seokipo/H2_Control_Board/01_Hardware/Docs/PCB부품/DMC 100D.png

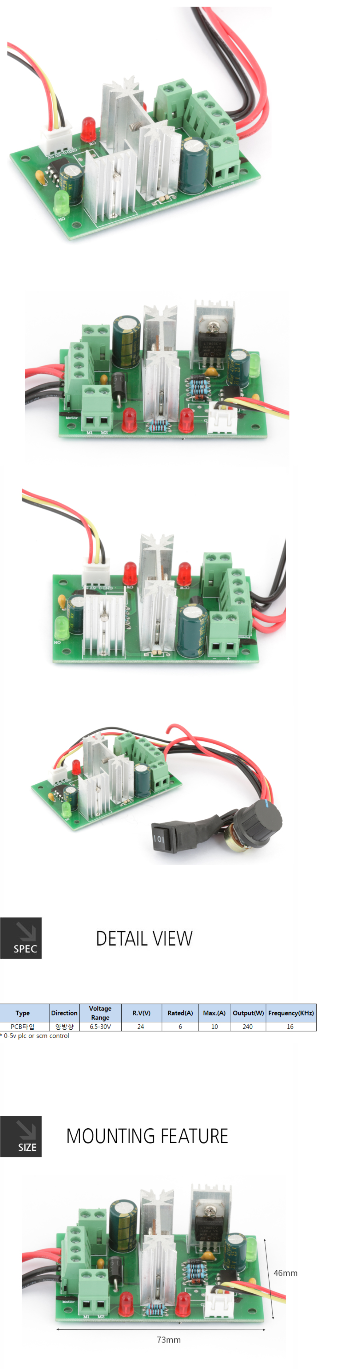
01_Hardware/Docs/PCB부품/DMC 100D.png
