seokipo/H2_Control_Board/01_Hardware/Docs/PCB부품/HDW012H.png

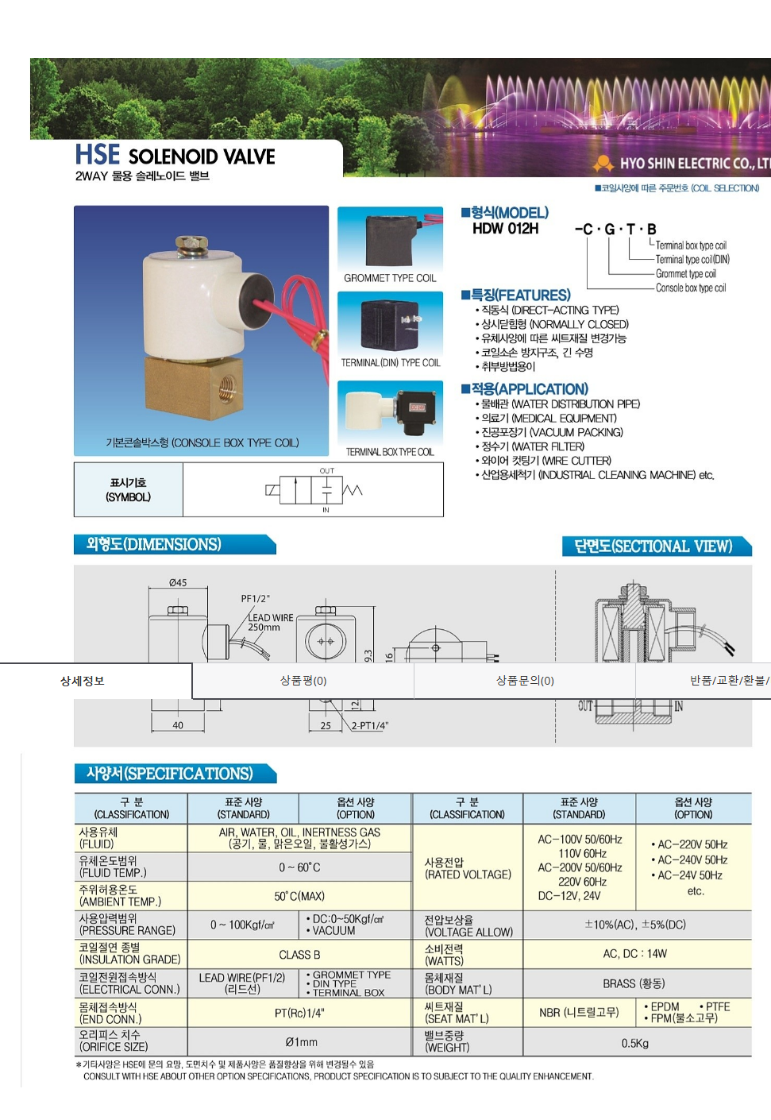
01_Hardware/Docs/PCB부품/HDW012H.png
