seokipo/H2_Control_Board/graphify-out/converted/260727_10kW IO 넘버링 Ver 1.1 이규원_ 모델명 포함(수정)_9afe6031.md

<!-- converted from 260727_10kW IO 넘버링 Ver 1.1 이규원_ 모델명 포함(수정).xlsx -->

## Sheet: 10k SYS IO_List_2026
| Num | IO type | IO Category | IO Name | IO Number | Proto device
IO Masking | 비고 | Described | Naming | 모델명 | 실제값 | 실제 
단위 | 제어값 | 제어
단위 |
| --- | --- | --- | --- | --- | --- | --- | --- | --- | --- | --- | --- | --- | --- |
| 1 | Serial | RS | INV | 506 | INV506 | 485 | 인버터 데이터 통신 |  |  |  |  |  |  |
| 2 | Serial | RS | LCD | 500 | LCD500 | 485 | HMI용 LCD 통신 |  |  |  |  |  |  |
| 3 | Serial | RS | FM | 382 | FM382 | 485 | DI 개질수 유량 데이터 통신 |  | 유량계 : OF05ZAT-AR / 펄스미터 : MP5Y |  |  |  |  |
| 4 | Serial | RS |  |  |  | 422 | HMI 및 GUI용 노트북 통신 |  |  |  |  |  |  |
| 1 | TC-K type | TC | TC | 181 | TC181 | K | Ref-BN |  | 열전대 K-Type |  |  |  |  |
| 2 | TC-K type | TC | TC | 182 | TC182 | K | Ref-SR1 |  |  |  |  |  |  |
| 3 | TC-K type | TC | TC | 183 | TC183 | K | Ref-SR2 |  |  |  |  |  |  |
| 4 | TC-K type | TC | TC | 184 | TC184 | K | Ref-SR3 |  |  |  |  |  |  |
| 5 | TC-K type | TC | TC | 185 | TC185 | K | Ref-LTS1 |  |  |  |  |  |  |
| 6 | TC-K type | TC | TC | 186 | TC186 | K | Ref-LTS2 |  |  |  |  |  |  |
| 7 | TC-K type | TC | TC | 187 | TC187 | K | Ref-FEED |  |  |  |  |  |  |
| 8 | TC-K type | TC | TC | 188 | TC188 | K | Ref-RG |  |  |  |  |  |  |
| 9 | TC-K type | TC | TC | 189 | TC189 | K | Ref-EG |  |  |  |  |  |  |
| 10 | TC-K type | TC | TC | 190 | TC190 | K | Prox-01 |  |  |  |  |  |  |
| 11 | TC-K type | TC | TC | 191 | TC191 | K | Prox-02 |  |  |  |  |  |  |
| 12 | TC-K type | TC | TC | 192 | TC192 | K | Prox-03 |  |  |  |  |  |  |
| 13 | TC-K type |  |  |  |  |  | 여유분 3 POINT |  |  |  |  |  |  |
| 14 | TC-K type |  |  |  |  |  |  |  |  |  |  |  |  |
| 15 | TC-K type |  |  |  |  |  |  |  |  |  |  |  |  |
| 1 | TC-T type | TC | TC | 104 | TC104 | T | 시티가스 공급온도 확인 |  | 열전대 T-Type |  |  |  |  |
| 2 | TC-T type | TC | TC | 115 | TC115 | T | 개질기 버너 역화 온도 측정 |  |  |  |  |  |  |
| 3 | TC-T type | TC | TC | 133 | TC133 | T | 개질 가스 1차 온도 측정 |  |  |  |  |  |  |
| 4 | TC-T type | TC | TC | 147 | TC147 | T | 개질 가스 2차 온도 측정(ANODE 인입 가스) |  |  |  |  |  |  |
| 5 | TC-T type | TC | TC | 157 | TC157 | T | AOG 버너 입구 온도측정 |  |  |  |  |  |  |
| 6 | TC-T type | TC | TC | 162 | TC162 | T | 배기가스 온도 측정 |  |  |  |  |  |  |
| 7 | TC-T type | TC | TC | 214 | TC214 | T | Cathode 입구 온도 |  |  |  |  |  |  |
| 8 | TC-T type | TC | TC | 215 | TC215 | T | Cathode 출구 온도 |  |  |  |  |  |  |
| 9 | TC-T type | TC | TC | 312 | TC312 | T | HOT Water Tank 온도 측정 |  |  |  |  |  |  |
| 10 | TC-T type | TC | TC | 316 | TC316 | T | 시스템 냉각수 회수 온도 |  |  |  |  |  |  |
| 11 | TC-T type | TC | TC | 322 | TC322 | T | DI Water TANK 온도 센서 |  |  |  |  |  |  |
| 12 | TC-T type | TC | TC | 343 | TC343 | T | DI WATER TANK 냉각수 입구 온도 측정 |  |  |  |  |  |  |
| 13 | TC-T type | TC | TC | 344 | TC344 | T | DI WATER TANK 냉각수 회수 온도 측정 |  |  |  |  |  |  |
| 14 | TC-T type | TC | TC | 353 | TC353 | T | ANODE(RG) 냉각수 회수 온도 측정 |  |  |  |  |  |  |
| 15 | TC-T type | TC | TC | 372 | TC372 | T | STACK 1 냉각수 회수 온도 |  |  |  |  |  |  |
| 16 | TC-T type | TC | TC | 377 | TC377 | T | STACK 2 냉각수 회수 온도 |  |  |  |  |  |  |
| 17 | TC-T type | TC | TC | 392 | TC392 | T | 배열 회수 입구 온도 |  |  |  |  |  |  |
| 18 | TC-T type | TC | TC | 393 | TC393 | T | 배열 회수  출구 온도 |  |  |  |  |  |  |
| 19 | TC-T type | TC | TC | 507 | TC507 | T | 시스템 내부온도 |  |  |  |  |  |  |
| 20 | TC-T type |  |  |  |  |  | 여유분 6 POINT |  |  |  |  |  |  |
| 21 | TC-T type |  |  |  |  |  |  |  |  |  |  |  |  |
| 22 | TC-T type |  |  |  |  |  |  |  |  |  |  |  |  |
| 23 | TC-T type |  |  |  |  |  |  |  |  |  |  |  |  |
| 24 | TC-T type |  |  |  |  |  |  |  |  |  |  |  |  |
| 25 | TC-T type |  |  |  |  |  |  |  |  |  |  |  |  |
| 1 | Voltage | AI | PT | 105 | PT105 |  | 유틸리티 압력 확인용 |  | T2800 | 0~10 | kPa | 4~20->1~5  | V |
| 2 | Voltage | AI | PT | 109 | PT109 |  | 가스 버퍼탱크 압력 확인용 |  | PSS-01V-R1/8 | 0~100 | kPa | 1~5  | V |
| 3 | Voltage | AI | PT | 113 | PT113 |  | 개질기 버너 압력 확인용 |  | PSS-01V-R1/8 | 0~100 | kPa | 1~5  | V |
| 4 | Voltage | AI | PT | 123 | PT123 |  | 개질기 촉매부 압력 확인 |  | PSS-01V-R1/8 | 0~100 | kPa | 1~5  | V |
| 5 | Voltage | AI | PT | 146 | PT146 |  | STACK Anode 입구 압력 측정 |  | T2800 | 0~100 | kPa | 4~20->1~5  | V |
| 6 | Voltage | AI | PT | 162 | PT162 |  | 배기가스 압력 측정 |  | PSS-01V-R1/8 | 0~100 | kPa | 1~5  | V |
| 7 | Voltage | AI | PT | 383 | PT383 |  | 개질수 공급 압력 측정 |  | PSAN-L1CPV | 0~1000 kPa | kPa | 1~5  | V |
| 8 | Voltage | AI | CS | 324 | CS324 |  | DI TANK 전도도 측정 |  | CM-230K | 0.5~200 | us/s | 4~20->1~5  | V |
| 9 | Voltage | AI/AO | MFC | 111 | MFC111 |  | BNG 유량 측정/제어 |  | TSCD230-8SW-CH4 30L | 0~30 | LPM |  |  |
| 10 | Voltage | AI/AO | MFC | 121 | MFC121 |  | PNG 유량 측정/제어 |  | TSCD230-8SW-CH4 50L | 0~50 | LPM |  |  |
| 11 | Voltage | AI | MFM | 211 | MFM211 |  | STACK 공기 유량계 |  | PFMB7202-06-C | 0~800 | LPM | 1~5  | V |
| 12 | Voltage | AI | MFM | 222 | MFM222 |  | 개질기 버너 공기 유량계 |  | PFMB7202-06-C | 0~400 | LPM | 1~5  | V |
| 13 | Voltage | AI | MFM | 231 | MFM231 |  | PrOx 공기 유량계 |  | PFM710-01-C | 0~10 | LPM | 1~5  | V |
| 14 | Voltage | AI | FM | 315 | FM315 |  | 시스템 냉각수 회수 유량 측정 |  | VVX 15 | 0-40 | LPM | 4~20->1~5 | V |
| 15 |  |  |  |  |  |  | 여유분 2 Point |  |  |  |  |  |  |
| 16 |  |  |  |  |  |  |  |  |  |  |  |  |  |
| 1 | Voltage | AO | AB | 212 | AB212 | feedback => MFM211 | STACK  에어블로어 |  | BLP-8080 |  |  | 0~5  | V |
| 2 | Voltage | AO | AB | 221 | AB221 | feedback => MFM222 | 개질기 버너 에어블로어 |  | LW 300 A3(AC 리니어 펌프) |  |  | 0~5  | V |
| 3 | Voltage | AO | AB | 232 | AB232 | feedback => MFM231 | PrOx 에어블로우 |  | NMP850.1.2KPDCB-4 HP |  |  | 0~5  | V |
| 4 | Voltage | AO | P | 108 | P108 | feedback => PT109 | 가스 가압펌프 |  | PM33098-838.1.2 (2대 병렬 운전) |  |  | 0~5  | V |
| 5 | Voltage | AO | P | 341 | P341 | feedback => TC343 또는 TC344(미정) | AOG 냉각용 물펌프 |  | INTG3-140 |  |  | 0~5  | V |
| 6 | Voltage | AO | P | 351 | P351 | feedback => TC 147 | Anode (RG) 냉각용 물펌프 |  | INTG3-140 |  |  | 0~5  | V |
| 7 | Voltage | AO | P | 370 | P370 | feedback => TC372 | STACK 1 냉각수 공급 |  | INTG3-140 |  |  | 0~5  | V |
| 8 | Voltage | AO | P | 375 | P375 | feedback => TC377 | STACK 2 냉각수 공급 |  | INTG3-140 |  |  | 0~5  | V |
| 9 | Voltage | AO | P | 380 | P380 | feedback => FM382 | 개질수 펌프 |  | KNF (PML20017-FP1.25) |  |  | 0~5 | V |
| 12 |  |  |  |  |  |  | 여유분 2 Point |  |  |  |  |  |  |
| 13 |  |  |  |  |  |  |  |  |  |  |  |  |  |
| 1 | Voltage | DI | FD | 176 | FD176 |  | 버너 화염감지기 |  | FDU-520 |  |  | 0 or 24 | V |
| 2 | Voltage | DI | GD | 501 | GD501 |  | 메탄 누출 감지 |  |  |  |  | 0 or 24 | V |
| 3 | Voltage | DI | GD | 502 | GD502 |  | 수소 누출 감지 |  |  |  |  | 0 or 24 | V |
| 4 | Voltage | DI | FAN | 504 | FAN504 |  | 가스 환기팬1 |  | D12BH-24 |  |  | 0 or 24 | V |
| 5 | Voltage | DI | TJ- | sig | TJ-sig | 테스트용(?) | 내구성 평가용 지그 신호 (별도 구성) |  |  |  |  | 0 or 24 | V |
| 6 |  |  |  |  |  |  | 여유분 2 Point |  |  |  |  |  |  |
| 7 |  |  |  |  |  |  |  |  |  |  |  |  |  |
| 1 | Voltage | DO | SV | 102 | SV102 |  | 가스 인입 솔레노이드 밸브 1 |  | VX230GA |  |  | 0 or 24 | V |
| 2 | Voltage | DO | SV | 103 | SV103 |  | 가스 인입 솔레노이드 밸브 2 |  | VX230GA |  |  | 0 or 24 | V |
| 3 | Voltage | DO | SV | 125 | SV125 |  | 개질기 질소퍼지 솔레노이드 밸브 |  | VX230GA |  |  | 0 or 24 | V |
| 4 | Voltage | DO | SV | 145 | SV145 |  | ANODE 인입 솔레노이드 밸브 |  | VX230GA |  |  | 0 or 24 | V |
| 5 | Voltage | DO | SV | 149 | SV149 |  | 스택 질소퍼지 솔레노이드 밸브 |  | VX230GA |  |  | 0 or 24 | V |
| 6 | Voltage | DO | SV | 323 | SV323 |  | DI Water TANK 드레인 솔레노이드 밸브 |  | WV121S122QV-H-WS-C2 |  |  | 0 or 24 | V |
| 7 | Voltage | DO | MV | 124 | MV124 |  | PNG 인입 밸브 |  | AT24-3T |  |  | 0 or 24 | V |
| 8 | Voltage | DO | MV | 131 | MV131 |  | 개질 가스 인입 밸브 |  | AT24-3T |  |  | 0 or 24 | V |
| 9 | Voltage | DO | MV | 148 | MV148 |  | 개질가스 Bypass 전동 밸브 |  | AT24-3T |  |  | 0 or 24 | V |
| 10 | Voltage | DO | MV | 150 | MV150 |  | Anode 출구 전동 밸브 |  | AT24-3T |  |  | 0 or 24 | V |
| 11 | Voltage | DO | MV | 155 | MV155 |  | AOG 전동 밸브 |  | AT24-3T |  |  | 0 or 24 | V |
| 12 | Voltage | DO | MV | 158 | MV158 |  | AOG VENT 전동 밸브 |  | AT24-3T |  |  | 0 or 24 | V |
| 13 | Voltage | DO | MV | 300 | MV300 |  | 시설수 입구 전동 볼밸브 |  | AT24-3T |  |  | 0 or 24 | V |
| 15 | Voltage | DO | MV | 390 | MV390 |  | 배열 회수 입구 전동 볼 밸브 |  | AT24-3T |  |  | 0 or 24 | V |
| 16 |  |  |  |  |  |  | 여유분 2 Point |  |  |  |  |  |  |
| 17 |  |  |  |  |  |  |  |  |  |  |  |  |  |
| 1 | Voltage | DO | MC |  SW | MC SW |  | MC 동작 스위치 |  |  |  |  | 0 or 220 | VAC |
| 2 | Voltage | DO | HT | 193 | HT193 | 700W | LTS 촉매 히터 |  |  |  |  | 0 or 220 | VAC |
| 3 | Voltage | DO | HT | 194 | HT194 | 700W | LTS 촉매 히터 |  |  |  |  | 0 or 220 | VAC |
| 4 | Voltage | DO | HT | 195 | HT195 | 200W | Prox 히터1 |  |  |  |  | 0 or 220 | VAC |
| 5 | Voltage | DO | HT | 196 | HT196 | 200W | Prox 히터2 |  |  |  |  | 0 or 220 | VAC |
| 6 | Voltage | DO | IGN | 175 | IGN175 |  | 점화 트랜스 |  | TZI5-15/100WE |  |  | 0 or 220 | VAC |
| 7 | Voltage | DO |  |  |  |  | Spare, Spare TRIAC(위상제어용) |  |  |  |  | 0 or 220 | VAC |
| 8 | Voltage | DO |  |  |  |  |  |  |  |  |  | 0 or 220 | VAC |
## Sheet: 10k SYS IO_NetName
| Num | IO type | IO Category | IO Name | IO Number | Proto device
IO Masking | 비고 | Described | IO NAME | NETNAME | MCU PIN No. | 모델명 | 실제값 | 실제 
단위 | 제어값 | 제어
단위 |
| --- | --- | --- | --- | --- | --- | --- | --- | --- | --- | --- | --- | --- | --- | --- | --- |
| 1 | Serial | RS | INV | 506 | INV506 | 485 | 인버터 데이터 통신 |  |  | 485 |  |  |  |  |  |
| 2 | Serial | RS | LCD | 500 | LCD500 | 485 | HMI용 LCD 통신 |  |  | 485 |  |  |  |  |  |
| 3 | Serial | RS | FM | 382 | FM382 | 485 | DI 개질수 유량 데이터 통신 |  |  | 485 | 유량계 : OF05ZAT-AR / 펄스미터 : MP5Y |  |  |  |  |
| 4 | Serial | RS |  |  |  | 422 | HMI 및 GUI용 노트북 통신 |  |  | 422 |  |  |  |  |  |
| 1 | TC-K type | TC | TC | 181 | TC181 | K | Ref-BN |  | CH21 |  | 열전대 K-Type |  |  |  |  |
| 2 | TC-K type | TC | TC | 182 | TC182 | K | Ref-SR1 |  | CH22 |  |  |  |  |  |  |
| 3 | TC-K type | TC | TC | 183 | TC183 | K | Ref-SR2 |  | CH23 |  |  |  |  |  |  |
| 4 | TC-K type | TC | TC | 184 | TC184 | K | Ref-SR3 |  | CH24 |  |  |  |  |  |  |
| 5 | TC-K type | TC | TC | 185 | TC185 | K | Ref-LTS1 |  | CH25 |  |  |  |  |  |  |
| 6 | TC-K type | TC | TC | 186 | TC186 | K | Ref-LTS2 |  | CH26 |  |  |  |  |  |  |
| 7 | TC-K type | TC | TC | 187 | TC187 | K | Ref-FEED |  | CH27 |  |  |  |  |  |  |
| 8 | TC-K type | TC | TC | 188 | TC188 | K | Ref-RG |  | CH28 |  |  |  |  |  |  |
| 9 | TC-K type | TC | TC | 189 | TC189 | K | Ref-EG |  | CH29 |  |  |  |  |  |  |
| 10 | TC-K type | TC | TC | 190 | TC190 | K | Prox-01 |  | CH30 |  |  |  |  |  |  |
| 11 | TC-K type | TC | TC | 191 | TC191 | K | Prox-02 |  | CH31 |  |  |  |  |  |  |
| 12 | TC-K type | TC | TC | 192 | TC192 | K | Prox-03 |  | CH32 |  |  |  |  |  |  |
| 13 | TC-K type |  |  |  |  |  | 여유분 3 POINT |  |  |  |  |  |  |  |  |
| 14 | TC-K type |  |  |  |  |  |  |  |  |  |  |  |  |  |  |
| 15 | TC-K type |  |  |  |  |  |  |  |  |  |  |  |  |  |  |
| 1 | TC-T type | TC | TC | 104 | TC104 | T | 시티가스 공급온도 확인 |  | CH1 |  | 열전대 T-Type |  |  |  |  |
| 2 | TC-T type | TC | TC | 115 | TC115 | T | 개질기 버너 역화 온도 측정 |  | CH2 |  |  |  |  |  |  |
| 3 | TC-T type | TC | TC | 133 | TC133 | T | 개질 가스 1차 온도 측정 |  | CH3 |  |  |  |  |  |  |
| 4 | TC-T type | TC | TC | 147 | TC147 | T | 개질 가스 2차 온도 측정(ANODE 인입 가스) |  | CH4 |  |  |  |  |  |  |
| 5 | TC-T type | TC | TC | 157 | TC157 | T | AOG 버너 입구 온도측정 |  | CH5 |  |  |  |  |  |  |
| 6 | TC-T type | TC | TC | 162 | TC162 | T | 배기가스 온도 측정 |  | CH6 |  |  |  |  |  |  |
| 7 | TC-T type | TC | TC | 214 | TC214 | T | Cathode 입구 온도 |  | CH7 |  |  |  |  |  |  |
| 8 | TC-T type | TC | TC | 215 | TC215 | T | Cathode 출구 온도 |  | CH8 |  |  |  |  |  |  |
| 9 | TC-T type | TC | TC | 312 | TC312 | T | HOT Water Tank 온도 측정 |  | CH9 |  |  |  |  |  |  |
| 10 | TC-T type | TC | TC | 316 | TC316 | T | 시스템 냉각수 회수 온도 |  | CH10 |  |  |  |  |  |  |
| 11 | TC-T type | TC | TC | 322 | TC322 | T | DI Water TANK 온도 센서 |  | CH11 |  |  |  |  |  |  |
| 12 | TC-T type | TC | TC | 343 | TC343 | T | DI WATER TANK 냉각수 입구 온도 측정 |  | CH12 |  |  |  |  |  |  |
| 13 | TC-T type | TC | TC | 344 | TC344 | T | DI WATER TANK 냉각수 회수 온도 측정 |  | CH13 |  |  |  |  |  |  |
| 14 | TC-T type | TC | TC | 353 | TC353 | T | ANODE(RG) 냉각수 회수 온도 측정 |  | CH14 |  |  |  |  |  |  |
| 15 | TC-T type | TC | TC | 372 | TC372 | T | STACK 1 냉각수 회수 온도 |  | CH15 |  |  |  |  |  |  |
| 16 | TC-T type | TC | TC | 377 | TC377 | T | STACK 2 냉각수 회수 온도 |  | CH16 |  |  |  |  |  |  |
| 17 | TC-T type | TC | TC | 392 | TC392 | T | 배열 회수 입구 온도 |  | CH17 |  |  |  |  |  |  |
| 18 | TC-T type | TC | TC | 393 | TC393 | T | 배열 회수  출구 온도 |  | CH18 |  |  |  |  |  |  |
| 19 | TC-T type | TC | TC | 507 | TC507 | T | 시스템 내부온도 |  | CH19 |  |  |  |  |  |  |
| 20 | TC-T type |  |  |  |  |  | 여유분 6 POINT |  |  |  |  |  |  |  |  |
| 21 | TC-T type |  |  |  |  |  |  |  |  |  |  |  |  |  |  |
| 22 | TC-T type |  |  |  |  |  |  |  |  |  |  |  |  |  |  |
| 23 | TC-T type |  |  |  |  |  |  |  |  |  |  |  |  |  |  |
| 24 | TC-T type |  |  |  |  |  |  |  |  |  |  |  |  |  |  |
| 25 | TC-T type |  |  |  |  |  |  |  |  |  |  |  |  |  |  |
| 1 | Voltage | AI | PT | 105 | PT105 |  | 유틸리티 압력 확인용 | AI_1 | AI_PT105 |  | T2800 | 0~10 | kPa | 4~20->1~5  | V |
| 2 | Voltage | AI | PT | 109 | PT109 |  | 가스 버퍼탱크 압력 확인용 | AI_6 | AI_PT109 |  | PSS-01V-R1/8 | 0~100 | kPa | 1~5  | V |
| 3 | Voltage | AI | PT | 113 | PT113 |  | 개질기 버너 압력 확인용 | AI_7 | AI_PT113 |  | PSS-01V-R1/8 | 0~100 | kPa | 1~5  | V |
| 4 | Voltage | AI | PT | 123 | PT123 |  | 개질기 촉매부 압력 확인 | AI_8 | AI_PT123 |  | PSS-01V-R1/8 | 0~100 | kPa | 1~5  | V |
| 5 | Voltage | AI | PT | 146 | PT146 |  | STACK Anode 입구 압력 측정 | AI_2 | AI_PT146 |  | T2800 | 0~100 | kPa | 4~20->1~5  | V |
| 6 | Voltage | AI | PT | 162 | PT162 |  | 배기가스 압력 측정 | AI_3 | AI_PT162 |  | PSS-01V-R1/8 | 0~100 | kPa | 1~5  | V |
| 7 | Voltage | AI | PT | 383 | PT383 |  | 개질수 공급 압력 측정 | AI_4 | AI_PT383 |  | PSAN-L1CPV | 0~1000 kPa | kPa | 1~5  | V |
| 8 | Voltage | AI | CS | 324 | CS324 |  | DI TANK 전도도 측정 | AI_5 | AI_CS324 |  | CM-230K | 0.5~200 | us/s | 4~20->1~5  | V |
| 9 | Voltage | AI/AO | MFC | 111 | MFC111 |  | BNG 유량 측정/제어 | MFC_BNG | AI_MFC111 |  | TSCD230-8SW-CH4 30L | 0~30 | LPM |  |  |
| 10 | Voltage | AI/AO | MFC | 121 | MFC121 |  | PNG 유량 측정/제어 | MFC_PNG | AI_MFC121 |  | TSCD230-8SW-CH4 50L | 0~50 | LPM |  |  |
| 11 | Voltage | AI | MFM | 211 | MFM211 |  | STACK 공기 유량계 | AI_9 | AI_MFM211 |  | PFMB7202-06-C | 0~800 | LPM | 1~5  | V |
| 12 | Voltage | AI | MFM | 222 | MFM222 |  | 개질기 버너 공기 유량계 | AI_10 | AI_MFM222 |  | PFMB7202-06-C | 0~400 | LPM | 1~5  | V |
| 13 | Voltage | AI | MFM | 231 | MFM231 |  | PrOx 공기 유량계 | AI_11 | AI_MFM231 |  | PFM710-01-C | 0~10 | LPM | 1~5  | V |
| 14 | Voltage | AI | FM | 315 | FM315 |  | 시스템 냉각수 회수 유량 측정 | AI_12 | AI_MFM315 |  | VVX 15 | 0-40 | LPM | 4~20->1~5 | V |
| 15 |  |  |  |  |  |  | 여유분 2 Point |  |  |  |  |  |  |  |  |
| 16 |  |  |  |  |  |  |  |  |  |  |  |  |  |  |  |
| 1 | Voltage | AO | AB | 212 | AB212 | feedback => MFM211 | STACK  에어블로어 | AO_1 | AO_AB212 |  | BLP-8080 |  |  | 0~5  | V |
| 2 | Voltage | AO | AB | 221 | AB221 | feedback => MFM222 | 개질기 버너 에어블로어 | AO_9 | AO_AB221 |  | LW 300 A3(AC 리니어 펌프) |  |  | 0~5  | V |
| 3 | Voltage | AO | AB | 232 | AB232 | feedback => MFM231 | PrOx 에어블로우 | AO_4 | AO_AB232 |  | NMP850.1.2KPDCB-4 HP |  |  | 0~5  | V |
| 4 | Voltage | AO | P | 108 | P108 | feedback => PT109 | 가스 가압펌프 | AO_2 | AO_P108 |  | PM33098-838.1.2 (2대 병렬 운전) |  |  | 0~5  | V |
| 5 | Voltage | AO | P | 341 | P341 | feedback => TC343 또는 TC344(미정) | AOG 냉각용 물펌프 | AO_6 | AO_P341 |  | INTG3-140 |  |  | 0~5  | V |
| 6 | Voltage | AO | P | 351 | P351 | feedback => TC 147 | Anode (RG) 냉각용 물펌프 | AO_10 | AO_P351 |  | INTG3-140 |  |  | 0~5  | V |
| 7 | Voltage | AO | P | 370 | P370 | feedback => TC372 | STACK 1 냉각수 공급 | AO_8 | AO_P370 |  | INTG3-140 |  |  | 0~5  | V |
| 8 | Voltage | AO | P | 375 | P375 | feedback => TC377 | STACK 2 냉각수 공급 | AO_5 | AO_P375 |  | INTG3-140 |  |  | 0~5  | V |
| 9 | Voltage | AO | P | 380 | P380 | feedback => FM382 | 개질수 펌프 | AO_3 | AO_P380 |  | KNF (PML20017-FP1.25) |  |  | 0~5 | V |
| 12 |  |  |  |  |  |  | 여유분 2 Point |  |  |  |  |  |  |  |  |
| 13 |  |  |  |  |  |  |  |  |  |  |  |  |  |  |  |
| 1 | Voltage | DI | FD | 176 | FD176 |  | 버너 화염감지기 |  | DI_FD176 | 89 | FDU-520 |  |  | 0 or 24 | V |
| 2 | Voltage | DI | GD | 501 | GD501 |  | 메탄 누출 감지 |  | DI_GD501 | 59 |  |  |  | 0 or 24 | V |
| 3 | Voltage | DI | GD | 502 | GD502 |  | 수소 누출 감지 |  | DI_GD502 | 60 |  |  |  | 0 or 24 | V |
| 4 | Voltage | DI | FAN | 504 | FAN504 |  | 가스 환기팬1 |  | DI_FAN504 | 24 | D12BH-24 |  |  | 0 or 24 | V |
| 5 | Voltage | DI | TJ- | sig | TJ-sig | 테스트용(?) | 내구성 평가용 지그 신호 (별도 구성) |  | DI_TJ_SIG | 44 |  |  |  | 0 or 24 | V |
| 6 |  |  |  |  |  |  | 여유분 2 Point |  |  |  |  |  |  |  |  |
| 7 |  |  |  |  |  |  |  |  |  |  |  |  |  |  |  |
| 1 | Voltage | DO | SV | 102 | SV102 |  | 가스 인입 솔레노이드 밸브 1 | DO_6 | DO_SV102 | 18 | VX230GA |  |  | 0 or 24 | V |
| 2 | Voltage | DO | SV | 103 | SV103 |  | 가스 인입 솔레노이드 밸브 2 | DO_5 | DO_SV103 | 19 | VX230GA |  |  | 0 or 24 | V |
| 3 | Voltage | DO | SV | 125 | SV125 |  | 개질기 질소퍼지 솔레노이드 밸브 | DO_2 | DO_SV125 | 22 | VX230GA |  |  | 0 or 24 | V |
| 4 | Voltage | DO | SV | 145 | SV145 |  | ANODE 인입 솔레노이드 밸브 | DO_4 | DO_SV145 | 20 | VX230GA |  |  | 0 or 24 | V |
| 5 | Voltage | DO | SV | 149 | SV149 |  | 스택 질소퍼지 솔레노이드 밸브 | DO_1 | DO_SV149 | 23 | VX230GA |  |  | 0 or 24 | V |
| 6 | Voltage | DO | SV | 323 | SV323 |  | DI Water TANK 드레인 솔레노이드 밸브 | DO_3 | DO_SV323 | 21 | WV121S122QV-H-WS-C2 |  |  | 0 or 24 | V |
| 7 | Voltage | DO | MV | 124 | MV124 |  | PNG 인입 밸브 | DO_14 | DO_MV124 | 94 | AT24-3T |  |  | 0 or 24 | V |
| 8 | Voltage | DO | MV | 131 | MV131 |  | 개질 가스 인입 밸브 | DO_15 | DO_MV131 | 91 | AT24-3T |  |  | 0 or 24 | V |
| 9 | Voltage | DO | MV | 148 | MV148 |  | 개질가스 Bypass 전동 밸브 | DO_11 | DO_MV148 | 97 | AT24-3T |  |  | 0 or 24 | V |
| 10 | Voltage | DO | MV | 150 | MV150 |  | Anode 출구 전동 밸브 | DO_12 | DO_MV150 | 96 | AT24-3T |  |  | 0 or 24 | V |
| 11 | Voltage | DO | MV | 155 | MV155 |  | AOG 전동 밸브 | DO_8 | DO_MV155 | 16 | AT24-3T |  |  | 0 or 24 | V |
| 12 | Voltage | DO | MV | 158 | MV158 |  | AOG VENT 전동 밸브 | DO_13 | DO_MV158 | 95 | AT24-3T |  |  | 0 or 24 | V |
| 13 | Voltage | DO | MV | 300 | MV300 |  | 시설수 입구 전동 볼밸브 | DO_9 | DO_MV300 | 15 | AT24-3T |  |  | 0 or 24 | V |
| 15 | Voltage | DO | MV | 390 | MV390 |  | 배열 회수 입구 전동 볼 밸브 | DO_10 | DO_MV390 | 98 | AT24-3T |  |  | 0 or 24 | V |
| 16 |  |  |  |  |  |  | 여유분 2 Point |  |  |  |  |  |  |  |  |
| 17 |  |  |  |  |  |  |  |  |  |  |  |  |  |  |  |
| 1 | Voltage | DO | MC |  SW | MC SW |  | MC 동작 스위치 | 전원마그네트 | DO_MC_SW | 76 |  |  |  | 0 or 220 | VAC |
| 2 | Voltage | DO | HT | 193 | HT193 | 700W | LTS 촉매 히터 | LTS상단히터 | DO_HT193 | 77 |  |  |  | 0 or 220 | VAC |
| 3 | Voltage | DO | HT | 194 | HT194 | 700W | LTS 촉매 히터 | LTS하단히터 | DO_HT194 | 79 |  |  |  | 0 or 220 | VAC |
| 4 | Voltage | DO | HT | 195 | HT195 | 200W | Prox 히터1 | Prox 상단히터 | DO_HT195 | 81 |  |  |  | 0 or 220 | VAC |
| 5 | Voltage | DO | HT | 196 | HT196 | 200W | Prox 히터2 | Prox 하단히터 | DO_HT196 | 83 |  |  |  | 0 or 220 | VAC |
| 6 | Voltage | DO | IGN | 175 | IGN175 |  | 점화 트랜스 | 점화트랜스 | DO_IGN175 | 73 | TZI5-15/100WE |  |  | 0 or 220 | VAC |
| 7 | Voltage | DO |  |  |  |  | Spare, Spare TRIAC(위상제어용) |  |  |  |  |  |  | 0 or 220 | VAC |
| 8 | Voltage | DO |  |  |  |  |  |  |  |  |  |  |  | 0 or 220 | VAC |
## Sheet: 프로그렘 초안
|  |  |  |  | 온도 측정 |  |  |  | 아날로그 입력 |  |  |  |  | 아날로그 출력 |  |  |  |
| --- | --- | --- | --- | --- | --- | --- | --- | --- | --- | --- | --- | --- | --- | --- | --- | --- |
|  |  |  | TYPE | 측정장소 | 체널 번호 | 게측온도 |  | 측정 위치 | NETNAME | 아날로그 입력값 | 환산값 (압력/유량) |  | 제어 위치 | NETNAME | 아날로그 출력값 | 환산값 (압력/유량) |
|  |  |  | T | 시티가스 공급온도 확인 | CH1 |  |  | 유틸리티 압력 확인용 | AI_PT105 |  |  |  | STACK  에어블로어 | AO_AB212 |  |  |
|  |  |  | T | 개질기 버너 역화 온도 측정 | CH2 |  |  | 가스 버퍼탱크 압력 확인용 | AI_PT109 |  |  |  | 개질기 버너 에어블로어 | AO_AB221 |  |  |
|  |  |  | T | 개질 가스 1차 온도 측정 | CH3 |  |  | 개질기 버너 압력 확인용 | AI_PT113 |  |  |  | PrOx 에어블로우 | AO_AB232 |  |  |
|  |  |  | T | 개질 가스 2차 온도 측정(ANODE 인입 가스) | CH4 |  |  | 개질기 촉매부 압력 확인 | AI_PT123 |  |  |  | 가스 가압펌프 | AO_P108 |  |  |
|  |  |  | T | AOG 버너 입구 온도측정 | CH5 |  |  | STACK Anode 입구 압력 측정 | AI_PT146 |  |  |  | AOG 냉각용 물펌프 | AO_P341 |  |  |
|  |  |  | T | 배기가스 온도 측정 | CH6 |  |  | 배기가스 압력 측정 | AI_PT162 |  |  |  | Anode (RG) 냉각용 물펌프 | AO_P351 |  |  |
|  |  |  | T | Cathode 입구 온도 | CH7 |  |  | 개질수 공급 압력 측정 | AI_PT383 |  |  |  | STACK 1 냉각수 공급 | AO_P370 |  |  |
|  |  |  | T | Cathode 출구 온도 | CH8 |  |  | DI TANK 전도도 측정 | AI_CS324 |  |  |  | STACK 2 냉각수 공급 | AO_P375 |  |  |
|  |  |  | T | HOT Water Tank 온도 측정 | CH9 |  |  | BNG 유량 측정/제어 | AI_MFC111 |  |  |  | 개질수 펌프 | AO_P380 |  |  |
|  |  |  | T | 시스템 냉각수 회수 온도 | CH10 |  |  | PNG 유량 측정/제어 | AI_MFC121 |  |  |  |  |  |  |  |
|  |  |  | T | DI Water TANK 온도 센서 | CH11 |  |  | STACK 공기 유량계 | AI_MFM211 |  |  |  | 디지털 출력 |  |  |  |
|  |  |  | T | DI WATER TANK 냉각수 입구 온도 측정 | CH12 |  |  | 개질기 버너 공기 유량계 | AI_MFM222 |  |  |  | 제어 위치 | NETNAME | 값(low/High) | 상태 |
|  |  |  | T | DI WATER TANK 냉각수 회수 온도 측정 | CH13 |  |  | PrOx 공기 유량계 | AI_MFM231 |  |  |  | 가스 인입 솔레노이드 밸브 1 | DO_SV102 |  |  |
|  |  |  | T | ANODE(RG) 냉각수 회수 온도 측정 | CH14 |  |  | 시스템 냉각수 회수 유량 측정 | AI_MFM315 |  |  |  | 가스 인입 솔레노이드 밸브 2 | DO_SV103 |  |  |
|  |  |  | T | STACK 1 냉각수 회수 온도 | CH15 |  |  |  |  |  |  |  | 개질기 질소퍼지 솔레노이드 밸브 | DO_SV125 |  |  |
|  |  |  | T | STACK 2 냉각수 회수 온도 | CH16 |  |  |  |  |  |  |  | ANODE 인입 솔레노이드 밸브 | DO_SV145 |  |  |
|  |  |  | T | 배열 회수 입구 온도 | CH17 |  |  |  |  |  |  |  | 스택 질소퍼지 솔레노이드 밸브 | DO_SV149 |  |  |
|  |  |  | T | 배열 회수  출구 온도 | CH18 |  |  |  |  |  |  |  | DI Water TANK 드레인 솔레노이드 밸브 | DO_SV323 |  |  |
|  |  |  | T | 시스템 내부온도 | CH19 |  |  |  |  |  |  |  | PNG 인입 밸브 | DO_MV124 |  |  |
|  |  |  |  |  |  |  |  |  |  |  |  |  | 개질 가스 인입 밸브 | DO_MV131 |  |  |
|  |  |  |  |  |  |  |  | 디지털 입력 |  |  |  |  | 개질가스 Bypass 전동 밸브 | DO_MV148 |  |  |
|  |  |  | K | Ref-BN | CH21 |  |  | 측정 위치 | NETNAME | 값(low/High) | 상태 |  | Anode 출구 전동 밸브 | DO_MV150 |  |  |
|  |  |  | K | Ref-SR1 | CH22 |  |  | 버너 화염감지기 | DI_FD176 |  |  |  | AOG 전동 밸브 | DO_MV155 |  |  |
|  |  |  | K | Ref-SR2 | CH23 |  |  | 메탄 누출 감지 | DI_GD501 |  |  |  | AOG VENT 전동 밸브 | DO_MV158 |  |  |
|  |  |  | K | Ref-SR3 | CH24 |  |  | 수소 누출 감지 | DI_GD502 |  |  |  | 시설수 입구 전동 볼밸브 | DO_MV300 |  |  |
|  |  |  | K | Ref-LTS1 | CH25 |  |  | 가스 환기팬1 | DI_FAN504 |  |  |  | 배열 회수 입구 전동 볼 밸브 | DO_MV390 |  |  |
|  |  |  | K | Ref-LTS2 | CH26 |  |  | 내구성 평가용 지그 신호 (별도 구성) | DI_TJ_SIG |  |  |  |  |  |  |  |
|  |  |  | K | Ref-FEED | CH27 |  |  |  |  |  |  |  | 디지털 출력 |  |  |  |
|  |  |  | K | Ref-RG | CH28 |  |  |  |  |  |  |  | 제어 위치 | NETNAME | 값(low/High) | 상태 |
|  |  |  | K | Ref-EG | CH29 |  |  |  |  |  |  |  | MC 동작 스위치 | DO_MC_SW |  |  |
|  |  |  | K | Prox-01 | CH30 |  |  |  |  |  |  |  | LTS 촉매 히터 | DO_HT193 |  |  |
|  |  |  | K | Prox-02 | CH31 |  |  |  |  |  |  |  | LTS 촉매 히터 | DO_HT194 |  |  |
|  |  |  | K | Prox-03 | CH32 |  |  |  |  |  |  |  | Prox 히터1 | DO_HT195 |  |  |
|  |  |  |  | 여유분 3 POINT |  |  |  |  |  |  |  |  | Prox 히터2 | DO_HT196 |  |  |
|  |  |  |  |  |  |  |  |  |  |  |  |  | 점화 트랜스 | DO_IGN175 |  |  |
