seokipo/H2_Control_Board/graphify-out/converted/260727_6kW IO 넘버링 Ver 1.1_이규원_모델명포함(수정)_5c76234b.md

<!-- converted from 260727_6kW IO 넘버링 Ver 1.1_이규원_모델명포함(수정).xlsx -->

## Sheet: 10k SYS IO_List 230626 (2)
| Num | IO type | IO Category | IO Name | IO Number | Proto device
IO Masking | 비고 | Described | Naming | 모델명 | 실제값 | 실제 
단위 | 제어값 | 제어
단위 |
| --- | --- | --- | --- | --- | --- | --- | --- | --- | --- | --- | --- | --- | --- |
| 1 | Serial | RS | INV | 506 | INV506 | 485 | 인버터 데이터 통신 |  |  |  |  |  |  |
| 2 | Serial | RS | LCD | 500 | LCD500 | 485 | HMI용 LCD 통신 |  |  |  |  |  |  |
| 3 | Serial | RS | FM | 382 | FM382 | 485 | DI 개질수 유량 데이터 통신 |  | 유량계 : OF05ZAT-AR / 펄스미터 : MP5Y |  |  |  |  |
| 4 | Serial | RS |  |  |  | 422 | HMI 및 GUI용 노트북 통신 |  |  |  |  |  |  |
| 1 | TC-K type | TC | TC | 181 | TC181 | K | Ref-BN |  | 열전대 K-Type |  |  |  |  |
| 2 | TC-K type | TC | TC | 182 | TC182 | K | Ref-SR1 |  |  |  |  |  |  |
| 3 | TC-K type | TC | TC | 183 | TC183 | K | Ref-SR2 |  |  |  |  |  |  |
| 4 | TC-K type | TC | TC | 184 | TC184 | K | Ref-SR3 |  |  |  |  |  |  |
| 5 | TC-K type | TC | TC | 185 | TC185 | K | Ref-LTS1 |  |  |  |  |  |  |
| 6 | TC-K type | TC | TC | 186 | TC186 | K | Ref-LTS2 |  |  |  |  |  |  |
| 7 | TC-K type | TC | TC | 187 | TC187 | K | Ref-FEED |  |  |  |  |  |  |
| 8 | TC-K type | TC | TC | 188 | TC188 | K | Ref-RG |  |  |  |  |  |  |
| 9 | TC-K type | TC | TC | 189 | TC189 | K | Ref-EG |  |  |  |  |  |  |
| 10 | TC-K type | TC | TC | 190 | TC190 | K | Prox-01 |  |  |  |  |  |  |
| 11 | TC-K type | TC | TC | 191 | TC191 | K | Prox-02 |  |  |  |  |  |  |
| 12 | TC-K type | TC | TC | 192 | TC192 | K | Prox-03 |  |  |  |  |  |  |
| 13 | TC-K type |  |  |  |  |  | 여유분 3 POINT |  |  |  |  |  |  |
| 14 | TC-K type |  |  |  |  |  |  |  |  |  |  |  |  |
| 15 | TC-K type |  |  |  |  |  |  |  |  |  |  |  |  |
| 1 | TC-T type | TC | TC | 104 | TC104 | T | 시티가스 공급온도 확인 |  | 열전대 T-Type |  |  |  |  |
| 2 | TC-T type | TC | TC | 115 | TC115 | T | 개질기 버너 역화 온도 측정 |  |  |  |  |  |  |
| 3 | TC-T type | TC | TC | 133 | TC133 | T | 개질 가스 1차 온도 측정 |  |  |  |  |  |  |
| 4 | TC-T type | TC | TC | 147 | TC147 | T | 개질 가스 2차 온도 측정(ANODE 인입 가스) |  |  |  |  |  |  |
| 5 | TC-T type | TC | TC | 157 | TC157 | T | AOG 버너 입구 온도측정 |  |  |  |  |  |  |
| 6 | TC-T type | TC | TC | 162 | TC162 | T | 배기가스 온도 측정 |  |  |  |  |  |  |
| 7 | TC-T type | TC | TC | 214 | TC214 | T | Cathode 입구 온도 |  |  |  |  |  |  |
| 8 | TC-T type | TC | TC | 215 | TC215 | T | Cathode 출구 온도 |  |  |  |  |  |  |
| 9 | TC-T type | TC | TC | 312 | TC312 | T | HOT Water Tank 온도 측정 |  |  |  |  |  |  |
| 10 | TC-T type | TC | TC | 316 | TC316 | T | 시스템 냉각수 회수 온도 |  |  |  |  |  |  |
| 11 | TC-T type | TC | TC | 322 | TC322 | T | DI Water TANK 온도 센서 |  |  |  |  |  |  |
| 12 | TC-T type | TC | TC | 343 | TC343 | T | DI WATER TANK 냉각수 입구 온도 측정 |  |  |  |  |  |  |
| 13 | TC-T type | TC | TC | 344 | TC344 | T | DI WATER TANK 냉각수 회수 온도 측정 |  |  |  |  |  |  |
| 14 | TC-T type | TC | TC | 353 | TC353 | T | ANODE(RG) 냉각수 회수 온도 측정 |  |  |  |  |  |  |
| 15 | TC-T type | TC | TC | 372 | TC372 | T | STACK 1 냉각수 회수 온도 |  |  |  |  |  |  |
| 16 | TC-T type | TC | TC | 392 | TC392 | T | 배열 회수 입구 온도 |  |  |  |  |  |  |
| 17 | TC-T type | TC | TC | 393 | TC393 | T | 배열 회수  출구 온도 |  |  |  |  |  |  |
| 18 | TC-T type | TC | TC | 507 | TC507 | T | 시스템 내부온도 |  |  |  |  |  |  |
| 19 | TC-T type |  |  |  |  |  | 여유분 6 POINT |  |  |  |  |  |  |
| 20 | TC-T type |  |  |  |  |  |  |  |  |  |  |  |  |
| 21 | TC-T type |  |  |  |  |  |  |  |  |  |  |  |  |
| 22 | TC-T type |  |  |  |  |  |  |  |  |  |  |  |  |
| 23 | TC-T type |  |  |  |  |  |  |  |  |  |  |  |  |
| 24 | TC-T type |  |  |  |  |  |  |  |  |  |  |  |  |
| 1 | Voltage | AI | PT | 105 | PT105 |  | 유틸리티 압력 확인용 |  | T2800 | 0~10 | kPa | 4~20->1~5  | V |
| 2 | Voltage | AI | PT | 109 | PT109 |  | 가스 버퍼탱크 압력 확인용 |  | PSS-01V-R1/8 | 0~100 | kPa | 1~5  | V |
| 3 | Voltage | AI | PT | 113 | PT113 |  | 개질기 버너 압력 확인용 |  | PSS-01V-R1/8 | 0~100 | kPa | 1~5  | V |
| 4 | Voltage | AI | PT | 123 | PT123 |  | 개질기 촉매부 압력 확인 |  | PSS-01V-R1/8 | 0~100 | kPa | 1~5  | V |
| 5 | Voltage | AI | PT | 146 | PT146 |  | STACK Anode 입구 압력 측정 |  | T2800 | 0~100 | kPa | 4~20->1~5  | V |
| 6 | Voltage | AI | PT | 162 | PT162 |  | 배기가스 압력 측정 |  | PSS-01V-R1/8 | 0~100 | kPa | 1~5  | V |
| 7 | Voltage | AI | PT | 383 | PT383 |  | 개질수 공급 압력 측정 |  | PSAN-L1CPV | 0~1000 kPa | kPa | 1~5  | V |
| 8 | Voltage | AI | CS | 324 | CS324 |  | DI TANK 전도도 측정 |  | CM-230K | 0.5~200 | us/s | 4~20->1~5  | V |
| 9 | Voltage | AI/AO | MFC | 111 | MFC111 |  | BNG 유량 측정/제어 |  | TSCD230-8SW-CH4 30L | 0~30 | LPM |  |  |
| 10 | Voltage | AI/AO | MFC | 121 | MFC121 |  | PNG 유량 측정/제어 |  | TSCD230-8SW-CH4 30L | 0~30 | LPM |  |  |
| 11 | Voltage | AI | MFM | 211 | MFM211 |  | STACK 공기 유량계 |  | PFMB7202-06-C | 0~400 | LPM | 1~5  | V |
| 12 | Voltage | AI | MFM | 222 | MFM222 |  | 개질기 버너 공기 유량계 |  | PFMB7202-06-C | 0~400 | LPM | 1~5  | V |
| 13 | Voltage | AI | MFM | 231 | MFM231 |  | PrOx 공기 유량계 |  | PFM710-01-C | 0~10 | LPM | 1~5  | V |
| 14 | Voltage | AI | FM | 315 | FM315 |  | 시스템 냉각수 회수 유량 측정 |  | VVX 15 | 0-40 | LPM | 4~20->1~5 | V |
| 15 |  |  |  |  |  |  | 여유분 2 Point |  |  |  |  |  |  |
| 16 |  |  |  |  |  |  |  |  |  |  |  |  |  |
| 1 | Voltage | AO | AB | 212 | AB212 | feedback => MFM211 | STACK  에어블로어 |  | BLP-8080 |  |  | 0~5  | V |
| 2 | Voltage | AO | AB | 221 | AB221 | feedback => MFM222 | 개질기 버너 에어블로어 |  | LW 300 A3 |  |  | 0~5  | V |
| 3 | Voltage | AO | AB | 232 | AB232 | feedback => MFM231 | PrOx 에어블로우 |  | NMP850.1.2KPDCB-4 HP |  |  | 0~5  | V |
| 4 | Voltage | AO | P | 108 | P108 | feedback => PT109 | 가스 가압펌프 |  | PM33098-838.1.2 |  |  | 0~5  | V |
| 5 | Voltage | AO | P | 341 | P341 | feedback => TC343 또는 TC344(미정) | AOG 냉각용 물펌프 |  | INTG3-140 |  |  | 0~5  | V |
| 6 | Voltage | AO | P | 351 | P351 | feedback => TC 147 | Anode (RG) 냉각용 물펌프 |  | INTG3-140 |  |  | 0~5  | V |
| 7 | Voltage | AO | P | 370 | P370 | feedback => TC372 | STACK 1 냉각수 공급 |  | INTG3-140 |  |  | 0~5  | V |
| 8 | Voltage | AO | P | 380 | P380 | feedback => FM382 | 개질수 펌프 |  | PML20017-FP1.25 (KNF) |  |  | 0~5  | V |
| 9 |  |  |  |  |  |  | 여유분 2 Point |  |  |  |  |  |  |
| 10 |  |  |  |  |  |  |  |  |  |  |  |  |  |
| 1 | Voltage | DI | FD | 176 | FD176 |  | 버너 화염감지기 |  | FDU-520 |  |  | 0 or 24 | V |
| 2 | Voltage | DI | GD | 501 | GD501 |  | 메탄 누출 감지 |  |  |  |  | 0 or 24 | V |
| 3 | Voltage | DI | GD | 502 | GD502 |  | 수소 누출 감지 |  |  |  |  | 0 or 24 | V |
| 4 | Voltage | DI | FAN | 504 | FAN504 |  | 가스 환기팬1 |  | D12BH-24 |  |  | 0 or 24 | V |
| 5 | Voltage | DI | TJ- | sig | TJ-sig | 테스트용 | 내구성 평가용 지그 신호 (별도 구성) |  |  |  |  | 0 or 24 | V |
| 6 |  |  |  |  |  |  | 여유분 2 Point |  |  |  |  |  |  |
| 7 |  |  |  |  |  |  |  |  |  |  |  |  |  |
| 1 | Voltage | DO | SV | 102 | SV102 |  | 가스 인입 솔레노이드 밸브 1 |  | VX230GA |  |  | 0 or 24 | V |
| 2 | Voltage | DO | SV | 103 | SV103 |  | 가스 인입 솔레노이드 밸브 2 |  | VX230GA |  |  | 0 or 24 | V |
| 3 | Voltage | DO | SV | 125 | SV125 |  | 개질기 질소퍼지 솔레노이드 밸브 |  | VX230GA |  |  | 0 or 24 | V |
| 4 | Voltage | DO | SV | 145 | SV145 |  | ANODE 인입 솔레노이드 밸브 |  | VX230GA |  |  | 0 or 24 | V |
| 5 | Voltage | DO | SV | 149 | SV149 |  | 스택 질소퍼지 솔레노이드 밸브 |  | VX230GA |  |  | 0 or 24 | V |
| 6 | Voltage | DO | SV | 323 | SV323 |  | DI Water TANK 드레인 솔레노이드 밸브 |  | WV121S122QV-H-WS-C2 |  |  | 0 or 24 | V |
| 7 | Voltage | DO | MV | 124 | MV124 |  | PNG 인입 밸브 |  | AT24-3T |  |  | 0 or 24 | V |
| 8 | Voltage | DO | MV | 131 | MV131 |  | 개질 가스 인입 밸브 |  | AT24-3T |  |  | 0 or 24 | V |
| 9 | Voltage | DO | MV | 148 | MV148 |  | 개질가스 Bypass 전동 밸브 |  | AT24-3T |  |  | 0 or 24 | V |
| 10 | Voltage | DO | MV | 150 | MV150 |  | Anode 출구 전동 밸브 |  | AT24-3T |  |  | 0 or 24 | V |
| 11 | Voltage | DO | MV | 155 | MV155 |  | AOG 전동 밸브 |  | AT24-3T |  |  | 0 or 24 | V |
| 12 | Voltage | DO | MV | 158 | MV158 |  | AOG VENT 전동 밸브 |  | AT24-3T |  |  | 0 or 24 | V |
| 13 | Voltage | DO | MV | 300 | MV300 |  | 시설수 입구 전동 볼밸브 |  | AT24-3T |  |  | 0 or 24 | V |
| 15 | Voltage | DO | MV | 390 | MV390 |  | 배열 회수 입구 전동 볼 밸브 |  | AT24-3T |  |  | 0 or 24 | V |
| 16 |  |  |  |  |  |  | 여유분 2 Point |  |  |  |  |  |  |
| 17 |  |  |  |  |  |  |  |  |  |  |  |  |  |
| 1 | Voltage | DO | MC |  SW | MC SW |  | MC 동작 스위치 |  |  |  |  | 0 or 220 | VAC |
| 2 | Voltage | DO | HT | 193 | HT193 | 700W | LTS 촉매 히터 |  |  |  |  | 0 or 220 | VAC |
| 3 | Voltage | DO | HT | 194 | HT194 | 700W | LTS 촉매 히터 |  |  |  |  | 0 or 220 | VAC |
| 4 | Voltage | DO | HT | 195 | HT195 | 200W | Prox 히터1 |  |  |  |  | 0 or 220 | VAC |
| 5 | Voltage | DO | HT | 196 | HT196 | 200W | Prox 히터2 |  |  |  |  | 0 or 220 | VAC |
| 6 | Voltage | DO | IGN | 175 | IGN175 |  | 점화 트랜스 |  | TZI5-15/100WE |  |  | 0 or 220 | VAC |
| 7 | Voltage | DO |  |  |  |  | Spare, Spare TRIAC(위상제어용) |  |  |  |  | 0 or 220 | VAC |
| 8 | Voltage | DO |  |  |  |  |  |  |  |  |  | 0 or 220 | VAC |
## Sheet: 10k SYS IO_List 230626
| Num | Category | Slot number | IO type | IO Category | IO Box Category | IO Num | Part IO Num |  | IO Name | IO Number | Proto device
IO Masking | 비고 | Described | Naming | Remark | 실제값 | 실제 
단위 | 제어값 | 제어
단위 |
| --- | --- | --- | --- | --- | --- | --- | --- | --- | --- | --- | --- | --- | --- | --- | --- | --- | --- | --- | --- |
| 1 | Commu, | 1 | Serial | RS | 485 | 1 | RS 485 1 |  | INV | 506 | INV506 |  | 인버터 데이터 통신 |  |  |  |  |  |  |
| 2 | Commu, | 1 | Serial | RS | 232 | 2 | RS 232 2 |  | MFC | 121 | MFC121 | 232 to 485 | BNG MFC 통신 |  |  |  |  |  |  |
| 3 | Commu, | 1 | Serial | RS | 232 | 3 | RS 232 3 |  |  |  |  |  |  |  |  |  |  |  |  |
| 4 | Commu, | 1 | Serial | RS | 232 | 4 | RS 232 4 |  | MFC | 131 | MFC131 | 232 to 485 | PNG MFC 통신 |  |  |  |  |  |  |
| 5 | Commu, | 1 | Serial | RS | 232 | 5 | RS 232 5 |  |  |  |  |  |  |  |  |  |  |  |  |
| 6 | Commu, | 1 | Serial | RS | 232 | 6 | RS 232 6 |  | FM | 333 | FM333 | 232 to 485 | DI 개질수 데이터 통신 |  |  |  |  |  |  |
| 7 | TC | 2 | TC-K type | TC | A | 0 | TC A 0 |  | TC | 180 | TC180 | K | Ref-BN |  |  |  |  |  |  |
| 8 | TC | 2 | TC-K type | TC | A | 1 | TC A 1 |  | TC | 181 | TC181 | K | Ref-SR1 |  |  |  |  |  |  |
| 9 | TC | 2 | TC-K type | TC | A | 2 | TC A 2 |  | TC | 182 | TC182 | K | Ref-SR2 |  |  |  |  |  |  |
| 10 | TC | 2 | TC-K type | TC | A | 3 | TC A 3 |  | TC | 183 | TC183 | K | Ref-SR3 |  |  |  |  |  |  |
| 11 | TC | 2 | TC-K type | TC | A | 4 | TC A 4 |  | TC | 184 | TC184 | K | Ref-LTS1 |  |  |  |  |  |  |
| 12 | TC | 2 | TC-K type | TC | A | 5 | TC A 5 |  | TC | 185 | TC185 | K | Ref-LTS2 |  |  |  |  |  |  |
| 13 | TC | 2 | TC-K type | TC | A | 6 | TC A 6 |  | TC | 186 | TC186 | K | Ref-RG |  |  |  |  |  |  |
| 14 | TC | 2 | TC-K type | TC | A | 7 | TC A 7 |  | TC | 187 | TC187 | K | Ref-EG |  |  |  |  |  |  |
| 15 | TC | 2 | TC-K type | TC | A | 8 | TC A 8 |  | TC | 188 | TC188 | K | Prox-01 |  |  |  |  |  |  |
| 16 | TC | 2 | TC-K type | TC | A | 9 | TC A 9 |  | TC | 189 | TC189 | K | Prox-02 |  |  |  |  |  |  |
| 17 | TC | 2 | TC-T type | TC | A | 10 | TC A 10 |  | TC | 190 | TC190 | K | Prox-03 |  |  |  |  |  |  |
| 18 | TC | 2 | TC-T type | TC | A | 11 | TC A 11 |  |  |  |  |  |  |  |  |  |  |  |  |
| 19 | TC | 2 | TC-T type | TC | A | 12 | TC A 12 |  |  |  |  |  |  |  |  |  |  |  |  |
| 20 | TC | 2 | TC-T type | TC | A | 13 | TC A 13 |  |  |  |  |  |  |  |  |  |  |  |  |
| 21 | TC | 2 | TC-T type | TC | A | 14 | TC A 14 |  |  |  |  |  |  |  |  |  |  |  |  |
| 22 | TC | 2 | TC-T type | TC | A | 15 | TC A 15 |  |  |  |  |  |  |  |  |  |  |  |  |
| 23 | TC | 2 | TC-T type | TC | A | 16 | TC A 16 |  |  |  |  |  |  |  |  |  |  |  |  |
| 24 | TC | 2 | TC-T type | TC | A | 17 | TC A 17 |  |  |  |  |  |  |  |  |  |  |  |  |
| 25 | TC | 2 | TC-T type | TC | A | 18 | TC A 18 |  |  |  |  |  |  |  |  |  |  |  |  |
| 26 | TC | 2 | TC-T type | TC | A | 19 | TC A 19 |  |  |  |  |  |  |  |  |  |  |  |  |
| 27 | TC | 2 | TC-K type | TC | B | 0 | TC B 0 |  | TC | 105 | TC105 | T | 시티가스 공급온도 확인 |  |  |  |  |  |  |
| 28 | TC | 2 | TC-K type | TC | B | 1 | TC B 1 |  | TC | 125 | TC125 | T | 개질기 버너 역화 온도 측정 |  |  |  |  |  |  |
| 29 | TC | 2 | TC-K type | TC | B | 2 | TC B 2 |  | TC | 146 | TC146 | T | 개질가스 온도 측정 |  |  |  |  |  |  |
| 30 | TC | 2 | TC-K type | TC | B | 3 | TC B 3 |  | TC | 151 | TC151 | T | 개질 가스 온도 측정 |  |  |  |  |  |  |
| 31 | TC | 2 | TC-K type | TC | B | 4 | TC B 4 |  | TC | 167 | TC167 | T | AOG 버너 입구 온도측정 |  |  |  |  |  |  |
| 32 | TC | 2 | TC-K type | TC | B | 5 | TC B 5 |  | TC | 174 | TC174 | T | 배기가스 온도 측정 |  |  |  |  |  |  |
| 33 | TC | 2 | TC-K type | TC | B | 6 | TC B 6 |  | TC | 214 | TC214 | T | Cathode 입구 온도 |  |  |  |  |  |  |
| 34 | TC | 2 | TC-K type | TC | B | 7 | TC B 7 |  | TC | 215 | TC215 | T | STACK 1 Cathode 입구 출구 |  |  |  |  |  |  |
| 35 | TC | 2 | TC-K type | TC | B | 8 | TC B 8 |  | TC | 303 | TC303 | T | 초순수 탱크 공급 온도 |  |  |  |  |  |  |
| 36 | TC | 2 | TC-K type | TC | B | 9 | TC B 9 |  | TC | 316 | TC316 | T | STACK 1 냉각수 출구 온도 |  |  |  |  |  |  |
| 37 | TC | 2 | TC-T type | TC | B | 10 | TC B 10 |  | TC | 318 | TC318 | T | STACK 1 냉각수 회수 온도 |  |  |  |  |  |  |
| 38 | TC | 2 | TC-T type | TC | B | 11 | TC B 11 |  | TC | 326 | TC326 | T | STACK 2 냉각수 출구 온도 |  |  |  |  |  |  |
| 39 | TC | 2 | TC-T type | TC | B | 12 | TC B 12 |  | TC | 328 | TC328 | T | STACK 2 냉각수 회수 온도 |  |  |  |  |  |  |
| 40 | TC | 2 | TC-T type | TC | B | 13 | TC B 13 |  | TC | 348 | TC348 | T | DI 응축수 온도 |  |  |  |  |  |  |
| 41 | TC | 2 | TC-T type | TC | B | 14 | TC B 14 |  | TC | 402 | TC402 | T | 시스템 냉각수 탱크 상부 온도 |  |  |  |  |  |  |
| 42 | TC | 2 | TC-T type | TC | B | 15 | TC B 15 |  | TC | 403 | TC403 | T | 시스템 냉각수 탱크 하부 온도 |  |  |  |  |  |  |
| 43 | TC | 2 | TC-T type | TC | B | 16 | TC B 16 |  | TC | 413 | TC413 | T | 시스템 배열 회수 온도 |  |  |  |  |  |  |
| 44 | TC | 2 | TC-T type | TC | B | 17 | TC B 17 |  | TC | 425 | TC425 | T | 외부 냉각수 입구 온도 |  |  |  |  |  |  |
| 45 | TC | 2 | TC-T type | TC | B | 18 | TC B 18 |  | TC | 426 | TC426 | T | 외부 냉각수 출구 온도 |  |  |  |  |  |  |
| 46 | TC | 2 | TC-T type | TC | B | 19 | TC B 19 |  | TC | 507 | TC507 | T | 시스템 내부 온도 |  |  |  |  |  |  |
| 47 | AI | 4 | Current | AI | A | 0 | AI A 0 |  | PT | 104 | PT104 |  | 유틸리티 압력 확인용 |  | PSCD0005RAPG | 0~10 | kPa | 0~5  | V |
| 48 | AI | 4 | Current | AI | A | 1 | AI A 1 |  | PT | 110 | PT110 |  | 가스 버퍼탱크 압력 확인용 |  | PSS-01V-R1/8 | 0~100 | kPa | 1~5  | V |
| 49 | AI | 4 | Current | AI | A | 2 | AI A 2 |  | PT | 124 | PT124 |  | 개질기 버너 압력 확인용 |  | PSS-01V-R1/8 | 0~100 | kPa | 1~5  | V |
| 50 | AI | 4 | Current | AI | A | 3 | AI A 3 |  | PT | 134 | PT134 |  | 개질기 촉매부 압력 확인 |  | PSS-01V-R1/8 | 0~100 | kPa | 1~5  | V |
| 51 | AI | 4 | Current | AI | A | 4 | AI A 4 |  | PT | 145 | PT145 |  | 개질가스 압력 측정 |  | PT201H-G01B-HT | 0~100 | kPa | 1~5  | V |
| 52 | AI | 4 | Current | AI | A | 5 | AI A 5 |  | PT | 153 | PT153 |  | STACK 1 Anode 입구 압력 측정 |  | PT201H-G01B | 0~100 | kPa | 1~5  | V |
| 53 | AI | 4 | Current | AI | A | 6 | AI A 6 |  | PT | 154 | PT154 | Test 후 1번 통합 | STACK 2 Anode 입구 압력 측정 |  | PT201H-G01B | 0~100 | kPa | 1~5  | V |
| 54 | AI | 4 | Current | AI | A | 7 | AI A 7 |  | PT | 175 | PT175 |  | 배기가스 압력 측정 |  | PSS-01V-R1/8 | 0~100 | kPa | 1~5  | V |
| 55 | AI | 4 | Current | AI | A | 8 | AI A 8 |  | FM | 211 | FM211 |  | STACK 1 공기 유량계 |  | PFMB7202-06-C | 0~400 | LPM | 1~5  | V |
| 56 | AI | 4 | Current | AI | A | 9 | AI A 9 |  | FM | 231 | FM231 |  | PrOx 공기 유량계 |  | PFM710-01-C | 0~10 | LPM | 1~5  | V |
| 57 | AI | 4 | Current | AI | A | 10 | AI A 10 |  | FM | 241 | FM241 |  | 개질기 버너 공기 유량계 |  | PFMB7202-06-C | 0~400 | LPM | 1~5  | V |
| 58 | AI | 4 | Current | AI | A | 11 | AI A 11 |  | CS | 302 | CS302 |  | DI 탱크 전도도 센서 |  | CM-230K | 0.5~200 | us/s | 1~5  | V |
| 59 | AI | 4 | Current | AI | A | 12 | AI A 12 |  | PT | 315 | PT315 |  | STACK 1 냉각수 입구 압력 확인 |  | PT201H-G01B | 0~100 kPa | kPa | 1~5  | V |
| 60 | AI | 4 | Current | AI | A | 13 | AI A 13 |  | PT | 325 | PT325 |  | STACK 2 냉각수 입구 압력 확인 |  | PT201H-G01B | 0~100 kPa | kPa | 1~5  | V |
| 61 | AI | 4 | Current | AI | A | 14 | AI A 14 |  | PT | 335 | PT335 |  | 개질수 압력측정 |  | PSAN-L1CPV | 0~1000 kPa | kPa | 1~5  | V |
| 62 | AI | 4 | Current | AI | A | 15 | AI A 15 |  | CS | 347 | CS347 |  | 재순환 탱크 전도도 센서 |  | CM-230K | 0.5~200 | us/s | 1~5  | V |
| 63 | AO | 6 | Voltage | AO | A | 00 | AO A 00 |  | P | 108 | P108 | P108 / P109
 병렬 운전 | 가스 가압펌프 |  | feedback => PT110(AI A 1) , PM33098-838.1.2 |  |  | 0~5  | V |
| 64 | AO | 6 | Voltage | AO | A | 01 | AO A 01 |  | P | 109 | P109 |  | 가스 가압펌프(AO A 00과 동일 신호 적용) |  |  |  |  |  |  |
| 65 | AO | 6 | Voltage | AO | A | 02 | AO A 02 |  | AB | 212 | AB212 |  | STACK  에어블로어 |  | feedback => FM221(AI A 8) ,  |  |  | 0~5  | V |
| 66 | AO | 6 | Voltage | AO | A | 03 | AO A 03 |  | AB | 232 | AB232 |  | PrOx 에어블로우 |  | feedback => FM231(AI A 9) , NMP850.1.2KPDCB-4 HP |  |  | 0~5  | V |
| 67 | AO | 6 | Voltage | AO | A | 04 | AO A 04 |  | AB | 242 | AB242 |  | 개질기 버너 에어블로어 |  | feedback => PT112(AI A 10) , VRB8-25-48 |  |  | 0~5  | V |
| 68 | AO | 6 | Voltage | AO | A | 05 | AO A 05 |  | P | 312 | P312 |  | STACK 1 냉각수 공급 |  | feedback => FM314(Counter A 3) , INTG3-140 |  |  | 0~5  | V |
| 69 | AO | 6 | Voltage | AO | A | 06 | AO A 06 |  | P | 322 | P322 |  | STACK 2 냉각수 공급 |  | feedback => FM334(Counter A 4) , INTG3-140 |  |  | 0~5  | V |
| 70 | AO | 6 | Voltage | AO | A | 07 | AO A 07 |  | P | 332 | P332 |  | 개질수 펌프 |  | feedback => FM312(RS232 COM6) , GA-V21-DEMSE |  |  | 0~5  | V |
| 71 | AO | 6 | Voltage | AO | A | 08 | AO A 08 |  | P | 422 | P422 |  | 시스탬 열교환기 냉각수 공급 |  | feedback => TC174(TC A 17) , INTG3-140 |  |  | 0~5  | V |
| 72 | AO | 6 | Voltage | AO | A | 09 | AO A 09 |  |  |  |  |  |  |  |  |  |  |  |  |
| 73 | AO | 6 | Voltage | AO | A | 10 | AO A 10 |  | P | 432 | P432 |  | 개질 가스 열교환 냉각수 공급 |  | feedback => TC151(TC A 18) , INTG3-140 |  |  | 0~5  | V |
| 74 | AO | 6 | Voltage | AO | A | 11 | AO A 11 |  | P | 442 | P442 |  | STACK 열교환기 냉각수 공급 펌프 |  |  INTG3-140 |  |  | 0~5  | V |
| 75 | AO | 6 | Voltage | AO | A | 12 | AO A 12 |  | INV  | ADJ | INV ADJ |  | INV CC 제어 |  |  |  |  | 0~5  | V |
| 76 | AO | 6 | Voltage | AO | A | 13 | AO A 13 |  |  |  |  |  |  |  |  |  |  |  |  |
| 77 | AO | 6 | Voltage | AO | A | 14 | AO A 14 |  |  |  |  |  |  |  |  |  |  |  |  |
| 78 | AO | 6 | Voltage | AO | A | 15 | AO A 15 |  |  |  |  |  |  |  |  |  |  |  |  |
| 79 | DI | 7 | Voltage | DI | A | 0 | DI A 0 |  | FD | 508 | FD508 |  | 버너 화염감지기 |  |  |  |  | 0 or 24 | V |
| 80 | DI | 7 | Voltage | DI | A | 1 | DI A 1 |  | FAN | 503 | FAN503 |  | 환기팬1 |  |  |  |  | 0 or 24 | V |
| 81 | DI | 7 | Voltage | DI | A | 2 | DI A 2 |  |  |  |  |  |  |  |  |  |  |  |  |
| 82 | DI | 7 | Voltage | DI | A | 3 | DI A 3 |  |  |  |  |  |  |  |  |  |  |  |  |
| 83 | DI | 7 | Voltage | DI | A | 4 | DI A 4 |  |  |  |  |  |  |  |  |  |  |  |  |
| 84 | DI | 7 | Voltage | DI | A | 5 | DI A 5 |  | GD | 504 | GD504 |  | 메탄누출감지 |  |  |  |  |  |  |
| 85 | DI | 7 | Voltage | DI | A | 6 | DI A 6 |  | GD | 505 | GD505 |  | 수소누출감지 |  |  |  |  | 0 or 24 | V |
| 86 | DI | 7 | Voltage | DI | A | 7 | DI A 7 |  |  |  |  |  |  |  |  |  |  | 0 or 24 | V |
| 87 | DI | 7 | Voltage | DI | A | 8 | DI A 8 |  |  |  |  |  |  |  |  |  |  |  |  |
| 88 | DI | 7 | Voltage | DI | A | 9 | DI A 9 |  |  |  |  |  |  |  |  |  |  |  |  |
| 89 | DI | 7 | Voltage | DI | A | 10 | DI A 10 |  |  |  |  |  |  |  |  |  |  |  |  |
| 90 | DI | 7 | Voltage | DI | A | 11 | DI A 11 |  |  |  |  |  |  |  |  |  |  |  |  |
| 91 | DI | 7 | Voltage | DI | A | 12 | DI A 12 |  |  |  |  |  |  |  |  |  |  |  |  |
| 92 | DI | 7 | Voltage | DI | A | 13 | DI A 13 |  |  |  |  |  |  |  |  |  |  |  |  |
| 93 | DI | 7 | Voltage | DI | A | 14 | DI A 14 |  |  |  |  |  |  |  |  |  |  |  |  |
| 94 | DI | 7 | Voltage | DI | A | 15 | DI A 15 |  | TJ- | sig | TJ-sig | 테스트용 | 내구성 평가용 지그 신호 (별도 구성) |  |  |  |  | 0 or 24 | V |
| 95 | DI | 7 | Voltage | Counter | A | 0 | Counter A 0 |  |  |  |  |  |  |  |  |  |  |  |  |
| 96 | DI | 7 | Voltage | Counter | A | 1 | Counter A 1 |  |  |  |  |  |  |  |  |  |  |  |  |
| 97 | DI | 7 | Voltage | Counter | A | 2 | Counter A 2 |  | FM | 444 | FM444 |  | 외부 냉각수 회수 유량 확인 |  |  |  |  | 18.6 | ml/P |
| 98 | DI | 7 | Voltage | Counter | A | 3 | Counter A 3 |  | FM | 314 | FM314 |  | STACK 1 냉각수 유량 확인 |  |  |  |  | 18.6 | ml/P |
| 99 | DI | 7 | Voltage | Counter | A | 4 | Counter A 4 |  | FM | 324 | FM324 |  | STACK 2 냉각수 유량 확인 |  |  |  |  | 18.6 | ml/P |
| 100 | DI | 7 | Voltage | Counter | A | 5 | Counter A 5 |  | FM | 408 | FM408 |  | 시스템 배열 회수 유량 확인 |  |  |  |  | 18.6 | ml/P |
| 101 | DO | 8 | Voltage | DO | A | 0 | DO A 0 |  | SV | 102 | SV102 | P com1 | 가스 인입밸브 1 |  |  |  |  | 0 or 24 | V |
| 102 | DO | 8 | Voltage | DO | A | 1 | DO A 1 |  | SV | 103 | SV103 | P com2 | 가스 인입밸브 2 |  |  |  |  | 0 or 24 | V |
| 103 | DO | 8 | Voltage | DO | A | 2 | DO A 2 |  | SV | 152 | SV152 | P com3 | ANODE 인입 밸브 |  |  |  |  | 0 or 24 | V |
| 104 | DO | 8 | Voltage | DO | A | 3 | DO A 3 |  | HT | 193 | HT193 | P com4 | LTS 촉매 히터 1 |  |  |  |  | 0 or 24 | V |
| 105 | DO | 8 | Voltage | DO | A | 4 | DO A 4 |  | HT | 194 | HT194 | P com5 | LTS 촉매 히터 2 |  |  |  |  | 0 or 24 | V |
| 106 | DO | 8 | Voltage | DO | A | 5 | DO A 5 |  | SV | 304 | SV304 | P com6 | DI 탱크 배수 솔레노이드 밸브 |  |  |  |  | 0 or 24 | V |
| 107 | DO | 8 | Voltage | DO | A | 6 | DO A 6 |  | SV | 306 | SV306 | P com7 | 배기 응축수 드레인 솔레노이드 밸브 |  |  |  |  | 0 or 24 | V |
| 108 | DO | 8 | Voltage | DO | A | 7 | DO A 7 |  | P | 346 | P346 | P com8 | DI 필터링 펌프 |  |  |  |  | 0 or 24 | V |
| 109 | DO | 8 | Voltage | DO | A | 8 | DO A 8 |  | INV  | RUN | INV RUN | P com9 | 인버터 RUN |  |  |  |  | 0 or 24 | V |
| 110 | DO | 8 | Voltage | DO | A | 9 | DO A 9 |  | P | 412 | P412 | P com10 | RG 열교환기 냉각수 공급 |  |  |  |  | 0 or 24 | V |
| 111 | DO | 8 | Voltage | DO | A | 10 | DO A 10 |  | P | 343 | P343 | P com11 | 수자립 펌프 |  |  |  |  | 0 or 24 | V |
| 112 | DO | 8 | Voltage | DO | A | 11 | DO A 11 |  |  |  |  |  |  |  |  |  |  |  |  |
| 113 | DO | 8 | Voltage | DO | A | 12 | DO A 12 |  |  |  |  |  |  |  |  |  |  |  |  |
| 114 | DO | 8 | Voltage | DO | A | 13 | DO A 13 |  |  |  |  |  |  |  |  |  |  |  |  |
| 115 | DO | 8 | Voltage | DO | A | 14 | DO A 14 |  | SV | 501 | SV501 | P com15 | 개질기 질소퍼지 솔레노이드 밸브 |  |  |  |  | 0 or 24 | V |
| 116 | DO | 8 | Voltage | DO | A | 15 | DO A 15 |  | SV | 502 | SV502 | P com16 | 스택 질소퍼지 솔레노이드 밸브 |  |  |  |  | 0 or 24 | V |
| 117 | DO | 8 | Voltage | DO | A | 16 | DO A 16 |  | BV | 123 | BV123 | N com1 | BNG 전동 밸브 |  |  |  |  | 0 or 24 | V |
| 118 | DO | 8 | Voltage | DO | A | 17 | DO A 17 |  | BV | 133 | BV133 | N com2 | PNG 전동 밸브 |  |  |  |  | 0 or 24 | V |
| 119 | DO | 8 | Voltage | DO | A | 18 | DO A 18 |  | BV | 155 | BV155 | N com3 | 개질가스 우회로 전동밸브 |  |  |  |  | 0 or 24 | V |
| 120 | DO | 8 | Voltage | DO | A | 19 | DO A 19 |  | BV | 161 | BV161 | N com4 | Anode 출구 전동 밸브 |  |  |  |  | 0 or 24 | V |
| 121 | DO | 8 | Voltage | DO | A | 20 | DO A 20 |  | BV | 166 | BV166 | N com5 | AOG 전동 밸브 |  |  |  |  | 0 or 24 | V |
| 122 | DO | 8 | Voltage | DO | A | 21 | DO A 21 |  | BV | 169 | BV169 | N com6 | AOG VENT 전동 밸브 |  |  |  |  | 0 or 24 | V |
| 123 | DO | 8 | Voltage | DO | A | 22 | DO A 22 |  | BV | 407 | BV407 | N com7 | 시스템 냉각수 탱크 드레인 벨브 |  |  |  |  | 0 or 24 | V |
| 124 | DO | 8 | Voltage | DO | A | 23 | DO A 23 |  | BV | 410 | BV410 | N com8 | 시설수 공급 밸브 |  |  |  |  | 0 or 24 | V |
| 125 | DO | 8 | Voltage | DO | A | 24 | DO A 24 |  | MC |  SW | MC SW | AC R com1 | MC 동작 스위치 |  |  |  |  | 0 or 24 | V |
| 126 | DO | 8 | Voltage | DO | A | 25 | DO A 25 |  | IGN | 192 | IGN192 | AC R com4 | 점화 트랜스 |  |  |  |  | 0 or 24 | V |
| 127 | DO | 8 | Voltage | DO | A | 26 | DO A 26 |  | HT | 198 | HT198 | AC R com2 | Prox 촉매 히터 1 |  |  |  |  | 0 or 24 | V |
| 128 | DO | 8 | Voltage | DO | A | 27 | DO A 27 |  | HT | 199 | HT199 | AC R com3 | Prox 촉매 히터 2 |  |  |  |  | 0 or 24 | V |
| 129 | DO | 8 | Voltage | DO | A | 28 | DO A 28 |  |  |  |  | AC R com2 |  |  |  |  |  |  |  |
| 130 | DO | 8 | Voltage | DO | A | 29 | DO A 29 |  |  |  |  | AC R com3 |  |  |  |  |  |  |  |
| 131 | DO | 8 | Voltage | DO | A | 30 | DO A 30 |  |  |  |  | AC R com7 |  |  |  |  |  |  |  |
| 132 | DO | 8 | Voltage | DO | A | 31 | DO A 31 |  |  |  |  | AC R com8 |  |  |  |  |  |  |  |
|  |  |  |  |  |  |  | AO A 05 |  | <=== | 312 |  |  |  |  |  |  |  |  |  |
