seokipo/H2_Control_Board/graphify-out/converted/FuelCell_4451deeb.md

<!-- converted from FuelCell.xlsx -->

## Sheet: FuelCell
|  |  | 연료전지 컨트롤러 PCB |  |  |  |  |  |  |  |  |
| --- | --- | --- | --- | --- | --- | --- | --- | --- | --- | --- |
|  |  |  |  |  | 생산수량 | 30 | 2026-08-10 18:49:07.790000 |  |  |  |
|  | Comment | Designator | Part No | 규격 | Quantity | Footprint | Part No. | 재고 | 필요수량 | Price |
| 1 | 포토커플러 | B100, B101, B400, B401, B402, B403, B404, B405, B500, B501, B502, B503, B504, B505, B506, B507, B508, B509, B510, B511, B512, B513, B514, B515, B516, B517, B518, B519, B520, B521, B522, B523, 'B524,B525, B526, B527 | PC357N14J00F |  | 36 |  |  | 200 | -880 |  |
| 2 | 다이오드 브릿지 | BD100 | DF06S |  | 1 | DF-S | DF06 | 1000 | 970 |  |
| 3 | 칩 세라믹 | C13, C14, C200, C201, C202, C203 | 22p | C1608 | 6 | CC1608 | {Part No} |  | -180 |  |
| 4 | 칩 세라믹 | C304, C305 | 0.01uF | C1608 | 2 | CC1608N | {Part No} | 4000 | 3940 |  |
| 5 | 칩 세라믹 | C5, C7, C8, C9, C10, C12, C206, C207, C208, C209, C300, C301, C306, C307, C308, C309, C310, C311, C312, C313,'C1, C2, C3, C4, C6, C204, C205, C210, C211, C212, C213, C302, C303, C400, C401, C402, C403, C404, C405, C406, C407, C408, C409, C410, C411, C412, C413, C414, C415, C416, C417, C418, C500, C501, C502, C503, C504 | 0.1uF | C1608 | 19 | CC1608N | {Part No} | 5000 | 4430 |  |
| 6 | 칩 세라믹 | C100, C101, C102, C103, C104 | 0.1uF | C2012 | 5 | CC2012 | C2012X7R1H104KT  (CC20X104K50W) |  | -150 |  |
| 7 | 칩 세라믹 | C214, C215 | C4520X7R3D102K130KA | C4520 | 2 | C4520_COMMERCIAL |  |  | -60 |  |
| 8 | CHIP 전해 | CP1, CP200, CP300 | CHIP 전해 100uF/16V(MVK) [6.3*6] | CHIP 전해 [6.3파이] | 3 | CP5_SMT | {Part No} |  | -90 |  |
| 9 | CHIP 전해 | CP102, CP103, CP105 | CHIP 전해 470UF/25V(MVK) [10파이] | CHIP 전해 [10파이] | 3 | CP10_SMT | {Value} |  | -90 |  |
| 10 | CHIP 전해 | CP2, CP201, CP301 | CHIP 전해 220uF/16V(MVK) [6.3*6] | CHIP 전해 [6.3파이] | 3 | CP6_SMT | RV16V220 6.3X7.7 (ELNA / 삼영) |  | -90 |  |
| 11 | 다이오드 TVS | D1, D501, D502, D505, D506, D508, D509 | SM712.TCT / SM712-02HTG |  | 7 | SOT95P240X115-3N | sm712 | 0 | -210 |  |
| 12 | 다이오드 쇼트키 | D400, D401, D402, D403, D404, D405, D406, D407, D408, D409, D410, D411, D412, D413, D414 | BAT54C-G |  | 15 | SOT-23 | bat54-g | 3000 | 2550 |  |
| 13 | 다이오드 | D500, D503, D504, D507, D510, D511, D512, D513, D514, D515, D516, D517, D518, D519, D520, D521, D522, D523, D524 | sod4007 |  | 19 | MINI-SMA | 1N4007 | 3000 | 2430 |  |
| 14 | NOISE FILTER | L100 | NF_HP10 |  | 1 | NF_HP1 | HP1-P10 | 0 | -30 |  |
| 15 | SC1260 | L101, L102, L103 | SC1260-330M(33UH)  |  | 3 | SC1260S | VLP8040T-100M | 0 | -90 |  |
| 16 | 칩 LED 1608  | LED100, LED101, LED102, LED103, LED500, LED501, , LED503, LED505,  LED507, LED510, LED511, LED512, LED513, LED514, LED515, LED516, LED517, LED518, LED519, LED520, LED521, LED522 | BL-HUF35A-AV-TRB | 적색 1608 | 22 | LED1608 | {Part No} | 5000 | 4340 |  |
| 17 | 칩 LED 1608 | LED502, LED504, LED506 ,LED508, LED509,  | BL-HG035A-AV-TRB | 녹색 1608 | 5 | LED1608 |  | 5000 | 4850 |  |
| 18 | 칩저항 1608 | R206, R207, R208, R209, R210, R211, R212, R213 | 49.9/1% |  | 8 | RESC1608X55N | {Part No} | 0 | -240 |  |
| 19 | 칩저항 1608 | R300, R301, R302, R400, R403, R406, R408, R414, R417, R420, R427, R428, R435, R436, R443, R444, R452, R453, R500, R501, R503, R504, R516, R517, R520, R521, R531, R532, R538, R539 | 100 |  | 30 | RESC1608X55N | {Part No} | 0 | -900 |  |
| 20 | 칩저항 1608 | R4, R7 | 120Ω  /1 % |  | 2 | RESC1608X55N | {Part No} | 0 | -60 |  |
| 21 | 칩저항 1608 | R401, R404, R407, R410, R415, R421, R423, R429, R430, R437, R438, R445, R446, R454, R456 | 249/1% |  | 15 | RESC1608X55N | {Part No} | 5000 | 4550 |  |
| 22 | 칩저항 1608 | R107, R505, R510, R514, R523, R526, R533, R535, R543, R545, R550, R554, R559, R561, R568, R570, R578, R579, R587, R588, R598, R599, R600, R608, R612, R614 | 470 |  | 26 | RESC1608X55N | {Part No} | 0 | -780 |  |
| 23 | 칩저항 1608 | R109 | 1k |  | 1 | RESC1608X55N | {Part No} | 2000 | 1970 |  |
| 24 | 칩저항 1608 | R103, R110, R562, R572, R581, R591, R603 | 2k |  | 7 | RESC1608X55N | {Part No} | 3000 | 2790 |  |
| 25 | 칩저항 1608 | R101, R102, R108, R412, R502, R508, R512, R522, R530, R541, R549, R558, R566, R575, R585, R595, R597, R609, R611 | 3.3k |  | 19 | RESC1608X55N | {Part No} | 3000 | 2430 |  |
| 26 | 칩저항 1608 | R8, R11, R12, R13, R105 | 4.7k |  | 5 | RESC1608X55N | {Part No} | 3000 | 2850 |  |
| 27 | 칩저항 1608 | R5, R6, R9, R10, R111, R200, R201, R202, R203, R204, R205, R411, R418, R425, R433, R440, R448, R506, R507, R509, R511, R513, R515, R518, R519, R524, R525, R527, R528, R529, R534, R536, R537, R540, R542, R544, R546, R547, R548, R551, R552, R553, R555, R556, R557, R560, R563, R565, R567, R569, R571, R573, R576, R577, R580, R582, R584, R586, R589, R590, R596, R601, R604, R610, R615, R616 | 10K |  | 66 | RESC1608X55N | {Part No} | 5000 | 3020 |  |
| 28 | 칩저항 1608 | R100 | 20k |  | 1 | RESC1608X55N | {Part No} | 3000 | 2970 |  |
| 29 | 칩저항 1608 | R104, R106 | 47k |  | 2 | R3216 | {Part No} | 0 | -60 |  |
| 30 | 칩저항 1608 | R564, R574, R583, R592, R605 | 100k |  | 5 | RESC1608X55N | {Part No} | 5000 | 4850 |  |
| 31 | 칩저항 2012 | R419, R426, R434, R442, R449, R451 | 1k |  | 6 | R2012 | 1k | 3000 | 2820 |  |
| 32 | 칩저항 3216 | R1, R2, R3, R402, R405, R409, R413, R416, R422, R424, R431, R432, R439, R441, R447, R450, R455, R457 | 0 |  | 18 | R3216 | {Part No} | 0 | -540 |  |
| 33 | 칩저항 3216 | R593, R602, R606, R613 | 330 |  | 4 | R3216 | {Part No} | 0 | -120 |  |
| 34 | 칩저항 3216 | R214, R215, R216, R217 | 510k |  | 4 | R3216 | {Part No} | 0 | -120 |  |
| 35 | IC | IC2 | W25Q256JVEIQ |  | 1 | SOIC127P600X175-8N |  | 0 | -30 |  |
| 36 | IC | IC201, IC202 | W5500 |  | 2 | QFP50P900X900X160-48N |  | 0 | -60 |  |
| 37 | IC | IC3 | W25Q256FVEIQ |  | 1 | SON127P800X600X80-9N-D |  | 0 | -30 |  |
| 38 | IC | IC300, IC303, IC305, IC306, IC307, IC308 | ADG706BRUZ |  | 6 | SOP65P640X120-28N |  | 0 | -180 |  |
| 39 | IC | IC301 | MAX31856MUD+ |  | 1 | SOP65P640X110-14N |  | 0 | -30 |  |
| 40 | IC | IC304 | LM35DZ/NOPB |  | 1 | TO92 |  | 0 | -30 |  |
| 41 | IC | IC4 | MAX3485CSA+ |  | 1 | SOIC127P600X175-8N |  | 0 | -30 |  |
| 42 | IC | IC400, IC401, IC402, IC403 | ADS1115BQDGSRQ1 |  | 4 | SOP50P490X110-10N |  | 0 | -120 |  |
| 43 | IC | IC5 | DSPIC33CK512MP710-E_PT |  | 1 | QFP40P1400X1400X120-100N |  | 0 | -30 |  |
| 44 | IC | IC500, IC502, IC503 | TLV2374ID |  | 3 | SOIC127P600X175-14N |  | 0 | -90 |  |
| 45 | IC | IC501 | DAC60516RUYT |  | 1 | QFN40P400X400X80-29N-D |  | 0 | -30 |  |
| 46 | IC | IC504, IC505 | MOC3063S |  | 2 | SOT254P1016X460-6N |  | 0 | -60 |  |
| 47 | IC | IC6 | DS3231SN+ |  | 1 | SOIC127P1032X265-16N |  | 0 | -30 |  |
| 48 | L 2012 | L1, L2, L3,L200, L201 | BLM21AG102SN1D |  | 3 | BEADC2012X110N | BLM21AG102 | 0 | -90 |  |
| 49 | 쇼트키 다이오드 | SD100, SD101, SD102 | ss34 | 3A | 3 | SMA | SS34 | 0 | -90 |  |
| 50 | TR | Q500, Q501, Q502, Q503, Q505, Q507 | KRC105S |  | 6 | SOT-23 | KRC105S | 3000 | 2820 |  |
| 51 | FET | U501, U504, U507, U509, U512, U515, U526, U528 | FDS8880/SQ4184EY-T1_GE3 |  | 8 | SOIC127P600X175-8N | FDS5672, IRF7413 | 0 | -240 |  |
| 52 | FET | U502, U505, U510, U513, U516, U518, U520, U522, U524 | NTR4003nt1g |  | 9 | SOT-23 | NTR4003 | 3000 | 2730 |  |
| 53 | osc | Y1 | 7V-8.000MDDQ-T | X-tal 8Mhz | 1 | 7M8000MEEQT |  | 0 | -30 |  |
| 54 | osc | Y200, Y201 | 7M-25.000MEEQ-T | X-tal 25Mhz | 2 | 7M25000MEEQT |  | 0 | -60 |  |
| 55 | 제너 다이오드 | ZD500, ZD501, ZD502, ZD503, ZD504, ZD505, ZD506, ZD507, ZD508 | CZRW5240B-G | '10V/0.5A | 9 | ZD3216M | BZT52C24 /` TCMMSZ5252BW | 3000 | 2730 |  |
| 56 | 레귤레이터 | IC1, IC200, IC302 |  IL1117C-3.3 |  | 3 | SOT-223 | LM1117-3.3V | 3000 | 2910 |  |
| 57 | 레귤레이터 | U101, U103 | LM2576S-12.0/NOPB |  | 2 | KTT0005B |  | 0 | -60 |  |
| 58 | 레귤레이터 | U102 | LM2576S-5.0/NOPB |  | 1 | KTT0005B | LM2576S-3.3/NOPB | 0 | -30 |  |
| 59 | 베터리 홀더 | 2032 | BS8  - Voltly / CH7410-2032 | C2032 | 1 | BATT_CASE_2032 | cr2032 |  | -30 |  |
| 60 | 컨넥터 웨이퍼 | CW514, CW521 | SMW250-02D |  | 2 | SMW250-02D | {Part No} | 200 | 140 |  |
| 61 | 컨넥터 웨이퍼 | CW400, CW401, CW402, CW403, CW404, CW407, CW409, CW410, CW411, CW412, CW413, CW414, CW415, CW416, CW417, CW418, CW420, CW421, CW501, CW503, CW505, CW509, CW513, CW516, CW520, CW523, CW526, CW528 | SMW250-03D |  | 28 | SMW250-03D | SMW025-03, smw025-03d, {Part No} | 0 | -840 |  |
| 62 | 컨넥터 웨이퍼 | CW405, CW419 | SMW250-04D |  | 2 | SMW250-04D | SMW025-04, smw250-04d | 0 | -60 |  |
| 63 | 컨넥터 웨이퍼 | CW406, CW408 | SMW250-05D |  | 2 | SMW250-05D | smw025-05 | 0 | -60 |  |
| 64 | 컨넥터 웨이퍼 | CW100, CW500, CW502, CW504, CW506, CW508, CW511, CW512, CW519, CW524, CW529 | YW396_02 |  | 11 | YW396_02 | YW396-02 | 0 | -330 |  |
| 65 | 컨넥터 웨이퍼 | CW507, CW510, CW517, CW518 | YW396_03 |  | 4 | YW396_03 | YW396-03 | 0 | -120 |  |
| 66 | 컨넥터 웨이퍼 | CW515, CW522, CW525, CW527 | YW396_04 |  | 4 | YW396_04 | {Part No}, yw396-04 | 0 | -120 |  |
| 67 | 컨넥터 웨이퍼 | J1 | 1818025 |  | 1 | 1818025 |  | 0 | -30 |  |
| 68 | 컨넥터 웨이퍼 | J201,J200 | 0438600013 |  | 2 | 0438600013 |  | 0 | -60 |  |
| 69 | 컨넥터 웨이퍼 | J300, J301, J302, J303, J304, J305, J306, J307 | 1990083 |  | 8 | 1990083 |  | 0 | -240 |  |
| 70 | 저항 | R594, R607 | 330/1w DIP | 330/1w DIP | 2 | 1 W | {Part No} | 0 | -60 |  |
| 71 | FUSE_CASE | FUSE100, FUSE101 | FUSE_CASE |  | 2 | FUSE_HOLD_S | {Part No} | 0 | -60 |  |
| 72 | 트라이액 | Q504 | Z0405MH  |  | 1 | TO-251-3 | Z0405 | 100 | 70 |  |
| 73 | 트라이액 | Q506 | BTA16-600B  | 16A/600V | 1 | TO-220-HT | BAT16-400B | 0 | -30 |  |
| 74 | 전해 콘덴서  | CP100, CP101, CP104 | 1000uF/50V | DIP | 3 | CP5_12 | {Part No} |  | -90 |  |
| 75 | 릴리에 | U517, U519, U521, U523, U525, U527 | HL2-2CM-dc24v |  | 6 | HL2-2CM | {Part No} | 100 | -80 |  |
| 76 | 터미널 블록 | TM100 | HP-1000SA-3pin |  | 1 | TERMINAL_10_3 | {PartNo} | 0 | -30 |  |
| 77 | 터미널 블록 | TM101 | HP-1000SA-2pin |  | 1 | TERMINAL_10_2 | {PartNo} | 0 | -30 |  |
| 78 | 터미널 블록 | TN500 | HP-1000SA-14pin |  | 1 | TERMINAL_10_14 | {Part No} | 10 | -20 |  |
| 79 | AC-DC컨버터 | U100 | IRM-30-24 |  | 1 | IRM-30-24 | LH25-10B24 | 0 | -30 |  |
| 80 | MF 컨덴서 | MF100 | 0.1uF |  | 1 | MF_104_FILKOR | {Part No} | 0 | -30 |  |
| 81 | MF 컨덴서 | MF500, MF501 | 104/400v |  | 2 | MF_104_FILKOR | {Part No} | 0 | -60 |  |
| 82 | Test Point_top |  | TP_KEYSTONE_5000 | C5000 | 82 | TP_KEYSTONE_5000 |  |  | -100 | 0 |
|  |  |  | - 재고만 부탁합니다. | 칩 저항, 칩 콘덴서는 REEL단위 구매 |  |  |  |  |  |  |
