seokipo/H2_Control_Board/graphify-out/converted/LT 10kW Compact_IO list_3dfe5e36.md

<!-- converted from LT 10kW Compact_IO list.xlsx -->

## Sheet: 10k SYS IO_List 260224
| Num | Category | Slot number | IO type | IO Category | IO Box Category | IO Num | Part IO Num |  | IO Name | IO Number | Proto device
IO Masking | 비고 | Described | Naming | C | partr Link | 실제값 | 실제 
단위 | 제어값 | 제어
단위 |
| --- | --- | --- | --- | --- | --- | --- | --- | --- | --- | --- | --- | --- | --- | --- | --- | --- | --- | --- | --- | --- |
| 1 | Commu, | 1 | Serial | RS | 485 | 1 | RS 485 1 |  | INV | 506 | INV506 |  | 인버터 데이터 통신 |  | PC (COM1) 연결 |  |  |  |  |  |
| 2 | Commu, | 1 | Serial | RS | 232 | 2 | RS 232 2 |  | MFC | 131 | MFC131 | 232 to 485 | PNG MFC 통신 |  | PC (COM2) 연결, MAC ID :1, (RS485 TO RS232 컨버터 사용) |  | 0~50 | LPM |  |  |
| 3 | Commu, | 1 | Serial | RS | 232 | 3 | RS 232 3 |  | MFC | 121 | MFC121 | 232 to 485 | BNG MFC 통신 |  | PC (COM3) 연결, MAC ID :1, (RS485 TO RS232 컨버터 사용) |  | 0~30 | LPM |  |  |
| 4 | Commu, | 1 | Serial | RS | 232 | 4 | RS 232 4 |  | HMI |  | HMI |  | RoomCon,시스템 제어 |  | PC (COM4) 연결 |  |  |  |  |  |
| 5 | Commu, | 1 | Serial | RS | 232 | 5 | RS 232 5 |  | FM | 333 | FM333 | 232 to 485 | DI 개질수 데이터 통신 |  | PC (COM5) 연결 (RS485 TO RS232 컨버터 사용) |  |  |  |  |  |
| 6 | Commu, | 1 | Serial | RS | 232 | 6 | RS 232 6 |  | Controller |  | Controller |  | 제어기 |  | PC (COM6) 연결 |  |  |  |  |  |
| 7 | Commu, | 1 | Serial | RS | 485 | 7 | RS 485 7 |  | CVM |  | CVM | USB to 485 | 스택 Cell 전압 측정 |  | PC (COM7) 연결 (RS485 TO USB 컨버터 사용) |  |  |  |  |  |
| 8 | Commu, | 1 | Serial | RS | 485 | 8 | RS 485 8 |  | MFC |  | MFC | USB to 485 | 순수소 운전 |  | PC (COM8) 연결 (RS485 TO USB 컨버터 사용) |  |  |  |  |  |
| 9 | TC | 2 | TC-K type | TC | A | 0 | TC A 0 |  | TC | 180 | TC180 | K | Ref-BN |  |  |  |  |  |  |  |
| 10 | TC | 2 | TC-K type | TC | A | 1 | TC A 1 |  | TC | 181 | TC181 | K | Ref-SR1 |  |  |  |  |  |  |  |
| 11 | TC | 2 | TC-K type | TC | A | 2 | TC A 2 |  | TC | 182 | TC182 | K | Ref-SR2 |  |  |  |  |  |  |  |
| 12 | TC | 2 | TC-K type | TC | A | 3 | TC A 3 |  | TC | 183 | TC183 | K | Ref-SR3 |  |  |  |  |  |  |  |
| 13 | TC | 2 | TC-K type | TC | A | 4 | TC A 4 |  | TC | 184 | TC184 | K | Ref-LTS1 |  |  |  |  |  |  |  |
| 14 | TC | 2 | TC-K type | TC | A | 5 | TC A 5 |  | TC | 185 | TC185 | K | Ref-LTS2 |  |  |  |  |  |  |  |
| 15 | TC | 2 | TC-K type | TC | A | 6 | TC A 6 |  | TC | 186 | TC186 | K | Ref-RG |  |  |  |  |  |  |  |
| 16 | TC | 2 | TC-K type | TC | A | 7 | TC A 7 |  | TC | 187 | TC187 | K | Ref-EG |  |  |  |  |  |  |  |
| 17 | TC | 2 | TC-K type | TC | A | 8 | TC A 8 |  | TC | 188 | TC188 | K | Prox-01 |  |  |  |  |  |  |  |
| 18 | TC | 2 | TC-K type | TC | A | 9 | TC A 9 |  | TC | 189 | TC189 | K | Prox-02 |  |  |  |  |  |  |  |
| 19 | TC | 2 | TC-T type | TC | A | 10 | TC A 10 |  | TC | 190 | TC190 | K | Prox-03 |  |  |  |  |  |  |  |
| 20 | TC | 2 | TC-T type | TC | A | 11 | TC A 11 |  |  |  |  |  |  |  |  |  |  |  |  |  |
| 21 | TC | 2 | TC-T type | TC | A | 12 | TC A 12 |  |  |  |  |  |  |  |  |  |  |  |  |  |
| 22 | TC | 2 | TC-T type | TC | A | 13 | TC A 13 |  |  |  |  |  |  |  |  |  |  |  |  |  |
| 23 | TC | 2 | TC-T type | TC | A | 14 | TC A 14 |  |  |  |  |  |  |  |  |  |  |  |  |  |
| 24 | TC | 2 | TC-T type | TC | A | 15 | TC A 15 |  |  |  |  |  |  |  |  |  |  |  |  |  |
| 25 | TC | 2 | TC-T type | TC | A | 16 | TC A 16 |  |  |  |  |  |  |  |  |  |  |  |  |  |
| 26 | TC | 2 | TC-T type | TC | A | 17 | TC A 17 |  |  |  |  |  |  |  |  |  |  |  |  |  |
| 27 | TC | 2 | TC-T type | TC | A | 18 | TC A 18 |  |  |  |  |  |  |  |  |  |  |  |  |  |
| 28 | TC | 2 | TC-T type | TC | A | 19 | TC A 19 |  |  |  |  |  |  |  |  |  |  |  |  |  |
| 29 | TC | 2 | TC-K type | TC | B | 0 | TC B 0 |  | TC | 105 | TC105 | T | 시티가스 공급온도 확인 |  |  |  |  |  |  |  |
| 30 | TC | 2 | TC-K type | TC | B | 1 | TC B 1 |  | TC | 125 | TC125 | T | 개질기 버너 역화 온도 측정 |  |  |  |  |  |  |  |
| 31 | TC | 2 | TC-K type | TC | B | 2 | TC B 2 |  | TC | 146 | TC146 | T | 개질가스 온도 측정 |  |  |  |  |  |  |  |
| 32 | TC | 2 | TC-K type | TC | B | 3 | TC B 3 |  | TC | 151 | TC151 | T | 개질 가스 온도 측정 |  |  |  |  |  |  |  |
| 33 | TC | 2 | TC-K type | TC | B | 4 | TC B 4 |  | TC | 167 | TC167 | T | AOG 버너 입구 온도측정 |  |  |  |  |  |  |  |
| 34 | TC | 2 | TC-K type | TC | B | 5 | TC B 5 |  | TC | 174 | TC174 | T | 배기가스 온도 측정 |  |  |  |  |  |  |  |
| 35 | TC | 2 | TC-K type | TC | B | 6 | TC B 6 |  | TC | 214 | TC214 | T | Cathode 입구 온도 |  |  |  |  |  |  |  |
| 36 | TC | 2 | TC-K type | TC | B | 7 | TC B 7 |  | TC | 215 | TC215 | T | STACK 1 Cathode 입구 출구 |  |  |  |  |  |  |  |
| 37 | TC | 2 | TC-K type | TC | B | 8 | TC B 8 |  | TC | 303 | TC303 | T | 초순수 탱크 공급 온도 |  |  |  |  |  |  |  |
| 38 | TC | 2 | TC-K type | TC | B | 9 | TC B 9 |  | TC | 316 | TC316 | T | STACK 1 냉각수 출구 온도 |  |  |  |  |  |  |  |
| 39 | TC | 2 | TC-T type | TC | B | 10 | TC B 10 |  | TC | 318 | TC318 | T | STACK 1 냉각수 회수 온도 |  |  |  |  |  |  |  |
| 40 | TC | 2 | TC-T type | TC | B | 11 | TC B 11 |  | TC | 326 | TC326 | T | STACK 2 냉각수 출구 온도 |  |  |  |  |  |  |  |
| 41 | TC | 2 | TC-T type | TC | B | 12 | TC B 12 |  | TC | 328 | TC328 | T | STACK 2 냉각수 회수 온도 |  |  |  |  |  |  |  |
| 42 | TC | 2 | TC-T type | TC | B | 13 | TC B 13 |  | TC | 348 | TC348 | T | DI 응축수 온도 |  |  |  |  |  |  |  |
| 43 | TC | 2 | TC-T type | TC | B | 14 | TC B 14 |  | TC | 402 | TC402 | T | 시스템 냉각수 탱크 상부 온도 |  |  |  |  |  |  |  |
| 44 | TC | 2 | TC-T type | TC | B | 15 | TC B 15 |  | TC | 403 | TC403 | T | 시스템 냉각수 탱크 하부 온도 |  |  |  |  |  |  |  |
| 45 | TC | 2 | TC-T type | TC | B | 16 | TC B 16 |  | TC | 413 | TC413 | T | 시스템 배열 회수 온도 |  |  |  |  |  |  |  |
| 46 | TC | 2 | TC-T type | TC | B | 17 | TC B 17 |  | TC | 425 | TC425 | T | 외부 냉각수 입구 온도 |  |  |  |  |  |  |  |
| 47 | TC | 2 | TC-T type | TC | B | 18 | TC B 18 |  | TC | 426 | TC426 | T | 외부 냉각수 출구 온도 |  |  |  |  |  |  |  |
| 48 | TC | 2 | TC-T type | TC | B | 19 | TC B 19 |  | TC | 507 | TC507 | T | 시스템 내부 온도 |  |  |  |  |  |  |  |
| 49 | AI | #04 | Current | AI | A | 0 | AI A 0 |  | PT | 104 | PT104 |  | 유틸리티 압력 확인용 |  | PSCD0005RAPG |  | 0~5 | kPa | 1~5  | V |
| 50 | AI | 4 | Current | AI | A | 1 | AI A 1 |  | PT | 110 | PT110 |  | 가스 버퍼탱크 압력 확인용 |  | PSS-01V-R1/8 | https://www.autonics.com/kr/model/PSS-01V-R18 | 0~100 | kPa | 1~5  | V |
| 51 | AI | 4 | Current | AI | A | 2 | AI A 2 |  | PT | 124 | PT124 |  | 개질기 버너 압력 확인용 |  | PSS-01V-R1/8 | https://www.autonics.com/kr/model/PSS-01V-R19 | 0~100 | kPa | 1~5  | V |
| 52 | AI | 4 | Current | AI | A | 3 | AI A 3 |  | PT | 134 | PT134 |  | 개질기 촉매부 압력 확인 |  | PSS-01V-R1/8 | https://www.autonics.com/kr/model/PSS-01V-R20 | 0~100 | kPa | 1~5  | V |
| 53 | AI | 4 | Current | AI | A | 4 | AI A 4 |  | PT | 145 | PT145 |  | 개질가스 압력 측정 |  | PT201H-G01B-HT |  | 0~100 | kPa | 1~5  | V |
| 54 | AI | 4 | Current | AI | A | 5 | AI A 5 |  | PT | 153 | PT153 |  | STACK 1 Anode 입구 압력 측정 |  | PT201H-G01B |  | 0~100 | kPa | 1~5  | V |
| 55 | AI | 4 | Current | AI | A | 6 | AI A 6 |  | PT | 154 | PT154 | Test 후 1번 통합 | STACK 2 Anode 입구 압력 측정 |  | PT201H-G01B |  | 0~100 | kPa | 1~5  | V |
| 56 | AI | 4 | Current | AI | A | 7 | AI A 7 |  | PT | 175 | PT175 |  | 배기가스 압력 측정 |  | PSS-01V-R1/8 | https://www.autonics.com/kr/model/PSS-01V-R20 | 0~100 | kPa | 1~5  | V |
| 57 | AI | #04 | Current | AI | A | 8 | AI A 8 |  | FM | 211 | FM211 |  | STACK 공기 유량계 | scC | PFMB7202-06-C |  | 0~800 | LPM | 1~5  | V |
| 58 | AI | 4 | Current | AI | A | 9 | AI A 9 |  | FM | 231 | FM231 |  | PrOx 공기 유량계 |  | PFM710-01-C |  | 0~10 | LPM | 1~5  | V |
| 59 | AI | 4 | Current | AI | A | 10 | AI A 10 |  | FM | 241 | FM241 |  | 개질기 버너 공기 유량계 |  | PFMB7202-06-C |  | 0~400 | LPM | 1~5  | V |
| 60 | AI | 4 | Current | AI | A | 11 | AI A 11 |  | CS | 302 | CS302 |  | DI 탱크 전도도 센서 |  | CM-230K |  | 0.5~200 | us/s | 1~5  | V |
| 61 | AI | 4 | Current | AI | A | 12 | AI A 12 |  | PT | 315 | PT315 |  | STACK 1 냉각수 입구 압력 확인 |  | PT201H-G01B |  | 0~100 kPa | kPa | 1~5  | V |
| 62 | AI | 4 | Current | AI | A | 13 | AI A 13 |  | PT | 325 | PT325 |  | STACK 2 냉각수 입구 압력 확인 |  | PT201H-G01B |  | 0~100 kPa | kPa | 1~5  | V |
| 63 | AI | 4 | Current | AI | A | 14 | AI A 14 |  | PT | 335 | PT335 |  | 개질수 압력측정 |  | PSAN-L1CPV |  | 0~1000 kPa | kPa | 1~5  | V |
| 64 | AI | 4 | Current | AI | A | 15 | AI A 15 |  | CS | 347 | CS347 |  | 재순환 탱크 전도도 센서 |  | CM-230K |  | 0.5~200 | us/s | 1~5  | V |
| 65 | AO | 6 | Voltage | AO | A | 00 | AO A 00 |  | AB | 212 | AB212 | 스택 | Stack Air Blower |  | feedback => FM211(AI A 8) ,  |  |  |  | 0~5  | V |
| 66 | AO | 6 | Voltage | AO | A | 01 | AO A 01 |  | P | 312 | P312 | 스택 | STACK 1 냉각수 공급 |  | feedback => FM314(Counter A 3) , INTG3-140 |  |  |  | 0~5  | V |
| 67 | AO | 6 | Voltage | AO | A | 02 | AO A 02 |  | P | 322 | P322 | 스택 | STACK 2 냉각수 공급 |  | feedback => FM324(Counter A 4) , INTG3-140 |  |  |  | 0~5  | V |
| 68 | AO | 6 | Voltage | AO | A | 03 | AO A 03 |  |  |  |  |  |  |  |  |  |  |  |  |  |
| 69 | AO | 6 | Voltage | AO | A | 04 | AO A 04 |  | P | 432 | P432 | 스택 | 개질 가스 열교환 냉각수 공급 |  | feedback => TC151(TC B 3) , INTG3-140 |  |  |  | 0~5  | V |
| 70 | AO | 6 | Voltage | AO | A | 05 | AO A 05 |  | P | 442 | P442 | 스택 | STACK 열교환기 냉각수 공급 펌프 |  | feedback => TC318(TC B 10) , INTG3-140 |  |  |  | 0~5  | V |
| 71 | AO | 6 | Voltage | AO | A | 06 | AO A 06 |  |  |  |  |  |  |  |  |  |  |  |  |  |
| 72 | AO | 6 | Voltage | AO | A | 07 | AO A 07 |  | INV | ADJ | INVADJ | 시스템 | INV CC 제어 |  |  |  |  |  | 0~5  | V |
| 73 | AO | 6 | Voltage | AO | A | 08 | AO A 08 |  | AB | 242 | AB242 | 개질기 | Burner Air Blower |  | feedback => FM241(AI A 10) , VRB8-25-48 |  |  |  | 0~5  | V |
| 74 | AO | 6 | Voltage | AO | A | 09 | AO A 09 |  | AB | 232 | AB232 | 개질기 | PrOx Air Pump |  | feedback => FM231(AI A 9) , NMP850.1.2KPDCB-4 HP |  |  |  | 0~5  | V |
| 75 | AO | 6 | Voltage | AO | A | 10 | AO A 10 |  |  |  |  |  |  |  |  |  |  |  |  |  |
| 76 | AO | 6 | Voltage | AO | A | 11 | AO A 11 |  | P | 108 | P108 | P108 / P109
 병렬 운전 | NG Pump |  | feedback => PT110(AI A 1) , PM33098-838.1.2 |  |  |  | 0~5  | V |
| 77 | AO | 6 | Voltage | AO | A | 12 | AO A 12 |  | P | 109 | P109 |  | NG Pump(AO A 11과 동일 신호 적용) |  |  |  |  |  | 0~5  | V |
| 78 | AO | 6 | Voltage | AO | A | 13 | AO A 13 |  |  |  |  |  |  |  |  |  |  |  |  |  |
| 79 | AO | 6 | Voltage | AO | A | 14 | AO A 14 |  | P | 332 | P332 | 개질기 | 개질수 펌프 |  | feedback => FM333(RS232 COM5) , GA-V21-DEMSE |  |  |  | 0~5  | V |
| 80 | AO | 6 | Voltage | AO | A | 15 | AO A 15 |  | P | 422 | P422 | 개질기 | 시스탬 열교환기 냉각수 공급 |  | feedback => TC174(TC B 5) , INTG3-140 |  |  |  | 0~5  | V |
| 81 | DI | 7 | Voltage | DI | A | 0 | DI A 0 |  | FD | 508 | FD508 |  | 버너 화염감지기 |  |  |  |  |  | 0 or 24 | V |
| 82 | DI | 7 | Voltage | DI | A | 1 | DI A 1 |  | FAN | 503 | FAN503 |  | 환기팬1 |  |  |  |  |  | 0 or 24 | V |
| 83 | DI | 7 | Voltage | DI | A | 2 | DI A 2 |  |  |  |  |  |  |  |  |  |  |  |  |  |
| 84 | DI | 7 | Voltage | DI | A | 3 | DI A 3 |  |  |  |  |  |  |  |  |  |  |  |  |  |
| 85 | DI | 7 | Voltage | DI | A | 4 | DI A 4 |  |  |  |  |  |  |  |  |  |  |  |  |  |
| 86 | DI | 7 | Voltage | DI | A | 5 | DI A 5 |  | GD | 504 | GD504 |  | 메탄누출감지 |  |  |  |  |  |  |  |
| 87 | DI | 7 | Voltage | DI | A | 6 | DI A 6 |  | GD | 505 | GD505 |  | 수소누출감지 |  |  |  |  |  | 0 or 24 | V |
| 88 | DI | 7 | Voltage | DI | A | 7 | DI A 7 |  |  |  |  |  |  |  |  |  |  |  | 0 or 24 | V |
| 89 | DI | 7 | Voltage | DI | A | 8 | DI A 8 |  |  |  |  |  |  |  |  |  |  |  |  |  |
| 90 | DI | 7 | Voltage | DI | A | 9 | DI A 9 |  |  |  |  |  |  |  |  |  |  |  |  |  |
| 91 | DI | 7 | Voltage | DI | A | 10 | DI A 10 |  |  |  |  |  |  |  |  |  |  |  |  |  |
| 92 | DI | 7 | Voltage | DI | A | 11 | DI A 11 |  |  |  |  |  |  |  |  |  |  |  |  |  |
| 93 | DI | 7 | Voltage | DI | A | 12 | DI A 12 |  |  |  |  |  |  |  |  |  |  |  |  |  |
| 94 | DI | 7 | Voltage | DI | A | 13 | DI A 13 |  |  |  |  |  |  |  |  |  |  |  |  |  |
| 95 | DI | 7 | Voltage | DI | A | 14 | DI A 14 |  |  |  |  |  |  |  |  |  |  |  |  |  |
| 96 | DI | 7 | Voltage | DI | A | 15 | DI A 15 |  | TJ- | sig | TJ-sig | 테스트용 | 내구성 평가용 지그 신호 (별도 구성) |  |  |  |  |  | 0 or 24 | V |
| 97 | DI | 7 | Voltage | Counter | A | 0 | Counter A 0 |  |  |  |  |  |  |  |  |  |  |  |  |  |
| 98 | DI | 7 | Voltage | Counter | A | 1 | Counter A 1 |  |  |  |  |  |  |  |  |  |  |  |  |  |
| 99 | DI | 7 | Voltage | Counter | A | 2 | Counter A 2 |  | FM | 444 | FM444 |  | 외부 냉각수 회수 유량 확인 |  |  |  | 3~50 | LPM | 18.6 | ml/P |
| 100 | DI | 7 | Voltage | Counter | A | 3 | Counter A 3 |  | FM | 314 | FM314 |  | STACK 1 냉각수 유량 확인 |  |  |  | 3~50 | LPM | 18.6 | ml/P |
| 101 | DI | 7 | Voltage | Counter | A | 4 | Counter A 4 |  | FM | 324 | FM324 |  | STACK 2 냉각수 유량 확인 |  |  |  | 3~50 | LPM | 18.6 | ml/P |
| 102 | DI | 7 | Voltage | Counter | A | 5 | Counter A 5 |  | FM | 408 | FM408 |  | 시스템 배열 회수 유량 확인 |  |  |  | 3~50 | LPM | 18.6 | ml/P |
| 103 | DO | 8 | Voltage | DO | A | 0 | DO A 0 |  | SV | 102 | SV102 | P com1 | 가스 인입밸브 1 |  |  |  |  |  | 0 or 24 | V |
| 104 | DO | 8 | Voltage | DO | A | 1 | DO A 1 |  | SV | 103 | SV103 | P com2 | 가스 인입밸브 2 |  |  |  |  |  | 0 or 24 | V |
| 105 | DO | 8 | Voltage | DO | A | 2 | DO A 2 |  | SV | 152 | SV152 | P com3 | ANODE 인입 밸브 |  |  |  |  |  | 0 or 24 | V |
| 106 | DO | 8 | Voltage | DO | A | 3 | DO A 3 |  | HT | 193 | HT193 | P com4 | LTS 촉매 히터 1 |  |  |  |  |  | 0 or 24 | V |
| 107 | DO | 8 | Voltage | DO | A | 4 | DO A 4 |  | HT | 194 | HT194 | P com5 | LTS 촉매 히터 2 |  |  |  |  |  | 0 or 24 | V |
| 108 | DO | 8 | Voltage | DO | A | 5 | DO A 5 |  | SV | 304 | SV304 | P com6 | DI 탱크 배수 솔레노이드 밸브 |  |  |  |  |  | 0 or 24 | V |
| 109 | DO | 8 | Voltage | DO | A | 6 | DO A 6 |  | SV | 306 | SV306 | P com7 | 배기 응축수 드레인 솔레노이드 밸브 |  |  |  |  |  | 0 or 24 | V |
| 110 | DO | 8 | Voltage | DO | A | 7 | DO A 7 |  | P | 346 | P346 | P com8 | DI 필터링 펌프 |  |  |  |  |  | 0 or 24 | V |
| 111 | DO | 8 | Voltage | DO | A | 8 | DO A 8 |  | INV  | RUN | INV RUN | P com9 | 인버터 RUN |  |  |  |  |  | 0 or 24 | V |
| 112 | DO | 8 | Voltage | DO | A | 9 | DO A 9 |  | P | 412 | P412 | P com10 | RG 열교환기 냉각수 공급 |  |  |  |  |  | 0 or 24 | V |
| 113 | DO | 8 | Voltage | DO | A | 10 | DO A 10 |  | P | 343 | P343 | P com11 | 수자립 펌프 |  |  |  |  |  | 0 or 24 | V |
| 114 | DO | 8 | Voltage | DO | A | 11 | DO A 11 |  |  |  |  |  |  |  |  |  |  |  |  |  |
| 115 | DO | 8 | Voltage | DO | A | 12 | DO A 12 |  |  |  |  |  |  |  |  |  |  |  |  |  |
| 116 | DO | 8 | Voltage | DO | A | 13 | DO A 13 |  |  |  |  |  |  |  |  |  |  |  |  |  |
| 117 | DO | 8 | Voltage | DO | A | 14 | DO A 14 |  | SV | 501 | SV501 | P com15 | 개질기 질소퍼지 솔레노이드 밸브 |  |  |  |  |  | 0 or 24 | V |
| 118 | DO | 8 | Voltage | DO | A | 15 | DO A 15 |  | SV | 502 | SV502 | P com16 | 스택 질소퍼지 솔레노이드 밸브 |  |  |  |  |  | 0 or 24 | V |
| 119 | DO | 8 | Voltage | DO | A | 16 | DO A 16 |  | BV | 123 | BV123 | N com1 | BNG 전동 밸브 |  |  |  |  |  | 0 or 24 | V |
| 120 | DO | 8 | Voltage | DO | A | 17 | DO A 17 |  | BV | 133 | BV133 | N com2 | PNG 전동 밸브 |  |  |  |  |  | 0 or 24 | V |
| 121 | DO | 8 | Voltage | DO | A | 18 | DO A 18 |  | BV | 155 | BV155 | N com3 | 개질가스 우회로 전동밸브 |  |  |  |  |  | 0 or 24 | V |
| 122 | DO | 8 | Voltage | DO | A | 19 | DO A 19 |  | BV | 161 | BV161 | N com4 | Anode 출구 전동 밸브 |  |  |  |  |  | 0 or 24 | V |
| 123 | DO | 8 | Voltage | DO | A | 20 | DO A 20 |  | BV | 166 | BV166 | N com5 | AOG 전동 밸브 |  |  |  |  |  | 0 or 24 | V |
| 124 | DO | 8 | Voltage | DO | A | 21 | DO A 21 |  | BV | 169 | BV169 | N com6 | AOG VENT 전동 밸브 |  |  |  |  |  | 0 or 24 | V |
| 125 | DO | 8 | Voltage | DO | A | 22 | DO A 22 |  | BV | 407 | BV407 | N com7 | 시스템 냉각수 탱크 드레인 벨브 |  |  |  |  |  | 0 or 24 | V |
| 126 | DO | 8 | Voltage | DO | A | 23 | DO A 23 |  | BV | 410 | BV410 | N com8 | 시설수 공급 밸브 |  |  |  |  |  | 0 or 24 | V |
| 127 | DO | 8 | Voltage | DO | A | 24 | DO A 24 |  | MC |  SW | MC SW | AC R com1 | MC 동작 스위치 |  |  |  |  |  | 0 or 24 | V |
| 128 | DO | 8 | Voltage | DO | A | 25 | DO A 25 |  | IGN | 192 | IGN192 | AC R com4 | 점화 트랜스 |  |  |  |  |  | 0 or 24 | V |
| 129 | DO | 8 | Voltage | DO | A | 26 | DO A 26 |  | HT | 198 | HT198 | AC R com2 | Prox 촉매 히터 1 |  |  |  |  |  | 0 or 24 | V |
| 130 | DO | 8 | Voltage | DO | A | 27 | DO A 27 |  | HT | 199 | HT199 | AC R com3 | Prox 촉매 히터 2 |  |  |  |  |  | 0 or 24 | V |
| 131 | DO | 8 | Voltage | DO | A | 28 | DO A 28 |  |  |  |  | AC R com2 |  |  |  |  |  |  |  |  |
| 132 | DO | 8 | Voltage | DO | A | 29 | DO A 29 |  |  |  |  | AC R com3 |  |  |  |  |  |  |  |  |
| 133 | DO | 8 | Voltage | DO | A | 30 | DO A 30 |  |  |  |  | AC R com7 |  |  |  |  |  |  |  |  |
| 134 | DO | 8 | Voltage | DO | A | 31 | DO A 31 |  |  |  |  | AC R com8 |  |  |  |  |  |  |  |  |
|  |  |  |  |  |  |  |  |  |  |  | #NAME? |  |  |  |  |  |  |  |  |  |
|  |  |  |  |  |  |  |  |  |  |  | #NAME? |  |  |  |  |  |  |  |  |  |
|  |  |  |  |  |  |  |  |  |  |  | #NAME? |  |  |  |  |  |  |  |  |  |
|  |  |  |  |  |  |  |  |  |  |  | #NAME? |  |  |  |  |  |  |  |  |  |
|  |  |  |  |  |  |  |  |  |  |  | #NAME? |  |  |  |  |  |  |  |  |  |
|  |  |  |  |  |  |  |  |  |  |  | #NAME? |  |  |  |  |  |  |  |  |  |
## Sheet: Alpha
| Num | Category | Slot number | IO type | IO Category | IO Box Category | IO Num | Part IO Num |  | IO Name | IO Number | Proto device
IO Masking | 비고 | Described | Naming | Remark | 실제값 | 실제 
단위 | 제어값 | 제어
단위 |
| --- | --- | --- | --- | --- | --- | --- | --- | --- | --- | --- | --- | --- | --- | --- | --- | --- | --- | --- | --- |
| 1 | Commu, | 1 | Serial | RS | 485 | 1 | RS 485 1 |  |  |  |  |  |  |  | PC (COM1) 연결 |  |  |  |  |
| 2 | Commu, | 1 | Serial | RS | 232 | 2 | RS 232 2 |  |  |  |  |  |  |  | PC (COM2) 연결, MAC ID :1, (RS485 TO RS232 컨버터 사용) | 0~50 | LPM |  |  |
| 3 | Commu, | 1 | Serial | RS | 232 | 3 | RS 232 3 |  |  |  |  |  |  |  | PC (COM3) 연결, MAC ID :1, (RS485 TO RS232 컨버터 사용) | 0~30 | LPM |  |  |
| 4 | Commu, | 1 | Serial | RS | 232 | 4 | RS 232 4 |  |  |  |  |  |  |  | PC (COM4) 연결 |  |  |  |  |
| 5 | Commu, | 1 | Serial | RS | 232 | 5 | RS 232 5 |  |  |  |  |  |  |  | PC (COM5) 연결 (RS485 TO RS232 컨버터 사용) |  |  |  |  |
| 6 | Commu, | 1 | Serial | RS | 232 | 6 | RS 232 6 |  |  |  |  |  |  |  | PC (COM6) 연결 |  |  |  |  |
| 7 | Commu, | 1 | Serial | RS | 485 | 7 | RS 485 7 |  |  |  |  |  |  |  | PC (COM7) 연결 (RS485 TO USB 컨버터 사용) |  |  |  |  |
| 8 | Commu, | 1 | Serial | RS | 485 | 8 | RS 485 8 |  |  |  |  |  |  |  | PC (COM8) 연결 (RS485 TO USB 컨버터 사용) |  |  |  |  |
| 9 | TC | 2 | TC-K type | TC | A | 0 | TC A 0 |  |  |  |  |  |  |  |  |  |  |  |  |
| 10 | TC | 2 | TC-K type | TC | A | 1 | TC A 1 |  |  |  |  |  |  |  |  |  |  |  |  |
| 11 | TC | 2 | TC-K type | TC | A | 2 | TC A 2 |  |  |  |  |  |  |  |  |  |  |  |  |
| 12 | TC | 2 | TC-K type | TC | A | 3 | TC A 3 |  |  |  |  |  |  |  |  |  |  |  |  |
| 13 | TC | 2 | TC-K type | TC | A | 4 | TC A 4 |  |  |  |  |  |  |  |  |  |  |  |  |
| 14 | TC | 2 | TC-K type | TC | A | 5 | TC A 5 |  |  |  |  |  |  |  |  |  |  |  |  |
| 15 | TC | 2 | TC-K type | TC | A | 6 | TC A 6 |  |  |  |  |  |  |  |  |  |  |  |  |
| 16 | TC | 2 | TC-K type | TC | A | 7 | TC A 7 |  |  |  |  |  |  |  |  |  |  |  |  |
| 17 | TC | 2 | TC-K type | TC | A | 8 | TC A 8 |  |  |  |  |  |  |  |  |  |  |  |  |
| 18 | TC | 2 | TC-K type | TC | A | 9 | TC A 9 |  |  |  |  |  |  |  |  |  |  |  |  |
| 19 | TC | 2 | TC-T type | TC | A | 10 | TC A 10 |  |  |  |  |  |  |  |  |  |  |  |  |
| 20 | TC | 2 | TC-T type | TC | A | 11 | TC A 11 |  |  |  |  |  |  |  |  |  |  |  |  |
| 21 | TC | 2 | TC-T type | TC | A | 12 | TC A 12 |  |  |  |  |  |  |  |  |  |  |  |  |
| 22 | TC | 2 | TC-T type | TC | A | 13 | TC A 13 |  |  |  |  |  |  |  |  |  |  |  |  |
| 23 | TC | 2 | TC-T type | TC | A | 14 | TC A 14 |  |  |  |  |  |  |  |  |  |  |  |  |
| 24 | TC | 2 | TC-T type | TC | A | 15 | TC A 15 |  |  |  |  |  |  |  |  |  |  |  |  |
| 25 | TC | 2 | TC-T type | TC | A | 16 | TC A 16 |  |  |  |  |  |  |  |  |  |  |  |  |
| 26 | TC | 2 | TC-T type | TC | A | 17 | TC A 17 |  |  |  |  |  |  |  |  |  |  |  |  |
| 27 | TC | 2 | TC-T type | TC | A | 18 | TC A 18 |  |  |  |  |  |  |  |  |  |  |  |  |
| 28 | TC | 2 | TC-T type | TC | A | 19 | TC A 19 |  |  |  |  |  |  |  |  |  |  |  |  |
| 29 | TC | 2 | TC-K type | TC | B | 0 | TC B 0 |  |  |  |  |  |  |  |  |  |  |  |  |
| 30 | TC | 2 | TC-K type | TC | B | 1 | TC B 1 |  |  |  |  |  |  |  |  |  |  |  |  |
| 31 | TC | 2 | TC-K type | TC | B | 2 | TC B 2 |  |  |  |  |  |  |  |  |  |  |  |  |
| 32 | TC | 2 | TC-K type | TC | B | 3 | TC B 3 |  |  |  |  |  |  |  |  |  |  |  |  |
| 33 | TC | 2 | TC-K type | TC | B | 4 | TC B 4 |  |  |  |  |  |  |  |  |  |  |  |  |
| 34 | TC | 2 | TC-K type | TC | B | 5 | TC B 5 |  |  |  |  |  |  |  |  |  |  |  |  |
| 35 | TC | 2 | TC-K type | TC | B | 6 | TC B 6 |  |  |  |  |  |  |  |  |  |  |  |  |
| 36 | TC | 2 | TC-K type | TC | B | 7 | TC B 7 |  |  |  |  |  |  |  |  |  |  |  |  |
| 37 | TC | 2 | TC-K type | TC | B | 8 | TC B 8 |  |  |  |  |  |  |  |  |  |  |  |  |
| 38 | TC | 2 | TC-K type | TC | B | 9 | TC B 9 |  |  |  |  |  |  |  |  |  |  |  |  |
| 39 | TC | 2 | TC-T type | TC | B | 10 | TC B 10 |  |  |  |  |  |  |  |  |  |  |  |  |
| 40 | TC | 2 | TC-T type | TC | B | 11 | TC B 11 |  |  |  |  |  |  |  |  |  |  |  |  |
| 41 | TC | 2 | TC-T type | TC | B | 12 | TC B 12 |  |  |  |  |  |  |  |  |  |  |  |  |
| 42 | TC | 2 | TC-T type | TC | B | 13 | TC B 13 |  |  |  |  |  |  |  |  |  |  |  |  |
| 43 | TC | 2 | TC-T type | TC | B | 14 | TC B 14 |  |  |  |  |  |  |  |  |  |  |  |  |
| 44 | TC | 2 | TC-T type | TC | B | 15 | TC B 15 |  |  |  |  |  |  |  |  |  |  |  |  |
| 45 | TC | 2 | TC-T type | TC | B | 16 | TC B 16 |  |  |  |  |  |  |  |  |  |  |  |  |
| 46 | TC | 2 | TC-T type | TC | B | 17 | TC B 17 |  |  |  |  |  |  |  |  |  |  |  |  |
| 47 | TC | 2 | TC-T type | TC | B | 18 | TC B 18 |  |  |  |  |  |  |  |  |  |  |  |  |
| 48 | TC | 2 | TC-T type | TC | B | 19 | TC B 19 |  |  |  |  |  |  |  |  |  |  |  |  |
| 49 | AI | #04 | Current | AI | A | 0 | AI A 0 |  |  |  |  |  |  |  | PSCD0005RAPG | 0~5 | kPa | 1~5  | V |
| 50 | AI | 4 | Current | AI | A | 1 | AI A 1 |  |  |  |  |  |  |  | PSS-01V-R1/8 | 0~100 | kPa | 1~5  | V |
| 51 | AI | 4 | Current | AI | A | 2 | AI A 2 |  |  |  |  |  |  |  | PSS-01V-R1/8 | 0~100 | kPa | 1~5  | V |
| 52 | AI | 4 | Current | AI | A | 3 | AI A 3 |  |  |  |  |  |  |  | PSS-01V-R1/8 | 0~100 | kPa | 1~5  | V |
| 53 | AI | 4 | Current | AI | A | 4 | AI A 4 |  |  |  |  |  |  |  | PT201H-G01B-HT | 0~100 | kPa | 1~5  | V |
| 54 | AI | 4 | Current | AI | A | 5 | AI A 5 |  |  |  |  |  |  |  | PT201H-G01B | 0~100 | kPa | 1~5  | V |
| 55 | AI | 4 | Current | AI | A | 6 | AI A 6 |  |  |  |  |  |  |  | PT201H-G01B | 0~100 | kPa | 1~5  | V |
| 56 | AI | 4 | Current | AI | A | 7 | AI A 7 |  |  |  |  |  |  |  | PSS-01V-R1/8 | 0~100 | kPa | 1~5  | V |
| 57 | AI | #04 | Current | AI | A | 8 | AI A 8 |  |  |  |  |  |  |  | PFMB7202-06-C | 0~800 | LPM | 1~5  | V |
| 58 | AI | 4 | Current | AI | A | 9 | AI A 9 |  |  |  |  |  |  |  | PFM710-01-C | 0~10 | LPM | 1~5  | V |
| 59 | AI | 4 | Current | AI | A | 10 | AI A 10 |  |  |  |  |  |  |  | PFMB7202-06-C | 0~400 | LPM | 1~5  | V |
| 60 | AI | 4 | Current | AI | A | 11 | AI A 11 |  |  |  |  |  |  |  | CM-230K | 0.5~200 | us/s | 1~5  | V |
| 61 | AI | 4 | Current | AI | A | 12 | AI A 12 |  |  |  |  |  |  |  | PT201H-G01B | 0~100 kPa | kPa | 1~5  | V |
| 62 | AI | 4 | Current | AI | A | 13 | AI A 13 |  |  |  |  |  |  |  | PT201H-G01B | 0~100 kPa | kPa | 1~5  | V |
| 63 | AI | 4 | Current | AI | A | 14 | AI A 14 |  |  |  |  |  |  |  | PSAN-L1CPV | 0~1000 kPa | kPa | 1~5  | V |
| 64 | AI | 4 | Current | AI | A | 15 | AI A 15 |  |  |  |  |  |  |  | CM-230K | 0.5~200 | us/s | 1~5  | V |
| 65 | AO | 6 | Voltage | AO | A | 00 | AO A 00 |  |  |  |  |  |  |  | feedback => FM211(AI A 8) ,  |  |  | 0~5  | V |
| 66 | AO | 6 | Voltage | AO | A | 01 | AO A 01 |  |  |  |  |  |  |  | feedback => FM314(Counter A 3) , INTG3-140 |  |  | 0~5  | V |
| 67 | AO | 6 | Voltage | AO | A | 02 | AO A 02 |  |  |  |  |  |  |  | feedback => FM324(Counter A 4) , INTG3-140 |  |  | 0~5  | V |
| 68 | AO | 6 | Voltage | AO | A | 03 | AO A 03 |  |  |  |  |  |  |  |  |  |  |  |  |
| 69 | AO | 6 | Voltage | AO | A | 04 | AO A 04 |  |  |  |  |  |  |  | feedback => TC151(TC B 3) , INTG3-140 |  |  | 0~5  | V |
| 70 | AO | 6 | Voltage | AO | A | 05 | AO A 05 |  |  |  |  |  |  |  | feedback => TC318(TC B 10) , INTG3-140 |  |  | 0~5  | V |
| 71 | AO | 6 | Voltage | AO | A | 06 | AO A 06 |  |  |  |  |  |  |  |  |  |  |  |  |
| 72 | AO | 6 | Voltage | AO | A | 07 | AO A 07 |  |  |  |  |  |  |  |  |  |  | 0~5  | V |
| 73 | AO | 6 | Voltage | AO | A | 08 | AO A 08 |  |  |  |  |  |  |  | feedback => FM241(AI A 10) , VRB8-25-48 |  |  | 0~5  | V |
| 74 | AO | 6 | Voltage | AO | A | 09 | AO A 09 |  |  |  |  |  |  |  | feedback => FM231(AI A 9) , NMP850.1.2KPDCB-4 HP |  |  | 0~5  | V |
| 75 | AO | 6 | Voltage | AO | A | 10 | AO A 10 |  |  |  |  |  |  |  |  |  |  |  |  |
| 76 | AO | 6 | Voltage | AO | A | 11 | AO A 11 |  |  |  |  |  |  |  | feedback => PT110(AI A 1) , PM33098-838.1.2 |  |  | 0~5  | V |
| 77 | AO | 6 | Voltage | AO | A | 12 | AO A 12 |  |  |  |  |  |  |  |  |  |  | 0~5  | V |
| 78 | AO | 6 | Voltage | AO | A | 13 | AO A 13 |  |  |  |  |  |  |  |  |  |  |  |  |
| 79 | AO | 6 | Voltage | AO | A | 14 | AO A 14 |  |  |  |  |  |  |  | feedback => FM333(RS232 COM5) , GA-V21-DEMSE |  |  | 0~5  | V |
| 80 | AO | 6 | Voltage | AO | A | 15 | AO A 15 |  |  |  |  |  |  |  | feedback => TC174(TC B 5) , INTG3-140 |  |  | 0~5  | V |
| 81 | DI | 7 | Voltage | DI | A | 0 | DI A 0 |  |  |  |  |  |  |  |  |  |  | 0 or 24 | V |
| 82 | DI | 7 | Voltage | DI | A | 1 | DI A 1 |  |  |  |  |  |  |  |  |  |  | 0 or 24 | V |
| 83 | DI | 7 | Voltage | DI | A | 2 | DI A 2 |  |  |  |  |  |  |  |  |  |  |  |  |
| 84 | DI | 7 | Voltage | DI | A | 3 | DI A 3 |  |  |  |  |  |  |  |  |  |  |  |  |
| 85 | DI | 7 | Voltage | DI | A | 4 | DI A 4 |  |  |  |  |  |  |  |  |  |  |  |  |
| 86 | DI | 7 | Voltage | DI | A | 5 | DI A 5 |  |  |  |  |  |  |  |  |  |  |  |  |
| 87 | DI | 7 | Voltage | DI | A | 6 | DI A 6 |  |  |  |  |  |  |  |  |  |  | 0 or 24 | V |
| 88 | DI | 7 | Voltage | DI | A | 7 | DI A 7 |  |  |  |  |  |  |  |  |  |  | 0 or 24 | V |
| 89 | DI | 7 | Voltage | DI | A | 8 | DI A 8 |  |  |  |  |  |  |  |  |  |  |  |  |
| 90 | DI | 7 | Voltage | DI | A | 9 | DI A 9 |  |  |  |  |  |  |  |  |  |  |  |  |
| 91 | DI | 7 | Voltage | DI | A | 10 | DI A 10 |  |  |  |  |  |  |  |  |  |  |  |  |
| 92 | DI | 7 | Voltage | DI | A | 11 | DI A 11 |  |  |  |  |  |  |  |  |  |  |  |  |
| 93 | DI | 7 | Voltage | DI | A | 12 | DI A 12 |  |  |  |  |  |  |  |  |  |  |  |  |
| 94 | DI | 7 | Voltage | DI | A | 13 | DI A 13 |  |  |  |  |  |  |  |  |  |  |  |  |
| 95 | DI | 7 | Voltage | DI | A | 14 | DI A 14 |  |  |  |  |  |  |  |  |  |  |  |  |
| 96 | DI | 7 | Voltage | DI | A | 15 | DI A 15 |  |  |  |  |  |  |  |  |  |  | 0 or 24 | V |
| 97 | DI | 7 | Voltage | Counter | A | 0 | Counter A 0 |  |  |  |  |  |  |  |  |  |  |  |  |
| 98 | DI | 7 | Voltage | Counter | A | 1 | Counter A 1 |  |  |  |  |  |  |  |  |  |  |  |  |
| 99 | DI | 7 | Voltage | Counter | A | 2 | Counter A 2 |  |  |  |  |  |  |  |  | 3~50 | LPM | 18.6 | ml/P |
| 100 | DI | 7 | Voltage | Counter | A | 3 | Counter A 3 |  |  |  |  |  |  |  |  | 3~50 | LPM | 18.6 | ml/P |
| 101 | DI | 7 | Voltage | Counter | A | 4 | Counter A 4 |  |  |  |  |  |  |  |  | 3~50 | LPM | 18.6 | ml/P |
| 102 | DI | 7 | Voltage | Counter | A | 5 | Counter A 5 |  |  |  |  |  |  |  |  | 3~50 | LPM | 18.6 | ml/P |
| 103 | DO | 8 | Voltage | DO | A | 0 | DO A 0 |  |  |  |  |  |  |  |  |  |  | 0 or 24 | V |
| 104 | DO | 8 | Voltage | DO | A | 1 | DO A 1 |  |  |  |  |  |  |  |  |  |  | 0 or 24 | V |
| 105 | DO | 8 | Voltage | DO | A | 2 | DO A 2 |  |  |  |  |  |  |  |  |  |  | 0 or 24 | V |
| 106 | DO | 8 | Voltage | DO | A | 3 | DO A 3 |  |  |  |  |  |  |  |  |  |  | 0 or 24 | V |
| 107 | DO | 8 | Voltage | DO | A | 4 | DO A 4 |  |  |  |  |  |  |  |  |  |  | 0 or 24 | V |
| 108 | DO | 8 | Voltage | DO | A | 5 | DO A 5 |  |  |  |  |  |  |  |  |  |  | 0 or 24 | V |
| 109 | DO | 8 | Voltage | DO | A | 6 | DO A 6 |  |  |  |  |  |  |  |  |  |  | 0 or 24 | V |
| 110 | DO | 8 | Voltage | DO | A | 7 | DO A 7 |  |  |  |  |  |  |  |  |  |  | 0 or 24 | V |
| 111 | DO | 8 | Voltage | DO | A | 8 | DO A 8 |  |  |  |  |  |  |  |  |  |  | 0 or 24 | V |
| 112 | DO | 8 | Voltage | DO | A | 9 | DO A 9 |  |  |  |  |  |  |  |  |  |  | 0 or 24 | V |
| 113 | DO | 8 | Voltage | DO | A | 10 | DO A 10 |  |  |  |  |  |  |  |  |  |  | 0 or 24 | V |
| 114 | DO | 8 | Voltage | DO | A | 11 | DO A 11 |  |  |  |  |  |  |  |  |  |  |  |  |
| 115 | DO | 8 | Voltage | DO | A | 12 | DO A 12 |  |  |  |  |  |  |  |  |  |  |  |  |
| 116 | DO | 8 | Voltage | DO | A | 13 | DO A 13 |  |  |  |  |  |  |  |  |  |  |  |  |
| 117 | DO | 8 | Voltage | DO | A | 14 | DO A 14 |  |  |  |  |  |  |  |  |  |  | 0 or 24 | V |
| 118 | DO | 8 | Voltage | DO | A | 15 | DO A 15 |  |  |  |  |  |  |  |  |  |  | 0 or 24 | V |
| 119 | DO | 8 | Voltage | DO | A | 16 | DO A 16 |  |  |  |  |  |  |  |  |  |  | 0 or 24 | V |
| 120 | DO | 8 | Voltage | DO | A | 17 | DO A 17 |  |  |  |  |  |  |  |  |  |  | 0 or 24 | V |
| 121 | DO | 8 | Voltage | DO | A | 18 | DO A 18 |  |  |  |  |  |  |  |  |  |  | 0 or 24 | V |
| 122 | DO | 8 | Voltage | DO | A | 19 | DO A 19 |  |  |  |  |  |  |  |  |  |  | 0 or 24 | V |
| 123 | DO | 8 | Voltage | DO | A | 20 | DO A 20 |  |  |  |  |  |  |  |  |  |  | 0 or 24 | V |
| 124 | DO | 8 | Voltage | DO | A | 21 | DO A 21 |  |  |  |  |  |  |  |  |  |  | 0 or 24 | V |
| 125 | DO | 8 | Voltage | DO | A | 22 | DO A 22 |  |  |  |  |  |  |  |  |  |  | 0 or 24 | V |
| 126 | DO | 8 | Voltage | DO | A | 23 | DO A 23 |  |  |  |  |  |  |  |  |  |  | 0 or 24 | V |
| 127 | DO | 8 | Voltage | DO | A | 24 | DO A 24 |  |  |  |  |  |  |  |  |  |  | 0 or 24 | V |
| 128 | DO | 8 | Voltage | DO | A | 25 | DO A 25 |  |  |  |  |  |  |  |  |  |  | 0 or 24 | V |
| 129 | DO | 8 | Voltage | DO | A | 26 | DO A 26 |  |  |  |  |  |  |  |  |  |  | 0 or 24 | V |
| 130 | DO | 8 | Voltage | DO | A | 27 | DO A 27 |  |  |  |  |  |  |  |  |  |  | 0 or 24 | V |
| 131 | DO | 8 | Voltage | DO | A | 28 | DO A 28 |  |  |  |  |  |  |  |  |  |  |  |  |
| 132 | DO | 8 | Voltage | DO | A | 29 | DO A 29 |  |  |  |  |  |  |  |  |  |  |  |  |
| 133 | DO | 8 | Voltage | DO | A | 30 | DO A 30 |  |  |  |  |  |  |  |  |  |  |  |  |
| 134 | DO | 8 | Voltage | DO | A | 31 | DO A 31 |  |  |  |  |  |  |  |  |  |  |  |  |
|  |  |  |  |  |  |  |  |  |  |  | #NAME? |  |  |  |  |  |  |  |  |
|  |  |  |  |  |  |  |  |  |  |  | #NAME? |  |  |  |  |  |  |  |  |
|  |  |  |  |  |  |  |  |  |  |  | #NAME? |  |  |  |  |  |  |  |  |
|  |  |  |  |  |  |  |  |  |  |  | #NAME? |  |  |  |  |  |  |  |  |
|  |  |  |  |  |  |  |  |  |  |  | #NAME? |  |  |  |  |  |  |  |  |
|  |  |  |  |  |  |  |  |  |  |  | #NAME? |  |  |  |  |  |  |  |  |
## Sheet: 부품자료
|  | 펌프 | DWP-5698-2404 | 24V/1.5A |
| --- | --- | --- | --- |
