seokipo/H2_Control_Board/graphify-out/converted/회로설계참조_26ab838c.md

<!-- converted from 회로설계참조.xlsx -->

## Sheet: Sheet1
|  |  |  | 기능 | 네트 네임 (Net Label) | 비고 |
| --- | --- | --- | --- | --- | --- |
|  |  |  | 온도 센서 | MUX_OUT_P/N, TC_CS, TC_ADDR0~3, TC_EN1~3 | SPI 및 GPIO 핀 할당 |
|  |  |  | 밸브 출력 | DO_SV1 ~ DO_SV15 | PWM 또는 일반 GPIO 할당 |
|  |  |  | 온도 보상 | TC_AMB_1, TC_AMB_2 | ADC(아날로그) 핀 할당 |
