seokipo/H2_Control_Board/01_Hardware/Docs/AO/에어블로워_BLP-8080.docx

에어블로워_BLP-8080 : https://www.motorbank.kr/goods/goods_view.php?goodsNo=1000034400

전용 드라이버 :

https://www.motorbank.kr/goods/goods_view.php?goodsNo=1000034580
