seokipo/H2_Control_Board/06_Docs/10kW Alpha UI 260824(수정).pptx

비상정지 테스트

On/Off

제어기 통신 상태(퍼니일렉스 측과 상의 후 구성)

Sys T [℃]

FAN

INV

CVM1

CVM2

FM

HMI

모니터링

B

저장

B

MC_SW

B

Stack

Cathode
IN

Cathode
OUT

TC [℃]

TC[℃]

Anode IN

PT [kPa]

ST1
Cool OUT

ST2
Cool OUT

PV [℃]

SV [℃]

PV [℃]

SV [℃]

PV [℃]

SV [℃]

DI.W Tank

DI.W Temp. [℃]

DI Conductivity

High T [℃]

PV [ μs/cm^2 ]

Low T [℃]

SV [ μs/cm^2 ]

COIL B

Automatic
Code

Detector

CH4

H2

Inverter

DC [V]

SV [A]

PV [A]

PV [Hz]

SET

R [V]

S [V]

S [A]

T [V]

R [A]

T [A]

AC [kW]

Fault

LCD

NG

B - Air

PV [LPM]

SV [LPM]

BF

TC [℃]

P - Air

PV [LPM]

SV [LPM]

C - Air

PV [LPM]

SV [LPM]

Vent

N2

Ref

ST

Graph

SV [kPa]

NG Pump

PV [kPa]

NG Inlet

PT [kpa]

TC [℃]

PV [LPM]

SV [LPM]

BNG

PT [kPa]

IGN

Vent

COIL B

REF.

Stack

Reformer

BN [℃]

SR 1 [℃]

SR 2 [℃]

SR 3 [℃]

LTS 1 [℃]

LTS 2 [℃]

FEED [℃]

RG [℃]

EG [℃]

AOG IN

Prox

H [℃]

M [℃]

L [℃]

AOG HX

AHX_TC [℃]

St OUT

PID

PV [LPM]

SV [LPM]

PNG

PT [kPa]

Heater

LTS 1

SV [℃]

ON/OFF

ON/OFF

ON/OFF

ON/OFF

LTS 2

SV [℃]

Prox 1

SV [℃]

Prox 2

SV [℃]

BYBASS

St IN

EHR

CVM

RG HX

BHX_TC [℃]

변수 설정

INV

Ref.W

PV [LPM]

SV [LPM]

PT [kPa]

RG.Re Temp [℃]

H.W Re

TC [℃]

FM [LPM]

Auto Code

Auto Mode

START

비상정지

STOP

AOG

부하 운전

Parameter

EG HX

AHX_TC [℃]

PT [kPa]

Vent

Prox

Water IN

HR.Water
OUT

COIL A

H.W Tank

H.W Temp. [℃]

High T [℃]

Low T [℃]

City.W

HR.Water IN

Sys Cool Pump

SV [V]

AOG HX

Drain

RG HX

EG HX

## Slide 2

비상정지 테스트

On/Off

제어기 통신 상태(퍼니일렉스 측과 상의 후 구성)

Sys T [℃]

TC507

FAN

INV

CVM1

CVM2

FM

LCD

FAN504

FM382

모니터링

B

저장

B

MC_SW

B

Stack

Cathode
IN

Cathode
OUT

TC [℃]

TC[℃]

Anode IN

PT [kPa]

ST1
Cool OUT

ST2
Cool OUT

PV [℃]

SV [℃]

PV [℃]

SV [℃]

PV [℃]

SV [℃]

PT146

DI.W Tank

DI.W Temp. [℃]

DI Conductivity

High T [℃]

PV [ μs/cm^2 ]

Low T [℃]

SV [ μs/cm^2 ]

COIL B

Automatic
Code

H2

LCD

NG

SV102

SV103

B - Air

PV [LPM]

SV [LPM]

MFM222

AB221

BF

TC [℃]

P - Air

PV [LPM]

SV [LPM]

MFM231

AB232

INV506

C - Air

PV [LPM]

SV [LPM]

MFM211

AB212

Vent

N2

Ref

ST

TC125

Detector

CH4

GD501

Inverter

DC [V]

SV [A]

PV [A]

PV [Hz]

SET

R [V]

S [V]

S [A]

T [V]

R [A]

T [A]

AC [kW]

Fault

Graph

SV [kPa]

NG Pump

PV [kPa]

PT109

P108

NG Inlet

PT [kpa]

TC [℃]

PT105

TC104

TC115

IGN175

Reformer

BN [℃]

SR 1 [℃]

SR 2 [℃]

SR 3 [℃]

LTS 1 [℃]

LTS 2 [℃]

FEED [℃]

RG [℃]

EG [℃]

IGN

FD176

MV158

Vent

COIL B

TC214

TC215

TC149

GD502

REF.

Stack

AOG IN

MV155

AOG HX

AHX_TC [℃]

TC157

St OUT

MV150

TC147

TC215

PID

PV [LPM]

SV [LPM]

PNG

PT [kPa]

MFC121(AI)

MFC121(AO)

PT123

Heater

LTS 1

SV [℃]

ON/OFF

ON/OFF

ON/OFF

ON/OFF

LTS 2

SV [℃]

Prox 1

SV [℃]

Prox 2

SV [℃]

PV [LPM]

SV [LPM]

BNG

PT [kPa]

MFC111(AI)

MFC111(AO)

PT113

TC181

TC182

TC183

Prox

H [℃]

M [℃]

L [℃]

TC190

MV148

BYBASS

St IN

TC147

HR

CVM

TC184

TC185

TC191

TC192

RG HX

BHX_TC [℃]

TC133

SV145

TC372

TC372

변수 설정

INV

TC186

TC187

Ref.W

PV [LPM]

SV [LPM]

PT [kPa]

FM382

FM382

PT383

RG.Re Temp [℃]

TC353

TC377

Auto Code

Auto Mode

START

비상정지

STOP

AOG

TC189

TC188

H.W Re

TC [℃]

FM [LPM]

TC316

FM315

TC377

부하 운전

Parameter

HT193

EG HX

AHX_TC [℃]

PT [kPa]

TC162

PT163

Prox

Water IN

H.W Tank

H.W Temp. [℃]

High T [℃]

Low T [℃]

TC312

TC393

TC392

TC322

HT194

MV300

HR.Water
OUT

COIL A

TC344

CS324

HT195

City.W

MV390

Sys Cool Pump

SV [V]

P341

AOG HX

TC343

CS324

SV323

HT196

Vent

HR.Water IN

RG HX

EG HX

Drain

## Slide 3

×

BN & SR

SH & FEED & RG

EG & PROX

REF Graph

MAX

50.0

Scale

Auto/Manual

75.1

60.0

TC181

TC182

TC183

TC184

MIN

0.0

40.0

20.0

1. 메인 UI에서 클릭 시 다음과 같이 팝업
- X축 : 시간
Y축 : 온도값
- Auto, Manual 모드 설정 가능
- Manual 모드에서 Y축 최댓값, 최솟값 설정 가능
- X축 시간 설정 가능

REF.

0.0

00:00:01

00:01:41

00:03:21

00:05:01

00:06:41

00:08:21

00:10:00

Scale

Auto/Manual

54.8

40.0

TC185

TC186

TC187

TC188

MIN

0.0

MAX

50.0

30.0

20.0

10.0

0.0

00:00:01

00:01:41

00:03:21

00:05:01

00:06:41

00:08:21

00:10:00

Scale

Auto/Manual

24.7

TC189

TC190

TC191

TC192

MAX

50.0

24.6

24.5

24.4

MIN

0.0

24.3

24.2

24.1

X축 시간 [분]

10

00:00:01

00:01:41

00:03:21

00:05:01

00:06:41

00:08:21

00:10:00

## Slide 4

Air & Gas Temp

Coolant Temp

Stack Graph

×

2. 메인 UI에서 클릭 시 다음과 같이 팝업
- X축 : 시간
Y축 : 온도값
- Auto, Manual 모드 설정 가능
- Manual 모드에서 Y축 최댓값, 최솟값 설정 가능
- X축 시간 설정 가능(1분~10분)

Stack

Scale

Auto/Manual

75.1

TC214

TC215

TC147

MAX

50.0

60.0

40.0

MIN

0.0

20.0

0.0

54.8

00:00:01

00:01:41

00:03:21

00:05:01

00:06:41

00:08:21

00:10:00

MAX

50.0

Scale

Auto/Manual

40.0

30.0

TC322

TC372

TC377

MIN

0.0

20.0

10.0

X축 시간 [분]

10

0.0

00:00:01

00:01:41

00:03:21

00:05:01

00:06:41

00:08:21

00:10:00

## Slide 5

3. 메인 UI에서 클릭 시 6번 슬라이드와 같이 팝업
- X축 : 시간축(시간 설정 : 1분 고정)
Y축 : 각 센서의 계측값 / 0~5V 전압값
- PID, Voltage 모드 설정
- P gain, I gain, LPF, 최대 허용 전압(0~5V) 설정 가능
- 사용자가 입력한 값 저장 기능

PID

## Slide 6

×

PID Controller

Feedback Signal : MFM212

Output Voltage : 0~5V

Feedback Signal : TC147

Output Voltage : 0~5V

AB212 PI#1

PID/VOL

P gain

0.000

Voltage

0.000

Command

0.000

Limit

5.000

P370 PI#6

PID/VOL

P gain

0.000

Voltage

0.000

Command

0.000

Limit

5.000

I gain

0.000

LPF

0.000

Feedback Signal : MFM222

Output Voltage : 0~5V

I gain

0.000

LPF

0.000

Feedback Signal : TC372

Output Voltage : 0~5V

AB221 PI#2

PID/VOL

P gain

Voltage

0.000

I gain

Command

0.000

LPF

Limit

5.000

P375 PI#7

PID/VOL

P gain

Voltage

0.000

I gain

Command

0.000

LPF

Limit

5.000

0.000

0.000

0.000

Feedback Signal : MFM231

Output Voltage : 0~5V

0.000

0.000

0.000

Feedback Signal : TC377

Output Voltage : 0~5V

PID/VOL

AB232 PI#3

Voltage

Command

5.000

Limit

PID/VOL

P380 PI#8

Voltage

Command

5.000

Limit

P gain

0.000

0.000

I gain

0.000

0.000

0.000

LPF

Feedback Signal : PT109

P gain

0.000

0.000

I gain

0.000

0.000

0.000

LPF

Feedback Signal :

PID/VOL

P108 PI#4

Voltage

Command

5.000

Limit

Output Voltage : 0~5V

PID/VOL

Spare 1 PI#9

Voltage

Command

5.000

Limit

Output Voltage : 0~5V

P gain

0.000

0.000

I gain

0.000

0.000

0.000

LPF

P gain

0.000

0.000

I gain

0.000

0.000

0.000

LPF

P341 PI#5

Command

5.000

Limit

Feedback Signal : TC343

Output Voltage : 0~5V

Spare 2 PI#10

Command

5.000

Limit

Feedback Signal :

Output Voltage : 0~5V

PID/VOL

P gain

0.000

Voltage

0.000

I gain

0.000

0.000

0.000

LPF

PID/VOL

P gain

0.000

Voltage

0.000

I gain

0.000

0.000

0.000

LPF

X축 1분

SAVE

## Slide 7

4. 메인 UI에서 클릭 시 다음과 같이 팝업
- X축 : 시간
Y축 : 온도값
- Auto, Manual 모드 설정 가능
- Manual 모드에서 Y축 최댓값, 최솟값 설정 가능
- X축 시간 설정 가능(1분~10분)

HR

HR

HR Graph

×

Scale

Auto/Manual

75.1

TC316

TC344

TC353

TC393

MAX

50.0

60.0

40.0

MIN

0.0

20.0

0.0

X축 시간 [분]

10

00:00:01

00:01:41

00:03:21

00:05:01

00:06:41

00:08:21

00:10:00

## Slide 8

5. 메인 UI에서 클릭 시 다음 슬라이드와 같이 팝업
- 각 셀의 전압 표시 그래프(X축 : 셀 번호, Y축 : 전압)
- 특정 셀의 시간별 전압 그래프(X축 : 시간, Y축 : 전압)
- 시간별 평균 셀 전압 그래프(X축 : 시간, Y축 : 전압)
- 저전압 기준, (최대-최소)기준, 셀 번호(그래프), LPF Parameter, 그래프 표시 시간 설정 가능
- (최대-최소) 값이 설정한 기준보다 높을 시, (최대-최소)상태 램프 점등
- Auto, Manual 모드 설정 가능
- Manual 모드에서 Y축 최댓값, 최솟값 설정 가능

CVM

## Slide 9

CVM Graph

스택 전압

0.00

5.00

STACK 1

Scale

Auto

×

평균 셀 전압

최소 셀 전압

저전압 기준

0.00

0.00

1.30

4.00

3.00

MAX

50.0

(최대-최소)셀전압

(최대-최소)기준

(최대-최소)상태

저전압 셀 개수

0

0.00

2.00

1.00

0.00

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
0.50

5.00

셀 전압

5.00

스택 전압

5.00

평균 셀 전압

Scale

Auto

셀 번호(그래프)

셀 전압(그래프)

1

0.00

MAX

50.0

MIN

LPF paramter

X축 시간[분]

0.500

1.0

0.00

00:00:01

00:01:41

00:03:21

00:05:00

0.00

00:00:00

00:01:40

00:03:20

00:04:59

0.00

00:00:01

00:01:41

00:03:21

00:05:00

0.0

스택 전압

평균 셀 전압

최소 셀 전압

0.00

0.00

0.00

5.00

4.00

STACK 2

Auto

Scale

저전압 기준

저전압 셀 개수

1.30

0

3.00

2.00

1.00

50.0

0.0

MAX

MIN

(최대-최소)기준

(최대-최소)셀전압

(최대-최소)상태

0.00

0.50

0.00

5.00

0

셀 전압

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
5.00

16

17

스택 전압

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
5.00

34

35

평균 셀 전압

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
셀 전압(그래프)

셀 번호(그래프)

1

Auto

Scale

MAX

LPF paramter

0.00

0.500

0.00

00:00:01

00:01:41

00:03:21

00:05:00

0.00

00:00:00

00:01:40

00:03:20

00:04:59

0.00

00:00:01

00:01:41

00:03:21

00:05:00

50.0

0.0

MIN

X축 시간[분]

1.0

## Slide 10

6. 메인 UI에서 클릭 시 다음과 같이 팝업
- X축 : 시간
Y축 : 전압 및 전력
- Auto, Manual 모드 설정 가능
- Manual 모드에서 Y축 최댓값, 최솟값 설정 가능
- X축 시간 설정 가능(1분~10분)

INV

INV Graph

DC V [V]

AC P [kW]

×

Auto/Manual

Scale

100.0

80.0

Auto/Manual

Scale

100.0

80.0

MAX

50.0

MIN

0.0

60.0

40.0

MAX

50.0

MIN

0.0

60.0

40.0

20.0

0.0

00:00:01

00:02:06

00:04:11

00:06:16

00:08:21

00:10:00

20.0

0.0

00:00:01

00:02:06

00:04:11

00:06:16

00:08:21

00:10:00

X축 시간 [분]

10

## Slide 11

7. 메인 UI에서 , , 클릭 시 12,13,14번 슬라이드와 같이 팝업
- Table의 각 칸에 설정값 입력
- Active Step(활성화 단계) 설정
- 설정값 업데이트 내용 저장 기능
- 각 단계별 지연 시간 설정

AOG

부하 운전

Parameter

## Slide 12

AOG table #2

| P water | PNG | P air | BNG | B air | ST air | INV ADJ
1 | 0.0 | 0.0 | 0.0 | 0.0 | 0.0 | 0.0 | 0.0
2 | 0.0 | 0.0 | 0.0 | 0.0 | 0.0 | 0.0 | 0.0
3 | 0.0 | 0.0 | 0.0 | 0.0 | 0.0 | 0.0 | 0.0
4 | 0.0 | 0.0 | 0.0 | 0.0 | 0.0 | 0.0 | 0.0
5 | 0.0 | 0.0 | 0.0 | 0.0 | 0.0 | 0.0 | 0.0
6 | 0.0 | 0.0 | 0.0 | 0.0 | 0.0 | 0.0 | 0.0
7 | 0.0 | 0.0 | 0.0 | 0.0 | 0.0 | 0.0 | 0.0
8 | 0.0 | 0.0 | 0.0 | 0.0 | 0.0 | 0.0 | 0.0
9 | 0.0 | 0.0 | 0.0 | 0.0 | 0.0 | 0.0 | 0.0
10 | 0.0 | 0.0 | 0.0 | 0.0 | 0.0 | 0.0 | 0.0
11 | 0.0 | 0.0 | 0.0 | 0.0 | 0.0 | 0.0 | 0.0
12 | 0.0 | 0.0 | 0.0 | 0.0 | 0.0 | 0.0 | 0.0
13 | 0.0 | 0.0 | 0.0 | 0.0 | 0.0 | 0.0 | 0.0
14 | 0.0 | 0.0 | 0.0 | 0.0 | 0.0 | 0.0 | 0.0
15 | 0.0 | 0.0 | 0.0 | 0.0 | 0.0 | 0.0 | 0.0
16 | 0.0 | 0.0 | 0.0 | 0.0 | 0.0 | 0.0 | 0.0
17 | 0.0 | 0.0 | 0.0 | 0.0 | 0.0 | 0.0 | 0.0
18 | 0.0 | 0.0 | 0.0 | 0.0 | 0.0 | 0.0 | 0.0
19 | 0.0 | 0.0 | 0.0 | 0.0 | 0.0 | 0.0 | 0.0
20 | 0.0 | 0.0 | 0.0 | 0.0 | 0.0 | 0.0 | 0.0
21 | 0.0 | 0.0 | 0.0 | 0.0 | 0.0 | 0.0 | 0.0
22 | 0.0 | 0.0 | 0.0 | 0.0 | 0.0 | 0.0 | 0.0
23 | 0.0 | 0.0 | 0.0 | 0.0 | 0.0 | 0.0 | 0.0
24 | 0.0 | 0.0 | 0.0 | 0.0 | 0.0 | 0.0 | 0.0
25 | 0.0 | 0.0 | 0.0 | 0.0 | 0.0 | 0.0 | 0.0
26 | 0.0 | 0.0 | 0.0 | 0.0 | 0.0 | 0.0 | 0.0
27 | 0.0 | 0.0 | 0.0 | 0.0 | 0.0 | 0.0 | 0.0
28 | 0.0 | 0.0 | 0.0 | 0.0 | 0.0 | 0.0 | 0.0
29 | 0.0 | 0.0 | 0.0 | 0.0 | 0.0 | 0.0 | 0.0
30 | 0.0 | 0.0 | 0.0 | 0.0 | 0.0 | 0.0 | 0.0
31 | 0.0 | 0.0 | 0.0 | 0.0 | 0.0 | 0.0 | 0.0
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
25 | 0.0 | 0.0 | 0.0 | 0.0 | 0.0
26 | 0.0 | 0.0 | 0.0 | 0.0 | 0.0
27 | 0.0 | 0.0 | 0.0 | 0.0 | 0.0
28 | 0.0 | 0.0 | 0.0 | 0.0 | 0.0
29 | 0.0 | 0.0 | 0.0 | 0.0 | 0.0
30 | 0.0 | 0.0 | 0.0 | 0.0 | 0.0

×

Active step

Step time [sec]

업데이트
&
저장

Active step

Step time [sec]

## Slide 13

부하 운전 Table

UP table (50%-->75%-->100%)

| P water | PNG | P air | BNG | B air | ST air | INV ADJ
1 | 0.0 | 0.0 | 0.0 | 0.0 | 0.0 | 0.0 | 0.0
2 | 0.0 | 0.0 | 0.0 | 0.0 | 0.0 | 0.0 | 0.0
3 | 0.0 | 0.0 | 0.0 | 0.0 | 0.0 | 0.0 | 0.0
4 | 0.0 | 0.0 | 0.0 | 0.0 | 0.0 | 0.0 | 0.0
5 | 0.0 | 0.0 | 0.0 | 0.0 | 0.0 | 0.0 | 0.0
6 | 0.0 | 0.0 | 0.0 | 0.0 | 0.0 | 0.0 | 0.0
7 | 0.0 | 0.0 | 0.0 | 0.0 | 0.0 | 0.0 | 0.0
8 | 0.0 | 0.0 | 0.0 | 0.0 | 0.0 | 0.0 | 0.0
9 | 0.0 | 0.0 | 0.0 | 0.0 | 0.0 | 0.0 | 0.0
10 | 0.0 | 0.0 | 0.0 | 0.0 | 0.0 | 0.0 | 0.0
11 | 0.0 | 0.0 | 0.0 | 0.0 | 0.0 | 0.0 | 0.0
12 | 0.0 | 0.0 | 0.0 | 0.0 | 0.0 | 0.0 | 0.0
13 | 0.0 | 0.0 | 0.0 | 0.0 | 0.0 | 0.0 | 0.0
14 | 0.0 | 0.0 | 0.0 | 0.0 | 0.0 | 0.0 | 0.0
15 | 0.0 | 0.0 | 0.0 | 0.0 | 0.0 | 0.0 | 0.0
16 | 0.0 | 0.0 | 0.0 | 0.0 | 0.0 | 0.0 | 0.0
17 | 0.0 | 0.0 | 0.0 | 0.0 | 0.0 | 0.0 | 0.0
18 | 0.0 | 0.0 | 0.0 | 0.0 | 0.0 | 0.0 | 0.0
19 | 0.0 | 0.0 | 0.0 | 0.0 | 0.0 | 0.0 | 0.0
20 | 0.0 | 0.0 | 0.0 | 0.0 | 0.0 | 0.0 | 0.0
21 | 0.0 | 0.0 | 0.0 | 0.0 | 0.0 | 0.0 | 0.0
22 | 0.0 | 0.0 | 0.0 | 0.0 | 0.0 | 0.0 | 0.0
23 | 0.0 | 0.0 | 0.0 | 0.0 | 0.0 | 0.0 | 0.0
24 | 0.0 | 0.0 | 0.0 | 0.0 | 0.0 | 0.0 | 0.0
25 | 0.0 | 0.0 | 0.0 | 0.0 | 0.0 | 0.0 | 0.0
26 | 0.0 | 0.0 | 0.0 | 0.0 | 0.0 | 0.0 | 0.0
27 | 0.0 | 0.0 | 0.0 | 0.0 | 0.0 | 0.0 | 0.0
28 | 0.0 | 0.0 | 0.0 | 0.0 | 0.0 | 0.0 | 0.0
29 | 0.0 | 0.0 | 0.0 | 0.0 | 0.0 | 0.0 | 0.0
30 | 0.0 | 0.0 | 0.0 | 0.0 | 0.0 | 0.0 | 0.0
31 | 0.0 | 0.0 | 0.0 | 0.0 | 0.0 | 0.0 | 0.0
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
47 | 0.0 | 0.0 | 0.0 | 0.0 | 0.0 | 0.0 | 0.0
48 | 0.0 | 0.0 | 0.0 | 0.0 | 0.0 | 0.0 | 0.0
49 | 0.0 | 0.0 | 0.0 | 0.0 | 0.0 | 0.0 | 0.0
50 | 0.0 | 0.0 | 0.0 | 0.0 | 0.0 | 0.0 | 0.0

×

업데이트
&
저장

75% step

100% step

Step time [sec]

75% step

100% step

Step time [sec]

## Slide 14

Parameter

| Parameter | 설명
1 | 0.0
2 | 0.0
3 | 0.0
4 | 0.0
5 | 0.0
6 | 0.0
7 | 0.0
8 | 0.0
9 | 0.0
10 | 0.0
11 | 0.0
12 | 0.0
13 | 0.0
14 | 0.0
15 | 0.0
16 | 0.0
17 | 0.0
18 | 0.0
19 | 0.0
20 | 0.0
21 | 0.0
22 | 0.0
23 | 0.0
24 | 0.0
25 | 0.0
26 | 0.0
27 | 0.0
28 | 0.0
29 | 0.0
30 | 0.0
31 | 0.0
32 | 0.0
33 | 0.0
34 | 0.0
35 | 0.0
36 | 0.0
37 | 0.0
38 | 0.0
39 | 0.0
40 | 0.0
41 | 0.0
42 | 0.0
43 | 0.0
44 | 0.0
45 | 0.0
46 | 0.0
47 | 0.0
48 | 0.0
49 | 0.0
50 | 0.0
51 | 0.0
52 | 0.0
53 | 0.0
54 | 0.0
55 | 0.0
56 | 0.0
57 | 0.0
58 | 0.0
59 | 0.0
60 | 0.0

×

업데이트
&
저장

## Slide 15

Emergency

100 %

8. 메인 UI에서 클릭 시 다음과 같이 팝업
- 비상정지 상태 표시(비상정지 시 램프 적색 점등)
- 기동, 정지, 부하운전 설정 가능
- 발전량, 누적 발전량, 발열량, 누적 발열량 표시
- 운전 시간, 누적 운전 시간 표시

LCD

LCD 모니터

START

75 %

Reset

50 %

STOP

발전량 [kW]

State

누적 발전량 [kWh]

운전 시간

00 : 00 : 00

발열량 [kW]

누적 발열량 [kWh]

누적 운전 시간

00 : 00 : 00
