seokipo/H2_Control_Board/06_Docs/LT 10kW UI_POP UP 그래프.pptx

REF.

BN & SR

데이터 목록

▢ TC2601
▢ TC2602
▢ TC2603
▢ TC2604
▢ TC2605

- BN&SR TC2601, TC2602, TC2603, TC2604, TC2605 표시
- SH&FG&RG TC2606, TC2607, TC2608, TC2610, TC1202 표시
- FG&EG&PrOx TC2609, TC2613, TC2701, TC2702, TC2703, 표시
- X축 ‘시간변경’ 입력에 따라 Scale 변경
- Y축 ‘Min’, ‘Max’ 입력에 따라 Scale 변경
- 각 그래프 우측 데이터 목록에 대응하는 그래프 색상 표시

MAX :

X(축_시간)

X 축 시간변경

MIN :

SH & FG & RG

MAX :

▢ TC2606
▢ TC2607
▢ TC2608
▢ TC2610
▢ TC1202

X(축_시간)

PrOx & EG

X 축 시간변경

MIN :

▢ TC2609
▢ TC2613
▢ TC2701
▢ TC2702
▢ TC2703

MAX :

MIN :

X(축_시간)

X 축 시간변경

## Slide 2

Stack.

Air & Gas Temp

- Air & Gas Temp TC1104, TC1105, TC1114, TC1115, TC1207 표시
- Coolant Temp TC1311, TC1316, TC1318, TC1326, TC1328 표시
- X축 ‘시간변경’ 입력에 따라 Scale 변경
- Y축 ‘Min’, ‘Max’ 입력에 따라 Scale 변경
- 각 그래프 우측 데이터 목록에 대응하는 그래프 색상 표시

MAX :

▢ TC1104
▢ TC1105
▢ TC1114
▢ TC1115
▢ TC1207

X(축_시간)

X 축 시간변경

MIN :

Coolant Temp

MAX :

▢ TC1311
▢ TC1316
▢ TC1318
▢ TC1326
▢ TC1328

X(축_시간)

X 축 시간변경

MIN :

## Slide 3

- 보여주신 예시 1안대로 적용 요청

CVM

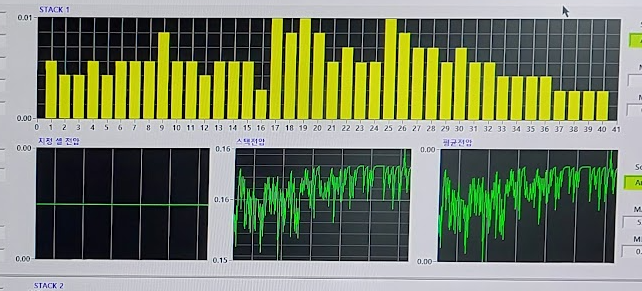
[picture p6: figure]

## Slide 4

INV

DC_V

MAX :

R_V (L1)

MAX :

R_I (L1)

MAX :

- 각 그래프 개별 X축 ‘시간변경’ 입력에 따라 Scale 변경
- 각 그래프 개별 Y축 ‘Min’, ‘Max’ 입력에 따라 Scale 변경

DC_I

MIN :

MAX :

S_V (L2)

T_V (L3)

MIN :

MAX :

S_I (L2)

MIN :

MAX :

MIN :

MAX :

MIN :

MAX :

MIN :

MAX :

DC_P

X 축 시간변경

T_I (L3)

MIN :

MIN :

MIN :

MAX :

AC_P

MIN :

## Slide 5

PID

ST1 C-AIR (AB1102)

REF B-AIR (AB2112)

저온 Proto PID 설정창과 동일한 구성으로 요청

P :

VOL/PID

I :

LPF :

VOL/PID

I :

LPF :

ST2 C-AIR (AB1112)

REF P-AIR (AB2123)

P :

P :

VOL/PID

I :

LPF :

P :

VOL/PID

I :

LPF :

ST1 DI Cool (P1312)

VOL/PID

PNG Pump (P2211)

P :

:

I :

LPF :

P :

VOL/PID

I :

LPF :

ST2 DI Cool (P1322)

VOL/PID

BNG Pump (P2221)

VOL/PID

ST1 Cool (P1412)

P :

I :

LPF :

REF W. Pump(P2308)

P :

I :

LPF :

P :

VOL/PID

I :

LPF :

P :

VOL/PID

I :

LPF :

ST2 Cool (P1422)

SYS Cool Pump(P2412)

P :

VOL/PID

I :

LPF :

P :

VOL/PID

I :

LPF :

## Slide 6

SYS

System Cooling Temp

Max :

X(축_시간)

X 축 시간변경

Min :

▢ TC1411
▢ TC1414
▢ TC1424

- System Cooling Temp TC1411, TC1414, TC1424
- 각 그래프 개별 X축 ‘시간변경’ 입력에 따라 Scale 변경
- 각 그래프 개별 Y축 ‘Min’, ‘Max’ 입력에 따라 Scale 변경
- 각 그래프 우측 데이터 목록에 대응하는 그래프 색상 표시
