seokipo/H2_Control_Board/WORKFLOW.md

# 🧭 H2_Control_Board 프로젝트 공식 개발 워크플로우 (WORKFLOW.md)

이 문서는 H2_Control_Board 프로젝트의 개발 생산성, 코드 일관성 및 무결성을 유지하기 위한 **공식 개발 워크플로우 및 에이전트 행동 지침**입니다.

---

## 🔒 1. SCADA 관제 UI 단일 타깃 집중 개발 원칙 (Single-Target Principle)

> [!IMPORTANT]
> ### 📌 핵심 규칙 (Core Rule)
> **"사용자의 특별한 별도 주문이 있을 때까지 모든 신규 기능 개발, PID/센서 알고리즘 구현, UI 버그 수정은 오직 [index.html](file:///d:/Work/H2_Control_Board/03_Control_UI/index.html) 단일 파일에만 적용한다."**
> 
> * **적용 배경**:
>   - 동일한 화면을 모방한 보조 파일들(`H2ControlTest.html`, `H2ControlSimple.html` 등)에 매번 동시 수정을 진행할 경우, 코드 파편화, 디버깅 혼선 및 렌더링 검증 비효율이 발생함.
> * **실행 방침**:
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
