seokipo/H2_Control_Board/01_Hardware/Docs/AO/VX232ACXB_B9EBACA1EAB8.jpg

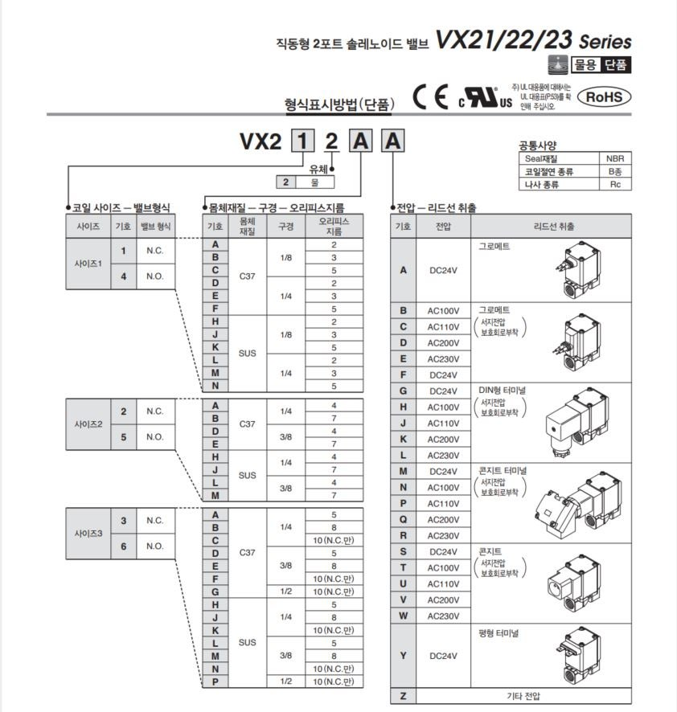
01_Hardware/Docs/AO/VX232ACXB_B9EBACA1EAB8.jpg
