seokipo/H2_Control_Board/01_Hardware/Docs/PCB부품/DWP-370R.png

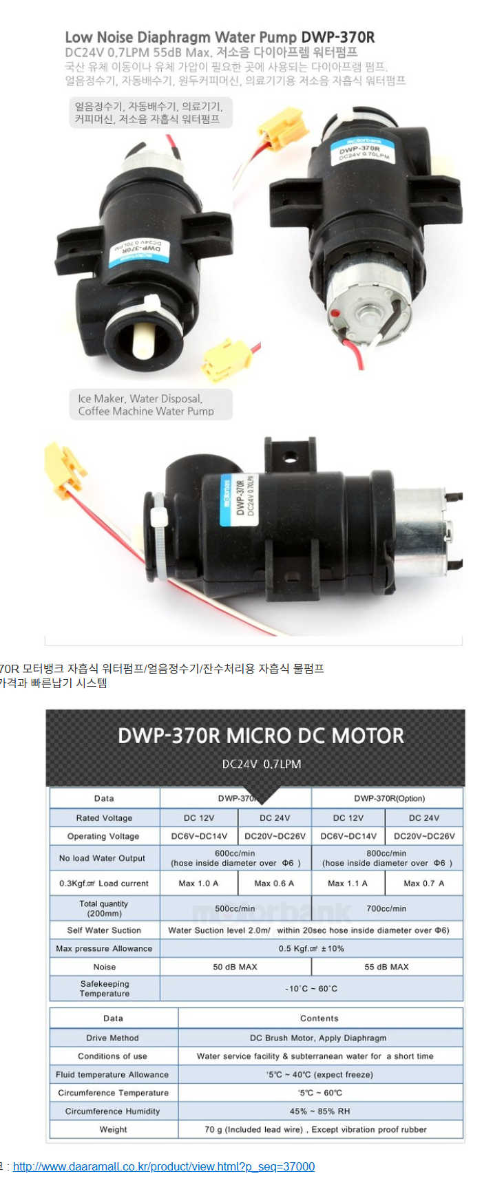
01_Hardware/Docs/PCB부품/DWP-370R.png
