seokipo/H2_Control_Board/01_Hardware/Docs/PCB부품/DWP-5467-2475.png

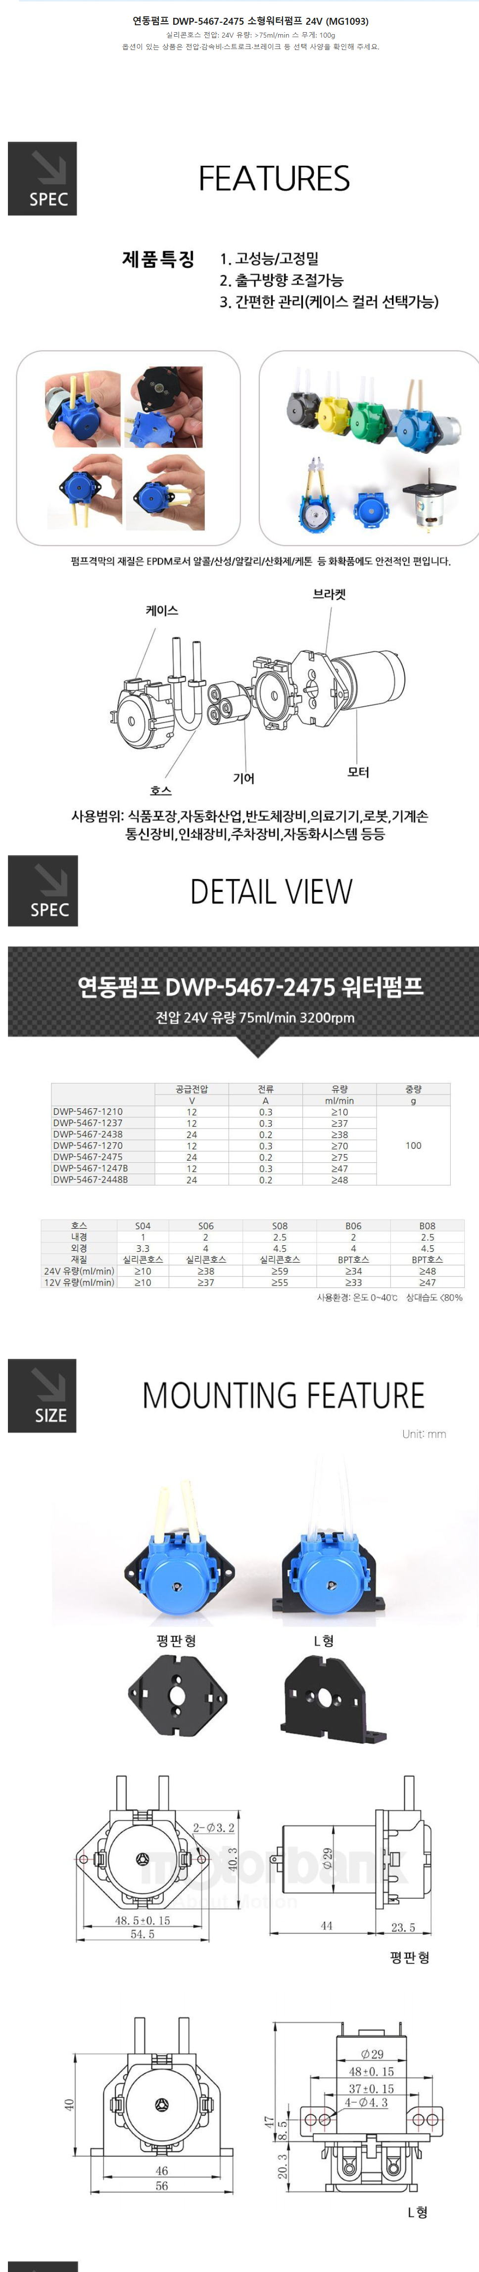
01_Hardware/Docs/PCB부품/DWP-5467-2475.png
