seokipo/H2_Control_Board/01_Hardware/Docs/PCB부품/INTG3-WIREING.png

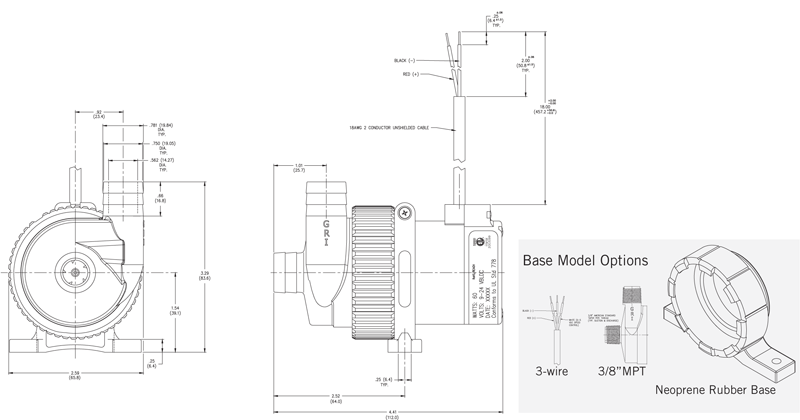
01_Hardware/Docs/PCB부품/INTG3-WIREING.png
