seokipo/H2_Control_Board/01_Hardware/Docs/동아퓨얼셀 이미지 2.png

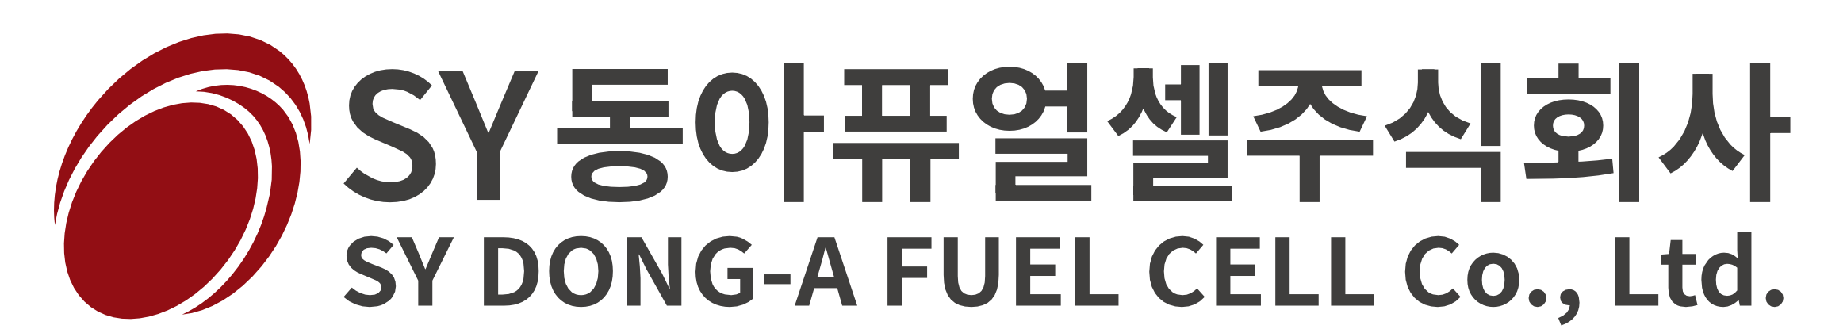
01_Hardware/Docs/동아퓨얼셀 이미지 2.png
