seokipo/H2_Control_Board/01_Hardware/Docs/사본 - 동아퓨얼셀 이미지 2.bmp

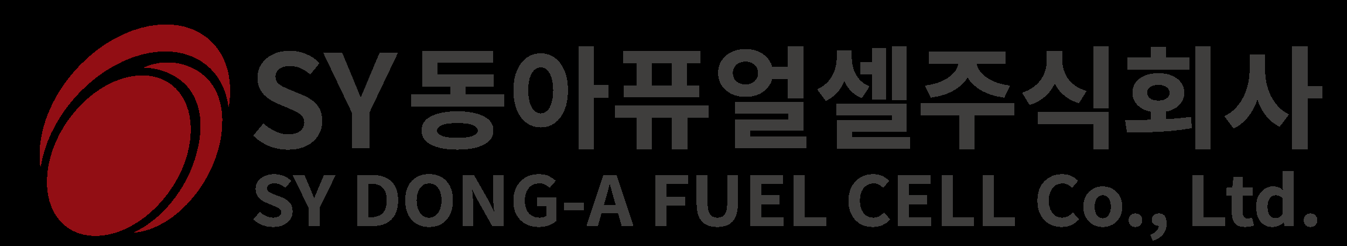
01_Hardware/Docs/사본 - 동아퓨얼셀 이미지 2.bmp
