seokipo/H2_Control_Board/01_Hardware/FuelCell_3d.jpg

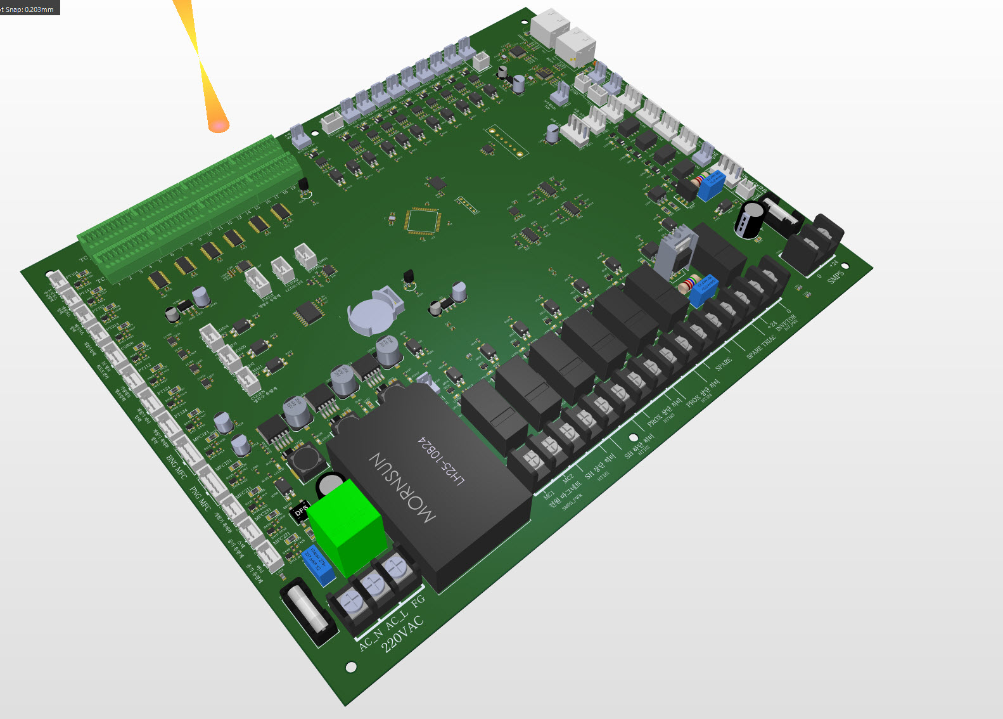
01_Hardware/FuelCell_3d.jpg
