seokipo/H2_Control_Board/01_Hardware/FUELCELL_3D_0805_L1.jpg

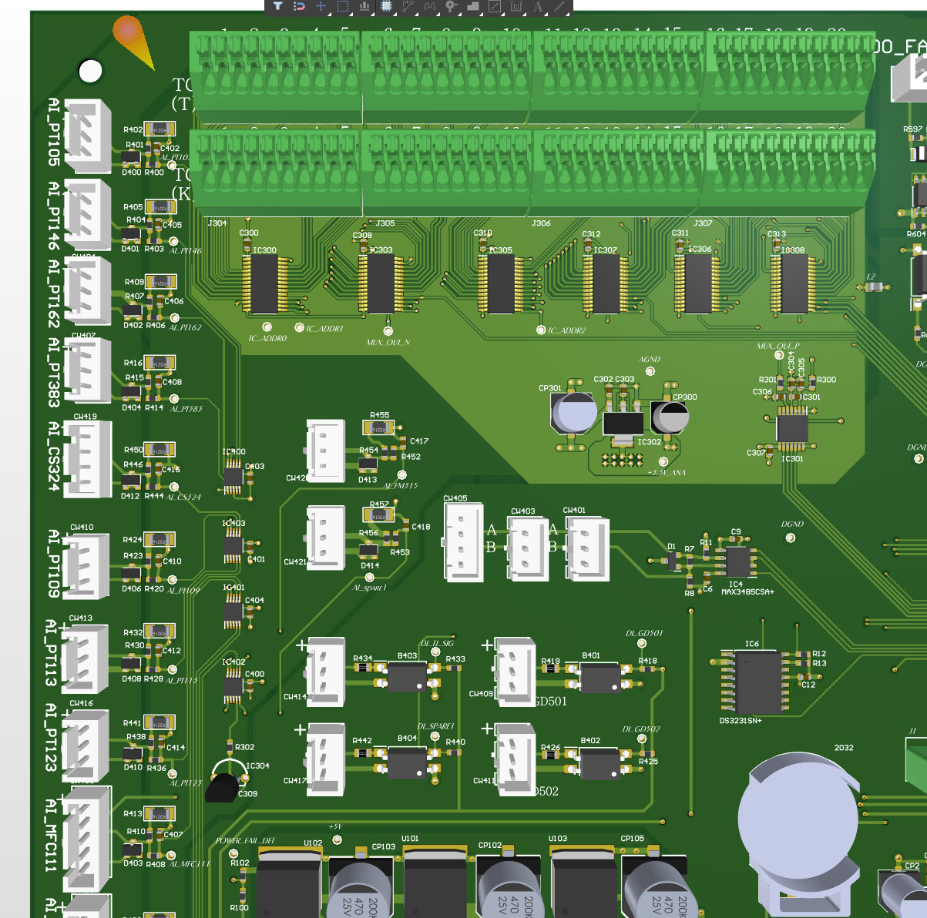
01_Hardware/FUELCELL_3D_0805_L1.jpg
