seokipo/H2_Control_Board/01_Hardware/FUELCELL_3D_0806_R1.jpg

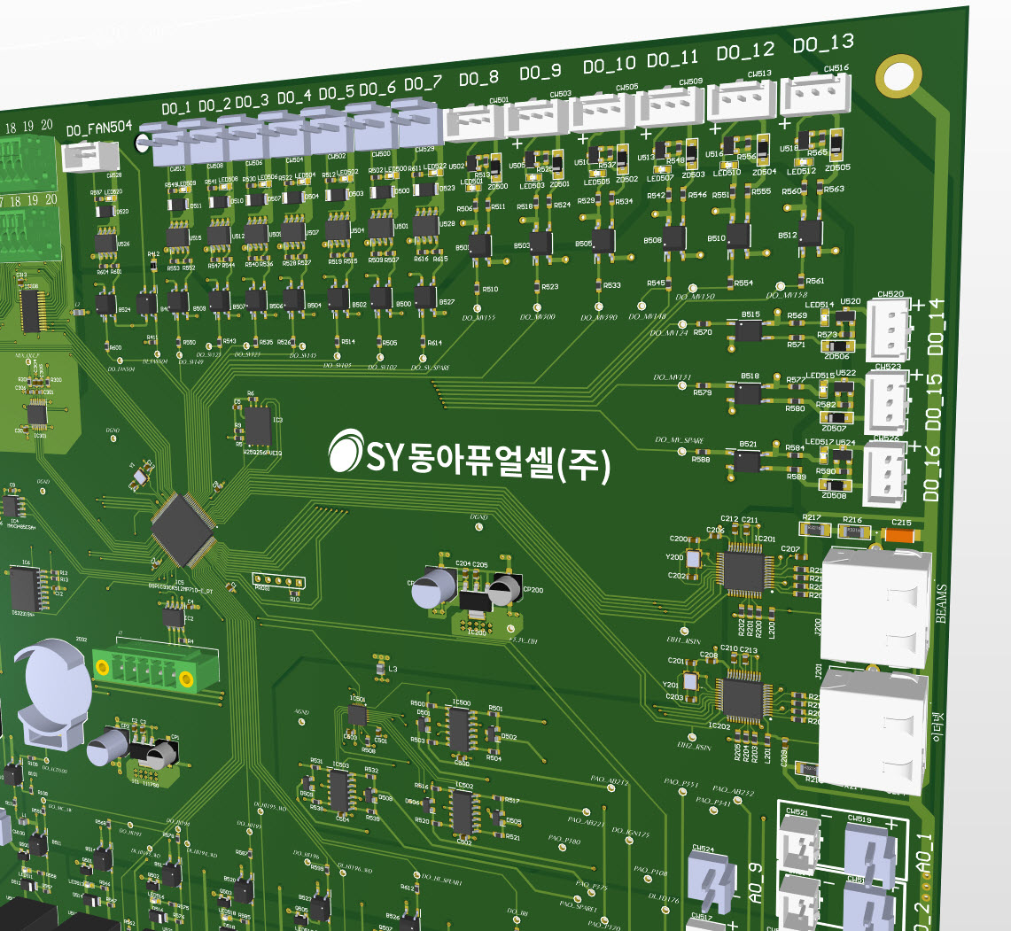
01_Hardware/FUELCELL_3D_0806_R1.jpg
