seokipo/H2_Control_Board/01_Hardware/FuelCell_3d_0807.jpg

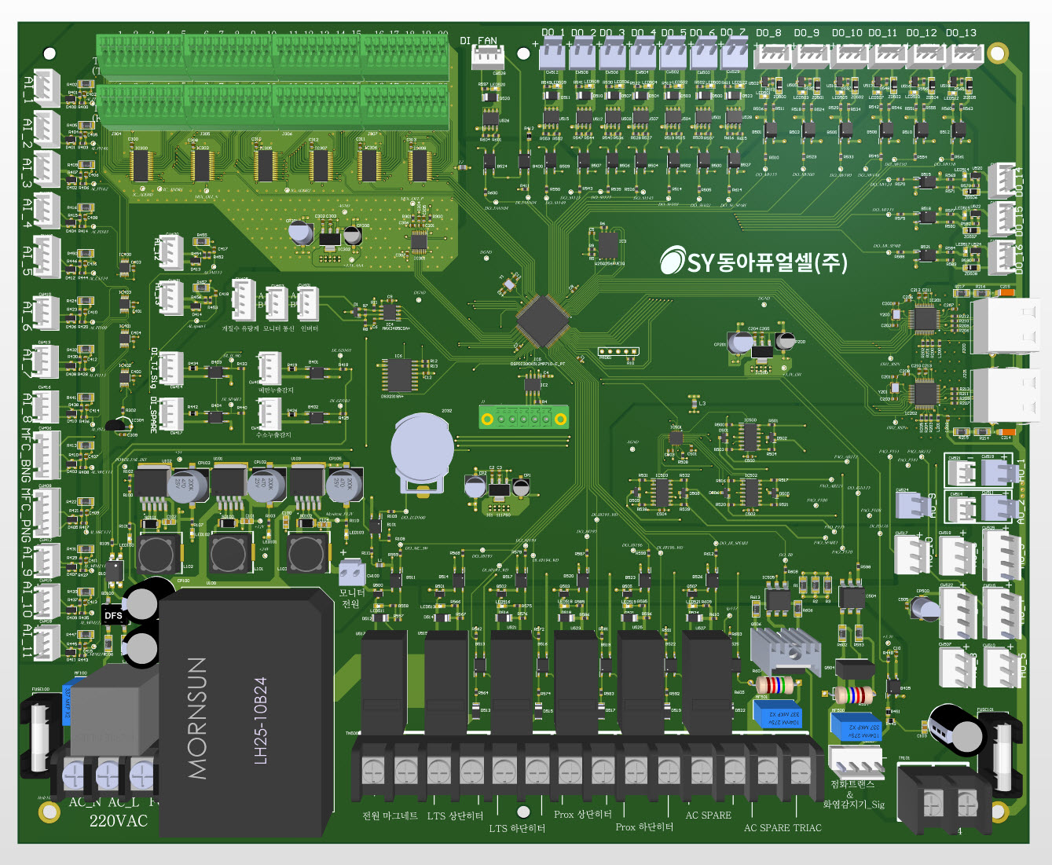
01_Hardware/FuelCell_3d_0807.jpg
