seokipo/H2_Control_Board/01_Hardware/FUELCELL_3D_0807_R2.jpg

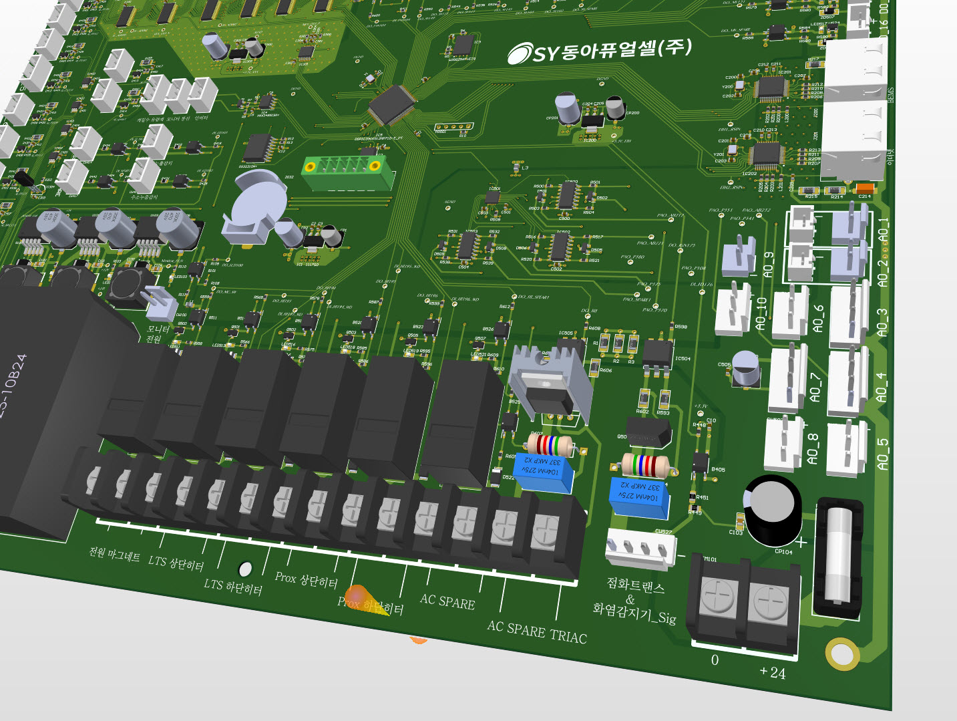
01_Hardware/FUELCELL_3D_0807_R2.jpg
