seokipo/H2_Control_Board/01_Hardware/FUELCELL_3D_ALL.jpg

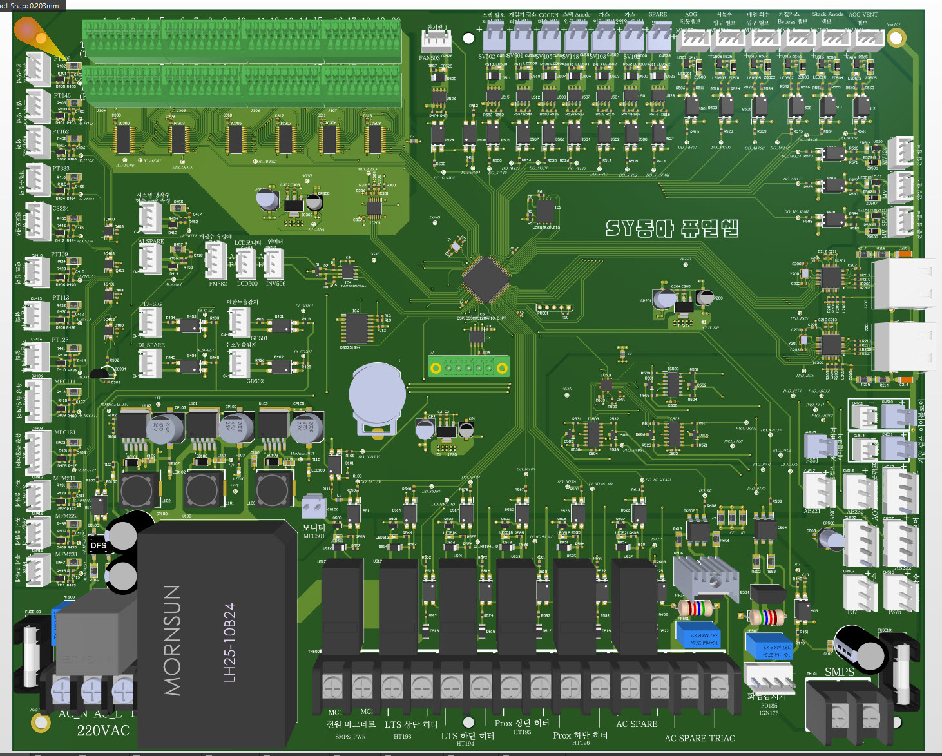
01_Hardware/FUELCELL_3D_ALL.jpg
