seokipo/H2_Control_Board/01_Hardware/FUELCELL_3D_ALL_0810.jpg

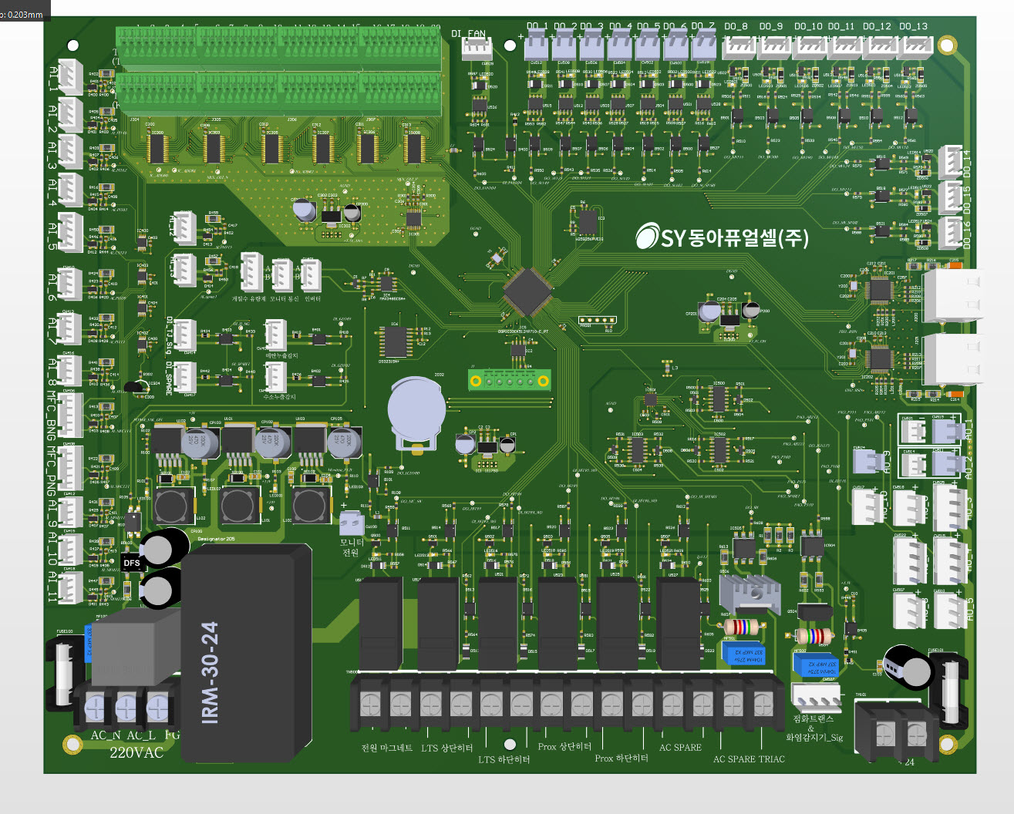
01_Hardware/FUELCELL_3D_ALL_0810.jpg
