seokipo/H2_Control_Board/01_Hardware/FUELCELL_3D_F1.jpg

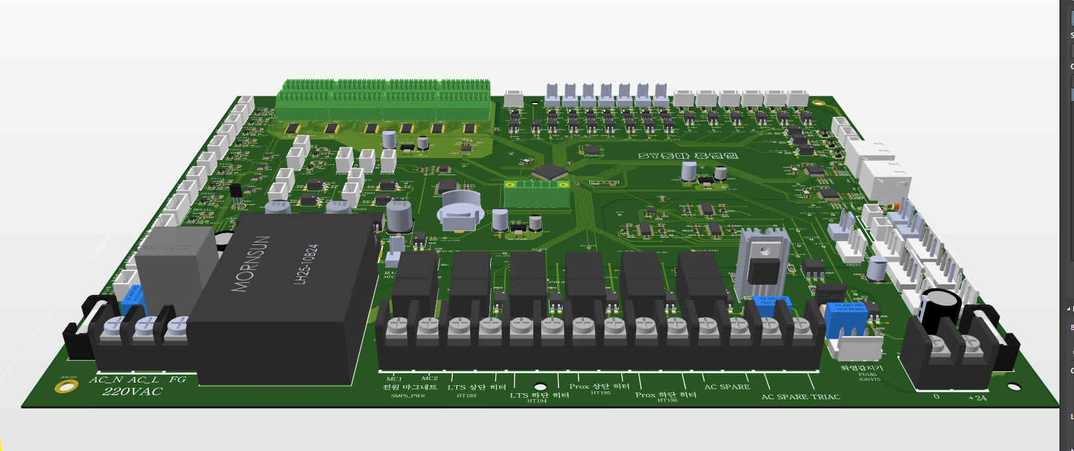
01_Hardware/FUELCELL_3D_F1.jpg
