seokipo/H2_Control_Board/01_Hardware/FUELCELL_3D_L2.jpg

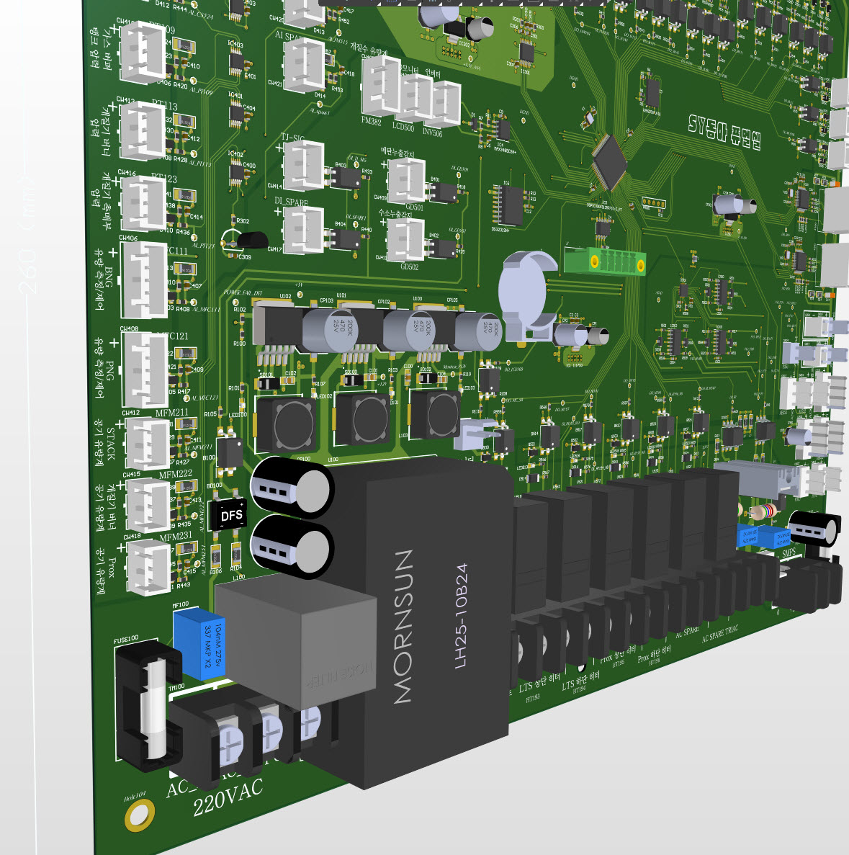
01_Hardware/FUELCELL_3D_L2.jpg
