seokipo/H2_Control_Board/01_Hardware/FUELCELL_3D_L2_0807.jpg

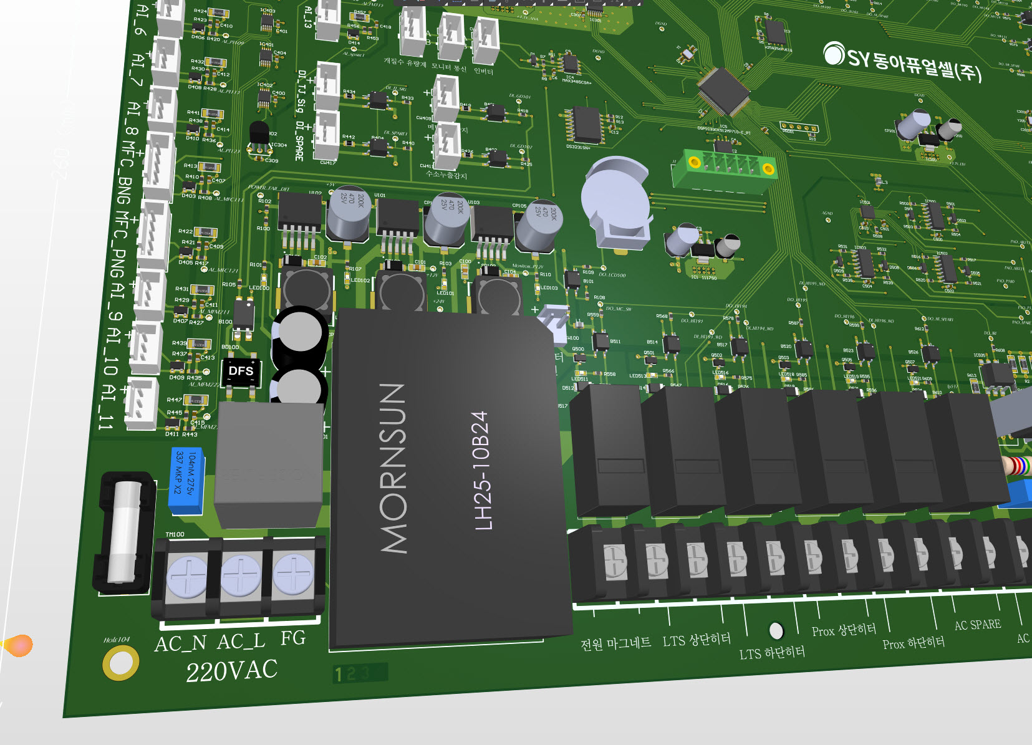
01_Hardware/FUELCELL_3D_L2_0807.jpg
