seokipo/H2_Control_Board/01_Hardware/FUELCELL_0806_2D_ALL.jpg

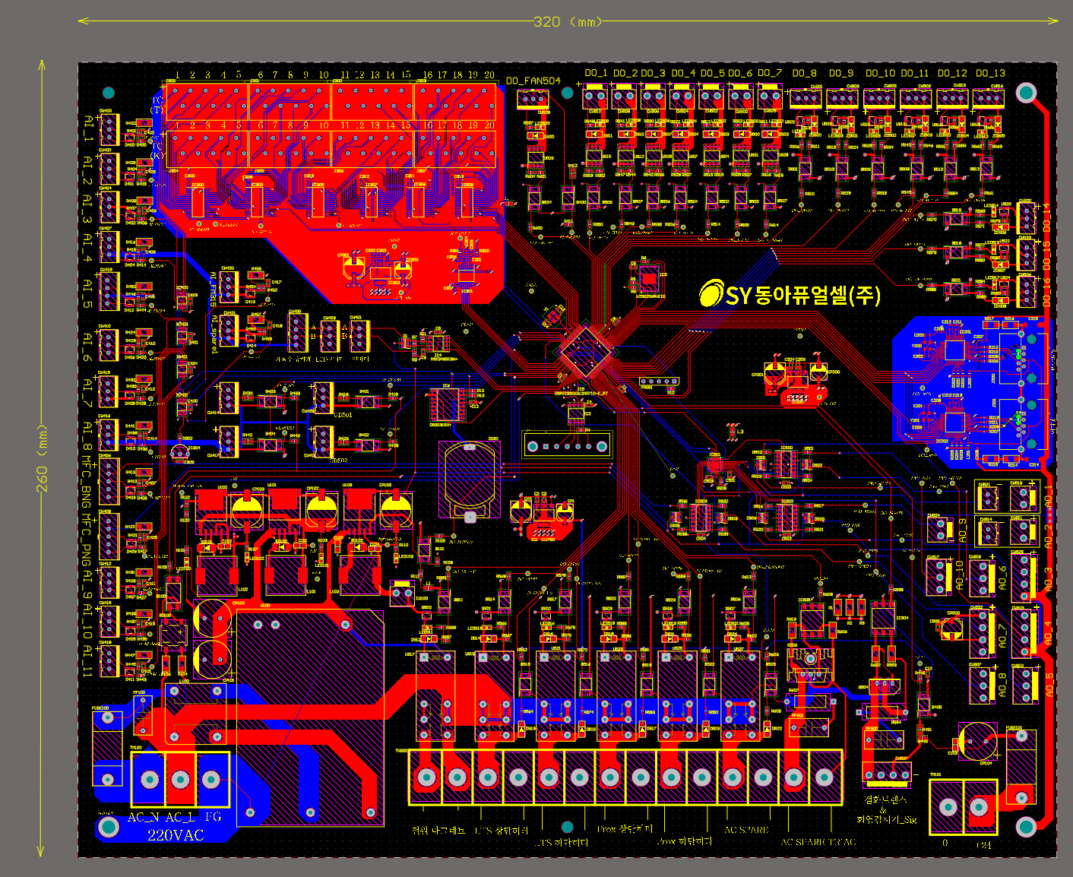
01_Hardware/FUELCELL_0806_2D_ALL.jpg
