seokipo/H2_Control_Board/01_Hardware/FuelCell_front.jpg

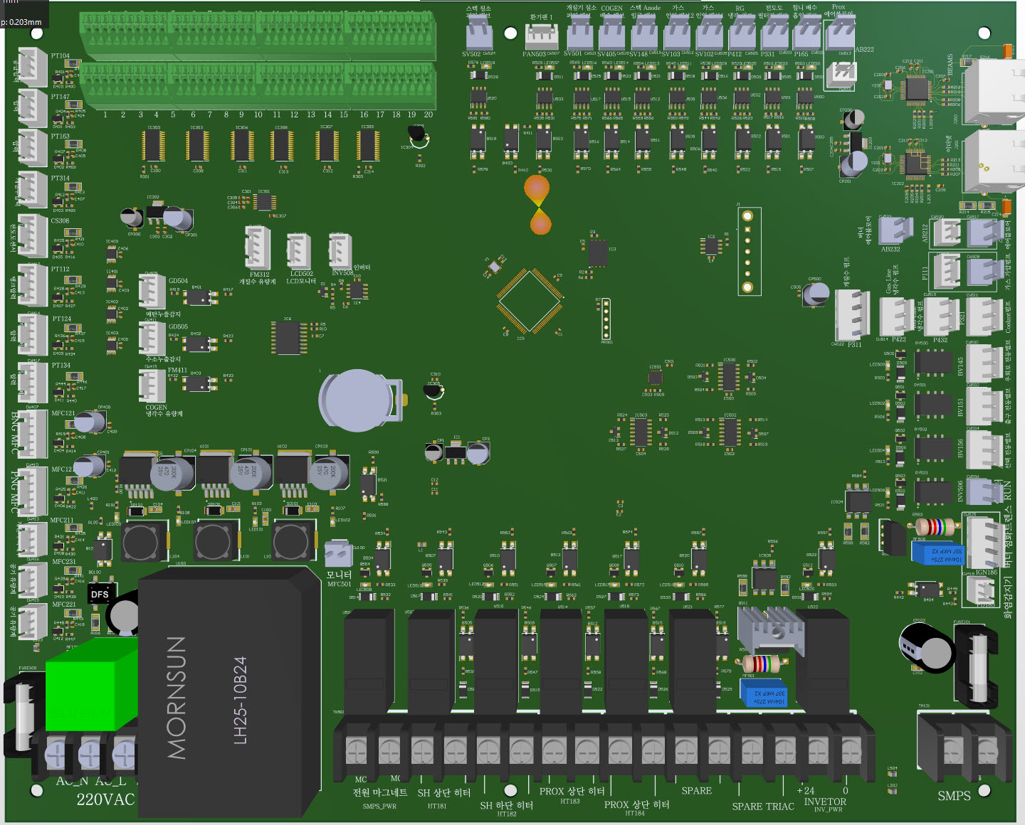
01_Hardware/FuelCell_front.jpg
