seokipo/H2_Control_Board/01_Hardware/FuelCell_pcb_size.jpg

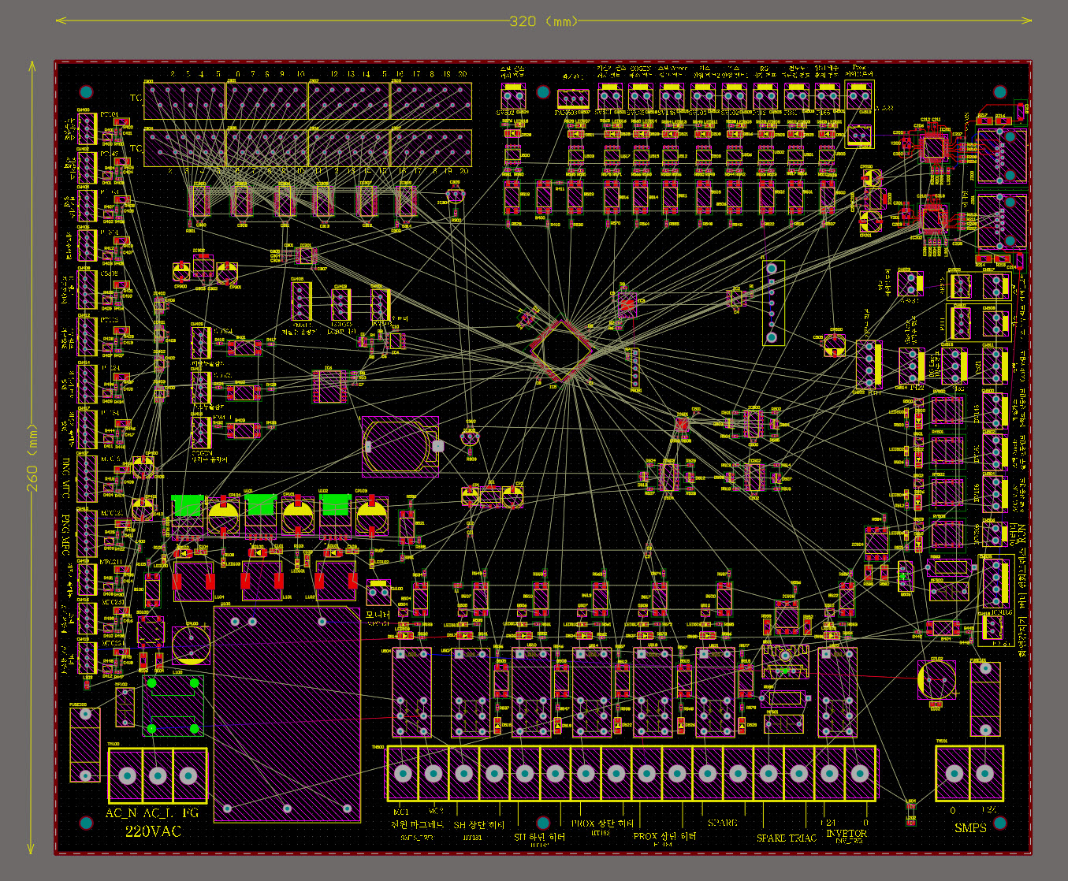
01_Hardware/FuelCell_pcb_size.jpg
