seokipo/H2_Control_Board/01_Hardware/J1_cropped.png

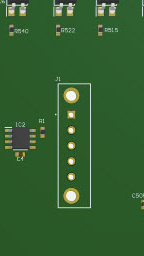
01_Hardware/J1_cropped.png
