seokipo/H2_Control_Board/01_Hardware/rs422결선.jpg

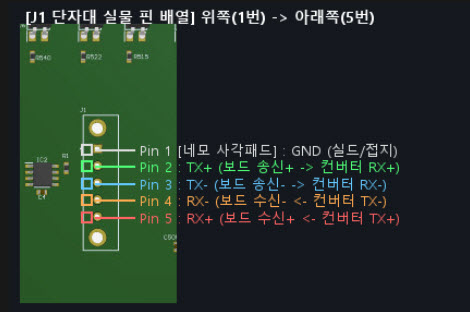
01_Hardware/rs422결선.jpg
