seokipo/H2_Control_Board/02_Firmware/usb_to_rs422_convertor.jpg

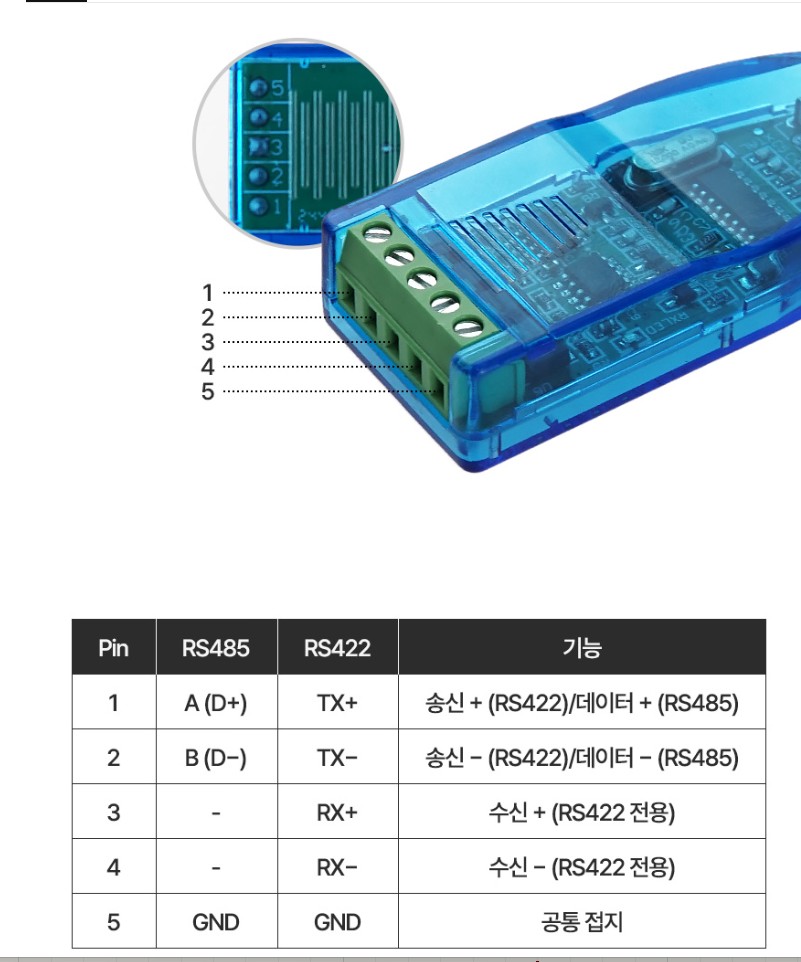
02_Firmware/usb_to_rs422_convertor.jpg
