seokipo/H2_Control_Board/graphify-out/converted/FuelCel_BOM_dc8f4861.md

<!-- converted from FuelCel_BOM.xlsx -->

## Sheet: FuelCell
|  |  | 연료전지 컨트롤러 PCB |  |  |  |  |  |  |  |  |
| --- | --- | --- | --- | --- | --- | --- | --- | --- | --- | --- |
|  |  |  |  |  | 생산수량 | 12 |  |  |  |  |
|  | Comment | Designator | Part No | 규격 | Quantity | Footprint | 재고 | 필요수량 | Price | Price |
| 1 | 포토커플러 | B100, B101, B400, B401, B402, B403, B404, B405, B500, B501, B502, B503, B504, B505, B506, B507, B508, B509, B510, B511, B512, B513, B514, B515, B516, B517, B518, B519, B520, B521, B522, B523, 'B524,B525, B526, B527 | PC357N14J00F |  | 36 |  | 200 | -232 | 81 | 2916 |
| 2 | 다이오드 브릿지 | BD100 | DF06S |  | 1 | DF-S | 1000 | 988 |  | 0 |
| 3 | 칩 세라믹 | C13, C14, C200, C201, C202, C203 | 22p | C1608 | 6 | CC1608 |  | -72 | 23 | 138 |
| 4 | 칩 세라믹 | C304, C305 | 0.01uF | C1608 | 2 | CC1608N | 4000 | 3976 | 10 | 20 |
| 5 | 칩 세라믹 | C5, C7, C8, C9, C10, C12, C206, C207, C208, C209, C300, C301, C306, C307, C308, C309, C310, C311, C312, C313,'C1, C2, C3, C4, C6, C204, C205, C210, C211, C212, C213, C302, C303, C400, C401, C402, C403, C404, C405, C406, C407, C408, C409, C410, C411, C412, C413, C414, C415, C416, C417, C418, C500, C501, C502, C503, C504 | 0.1uF | C1608 | 19 | CC1608N | 5000 | 4772 | 10 | 190 |
| 6 | 칩 세라믹 | C100, C101, C102, C103, C104 | 0.1uF | C2012 | 5 | CC2012 |  | -60 | 2.6 | 13 |
| 7 | 칩 세라믹 | C214, C215 | C4520X7R3D102K130KA | C4520 | 2 | C4520_COMMERCIAL |  | -24 | 550 | 1100 |
| 8 | CHIP 전해 | CP1, CP200, CP300 | CHIP 전해 100uF/16V(MVK) [6.3*6] | CHIP 전해 [6.3파이] | 3 | CP5_SMT |  | -36 | 80 | 240 |
| 9 | CHIP 전해 | CP102, CP103, CP105 | CHIP 전해 470UF/25V(MVK) [10파이] | CHIP 전해 [10파이] | 3 | CP10_SMT |  | -36 | 160 | 480 |
| 10 | CHIP 전해 | CP2, CP201, CP301 | CHIP 전해 220uF/16V(MVK) [6.3*6] | CHIP 전해 [6.3파이] | 3 | CP6_SMT |  | -36 | 85 | 255 |
| 11 | 다이오드 TVS | D1, D501, D502, D505, D506, D508, D509 | SM712.TCT / SM712-02HTG |  | 7 | SOT95P240X115-3N | 0 | -84 | 370 | 2590 |
| 12 | 다이오드 쇼트키 | D400, D401, D402, D403, D404, D405, D406, D407, D408, D409, D410, D411, D412, D413, D414 | BAT54C-G |  | 15 | SOT-23 | 3000 | 2820 |  | 0 |
| 13 | 다이오드 | D500, D503, D504, D507, D510, D511, D512, D513, D514, D515, D516, D517, D518, D519, D520, D521, D522, D523, D524 | sod4007 |  | 19 | MINI-SMA | 3000 | 2772 |  | 0 |
| 14 | NOISE FILTER | L100 | NF_HP10 |  | 1 | NF_HP1 | 0 | -12 |  | 0 |
| 15 | SC1260 | L101, L102, L103 | SC1260-330M(33UH)  |  | 3 | SC1260S | 0 | -36 | 240 | 720 |
| 16 | 칩 LED 1608  | LED100, LED101, LED102, LED103, LED500, LED501, , LED503, LED505,  LED507, LED510, LED511, LED512, LED513, LED514, LED515, LED516, LED517, LED518, LED519, LED520, LED521, LED522 | BL-HUF35A-AV-TRB | 적색 1608 | 22 | LED1608 | 5000 | 4736 |  | 0 |
| 17 | 칩 LED 1608 | LED502, LED504, LED506 ,LED508, LED509,  | BL-HG035A-AV-TRB | 녹색 1608 | 5 | LED1608 | 5000 | 4940 |  | 0 |
| 18 | 칩저항 1608 | R206, R207, R208, R209, R210, R211, R212, R213 | 49.9/1% |  | 8 | RESC1608X55N | 0 | -96 | 0.86 | 6.88 |
| 19 | 칩저항 1608 | R300, R301, R302, R400, R403, R406, R408, R414, R417, R420, R427, R428, R435, R436, R443, R444, R452, R453, R500, R501, R503, R504, R516, R517, R520, R521, R531, R532, R538, R539 | 100 |  | 30 | RESC1608X55N | 0 | -360 | 0.73 | 21.9 |
| 20 | 칩저항 1608 | R4, R7 | 120Ω  /1 % |  | 2 | RESC1608X55N | 0 | -24 | 1 | 2 |
| 21 | 칩저항 1608 | R401, R404, R407, R410, R415, R421, R423, R429, R430, R437, R438, R445, R446, R454, R456 | 249/1% |  | 15 | RESC1608X55N | 5000 | 4820 | 1 | 15 |
| 22 | 칩저항 1608 | R107, R505, R510, R514, R523, R526, R533, R535, R543, R545, R550, R554, R559, R561, R568, R570, R578, R579, R587, R588, R598, R599, R600, R608, R612, R614 | 470 |  | 26 | RESC1608X55N | 0 | -312 | 1 | 26 |
| 23 | 칩저항 1608 | R109 | 1k |  | 1 | RESC1608X55N | 2000 | 1988 | 1 | 1 |
| 24 | 칩저항 1608 | R103, R110, R562, R572, R581, R591, R603 | 2k |  | 7 | RESC1608X55N | 3000 | 2916 | 1 | 7 |
| 25 | 칩저항 1608 | R101, R102, R108, R412, R502, R508, R512, R522, R530, R541, R549, R558, R566, R575, R585, R595, R597, R609, R611 | 3.3k |  | 19 | RESC1608X55N | 3000 | 2772 | 1 | 19 |
| 26 | 칩저항 1608 | R8, R11, R12, R13, R105 | 4.7k |  | 5 | RESC1608X55N | 3000 | 2940 | 1 | 5 |
| 27 | 칩저항 1608 | R5, R6, R9, R10, R111, R200, R201, R202, R203, R204, R205, R411, R418, R425, R433, R440, R448, R506, R507, R509, R511, R513, R515, R518, R519, R524, R525, R527, R528, R529, R534, R536, R537, R540, R542, R544, R546, R547, R548, R551, R552, R553, R555, R556, R557, R560, R563, R565, R567, R569, R571, R573, R576, R577, R580, R582, R584, R586, R589, R590, R596, R601, R604, R610, R615, R616 | 10K |  | 66 | RESC1608X55N | 5000 | 4208 | 1 | 66 |
| 28 | 칩저항 1608 | R100 | 20k |  | 1 | RESC1608X55N | 3000 | 2988 | 1 | 1 |
| 29 | 칩저항 1608 | R104, R106 | 47k |  | 2 | R3216 | 0 | -24 | 1 | 2 |
| 30 | 칩저항 1608 | R564, R574, R583, R592, R605 | 100k |  | 5 | RESC1608X55N | 5000 | 4940 | 1 | 5 |
| 31 | 칩저항 2012 | R419, R426, R434, R442, R449, R451 | 1k |  | 6 | R2012 | 3000 | 2928 | 2.1 | 12.600000000000001 |
| 32 | 칩저항 3216 | R1, R2, R3, R402, R405, R409, R413, R416, R422, R424, R431, R432, R439, R441, R447, R450, R455, R457 | 0 |  | 18 | R3216 | 0 | -216 | 2.1 | 37.800000000000004 |
| 33 | 칩저항 3216 | R593, R602, R606, R613 | 330 |  | 4 | R3216 | 0 | -48 | 2.1 | 8.4 |
| 34 | 칩저항 3216 | R214, R215, R216, R217 | 510k |  | 4 | R3216 | 0 | -48 | 2.1 | 8.4 |
| 35 | IC | IC3 | W25Q256JVEIQ |  | 2 | SOIC127P600X175-8N | 0 | -24 | 9700 | 19400 |
| 36 | IC | IC201, IC202 | W5500 |  | 2 | QFP50P900X900X160-48N | 0 | -24 | 2480 | 4960 |
| 37 | IC | IC300, IC303, IC305, IC306, IC307, IC308 | ADG706BRUZ |  | 6 | SOP65P640X120-28N | 0 | -72 | 7220 | 43320 |
| 38 | IC | IC301 | MAX31856MUD+ |  | 1 | SOP65P640X110-14N | 0 | -12 | 4490 | 4490 |
| 39 | IC | IC301 | MAX3490CSA+ |  | 1 | SOP65P640X110-14N | 0 | -12 | 10100 | 10100 |
| 40 | IC | IC4 | MAX3485CSA+ |  | 1 | SOIC127P600X175-8N | 0 | -12 | 8140 | 8140 |
| 41 | IC | IC400, IC401, IC402, IC403 | ADS1115BQDGSRQ1 |  | 4 | SOP50P490X110-10N | 0 | -48 | 4490 | 17960 |
| 42 | IC | IC5 | DSPIC33CK512MP710-E_PT |  | 1 | QFP40P1400X1400X120-100N | 0 | -12 | 5900 | 5900 |
| 43 | IC | IC500, IC502, IC503 | TLV2374ID |  | 3 | SOIC127P600X175-14N | 0 | -36 | 520 | 1560 |
| 44 | IC | IC501 | DAC60516RUYT |  | 1 | QFN40P400X400X80-29N-D | 0 | -12 | 35800 | 35800 |
| 45 | IC | IC504, IC505 | MOC3063S |  | 2 | SOT254P1016X460-6N | 0 | -24 | 210 | 420 |
| 46 | IC | IC6 | DS3231SN+ |  | 1 | SOIC127P1032X265-16N | 0 | -12 | 8400 | 8400 |
| 47 | L 2012 | L1, L2, L3,L200, L201 | BLM21AG102SN1D |  | 3 | BEADC2012X110N | 0 | -36 | 92 | 276 |
| 48 | 쇼트키 다이오드 | SD100, SD101, SD102 | ss34 | 3A | 3 | SMA | 0 | -36 | 46 | 138 |
| 49 | TR | Q500, Q501, Q502, Q503, Q505, Q507 | KRC105S |  | 6 | SOT-23 | 3000 | 2928 | 30 | 180 |
| 50 | FET | U501, U504, U507, U509, U512, U515, U526, U528 | FDS8880/SQ4184EY-T1_GE3 |  | 8 | SOIC127P600X175-8N | 0 | -96 | 1480 | 11840 |
| 51 | FET | U502, U505, U510, U513, U516, U518, U520, U522, U524 | NTR4003nt1g |  | 9 | SOT-23 | 3000 | 2892 | 80 | 720 |
| 52 | osc | Y1 | 7V-8.000MDDQ-T | X-tal 8Mhz | 1 | 7M8000MEEQT | 0 | -12 | 1050 | 1050 |
| 53 | osc | Y200, Y201 | 7M-25.000MEEQ-T | X-tal 25Mhz | 2 | 7M25000MEEQT | 0 | -24 | 1540 | 3080 |
| 54 | 제너 다이오드 | ZD500, ZD501, ZD502, ZD503, ZD504, ZD505, ZD506, ZD507, ZD508 | CZRW5240B-G | '10V/0.5A | 9 | ZD3216M | 3000 | 2892 | 50 | 450 |
| 55 | 레귤레이터 | IC1, IC200, IC302 |  IL1117C-3.3 |  | 3 | SOT-223 | 3000 | 2964 | 150 | 450 |
| 56 | 레귤레이터 | U101, U103 | LM2576S-12.0/NOPB |  | 2 | KTT0005B | 0 | -24 | 3000 | 6000 |
| 57 | 레귤레이터 | U102 | LM2576S-5.0/NOPB |  | 1 | KTT0005B | 0 | -12 | 2200 | 2200 |
| 58 | 베터리 홀더 | 2032 | BS8  - Voltly / CH7410-2032 | C2032 | 1 | BATT_CASE_2032 |  | -12 | 350 | 350 |
| 59 | 컨넥터 웨이퍼 | CW514, CW521 | SMW250-02D |  | 2 | SMW250-02D | 200 | 176 | 25 | 50 |
| 60 | 컨넥터 웨이퍼 | CW400, CW401, CW402, CW403, CW404, CW407, CW409, CW410, CW411, CW412, CW413, CW414, CW415, CW416, CW417, CW418, CW420, CW421, CW501, CW503, CW505, CW509, CW513, CW516, CW520, CW523, CW526, CW528 | SMW250-03D |  | 28 | SMW250-03D | 0 | -336 | 31.2 | 873.6 |
| 61 | 컨넥터 웨이퍼 | CW405, CW419 | SMW250-04D |  | 2 | SMW250-04D | 0 | -24 | 57.5 | 115 |
| 62 | 컨넥터 웨이퍼 | CW406, CW408 | SMW250-05D |  | 2 | SMW250-05D | 0 | -24 | 67.2 | 134.4 |
| 63 | 컨넥터 웨이퍼 | CW100, CW500, CW502, CW504, CW506, CW508, CW511, CW512, CW519, CW524, CW529 | YW396_02V |  | 11 | YW396_02 | 0 | -132 | 20 | 220 |
| 64 | 컨넥터 웨이퍼 | CW507, CW510, CW517, CW518 | YW396_03V |  | 4 | YW396_03 | 0 | -48 | 23 | 92 |
| 65 | 컨넥터 웨이퍼 | CW515, CW522, CW525, CW527 | YW396_04V |  | 4 | YW396_04 | 0 | -48 | 35 | 140 |
| 66 | 컨넥터 웨이퍼 | J1 | 1843253 |  | 1 | 1818025 | 0 | -12 |  | 0 |
| 67 | 컨넥터 웨이퍼 | J201,J200 | 0438600013 |  | 2 | 0438600013 | 0 | -24 | 5380 | 10760 |
| 68 | 컨넥터 웨이퍼 | J300, J301, J302, J303, J304, J305, J306, J307 | 1990083 |  | 8 | 1990083 | 0 | -96 | 2320 | 18560 |
| 69 | 저항 | R594, R607 | 330/1w DIP | 330/1w DIP | 2 | 1 W | 0 | -24 | 35 | 70 |
| 70 | FUSE_CASE | FUSE100, FUSE101 | 4527 |  | 2 | FUSE_HOLD_S | 0 | -24 |  | 0 |
| 71 | IC | IC304 | LM35DZ/NOPB |  | 1 | TO92 | 0 | -12 | 610 | 610 |
| 72 | 트라이액 | Q504 | Z0405MH  |  | 1 | TO-251-3 | 100 | 88 | 150 | 150 |
| 73 | 트라이액 | Q506 | BTA16-600B  | 16A/600V | 1 | TO-220-HT | 0 | -12 | 800 | 800 |
| 74 | 전해 콘덴서  | CP100, CP101, CP104 | 1000uF/50V | DIP | 3 | CP5_12 |  | -36 | 205 | 615 |
| 75 | 릴례이 | U517, U519, U521, U523, U525, U527 | HL2-2CM-dc24v |  | 6 | HL2-2CM | 100 | 28 | 1200 | 7200 |
| 76 | 터미널 블록 | TM100 | HP-1000SA-3pin |  | 1 | TERMINAL_10_3 | 0 | -12 | 390 | 390 |
| 77 | 터미널 블록 | TM101 | HP-1000SA-2pin |  | 1 | TERMINAL_10_2 | 0 | -12 | 260 | 260 |
| 78 | 터미널 블록 | TN500 | HP-1000SA-14pin |  | 1 | TERMINAL_10_14 | 10 | -2 | 1620 | 1620 |
| 79 | AC-DC컨버터 | U100 | IRM-30-24 |  | 1 | IRM-30-24 | 0 | -12 | 14300 | 14300 |
| 80 | MF 컨덴서 | MF100 | 0.1uF |  | 1 | MF_104_FILKOR | 0 | -12 | 60 | 60 |
| 81 | MF 컨덴서 | MF500, MF501 | 104/400v |  | 2 | MF_104_FILKOR | 0 | -24 | 60 | 120 |
| 82 | Test Point_top |  | TP_KEYSTONE_5000 | C5000 | 82 | TP_KEYSTONE_5000 |  | -100 | 330 | 27060 |
|  |  |  | (-) 재고만 부탁합니다. | 칩 저항, 칩 콘덴서는 REEL단위 구매 |  |  |  |  | 137129.49 | 280290.98 |
