seokipo/H2_Control_Board/01_Hardware/Docs/0812 견적및 발주.xlsx

 |  |  |  | 생산수량 | 12 | 2026-08-13 10:03
 | Comment | Part No | 규격 | Quantity | Footprint | Part No. | 재고 | 필요수량 | moq | Price |  | 납기
1 | 포토커플러 | PC357N14J00F/TLP185GB (대치품) |  | 36 |  |  | 200 | -232 | 900 | 81.00 | 72900.00 | 1일
3 | 칩 세라믹 | 22p / 50V | C1608 | 6 | CC1608 | {Part No} |  | -72 | 4000 | 23.00 | 92000.00 | 1일
6 | 칩 세라믹 | 0.1uF / 50V | C2012 | 5 | CC2012 | C2012X7R1H104KT (CC20X104K50W) |  | -60 | 4000 | 2.60 | 10400.00 | STOCK
7 | 칩 세라믹 | C4520X7R3D102K130KA | C4520 | 2 | C4520_COMMERCIAL |  |  | -24 | 70 | 550.00 | 38500.00 | 7일
8 | CHIP 전해 | CHIP 전해 100uF/16V(MVK) [6.3*6] | CHIP 전해 [6.3파이] | 3 | CP5_SMT | {Part No} |  | -36 | 100 | 80.00 | 8000.00 | 1일
9 | CHIP 전해 | CHIP 전해 470UF/25V(MVK) [10파이] | CHIP 전해 [10파이] | 3 | CP10_SMT | {Value} |  | -36 | 100 | 160.00 | 16000.00 | 1일
10 | CHIP 전해 | CHIP 전해 220uF/16V(MVK) [6.3*6] | CHIP 전해 [6.3파이] | 3 | CP6_SMT | RV16V220 6.3X7.7 (ELNA / 삼영) |  | -36 | 100 | 85.00 | 8500.00 | 1일
11 | 다이오드 TVS | SM712.TCT / SM712-02HTG |  | 7 | SOT95P240X115-3N | sm712 | 0 | -84 | 210 | 370.00 | 77700.00 | 4일
14 | NOISE FILTER | NF-HP10 |  | 1 | NF_HP1 | HP1-P10 | 0 | -12 |  |  | 0.00 | 불가
15 | SC1260 | SC1260-330M(33UH) |  | 3 | SC1260S | VLP8040T-100M | 0 | -36 | 100 | 240.00 | 24000.00 | STOCK
18 | 칩저항 1608 | 49.9/1% |  | 8 | RESC1608X55N | {Part No} | 0 | -96 | 5000 | 0.86 | 4300.00 | STOCK
19 | 칩저항 1608 | 100 |  | 30 | RESC1608X55N | {Part No} | 0 | -360 | 5000 | 0.73 | 3650.00 | STOCK | J급
20 | 칩저항 1608 | 120Ω /1 % |  | 2 | RESC1608X55N | {Part No} | 0 | -24 | 5000 | 0.86 | 4300.00 | STOCK
22 | 칩저항 1608 | 470 |  | 26 | RESC1608X55N | {Part No} | 0 | -312 | 5000 | 0.73 | 3650.00 | STOCK
29 | 칩저항 1608 | 47k |  | 2 | R3216 | {Part No} | 0 | -24 | 5000 | 2.10 | 10500.00 | STOCK | J급
32 | 칩저항 3216 | 0 |  | 18 | R3216 | {Part No} | 0 | -216 | 5000 | 2.10 | 10500.00 | STOCK | J급
33 | 칩저항 3216 | 330 |  | 4 | R3216 | {Part No} | 0 | -48 | 5000 | 2.10 | 10500.00 | STOCK | J급
34 | 칩저항 3216 | 510k |  | 4 | R3216 | {Part No} | 0 | -48 | 5000 | 2.10 | 10500.00 | STOCK | J급
35 | IC | W25Q256JVEIQ |  | 1 | SOIC127P600X175-8N |  | 0 | -12 | 30 | 9700.00 | 291000.00 | 7일
36 | IC | W5500 |  | 2 | QFP50P900X900X160-48N |  | 0 | -24 | 60 | 2480.00 | 148800.00 | 1일
37 | IC | MAX3490CSA+ |  | 1 | SON127P800X600X80-9N-D |  | 0 | -12 | 30 | 10100.00 | 303000.00 | 5일 | 단종아이템 (16년도 데이터 코드)
38 | IC | ADG706BRUZ |  | 6 | SOP65P640X120-28N |  | 0 | -72 | 180 | 7220.00 | 1299600.00 | 7~8일
39 | IC | MAX31856MUD+ |  | 1 | SOP65P640X110-14N |  | 0 | -12 | 30 | 4490.00 | 134700.00 | 4일
40 | IC | LM35DZ/NOPB |  | 1 | TO92 |  | 0 | -12 | 30 | 610.00 | 18300.00 | 4일
41 | IC | MAX3485CSA+ |  | 1 | SOIC127P600X175-8N |  | 0 | -12 | 30 | 8140.00 | 244200.00 | 4일
42 | IC | ADS1115BQDGSRQ1 |  | 4 | SOP50P490X110-10N |  | 0 | -48 | 120 | 4490.00 | 538800.00 | 4일
43 | IC | DSPIC33CK512MP710-E_PT |  | 1 | QFP40P1400X1400X120-100N |  | 0 | -12 | 30 | 5900.00 | 177000.00 | 7일
44 | IC | TLV2374ID |  | 3 | SOIC127P600X175-14N |  | 0 | -36 | 90 | 520.00 | 46800.00 | 4일
45 | IC | DAC60516RUYT |  | 1 | QFN40P400X400X80-29N-D |  | 0 | -12 | 30 | 35800.00 | 1074000.00 | 4일
46 | IC | MOC3063S |  | 2 | SOT254P1016X460-6N |  | 0 | -24 | 60 | 210.00 | 12600.00 | 4일
47 | IC | DS3231SN+ |  | 1 | SOIC127P1032X265-16N |  | 0 | -12 | 30 | 8400.00 | 252000.00 | 7~8일
48 | L 2012 | BLM21AG102SN1D |  | 3 | BEADC2012X110N | BLM21AG102 | 0 | -36 | 100 | 92.00 | 9200.00 | STOCK
49 | 쇼트키 다이오드 | ss34 | 3A | 3 | SMA | SS34 | 0 | -36 | 100 | 46.00 | 4600.00 | STOCK
51 | FET | FDS8880/SQ4184EY-T1_GE3 |  | 8 | SOIC127P600X175-8N | FDS5672, IRF7413 | 0 | -96 | 240 | 1480.00 | 355200.00 | 4일
53 | osc | 7V-8.000MDDQ-T | X-tal 8Mhz | 1 | 7M8000MEEQT |  | 0 | -12 | 30 | 1050.00 | 31500.00 | 7일
54 | osc | 7M-25.000MEEQ-T | X-tal 25Mhz | 2 | 7M25000MEEQT |  | 0 | -24 | 60 | 1540.00 | 92400.00 | 7일
57 | 레귤레이터 | LM2576S-12.0/NOPB |  | 2 | KTT0005B |  | 0 | -24 | 60 | 3000.00 | 180000.00 | 4일
58 | 레귤레이터 | LM2576S-5.0/NOPB |  | 1 | KTT0005B | LM2576S-3.3/NOPB | 0 | -12 | 30 | 2200.00 | 66000.00 | 4일
59 | 베터리 홀더 | BS8 - Voltly / CH7410-2032 | C2032 | 1 | BATT_CASE_2032 | cr2032 |  | -12 | 30 | 350.00 | 10500.00 | STOCK
61 | 컨넥터 웨이퍼 | SMW250-03D |  | 28 | SMW250-03D | SMW025-03, smw025-03d, {Part No} | 0 | -336 | 1000 | 31.20 | 31200.00 | 1일
62 | 컨넥터 웨이퍼 | SMW250-04D |  | 2 | SMW250-04D | SMW025-04, smw250-04d | 0 | -24 | 60 | 57.50 | 3450.00 | 1일
63 | 컨넥터 웨이퍼 | SMW250-05D |  | 2 | SMW250-05D | smw025-05 | 0 | -24 | 60 | 67.20 | 4032.00 | 1일
64 | 컨넥터 웨이퍼 | YW396_02V |  | 11 | YW396_02 | YW396-02 | 0 | -132 | 330 | 20.00 | 6600.00 | 1일
65 | 컨넥터 웨이퍼 | YW396_03V |  | 4 | YW396_03 | YW396-03 | 0 | -48 | 120 | 23.00 | 2760.00 | 1일
66 | 컨넥터 웨이퍼 | YW396_04V |  | 4 | YW396_04 | {Part No}, yw396-04 | 0 | -48 | 120 | 35.00 | 4200.00 | 1일
67 | 컨넥터 웨이퍼 | 1843253 |  | 1 | 1843253 |  | 0 | -12 |  |  | 0.00 | 재고 없음 (대치품 확인중)
68 | 컨넥터 웨이퍼 | 0438600013 |  | 2 | 0438600013 |  | 0 | -24 | 60 | 5380.00 | 322800.00 | 7일
69 | 컨넥터 웨이퍼 | 1990083 |  | 8 | 1990083 |  | 0 | -96 | 240 | 2320.00 | 556800.00 | 7일
70 | 저항 | 330/1w DIP | 330/1w DIP | 2 | 1 W | {Part No} | 0 | -24 | 100 | 35.00 | 3500.00 | STOCK | J급
71 | FUSE_CASE | FUSE_CASE |  | 2 | FUSE_HOLD_S | {Part No} | 0 | -24 |  |  | 0.00
73 | 트라이액 | BTA16-600B | 16A/600V | 1 | TO-220-HT | BAT16-400B | 0 | -12 | 30 | 800.00 | 24000.00 | STOCK
74 | 전해 콘덴서 | 1000uF/50V | DIP | 3 | CP5_12 | {Part No} |  | -36 | 100 | 205.00 | 20500.00 | 1일 | 전해 1000UF/50V(KMG) [12.5X25]
75 | 릴리에 | HL2-2CM-dc24v / HL2-2CM-24S |  | 6 | HL2-2CM | {Part No} | 100 | 28 | 80 |  | 0.00 | 확인중
76 | 터미널 블록 | HP-1000SA-3pin |  | 1 | TERMINAL_10_3 | {PartNo} | 0 | -12 | 30 | 390.00 | 11700.00 | 1일
77 | 터미널 블록 | HP-1000SA-2pin |  | 1 | TERMINAL_10_2 | {PartNo} | 0 | -12 | 30 | 260.00 | 7800.00 | 1일
78 | 터미널 블록 | HP-1000SA-14pin |  | 1 | TERMINAL_10_14 | {Part No} | 10 | -2 | 20 | 1620.00 | 32400.00 | 7일 / 최초 20개 가능/ 차후 MOQ - 50개
79 | AC-DC컨버터 | IRM-30-24 |  | 1 | IRM-30-24 | LH25-10B24 | 0 | -12 | 30 | 14300.00 | 429000.00 | 1~2일
80 | MF 컨덴서 | 0.1uF | MF 104 AC250V 10MM 피치 | 1 | MF_104_FILKOR | {Part No} | 0 | -12 | 100 | 60.00 | 6000.00 | STOCK
81 | MF 컨덴서 | 104/400v |  | 2 | MF_104_FILKOR | {Part No} | 0 | -24 |  |  | 0.00
82 | Test Point_top | TP_KEYSTONE_5000 | C5000 | 82 | TP_KEYSTONE_5000 |  |  | -100 | 100 | 330.00 | 33000.00 | 7일
 |  |  |  |  |  |  |  |  |  |  | 7195842.00
 |  | - 재고만 부탁합니다. | 칩 저항, 칩 콘덴서는 REEL단위 구매
