seokipo/H2_Control_Board/(list of files, cad)

Other CAD files:
01_Hardware/Docs/PCB부품/1818025/Allegro/1818025.psm
01_Hardware/Docs/PCB부품/1818025/DEHDL/1818025/chips/chips.prt
01_Hardware/Docs/PCB부품/185464862-122-1751581/1751581/Allegro/1751581.psm
01_Hardware/Docs/PCB부품/185464862-122-1751581/1751581/DEHDL/1751581/chips/chips.prt
