seokipo/H2_Control_Board/01_Hardware/J1_pinout_guide.png

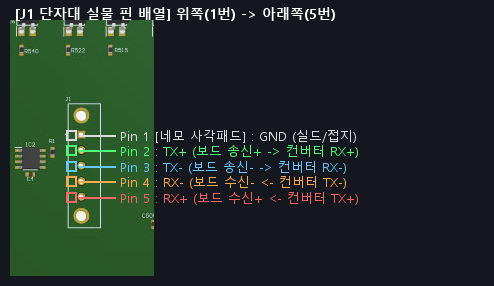
01_Hardware/J1_pinout_guide.png
