seokipo/H2_Control_Board/03_Control_UI/H2ControlTest.html

# 6kW & 10kW BOP Control Board

10kW 기준 설계 매핑 대시보드 (6kW 축소 사양 음영 공용화 활성화)

포트 미연결 (OFF)

2026년 08월 11일

08:00:00

⚡ 시퀀스 제어 매니저 📡 실시간 패킷 스트리머 통신 디버그 모니터

─ 🗖 ✕

온도 센서 측정 현황 (TC 스캐너 매핑)

총 40개 채널 매핑

T-Type (CH1 ~ CH10)

측정 위치 (CH) | NET | 온도 (°C)

T-Type (CH11 ~ CH20)

측정 위치 (CH) | NET | 온도 (°C)

K-Type (CH21 ~ CH30)

측정 위치 (CH) | NET | 온도 (°C)

K-Type (CH31 ~ CH40)

측정 위치 (CH) | NET | 온도 (°C)

아날로그 입력 수신 현황 (ADS1115 ADC 독립 계측)

ADC 8-CH (독립 센서)

측정 장치명 | NETNAME | RAW | 전압 | 환산 계측값

측정 장치명 | NETNAME | RAW | 전압 | 환산 계측값

보드 연동 시리얼 장치 계측 현황 (Internal Sub-Serial)

BOP Board Link

장비명 | NETNAME | 모델명 및 사양 | 통신 데이터 계측값 | TX/RX | 상태

디지털 입력 상태 (DI 8채널)

Discrete Inputs

아날로그 제어 출력 & 피드백 센서 연동 (DAC60516 11채널)

DAC 11-CH / PID Closed-Loop

구동 장치 / 피드백 센서 | NET | RAW | 전압/상태 | 제어율 / 계측(SP) | 모드

구동 장치 / 피드백 센서 | NET | RAW | 전압/상태 | 제어율 / 계측(SP) | 모드

디지털 릴레이 및 밸브 출력 (DO 20채널)

Coils / Outputs

📡 실시간 RS-422 통신 패킷 스트리머

9600 bps | 8-N-1

📋 복사 🗑️ 비우기 ×

🟢 TX: 0 🔵 RX: 0 주기: 400ms

자동 스크롤 | CRC16: 0xA001

[SYSTEM] 📡 실시간 RS-422 통신 패킷 스트리머 대기 중... 포트 연결 시 송수신 패킷이 표시됩니다.

0x04: 센서 계측 0x03: 설정 조회 0x06: 단일 제어 0x05: 코일 제어

Full-Duplex RS-422

×

아날로그 제어 & PID 설정

제어 구동 장치명

제어 모드 전환

🔗 PID LINK ON

🎯 PID Closed-Loop 목표값(SP) 제어 피드백: AI_MFM211

목표값 설정 (SP Slider) 450.0 LPM

직접 입력 목표값 (SP)

현재 센서 계측값 (PV)

486.67 LPM

🎯 목표 설정값(SP) 적용 및 PID 추종 개시

🔓 단독 수동 직결 제어 (Open-Loop Manual DAC)

출력 조절 슬라이더 (0.0% ~ 100.0%)

0.00 %

설정 코드 값 (RAW, 0~65535)

환산 출력 전압 (V)

0.000 V

수동 제어 명령 송출 (Write Register)

🤖 수소 연료전지 자동 제어 시퀀스 매니저

↗ 별도 창 분리 ×

실행 제어 레시피 선택 (Recipe Selector)

레시피를 선택하면 제어 스텝 및 설명이 표시됩니다.

▶ 시작 ❚❚ 일시정지 ◼ 강제 정지

상태: 대기 중 (IDLE) 0.0 %

시퀀스 세부 스텝 진행 정보

[SYSTEM LOG] 시퀀스 매니저 준비 완료. 드래그하여 패널을 이동할 수 있습니다.

×

Modbus RTU Packet Simulator & Monitor

🔌 물리 통신 포트 설정 (RS-422 / Ethernet)

제어 모드: 가상 시뮬레이션 모드 웹소켓 실전 모드 (ws://)

통신 인터페이스

시리얼 포트 (COM)

통신 속도 (Baud Rate)

IP 주소 (IPv4 Host)

포트 번호 (TCP Port)

패리티 비트 (Parity)

스톱 비트 (Stop Bits)

포트 연결하기

Slave Address (국번)

Function Code (명령)

Start Address (시작 번지)

Quantity / Data Value (수량 또는 제어코드)

가상 Modbus 패킷 송출

시리얼 라인 데이터 모니터 (RX / TX Frame)

[SYSTEM] BOP 시리얼 디버그 링크 기동. 통신 프레임 대기 중...
