seokipo/H2_Control_Board/02_Firmware/H2_Firmware.X/queuelogs/debugtool.txt

484 1788132266880 GEN4_CONNECT_DIAGNOSTICS:Before MPLABCommTool.Connect()
484 1788132266880 GEN4_CONNECT_DIAGNOSTICS:After MPLABCommTool.Connect()
484 1788132266880 GEN4_CONNECT_DIAGNOSTICS:MPLABCommTool.Connect() returned MPLABCOMM_NO_ERROR
484 1788132266881 GEN4_CONNECT_DIAGNOSTICS:Attaching to MPLABCommTool plugnplay
484 1788132266881 GEN4_CONNECT_DIAGNOSTICS:Adding new plug and play observer com.microchip.mplab.mdbcore.RI4Tool.RI4ToolBase$RI4PlugNPlayObserver@493b75ae
484 1788132266881 GEN4_CONNECT_DIAGNOSTICS:Begin PlugNPlayObservers list dump:
484 1788132266881 GEN4_CONNECT_DIAGNOSTICS:com.microchip.mplab.mdbcore.RI4Tool.RI4ToolBase$RI4PlugNPlayObserver@493b75ae
484 1788132266881 GEN4_CONNECT_DIAGNOSTICS:End PlugNPlayObservers list dump:
484 1788132266881 GEN4_CONNECT_DIAGNOSTICS:Registering for alternate PNP notifications. CommPnPCriteria.cPIDList = [2177, 2179, 217a, 2141, 9017, 901b, 9036, 9035], CommPnPCriteria.cSerialNumber = bur211672921

484 1788132266921 GEN4_TO_CONTROLLER_LOG:GEN4_INIT_INT_LOG_dsPIC33CK512MP710 Pre:init
484 1788132266921 GEN4_TO_CONTROLLER_LOG:GEN4_INIT_INT_LOG_dsPIC33CK512MP710 Payload
484 1788132266921 GEN4_TO_CONTROLLER_LOG:GEN4_INIT_INT_LOG_dsPIC33CK512MP710 DeviceInfo: Values:
484 1788132266921 GEN4_TO_CONTROLLER_LOG:GEN4_INIT_INT_LOG_dsPIC33CK512MP710 DeviceInfo: pcAddress = 0000002e, Vpp = 3.25, useRowEraseIfVoltageIsLow = false, voltageBelowWhichUseRowErase = 0.00, deviceName = dsPIC33CK512MP710, programmerType = DSPIC33EP
484 1788132266921 GEN4_TO_CONTROLLER_LOG:GEN4_INIT_INT_LOG_dsPIC33CK512MP710 DeviceInfo: MemInfo values:
484 1788132266921 GEN4_TO_CONTROLLER_LOG:GEN4_INIT_INT_LOG_dsPIC33CK512MP710 DeviceInfo: mask = ffffff, exists = true, startAddr = 00000000, endAddr = 00057eff, rowSize = 0800, rowEraseSize = 0800, addrInc = 0002, widthProgram = 0004
484 1788132266921 GEN4_TO_CONTROLLER_LOG:GEN4_INIT_INT_LOG_dsPIC33CK512MP710 DeviceInfo: mask = ffff, exists = true, startAddr = 00057f00, endAddr = 00057fff, rowSize = 0001, rowEraseSize = 0000, addrInc = 0002, widthProgram = 0004
484 1788132266921 GEN4_TO_CONTROLLER_LOG:GEN4_INIT_INT_LOG_dsPIC33CK512MP710 DeviceInfo: mask = 0000, exists = false, startAddr = 00000000, endAddr = 00000000, rowSize = 0000, rowEraseSize = 0800, addrInc = 0000, widthProgram = 0000
484 1788132266921 GEN4_TO_CONTROLLER_LOG:GEN4_INIT_INT_LOG_dsPIC33CK512MP710 DeviceInfo: mask = 0000, exists = false, startAddr = 00000000, endAddr = 00000000, rowSize = 0000, rowEraseSize = 0000, addrInc = 0000, widthProgram = 0000
484 1788132266921 GEN4_TO_CONTROLLER_LOG:GEN4_INIT_INT_LOG_dsPIC33CK512MP710 DeviceInfo: mask = 0000, exists = false, startAddr = 00000000, endAddr = 00000000, rowSize = 0000, rowEraseSize = 0000, addrInc = 0000, widthProgram = 0000
484 1788132266921 GEN4_TO_CONTROLLER_LOG:GEN4_INIT_INT_LOG_dsPIC33CK512MP710 DeviceInfo: mask = ffffff, exists = true, startAddr = 00800000, endAddr = 008016ff, rowSize = 0800, rowEraseSize = 0800, addrInc = 0002, widthProgram = 0004
484 1788132266921 GEN4_TO_CONTROLLER_LOG:GEN4_INIT_INT_LOG_dsPIC33CK512MP710 DeviceInfo: mask = 0000, exists = false, startAddr = 00000000, endAddr = 00000000, rowSize = 0000, rowEraseSize = 0000, addrInc = 0002, widthProgram = 0002
484 1788132266921 GEN4_TO_CONTROLLER_LOG:GEN4_INIT_INT_LOG_dsPIC33CK512MP710 DeviceInfo: mask = 0000, exists = false, startAddr = 00000000, endAddr = 00000000, rowSize = 0000, rowEraseSize = 0000, addrInc = 0000, widthProgram = 0000
484 1788132266921 GEN4_TO_CONTROLLER_LOG:GEN4_INIT_INT_LOG_dsPIC33CK512MP710 DeviceInfo: mask = 0000, exists = false, startAddr = 00000000, endAddr = 00000000, rowSize = 0000, rowEraseSize = 0000, addrInc = 0000, widthProgram = 0000
484 1788132266921 GEN4_TO_CONTROLLER_LOG:GEN4_INIT_INT_LOG_dsPIC33CK512MP710 DeviceInfo: mask = 0000, exists = false, startAddr = 00000000, endAddr = 00000000, rowSize = 0000, rowEraseSize = 0000, addrInc = 0000, widthProgram = 0000
484 1788132266921 GEN4_TO_CONTROLLER_LOG:GEN4_INIT_INT_LOG_dsPIC33CK512MP710 DeviceInfo: mask = 0000, exists = false, startAddr = 00000000, endAddr = 00000000, rowSize = 0000, rowEraseSize = 0000, addrInc = 0002, widthProgram = 0002
484 1788132266921 GEN4_TO_CONTROLLER_LOG:GEN4_INIT_INT_LOG_dsPIC33CK512MP710 DeviceInfo: mask = 0000, exists = false, startAddr = 00000000, endAddr = 00000000, rowSize = 0000, rowEraseSize = 0000, addrInc = 0000, widthProgram = 0000
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
484 1788132266921 GEN4_TO_CONTROLLER_LOG:GEN4_INIT_INT_LOG_dsPIC33CK512MP710 Address = 00057f38, Mask = 0000ffff
484 1788132266921 GEN4_TO_CONTROLLER_LOG:GEN4_INIT_INT_LOG_dsPIC33CK512MP710 Address = 00057f3c, Mask = 00000001
484 1788132266921 GEN4_TO_CONTROLLER_LOG:GEN4_INIT_INT_LOG_dsPIC33CK512MP710 Address = 00057f40, Mask = 00003438
484 1788132266921 GEN4_TO_CONTROLLER_LOG:GEN4_INIT_INT_LOG_dsPIC33CK512MP710 Address = 00057f44, Mask = 00007777
484 1788132266921 GEN4_TO_CONTROLLER_LOG:GEN4_INIT_INT_LOG_dsPIC33CK512MP710 Address = 00057ffc, Mask = 00ffffff
484 1788132266921 GEN4_TO_CONTROLLER_LOG:GEN4_INIT_INT_LOG_dsPIC33CK512MP710 BasicInfo: Values:
484 1788132266921 GEN4_TO_CONTROLLER_LOG:GEN4_INIT_INT_LOG_dsPIC33CK512MP710 BasicInfo: InputStream = java.util.zip.ZipInputStream@71e847ce, ToolFlavor = PICKit4
484 1788132266921 GEN4_TO_CONTROLLER_LOG:GEN4_INIT_INT_LOG_dsPIC33CK512MP710 Payload End
484 1788132266922 GEN4_TO_CONTROLLER_LOG:GEN4_INIT_INT_LOG_dsPIC33CK512MP710 Post:init
484 1788132266922 GEN4_TO_CONTROLLER_LOG:GEN4_INIT_INT_LOG_dsPIC33CK512MP710 Return Value
484 1788132266922 GEN4_TO_CONTROLLER_LOG:GEN4_INIT_INT_LOG_dsPIC33CK512MP710 none
484 1788132266922 GEN4_TO_CONTROLLER_LOG:GEN4_INIT_INT_LOG_dsPIC33CK512MP710 Return End

484 1788132266922 GEN4_TO_CONTROLLER_LOG:GEN4_INIT_INT_LOG_dsPIC33CK512MP710 Pre:GetInterfaceProvider
484 1788132266922 GEN4_TO_CONTROLLER_LOG:GEN4_INIT_INT_LOG_dsPIC33CK512MP710 Payload
484 1788132266922 GEN4_TO_CONTROLLER_LOG:GEN4_INIT_INT_LOG_dsPIC33CK512MP710 RI4DebugInterface
484 1788132266922 GEN4_TO_CONTROLLER_LOG:GEN4_INIT_INT_LOG_dsPIC33CK512MP710 Payload End
484 1788132266922 GEN4_TO_CONTROLLER_LOG:GEN4_INIT_INT_LOG_dsPIC33CK512MP710 Post:GetInterfaceProvider
484 1788132266922 GEN4_TO_CONTROLLER_LOG:GEN4_INIT_INT_LOG_dsPIC33CK512MP710 Return Value
484 1788132266922 GEN4_TO_CONTROLLER_LOG:GEN4_INIT_INT_LOG_dsPIC33CK512MP710 com.microchip.mplab.libs.RI4ToolsController.implementations.RI4DebugInterfaceImpl@35807132
484 1788132266922 GEN4_TO_CONTROLLER_LOG:GEN4_INIT_INT_LOG_dsPIC33CK512MP710 Return End

484 1788132266922 GEN4_TO_CONTROLLER_LOG:GEN4_INIT_INT_LOG_dsPIC33CK512MP710 Pre:GetInterfaceProvider
484 1788132266922 GEN4_TO_CONTROLLER_LOG:GEN4_INIT_INT_LOG_dsPIC33CK512MP710 Payload
484 1788132266922 GEN4_TO_CONTROLLER_LOG:GEN4_INIT_INT_LOG_dsPIC33CK512MP710 RI4ProgramInterface
484 1788132266922 GEN4_TO_CONTROLLER_LOG:GEN4_INIT_INT_LOG_dsPIC33CK512MP710 Payload End
484 1788132266922 GEN4_TO_CONTROLLER_LOG:GEN4_INIT_INT_LOG_dsPIC33CK512MP710 Post:GetInterfaceProvider
484 1788132266922 GEN4_TO_CONTROLLER_LOG:GEN4_INIT_INT_LOG_dsPIC33CK512MP710 Return Value
484 1788132266922 GEN4_TO_CONTROLLER_LOG:GEN4_INIT_INT_LOG_dsPIC33CK512MP710 com.microchip.mplab.libs.RI4ToolsController.implementations.RI4ProgramInterfaceImpl@2784e429
484 1788132266922 GEN4_TO_CONTROLLER_LOG:GEN4_INIT_INT_LOG_dsPIC33CK512MP710 Return End

484 1788132266922 GEN4_TO_CONTROLLER_LOG:GEN4_INIT_INT_LOG_dsPIC33CK512MP710 Pre:GetInterfaceProvider
484 1788132266922 GEN4_TO_CONTROLLER_LOG:GEN4_INIT_INT_LOG_dsPIC33CK512MP710 Payload
484 1788132266922 GEN4_TO_CONTROLLER_LOG:GEN4_INIT_INT_LOG_dsPIC33CK512MP710 RI4ConnectInterface
484 1788132266922 GEN4_TO_CONTROLLER_LOG:GEN4_INIT_INT_LOG_dsPIC33CK512MP710 Payload End
484 1788132266922 GEN4_TO_CONTROLLER_LOG:GEN4_INIT_INT_LOG_dsPIC33CK512MP710 Post:GetInterfaceProvider
484 1788132266922 GEN4_TO_CONTROLLER_LOG:GEN4_INIT_INT_LOG_dsPIC33CK512MP710 Return Value
484 1788132266922 GEN4_TO_CONTROLLER_LOG:GEN4_INIT_INT_LOG_dsPIC33CK512MP710 com.microchip.mplab.libs.PK4ToolsController.PK4ConnectInterfaceImpl@5f555670
484 1788132266922 GEN4_TO_CONTROLLER_LOG:GEN4_INIT_INT_LOG_dsPIC33CK512MP710 Return End
484 1788132266923 GEN4_CONNECT_DIAGNOSTICS:acceptablePIDs = [9012, 9017, 901b, 9036, 9035]
484 1788132266923 GEN4_CONNECT_DIAGNOSTICS:otherPIDs = [2177, 2179, 217a, 2141]
484 1788132266923 GEN4_CONNECT_DIAGNOSTICS:Setting selected tool type to pk4
484 1788132266923 GEN4_CONNECT_DIAGNOSTICS:otherPIDs = [2177, 2179, 217a, 2141]
484 1788132266923 GEN4_CONNECT_DIAGNOSTICS:acceptablePIDs = [9012, 9017, 901b, 9036, 9035]

484 1788132266923 GEN4_TO_CONTROLLER_LOG:GEN4_INIT_INT_LOG_dsPIC33CK512MP710 Pre:GetInterfaceProvider
484 1788132266923 GEN4_TO_CONTROLLER_LOG:GEN4_INIT_INT_LOG_dsPIC33CK512MP710 Payload
484 1788132266923 GEN4_TO_CONTROLLER_LOG:GEN4_INIT_INT_LOG_dsPIC33CK512MP710 RI4ControllerDiagnosticsInterface
484 1788132266923 GEN4_TO_CONTROLLER_LOG:GEN4_INIT_INT_LOG_dsPIC33CK512MP710 Payload End
484 1788132266923 GEN4_TO_CONTROLLER_LOG:GEN4_INIT_INT_LOG_dsPIC33CK512MP710 Post:GetInterfaceProvider
484 1788132266923 GEN4_TO_CONTROLLER_LOG:GEN4_INIT_INT_LOG_dsPIC33CK512MP710 Return Value
484 1788132266923 GEN4_TO_CONTROLLER_LOG:GEN4_INIT_INT_LOG_dsPIC33CK512MP710 com.microchip.mplab.libs.RI4ToolsController.implementations.RI4ControllerDiagnosticsInterfaceImpl@6c30bc63
484 1788132266923 GEN4_TO_CONTROLLER_LOG:GEN4_INIT_INT_LOG_dsPIC33CK512MP710 Return End

484 1788132266923 GEN4_TO_CONTROLLER_LOG:GEN4_INIT_INT_LOG_dsPIC33CK512MP710 Pre:GetInterfaceProvider
484 1788132266923 GEN4_TO_CONTROLLER_LOG:GEN4_INIT_INT_LOG_dsPIC33CK512MP710 Payload
484 1788132266923 GEN4_TO_CONTROLLER_LOG:GEN4_INIT_INT_LOG_dsPIC33CK512MP710 ProgrammerToGo
484 1788132266923 GEN4_TO_CONTROLLER_LOG:GEN4_INIT_INT_LOG_dsPIC33CK512MP710 Payload End
484 1788132266923 GEN4_TO_CONTROLLER_LOG:GEN4_INIT_INT_LOG_dsPIC33CK512MP710 Post:GetInterfaceProvider
484 1788132266923 GEN4_TO_CONTROLLER_LOG:GEN4_INIT_INT_LOG_dsPIC33CK512MP710 Return Value
484 1788132266923 GEN4_TO_CONTROLLER_LOG:GEN4_INIT_INT_LOG_dsPIC33CK512MP710 com.microchip.mplab.libs.RI4ToolsController.implementations.ProgrammerToGoImpl@5a0f4936
484 1788132266923 GEN4_TO_CONTROLLER_LOG:GEN4_INIT_INT_LOG_dsPIC33CK512MP710 Return End

484 1788132266923 GEN4_TO_CONTROLLER_LOG:GEN4_INIT_INT_LOG_dsPIC33CK512MP710 Pre:GetInterfaceProvider
484 1788132266923 GEN4_TO_CONTROLLER_LOG:GEN4_INIT_INT_LOG_dsPIC33CK512MP710 Payload
484 1788132266923 GEN4_TO_CONTROLLER_LOG:GEN4_INIT_INT_LOG_dsPIC33CK512MP710 Status
484 1788132266923 GEN4_TO_CONTROLLER_LOG:GEN4_INIT_INT_LOG_dsPIC33CK512MP710 Payload End
484 1788132266923 GEN4_TO_CONTROLLER_LOG:GEN4_INIT_INT_LOG_dsPIC33CK512MP710 Post:GetInterfaceProvider
484 1788132266923 GEN4_TO_CONTROLLER_LOG:GEN4_INIT_INT_LOG_dsPIC33CK512MP710 Return Value
484 1788132266923 GEN4_TO_CONTROLLER_LOG:GEN4_INIT_INT_LOG_dsPIC33CK512MP710 null
484 1788132266923 GEN4_TO_CONTROLLER_LOG:GEN4_INIT_INT_LOG_dsPIC33CK512MP710 Return End

484 1788132266929 GEN4_TO_CONTROLLER_LOG:GEN4_PROGRAM_INT_LOG_dsPIC33CK512MP710 Pre:SetProgramExec
484 1788132266929 GEN4_TO_CONTROLLER_LOG:GEN4_PROGRAM_INT_LOG_dsPIC33CK512MP710 Payload
484 1788132266929 GEN4_TO_CONTROLLER_LOG:GEN4_PROGRAM_INT_LOG_dsPIC33CK512MP710 Test
484 1788132266929 GEN4_TO_CONTROLLER_LOG:GEN4_PROGRAM_INT_LOG_dsPIC33CK512MP710 800000
484 1788132266929 GEN4_TO_CONTROLLER_LOG:GEN4_PROGRAM_INT_LOG_dsPIC33CK512MP710 Length = 4608
484 1788132266929 GEN4_TO_CONTROLLER_LOG:GEN4_PROGRAM_INT_LOG_dsPIC33CK512MP710 Payload End
484 1788132266929 GEN4_TO_CONTROLLER_LOG:GEN4_PROGRAM_INT_LOG_dsPIC33CK512MP710 Post:SetProgramExec
484 1788132266929 GEN4_TO_CONTROLLER_LOG:GEN4_PROGRAM_INT_LOG_dsPIC33CK512MP710 Return Value
484 1788132266929 GEN4_TO_CONTROLLER_LOG:GEN4_PROGRAM_INT_LOG_dsPIC33CK512MP710 true
484 1788132266929 GEN4_TO_CONTROLLER_LOG:GEN4_PROGRAM_INT_LOG_dsPIC33CK512MP710 Return End

484 1788132266931 GEN4_TO_CONTROLLER_LOG:GEN4_PROGRAM_INT_LOG_dsPIC33CK512MP710 Pre:SetDebugExec
484 1788132266931 GEN4_TO_CONTROLLER_LOG:GEN4_PROGRAM_INT_LOG_dsPIC33CK512MP710 Payload
484 1788132266931 GEN4_TO_CONTROLLER_LOG:GEN4_PROGRAM_INT_LOG_dsPIC33CK512MP710 Test
484 1788132266931 GEN4_TO_CONTROLLER_LOG:GEN4_PROGRAM_INT_LOG_dsPIC33CK512MP710 800000
484 1788132266931 GEN4_TO_CONTROLLER_LOG:GEN4_PROGRAM_INT_LOG_dsPIC33CK512MP710 Length = 2052
484 1788132266931 GEN4_TO_CONTROLLER_LOG:GEN4_PROGRAM_INT_LOG_dsPIC33CK512MP710 Payload End
484 1788132266931 GEN4_TO_CONTROLLER_LOG:GEN4_PROGRAM_INT_LOG_dsPIC33CK512MP710 Post:SetDebugExec
484 1788132266931 GEN4_TO_CONTROLLER_LOG:GEN4_PROGRAM_INT_LOG_dsPIC33CK512MP710 Return Value
484 1788132266931 GEN4_TO_CONTROLLER_LOG:GEN4_PROGRAM_INT_LOG_dsPIC33CK512MP710 true
484 1788132266931 GEN4_TO_CONTROLLER_LOG:GEN4_PROGRAM_INT_LOG_dsPIC33CK512MP710 Return End
484 1788132266931 GEN4_CONNECT_DIAGNOSTICS:ENTERING: com.microchip.mplab.mdbcore.RI4Tool.ConnectionHandler.CheckForFWUpdates()
484 1788132266931 GEN4_CONNECT_DIAGNOSTICS:Created FirmwareUpdateHandler com.microchip.mplab.mdbcore.pk4hybrid.pk4hybridFirmwareUpdateHandler@ac54bf1
484 1788132266932 GEN4_CONNECT_DIAGNOSTICS:ENTERING: com.microchip.mplab.mdbcore.pk4hybrid.pk4hybridFirmwareUpdateHandler.UpdateFirmware(FirmwareInfo, UpdateMessage)
484 1788132266932 GEN4_CONNECT_DIAGNOSTICS:areWeInBoot returned false
484 1788132266932 GEN4_CONNECT_DIAGNOSTICS:inBoot = false
484 1788132266932 GEN4_CONNECT_DIAGNOSTICS:uMode = checkingVersions
484 1788132266932 GEN4_CONNECT_DIAGNOSTICS:selectedTool = pk4
484 1788132266932 GEN4_CONNECT_DIAGNOSTICS:current toolType = pk4
484 1788132266932 GEN4_CONNECT_DIAGNOSTICS:current tool mode = pk4
484 1788132266932 GEN4_CONNECT_DIAGNOSTICS:ENTERING: com.microchip.mplab.mdbcore.pk4hybrid.pk4hybridFirmwareUpdateHandler.GetUpdateInfo()
484 1788132266932 GEN4_CONNECT_DIAGNOSTICS:Parsing file  for firmware updates
484 1788132266932 GEN4_CONNECT_DIAGNOSTICS:ENTERING: com.microchip.mplab.mdbcore.pk4hybrid.pk4hybridFirmwareUpdateHandler.ParseSelectedVersionsFromJamFile()
484 1788132266932 GEN4_CONNECT_DIAGNOSTICS:Jame file line = boot.hex,010000
484 1788132266932 GEN4_CONNECT_DIAGNOSTICS:Jame file line = scripts.xml,001008
484 1788132266932 GEN4_CONNECT_DIAGNOSTICS:Jame file line = app1 020515, 0040C000
484 1788132266932 GEN4_CONNECT_DIAGNOSTICS:Jame file line = app2 1.15.20, 00500000
484 1788132266932 GEN4_CONNECT_DIAGNOSTICS:Jame file line = app3 000000, FFFFFFFF
484 1788132266932 GEN4_CONNECT_DIAGNOSTICS:Jame file line = app4 000000, FFFFFFFF
484 1788132266933 GEN4_CONNECT_DIAGNOSTICS:Jame file line = app5 000000, FFFFFFFF
484 1788132266933 GEN4_CONNECT_DIAGNOSTICS:Jame file line = app6 000000, FFFFFFFF
484 1788132266933 GEN4_CONNECT_DIAGNOSTICS:Jame file line = app7 000000, FFFFFFFF
484 1788132266933 GEN4_CONNECT_DIAGNOSTICS:Jame file line = app8 000000, FFFFFFFF
484 1788132266933 GEN4_CONNECT_DIAGNOSTICS:EXITING: com.microchip.mplab.mdbcore.pk4hybrid.pk4hybridFirmwareUpdateHandler.ri4ParseSelectedVersionsFromJamFile()
484 1788132266933 GEN4_CONNECT_DIAGNOSTICS:EXITING: com.microchip.mplab.mdbcore.pk4hybrid.pk4hybridFirmwareUpdateHandler.GetUpdateInfo()
484 1788132266933 GEN4_CONNECT_DIAGNOSTICS:current toolType = pk4

484 1788132266933 GEN4_TO_CONTROLLER_LOG:GEN4_CONNECT_INT_LOG_dsPIC33CK512MP710 Pre:EstablishCommunincations
484 1788132266933 GEN4_TO_CONTROLLER_LOG:GEN4_CONNECT_INT_LOG_dsPIC33CK512MP710 Payload
484 1788132266933 GEN4_TO_CONTROLLER_LOG:GEN4_CONNECT_INT_LOG_dsPIC33CK512MP710 com.microchip.mplab.mdbcore.PK4Tool.PK4Com@6aeccb11
484 1788132266933 GEN4_TO_CONTROLLER_LOG:GEN4_CONNECT_INT_LOG_dsPIC33CK512MP710 Payload End
484 1788132266933 GEN4_TO_CONTROLLER_LOG:GEN4_CONNECT_INT_LOG_dsPIC33CK512MP710 Post:EstablishCommunincations
484 1788132266933 GEN4_TO_CONTROLLER_LOG:GEN4_CONNECT_INT_LOG_dsPIC33CK512MP710 Return Value
484 1788132266933 GEN4_TO_CONTROLLER_LOG:GEN4_CONNECT_INT_LOG_dsPIC33CK512MP710 true
484 1788132266933 GEN4_TO_CONTROLLER_LOG:GEN4_CONNECT_INT_LOG_dsPIC33CK512MP710 Return End

484 1788132266933 GEN4_TO_CONTROLLER_LOG:GEN4_CONNECT_INT_LOG_dsPIC33CK512MP710 Pre:GetFirmwareInfo
484 1788132266933 GEN4_TO_CONTROLLER_LOG:GEN4_CONNECT_INT_LOG_dsPIC33CK512MP710 Payload
484 1788132266933 GEN4_TO_CONTROLLER_LOG:GEN4_CONNECT_INT_LOG_dsPIC33CK512MP710 null
484 1788132266933 GEN4_TO_CONTROLLER_LOG:GEN4_CONNECT_INT_LOG_dsPIC33CK512MP710 Payload End
484 1788132266941 GEN4_TO_CONTROLLER_LOG:GEN4_CONNECT_INT_LOG_dsPIC33CK512MP710 Post:GetFirmwareInfo
484 1788132266941 GEN4_TO_CONTROLLER_LOG:GEN4_CONNECT_INT_LOG_dsPIC33CK512MP710 Return Value
484 1788132266941 GEN4_TO_CONTROLLER_LOG:GEN4_CONNECT_INT_LOG_dsPIC33CK512MP710 FirmwareInfo: Values:
484 1788132266941 GEN4_TO_CONTROLLER_LOG:GEN4_CONNECT_INT_LOG_dsPIC33CK512MP710 FirmwareInfo: boot = false, bootVer = 01.00.00, apVer = 02.05.15, fpgaVer = ff.ff.ff, scriptVer = 00.10.08, macAddress = 0495583578349554857485057485452, devID = a1020e01, devID1 = 2, devSN0 = ffffffff, devSN1 = ffffffff, serialNumber = BUR211672921, appCommitID = null, scriptCommitID = f91823efd7, PCB_ID = 4
484 1788132266941 GEN4_TO_CONTROLLER_LOG:GEN4_CONNECT_INT_LOG_dsPIC33CK512MP710 Return End
484 1788132266946 GEN4_CONNECT_DIAGNOSTICS:appNeedsUpdate returned false
484 1788132266946 GEN4_CONNECT_DIAGNOSTICS:EXITING: com.microchip.mplab.mdbcore.RI4Tool.ConnectionHandler.CheckForFWUpdates()

484 1788132266946 GEN4_TO_CONTROLLER_LOG:GEN4_CONNECT_INT_LOG_dsPIC33CK512MP710 Pre:EstablishCommunincations
484 1788132266946 GEN4_TO_CONTROLLER_LOG:GEN4_CONNECT_INT_LOG_dsPIC33CK512MP710 Payload
484 1788132266946 GEN4_TO_CONTROLLER_LOG:GEN4_CONNECT_INT_LOG_dsPIC33CK512MP710 com.microchip.mplab.mdbcore.PK4Tool.PK4Com@6aeccb11
484 1788132266946 GEN4_TO_CONTROLLER_LOG:GEN4_CONNECT_INT_LOG_dsPIC33CK512MP710 Payload End
484 1788132266946 GEN4_TO_CONTROLLER_LOG:GEN4_CONNECT_INT_LOG_dsPIC33CK512MP710 Post:EstablishCommunincations
484 1788132266946 GEN4_TO_CONTROLLER_LOG:GEN4_CONNECT_INT_LOG_dsPIC33CK512MP710 Return Value
484 1788132266946 GEN4_TO_CONTROLLER_LOG:GEN4_CONNECT_INT_LOG_dsPIC33CK512MP710 true
484 1788132266946 GEN4_TO_CONTROLLER_LOG:GEN4_CONNECT_INT_LOG_dsPIC33CK512MP710 Return End

484 1788132266946 GEN4_TO_CONTROLLER_LOG:GEN4_CONNECT_INT_LOG_dsPIC33CK512MP710 Pre:GetFirmwareInfo
484 1788132266946 GEN4_TO_CONTROLLER_LOG:GEN4_CONNECT_INT_LOG_dsPIC33CK512MP710 Payload
484 1788132266946 GEN4_TO_CONTROLLER_LOG:GEN4_CONNECT_INT_LOG_dsPIC33CK512MP710 null
484 1788132266946 GEN4_TO_CONTROLLER_LOG:GEN4_CONNECT_INT_LOG_dsPIC33CK512MP710 Payload End
484 1788132266954 GEN4_TO_CONTROLLER_LOG:GEN4_CONNECT_INT_LOG_dsPIC33CK512MP710 Post:GetFirmwareInfo
484 1788132266954 GEN4_TO_CONTROLLER_LOG:GEN4_CONNECT_INT_LOG_dsPIC33CK512MP710 Return Value
484 1788132266954 GEN4_TO_CONTROLLER_LOG:GEN4_CONNECT_INT_LOG_dsPIC33CK512MP710 FirmwareInfo: Values:
484 1788132266954 GEN4_TO_CONTROLLER_LOG:GEN4_CONNECT_INT_LOG_dsPIC33CK512MP710 FirmwareInfo: boot = false, bootVer = 01.00.00, apVer = 02.05.15, fpgaVer = ff.ff.ff, scriptVer = 00.10.08, macAddress = 0495583578349554857485057485452, devID = a1020e01, devID1 = 2, devSN0 = ffffffff, devSN1 = ffffffff, serialNumber = BUR211672921, appCommitID = null, scriptCommitID = f91823efd7, PCB_ID = 4
484 1788132266954 GEN4_TO_CONTROLLER_LOG:GEN4_CONNECT_INT_LOG_dsPIC33CK512MP710 Return End

484 1788132266954 GEN4_TO_CONTROLLER_LOG:GEN4_CONNECT_INT_LOG_dsPIC33CK512MP710 Pre:GetFirmwareInfo
484 1788132266954 GEN4_TO_CONTROLLER_LOG:GEN4_CONNECT_INT_LOG_dsPIC33CK512MP710 Payload
484 1788132266954 GEN4_TO_CONTROLLER_LOG:GEN4_CONNECT_INT_LOG_dsPIC33CK512MP710 null
484 1788132266954 GEN4_TO_CONTROLLER_LOG:GEN4_CONNECT_INT_LOG_dsPIC33CK512MP710 Payload End
484 1788132266962 GEN4_TO_CONTROLLER_LOG:GEN4_CONNECT_INT_LOG_dsPIC33CK512MP710 Post:GetFirmwareInfo
484 1788132266962 GEN4_TO_CONTROLLER_LOG:GEN4_CONNECT_INT_LOG_dsPIC33CK512MP710 Return Value
484 1788132266962 GEN4_TO_CONTROLLER_LOG:GEN4_CONNECT_INT_LOG_dsPIC33CK512MP710 FirmwareInfo: Values:
484 1788132266962 GEN4_TO_CONTROLLER_LOG:GEN4_CONNECT_INT_LOG_dsPIC33CK512MP710 FirmwareInfo: boot = false, bootVer = 01.00.00, apVer = 02.05.15, fpgaVer = ff.ff.ff, scriptVer = 00.10.08, macAddress = 0495583578349554857485057485452, devID = a1020e01, devID1 = 2, devSN0 = ffffffff, devSN1 = ffffffff, serialNumber = BUR211672921, appCommitID = null, scriptCommitID = f91823efd7, PCB_ID = 4
484 1788132266962 GEN4_TO_CONTROLLER_LOG:GEN4_CONNECT_INT_LOG_dsPIC33CK512MP710 Return End
484 1788132266962 XXXX 1788132266962, Thread 484: XXXX 1788132266962, Entering Thread 484: Commands::runScriptWithUpload with script contents. contents[0] = 0x5e, ...  
484 1788132266962 XXXX 1788132266962, Thread 484: XXXX 1788132266962, Entering Thread 484: ToolCommUsb::readTransfer, sideData is 0xd bytes long, transferDataLength is 0x4 bytes long  
484 1788132266964 XXXX 1788132266964, Thread 484: XXXX 1788132266964, Exiting Thread 484: ToolCommUsb::readTransfer,  cr.status = 0x0  
484 1788132266964 XXXX 1788132266964, Thread 484: XXXX 1788132266964, Exiting Thread 484: Commands::runScriptWithUpload  
484 1788132266964 GEN4_CONNECT_DIAGNOSTICS:ENTERING: com.microchip.mplab.mdbcore.RI4Tool.ConnectionHandler.CheckForFWUpdates()
484 1788132266964 GEN4_CONNECT_DIAGNOSTICS:Created FirmwareUpdateHandler com.microchip.mplab.mdbcore.pk4hybrid.pk4hybridFirmwareUpdateHandler@ac54bf1
484 1788132266964 GEN4_CONNECT_DIAGNOSTICS:ENTERING: com.microchip.mplab.mdbcore.pk4hybrid.pk4hybridFirmwareUpdateHandler.UpdateFirmware(FirmwareInfo, UpdateMessage)
484 1788132266964 GEN4_CONNECT_DIAGNOSTICS:areWeInBoot returned false
484 1788132266964 GEN4_CONNECT_DIAGNOSTICS:inBoot = false
484 1788132266964 GEN4_CONNECT_DIAGNOSTICS:uMode = done
484 1788132266964 GEN4_CONNECT_DIAGNOSTICS:selectedTool = pk4
484 1788132266964 GEN4_CONNECT_DIAGNOSTICS:current toolType = pk4
484 1788132266964 GEN4_CONNECT_DIAGNOSTICS:current tool mode = pk4
484 1788132266964 GEN4_CONNECT_DIAGNOSTICS:ENTERING: com.microchip.mplab.mdbcore.pk4hybrid.pk4hybridFirmwareUpdateHandler.updatePk4HybridFirmware()
484 1788132266964 GEN4_CONNECT_DIAGNOSTICS:Don't upgrade fimware = false
484 1788132266964 GEN4_CONNECT_DIAGNOSTICS:ENTERING: com.microchip.mplab.mdbcore.pk4hybrid.pk4hybridFirmwareUpdateHandler.updatePk4HybridFirmware()
484 1788132266964 GEN4_CONNECT_DIAGNOSTICS:EXITING: com.microchip.mplab.mdbcore.pk4hybrid.pk4hybridFirmwareUpdateHandler.UpdateFirmware(FirmwareInfo, UpdateMessage)
484 1788132266964 GEN4_CONNECT_DIAGNOSTICS:EXITING: com.microchip.mplab.mdbcore.RI4Tool.ConnectionHandler.CheckForFWUpdates()

484 1788132266964 GEN4_TO_CONTROLLER_LOG:GEN4_CONNECT_INT_LOG_dsPIC33CK512MP710 Pre:SetPowerInfo
484 1788132266964 GEN4_TO_CONTROLLER_LOG:GEN4_CONNECT_INT_LOG_dsPIC33CK512MP710 Payload
484 1788132266964 GEN4_TO_CONTROLLER_LOG:GEN4_CONNECT_INT_LOG_dsPIC33CK512MP710 PowerInfo: Values:
484 1788132266964 GEN4_TO_CONTROLLER_LOG:GEN4_CONNECT_INT_LOG_dsPIC33CK512MP710 PowerInfo: shotDownSystem = false, isToolPower = false, voltage = 3.250000, useVppFirst = false, useLowVoltageProgramming = true, useMaintainActivePower = false
484 1788132266964 GEN4_TO_CONTROLLER_LOG:GEN4_CONNECT_INT_LOG_dsPIC33CK512MP710 Payload End
484 1788132266964 XXXX 1788132266964, Thread 484: XXXX 1788132266964, Entering Thread 484: Commands::runScriptBasic with script contents. contents[0] = 0x39, ...  
484 1788132266965 XXXX 1788132266965, Thread 484: XXXX 1788132266965, Exiting Thread 484: Commands::runScriptBasic  
484 1788132266965 XXXX 1788132266965, Thread 484: XXXX 1788132266965, Entering Thread 484: Commands::runScriptBasic with script contents. contents[0] = 0x46, ...  
484 1788132266966 XXXX 1788132266966, Thread 484: XXXX 1788132266966, Exiting Thread 484: Commands::runScriptBasic  
484 1788132266966 XXXX 1788132266966, Thread 484: XXXX 1788132266966, Entering Thread 484: Commands::runScriptBasic with script contents. contents[0] = 0x44, ...  
484 1788132266978 XXXX 1788132266978, Thread 484: XXXX 1788132266978, Exiting Thread 484: Commands::runScriptBasic  
484 1788132266978 XXXX 1788132266978, Thread 484: XXXX 1788132266978, Entering Thread 484: Commands::runScriptBasic with script contents. contents[0] = 0xef, ...  
484 1788132266989 XXXX 1788132266989, Thread 484: XXXX 1788132266989, Exiting Thread 484: Commands::runScriptBasic  
484 1788132266989 XXXX 1788132266989, Thread 484: XXXX 1788132266989, Entering Thread 484: Commands::runScriptBasic with script contents. contents[0] = 0x40, ...  
484 1788132267387 XXXX 1788132267387, Thread 484: XXXX 1788132267387, Exiting Thread 484: Commands::runScriptBasic  
484 1788132267387 XXXX 1788132267387, Thread 484: XXXX 1788132267387, Entering Thread 484: Commands::runScriptBasic with script contents. contents[0] = 0x47, ...  
484 1788132267392 XXXX 1788132267392, Thread 484: XXXX 1788132267392, Exiting Thread 484: Commands::runScriptBasic  
484 1788132267392 GEN4_TO_CONTROLLER_LOG:GEN4_CONNECT_INT_LOG_dsPIC33CK512MP710 Post:SetPowerInfo
484 1788132267392 GEN4_TO_CONTROLLER_LOG:GEN4_CONNECT_INT_LOG_dsPIC33CK512MP710 Return Value
484 1788132267392 GEN4_TO_CONTROLLER_LOG:GEN4_CONNECT_INT_LOG_dsPIC33CK512MP710 none
484 1788132267392 GEN4_TO_CONTROLLER_LOG:GEN4_CONNECT_INT_LOG_dsPIC33CK512MP710 Return End

484 1788132267392 GEN4_TO_CONTROLLER_LOG:GEN4_CONNECT_INT_LOG_dsPIC33CK512MP710 Pre:GetVoltageInfo
484 1788132267392 GEN4_TO_CONTROLLER_LOG:GEN4_CONNECT_INT_LOG_dsPIC33CK512MP710 Payload
484 1788132267392 GEN4_TO_CONTROLLER_LOG:GEN4_CONNECT_INT_LOG_dsPIC33CK512MP710 null
484 1788132267392 GEN4_TO_CONTROLLER_LOG:GEN4_CONNECT_INT_LOG_dsPIC33CK512MP710 Payload End
484 1788132267392 XXXX 1788132267392, Thread 484: XXXX 1788132267392, Entering Thread 484: Commands::runScriptBasic with script contents. contents[0] = 0x47, ...  
484 1788132267397 XXXX 1788132267397, Thread 484: XXXX 1788132267397, Exiting Thread 484: Commands::runScriptBasic  
484 1788132267397 GEN4_TO_CONTROLLER_LOG:GEN4_CONNECT_INT_LOG_dsPIC33CK512MP710 Post:GetVoltageInfo
484 1788132267397 GEN4_TO_CONTROLLER_LOG:GEN4_CONNECT_INT_LOG_dsPIC33CK512MP710 Return Value
484 1788132267397 GEN4_TO_CONTROLLER_LOG:GEN4_CONNECT_INT_LOG_dsPIC33CK512MP710 VoltagesInfo: Values:
484 1788132267397 GEN4_TO_CONTROLLER_LOG:GEN4_CONNECT_INT_LOG_dsPIC33CK512MP710 VoltagesInfo: internalVdd = 3279, internalVpp = 3093, targetVdd = 3326, targetVpp = 364, vddSense = 0, temp = 25000, vddCurrentSense = 1, vddVoltageSense = 3125
484 1788132267397 GEN4_TO_CONTROLLER_LOG:GEN4_CONNECT_INT_LOG_dsPIC33CK512MP710 Return End

484 1788132267397 GEN4_TO_CONTROLLER_LOG:GEN4_CONNECT_INT_LOG_dsPIC33CK512MP710 Pre:GetFirmwareInfo
484 1788132267397 GEN4_TO_CONTROLLER_LOG:GEN4_CONNECT_INT_LOG_dsPIC33CK512MP710 Payload
484 1788132267397 GEN4_TO_CONTROLLER_LOG:GEN4_CONNECT_INT_LOG_dsPIC33CK512MP710 null
484 1788132267397 GEN4_TO_CONTROLLER_LOG:GEN4_CONNECT_INT_LOG_dsPIC33CK512MP710 Payload End
484 1788132267405 GEN4_TO_CONTROLLER_LOG:GEN4_CONNECT_INT_LOG_dsPIC33CK512MP710 Post:GetFirmwareInfo
484 1788132267405 GEN4_TO_CONTROLLER_LOG:GEN4_CONNECT_INT_LOG_dsPIC33CK512MP710 Return Value
484 1788132267405 GEN4_TO_CONTROLLER_LOG:GEN4_CONNECT_INT_LOG_dsPIC33CK512MP710 FirmwareInfo: Values:
484 1788132267405 GEN4_TO_CONTROLLER_LOG:GEN4_CONNECT_INT_LOG_dsPIC33CK512MP710 FirmwareInfo: boot = false, bootVer = 01.00.00, apVer = 02.05.15, fpgaVer = ff.ff.ff, scriptVer = 00.10.08, macAddress = 0495583578349554857485057485452, devID = a1020e01, devID1 = 2, devSN0 = ffffffff, devSN1 = ffffffff, serialNumber = BUR211672921, appCommitID = null, scriptCommitID = f91823efd7, PCB_ID = 4
484 1788132267405 GEN4_TO_CONTROLLER_LOG:GEN4_CONNECT_INT_LOG_dsPIC33CK512MP710 Return End

484 1788132267405 GEN4_TO_CONTROLLER_LOG:GEN4_CONNECT_INT_LOG_dsPIC33CK512MP710 Pre:SetLEDBrightness
484 1788132267405 GEN4_TO_CONTROLLER_LOG:GEN4_CONNECT_INT_LOG_dsPIC33CK512MP710 Payload
484 1788132267405 GEN4_TO_CONTROLLER_LOG:GEN4_CONNECT_INT_LOG_dsPIC33CK512MP710 5
484 1788132267405 GEN4_TO_CONTROLLER_LOG:GEN4_CONNECT_INT_LOG_dsPIC33CK512MP710 Payload End
484 1788132267405 XXXX 1788132267405, Thread 484: XXXX 1788132267405, Entering Thread 484: Commands::runScriptBasic with script contents. contents[0] = 0xcf, ...  
484 1788132267406 XXXX 1788132267406, Thread 484: XXXX 1788132267406, Exiting Thread 484: Commands::runScriptBasic  
484 1788132267406 GEN4_TO_CONTROLLER_LOG:GEN4_CONNECT_INT_LOG_dsPIC33CK512MP710 Post:SetLEDBrightness
484 1788132267406 GEN4_TO_CONTROLLER_LOG:GEN4_CONNECT_INT_LOG_dsPIC33CK512MP710 Return Value
484 1788132267406 GEN4_TO_CONTROLLER_LOG:GEN4_CONNECT_INT_LOG_dsPIC33CK512MP710 none
484 1788132267406 GEN4_TO_CONTROLLER_LOG:GEN4_CONNECT_INT_LOG_dsPIC33CK512MP710 Return End

484 1788132267406 GEN4_TO_CONTROLLER_LOG:GEN4_CONNECT_INT_LOG_dsPIC33CK512MP710 Pre:SetToolInfo
484 1788132267406 GEN4_TO_CONTROLLER_LOG:GEN4_CONNECT_INT_LOG_dsPIC33CK512MP710 Payload
484 1788132267406 GEN4_TO_CONTROLLER_LOG:GEN4_CONNECT_INT_LOG_dsPIC33CK512MP710 ToolInfo: Values:
484 1788132267406 GEN4_TO_CONTROLLER_LOG:GEN4_CONNECT_INT_LOG_dsPIC33CK512MP710 ToolInfo: speedLevel = 0, PGCResistance = 4700, PGDResistance = 4700, PGCPullDir = None, PGDPullDir = None, ICSPSelected = Wire2
484 1788132267406 GEN4_TO_CONTROLLER_LOG:GEN4_CONNECT_INT_LOG_dsPIC33CK512MP710 Payload End
484 1788132267407 XXXX 1788132267407, Thread 484: XXXX 1788132267407, Entering Thread 484: Commands::runScriptBasic with script contents. contents[0] = 0x27, ...  
484 1788132267408 XXXX 1788132267408, Thread 484: XXXX 1788132267408, Exiting Thread 484: Commands::runScriptBasic  
484 1788132267408 XXXX 1788132267408, Thread 484: XXXX 1788132267408, Entering Thread 484: Commands::runScriptBasic, script name = SetSpeedFromDevice, timeOut = -1 ms  
484 1788132267409 XXXX 1788132267409, Thread 484: XXXX 1788132267409, Exiting Thread 484: Commands::runScriptBasic  
484 1788132267409 XXXX 1788132267409, Thread 484: XXXX 1788132267409, Entering Thread 484: Commands::runScriptBasic with script contents. contents[0] = 0xed, ...  
484 1788132267410 XXXX 1788132267410, Thread 484: XXXX 1788132267410, Exiting Thread 484: Commands::runScriptBasic  
484 1788132267410 XXXX 1788132267410, Thread 484: XXXX 1788132267410, Entering Thread 484: Commands::runScriptBasic with script contents. contents[0] = 0xec, ...  
484 1788132267411 XXXX 1788132267411, Thread 484: XXXX 1788132267411, Exiting Thread 484: Commands::runScriptBasic  
484 1788132267411 XXXX 1788132267411, Thread 484: XXXX 1788132267411, Entering Thread 484: Commands::runScriptBasic with script contents. contents[0] = 0xd4, ...  
484 1788132267412 XXXX 1788132267412, Thread 484: XXXX 1788132267412, Exiting Thread 484: Commands::runScriptBasic  
484 1788132267412 GEN4_TO_CONTROLLER_LOG:GEN4_CONNECT_INT_LOG_dsPIC33CK512MP710 Post:SetToolInfo
484 1788132267412 GEN4_TO_CONTROLLER_LOG:GEN4_CONNECT_INT_LOG_dsPIC33CK512MP710 Return Value
484 1788132267412 GEN4_TO_CONTROLLER_LOG:GEN4_CONNECT_INT_LOG_dsPIC33CK512MP710 none
484 1788132267412 GEN4_TO_CONTROLLER_LOG:GEN4_CONNECT_INT_LOG_dsPIC33CK512MP710 Return End

484 1788132267413 GEN4_TO_CONTROLLER_LOG:GEN4_CONNECT_INT_LOG_dsPIC33CK512MP710 Pre:GetTargetIDInfo
484 1788132267413 GEN4_TO_CONTROLLER_LOG:GEN4_CONNECT_INT_LOG_dsPIC33CK512MP710 Payload
484 1788132267413 GEN4_TO_CONTROLLER_LOG:GEN4_CONNECT_INT_LOG_dsPIC33CK512MP710 null
484 1788132267413 GEN4_TO_CONTROLLER_LOG:GEN4_CONNECT_INT_LOG_dsPIC33CK512MP710 Payload End
484 1788132267415 XXXX 1788132267415, Thread 484: XXXX 1788132267415, Entering Thread 484: Commands::runScriptBasic, script name = SetSpeedFromDevice, timeOut = -1 ms  
484 1788132267416 XXXX 1788132267416, Thread 484: XXXX 1788132267416, Exiting Thread 484: Commands::runScriptBasic  
484 1788132267416 XXXX 1788132267416, Thread 484: XXXX 1788132267416, Entering Thread 484: Commands::runScriptBasic with script contents. contents[0] = 0xed, ...  
484 1788132267418 XXXX 1788132267418, Thread 484: XXXX 1788132267418, Exiting Thread 484: Commands::runScriptBasic  
484 1788132267418 XXXX 1788132267418, Thread 484: XXXX 1788132267418, Entering Thread 484: Commands::runScriptBasic with script contents. contents[0] = 0xec, ...  
484 1788132267419 XXXX 1788132267419, Thread 484: XXXX 1788132267419, Exiting Thread 484: Commands::runScriptBasic  
484 1788132267419 XXXX 1788132267419, Thread 484: XXXX 1788132267419, Entering Thread 484: Commands::runScriptBasic, script name = EnterTMOD_LV, timeOut = -1 ms  
484 1788132267447 XXXX 1788132267446, Thread 484: XXXX 1788132267446, Exiting Thread 484: Commands::runScriptBasic  
484 1788132267447 XXXX 1788132267447, Thread 484: XXXX 1788132267447, Entering Thread 484: Commands::runScriptBasic, script name = GetDeviceID, timeOut = -1 ms  
484 1788132267449 XXXX 1788132267449, Thread 484: XXXX 1788132267449, Exiting Thread 484: Commands::runScriptBasic  
484 1788132267449 GEN4_TO_CONTROLLER_LOG:GEN4_CONNECT_INT_LOG_dsPIC33CK512MP710 Post:GetTargetIDInfo
484 1788132267449 GEN4_TO_CONTROLLER_LOG:GEN4_CONNECT_INT_LOG_dsPIC33CK512MP710 Return Value
484 1788132267449 GEN4_TO_CONTROLLER_LOG:GEN4_CONNECT_INT_LOG_dsPIC33CK512MP710 TargetIDInfo: Values:
484 1788132267449 GEN4_TO_CONTROLLER_LOG:GEN4_CONNECT_INT_LOG_dsPIC33CK512MP710 TargetIDInfo: DeviceID = 00000000
484 1788132267449 GEN4_TO_CONTROLLER_LOG:GEN4_CONNECT_INT_LOG_dsPIC33CK512MP710 Return End

484 1788132282271 GEN4_TO_CONTROLLER_LOG:GEN4_PROGRAM_INT_LOG_dsPIC33CK512MP710 Pre:SendOperation
484 1788132282271 GEN4_TO_CONTROLLER_LOG:GEN4_PROGRAM_INT_LOG_dsPIC33CK512MP710 Payload
484 1788132282271 GEN4_TO_CONTROLLER_LOG:GEN4_PROGRAM_INT_LOG_dsPIC33CK512MP710 OperationInfo: Values:
484 1788132282271 GEN4_TO_CONTROLLER_LOG:GEN4_PROGRAM_INT_LOG_dsPIC33CK512MP710 OperationInfo: Type = read, Mask = 00000000, Erase = false, Production Mode = true
484 1788132282271 GEN4_TO_CONTROLLER_LOG:GEN4_PROGRAM_INT_LOG_dsPIC33CK512MP710 TransferInfo: Start = 801000, End = 8017ff, Buffer Length = 4096, Type = Test, Mask = 00000000
484 1788132282271 GEN4_TO_CONTROLLER_LOG:GEN4_PROGRAM_INT_LOG_dsPIC33CK512MP710 Payload End
484 1788132282271 XXXX 1788132282271, Thread 484: XXXX 1788132282271, Entering Thread 484: Commands::runScriptBasic, script name = EraseTestmemRange, timeOut = 30000 ms  
484 1788132282326 XXXX 1788132282326, Thread 484: XXXX 1788132282326, Exiting Thread 484: Commands::runScriptBasic  
484 1788132282326 XXXX 1788132282326, Thread 484: XXXX 1788132282326, Entering Thread 484: Commands::runScriptWithDownload, script name = WriteProgmem  
484 1788132284695 XXXX 1788132284695, Thread 484: XXXX 1788132284695, Exiting Thread 484: Commands::runScriptWithDownload(WriteProgmem)  
484 1788132284695 XXXX 1788132284695, Thread 484: XXXX 1788132284695, Entering Thread 484: Commands::runScriptWithUpload, script name = ReadProgmem  
484 1788132284695 XXXX 1788132284695, Thread 484: XXXX 1788132284695, Entering Thread 484: ToolCommUsb::readTransfer, sideData is 0xb1 bytes long, transferDataLength is 0x1800 bytes long  
484 1788132286584 XXXX 1788132286584, Thread 484: XXXX 1788132286584, Exiting Thread 484: ToolCommUsb::readTransfer,  cr.status = 0x0  
484 1788132286584 XXXX 1788132286584, Thread 484: XXXX 1788132286584, Exiting Thread 484: Commands::runScriptWithUpload  
484 1788132286584 XXXX 1788132286584, Thread 484: XXXX 1788132286584, Entering Thread 484: Commands::runScriptBasic, script name = ExitTMOD, timeOut = -1 ms  
484 1788132286586 XXXX 1788132286586, Thread 484: XXXX 1788132286586, Exiting Thread 484: Commands::runScriptBasic  
484 1788132286586 XXXX 1788132286586, Thread 484: XXXX 1788132286586, Entering Thread 484: Commands::runScriptBasic, script name = ExitTMOD, timeOut = -1 ms  
484 1788132286588 XXXX 1788132286588, Thread 484: XXXX 1788132286588, Exiting Thread 484: Commands::runScriptBasic  
484 1788132286588 XXXX 1788132286588, Thread 484: XXXX 1788132286588, Entering Thread 484: Commands::runScriptBasic, script name = SetSpeedFromDevice, timeOut = -1 ms  
484 1788132286589 XXXX 1788132286589, Thread 484: XXXX 1788132286589, Exiting Thread 484: Commands::runScriptBasic  
484 1788132286589 XXXX 1788132286589, Thread 484: XXXX 1788132286589, Entering Thread 484: Commands::runScriptBasic with script contents. contents[0] = 0xed, ...  
484 1788132286590 XXXX 1788132286590, Thread 484: XXXX 1788132286590, Exiting Thread 484: Commands::runScriptBasic  
484 1788132286590 XXXX 1788132286590, Thread 484: XXXX 1788132286590, Entering Thread 484: Commands::runScriptBasic with script contents. contents[0] = 0xec, ...  
484 1788132286591 XXXX 1788132286591, Thread 484: XXXX 1788132286591, Exiting Thread 484: Commands::runScriptBasic  
484 1788132286591 XXXX 1788132286591, Thread 484: XXXX 1788132286591, Entering Thread 484: Commands::runScriptBasic, script name = EnterTMOD_LV, timeOut = -1 ms  
484 1788132286618 XXXX 1788132286618, Thread 484: XXXX 1788132286618, Exiting Thread 484: Commands::runScriptBasic  
484 1788132286618 XXXX 1788132286618, Thread 484: XXXX 1788132286618, Entering Thread 484: Commands::runScriptWithUpload, script name = ReadProgmem  
484 1788132286619 XXXX 1788132286619, Thread 484: XXXX 1788132286619, Entering Thread 484: ToolCommUsb::readTransfer, sideData is 0xb1 bytes long, transferDataLength is 0xc00 bytes long  
484 1788132287563 XXXX 1788132287563, Thread 484: XXXX 1788132287563, Exiting Thread 484: ToolCommUsb::readTransfer,  cr.status = 0x0  
484 1788132287563 XXXX 1788132287563, Thread 484: XXXX 1788132287563, Exiting Thread 484: Commands::runScriptWithUpload  
484 1788132287564 GEN4_TO_CONTROLLER_LOG:GEN4_PROGRAM_INT_LOG_dsPIC33CK512MP710 Post:SendOperation
484 1788132287564 GEN4_TO_CONTROLLER_LOG:GEN4_PROGRAM_INT_LOG_dsPIC33CK512MP710 Return Value
484 1788132287564 GEN4_TO_CONTROLLER_LOG:GEN4_PROGRAM_INT_LOG_dsPIC33CK512MP710 None
484 1788132287564 GEN4_TO_CONTROLLER_LOG:GEN4_PROGRAM_INT_LOG_dsPIC33CK512MP710 Return End

484 1788132287564 GEN4_TO_CONTROLLER_LOG:GEN4_PROGRAM_INT_LOG_dsPIC33CK512MP710 Pre:SendOperation
484 1788132287564 GEN4_TO_CONTROLLER_LOG:GEN4_PROGRAM_INT_LOG_dsPIC33CK512MP710 Payload
484 1788132287564 GEN4_TO_CONTROLLER_LOG:GEN4_PROGRAM_INT_LOG_dsPIC33CK512MP710 OperationInfo: Values:
484 1788132287564 GEN4_TO_CONTROLLER_LOG:GEN4_PROGRAM_INT_LOG_dsPIC33CK512MP710 OperationInfo: Type = read, Mask = 00000000, Erase = false, Production Mode = true
484 1788132287564 GEN4_TO_CONTROLLER_LOG:GEN4_PROGRAM_INT_LOG_dsPIC33CK512MP710 TransferInfo: Start = 801200, End = 801209, Buffer Length = 20, Type = UDID, Mask = 00000000
484 1788132287564 GEN4_TO_CONTROLLER_LOG:GEN4_PROGRAM_INT_LOG_dsPIC33CK512MP710 Payload End
484 1788132287564 XXXX 1788132287564, Thread 484: XXXX 1788132287564, Entering Thread 484: Commands::runScriptWithUpload, script name = ReadProgmem  
484 1788132287564 XXXX 1788132287564, Thread 484: XXXX 1788132287564, Entering Thread 484: ToolCommUsb::readTransfer, sideData is 0xb1 bytes long, transferDataLength is 0x18 bytes long  
484 1788132287573 XXXX 1788132287573, Thread 484: XXXX 1788132287573, Exiting Thread 484: ToolCommUsb::readTransfer,  cr.status = 0x0  
484 1788132287573 XXXX 1788132287573, Thread 484: XXXX 1788132287573, Exiting Thread 484: Commands::runScriptWithUpload  
484 1788132287573 GEN4_TO_CONTROLLER_LOG:GEN4_PROGRAM_INT_LOG_dsPIC33CK512MP710 Post:SendOperation
484 1788132287573 GEN4_TO_CONTROLLER_LOG:GEN4_PROGRAM_INT_LOG_dsPIC33CK512MP710 Return Value
484 1788132287573 GEN4_TO_CONTROLLER_LOG:GEN4_PROGRAM_INT_LOG_dsPIC33CK512MP710 None
484 1788132287573 GEN4_TO_CONTROLLER_LOG:GEN4_PROGRAM_INT_LOG_dsPIC33CK512MP710 Return End

484 1788132287684 GEN4_TO_CONTROLLER_LOG:GEN4_PROGRAM_INT_LOG_dsPIC33CK512MP710 Pre:SendOperation
484 1788132287684 GEN4_TO_CONTROLLER_LOG:GEN4_PROGRAM_INT_LOG_dsPIC33CK512MP710 Payload
484 1788132287684 GEN4_TO_CONTROLLER_LOG:GEN4_PROGRAM_INT_LOG_dsPIC33CK512MP710 OperationInfo: Values:
484 1788132287684 GEN4_TO_CONTROLLER_LOG:GEN4_PROGRAM_INT_LOG_dsPIC33CK512MP710 OperationInfo: Type = read, Mask = 00000000, Erase = false, Production Mode = false
484 1788132287684 GEN4_TO_CONTROLLER_LOG:GEN4_PROGRAM_INT_LOG_dsPIC33CK512MP710 TransferInfo: Start = 57800, End = 57fff, Buffer Length = 4096, Type = Pgm, Mask = 00000001
484 1788132287684 GEN4_TO_CONTROLLER_LOG:GEN4_PROGRAM_INT_LOG_dsPIC33CK512MP710 Payload End
484 1788132287684 XXXX 1788132287684, Thread 484: XXXX 1788132287684, Entering Thread 484: Commands::runScriptWithUpload, script name = ReadProgmem  
484 1788132287684 XXXX 1788132287684, Thread 484: XXXX 1788132287684, Entering Thread 484: ToolCommUsb::readTransfer, sideData is 0xb1 bytes long, transferDataLength is 0xc00 bytes long  
484 1788132288629 XXXX 1788132288629, Thread 484: XXXX 1788132288629, Exiting Thread 484: ToolCommUsb::readTransfer,  cr.status = 0x0  
484 1788132288629 XXXX 1788132288629, Thread 484: XXXX 1788132288629, Exiting Thread 484: Commands::runScriptWithUpload  
484 1788132288629 GEN4_TO_CONTROLLER_LOG:GEN4_PROGRAM_INT_LOG_dsPIC33CK512MP710 Post:SendOperation
484 1788132288629 GEN4_TO_CONTROLLER_LOG:GEN4_PROGRAM_INT_LOG_dsPIC33CK512MP710 Return Value
484 1788132288629 GEN4_TO_CONTROLLER_LOG:GEN4_PROGRAM_INT_LOG_dsPIC33CK512MP710 None
484 1788132288629 GEN4_TO_CONTROLLER_LOG:GEN4_PROGRAM_INT_LOG_dsPIC33CK512MP710 Return End

484 1788132288629 GEN4_TO_CONTROLLER_LOG:GEN4_PROGRAM_INT_LOG_dsPIC33CK512MP710 Pre:SendOperation
484 1788132288629 GEN4_TO_CONTROLLER_LOG:GEN4_PROGRAM_INT_LOG_dsPIC33CK512MP710 Payload
484 1788132288629 GEN4_TO_CONTROLLER_LOG:GEN4_PROGRAM_INT_LOG_dsPIC33CK512MP710 OperationInfo: Values:
484 1788132288630 GEN4_TO_CONTROLLER_LOG:GEN4_PROGRAM_INT_LOG_dsPIC33CK512MP710 OperationInfo: Type = read, Mask = 00000000, Erase = false, Production Mode = false
484 1788132288630 GEN4_TO_CONTROLLER_LOG:GEN4_PROGRAM_INT_LOG_dsPIC33CK512MP710 TransferInfo: Start = 57800, End = 57fff, Buffer Length = 4096, Type = Pgm, Mask = 00000001
484 1788132288630 GEN4_TO_CONTROLLER_LOG:GEN4_PROGRAM_INT_LOG_dsPIC33CK512MP710 Payload End
484 1788132288630 XXXX 1788132288630, Thread 484: XXXX 1788132288630, Entering Thread 484: Commands::runScriptWithUpload, script name = ReadProgmem  
484 1788132288630 XXXX 1788132288630, Thread 484: XXXX 1788132288630, Entering Thread 484: ToolCommUsb::readTransfer, sideData is 0xb1 bytes long, transferDataLength is 0xc00 bytes long  
484 1788132289574 XXXX 1788132289574, Thread 484: XXXX 1788132289574, Exiting Thread 484: ToolCommUsb::readTransfer,  cr.status = 0x0  
484 1788132289574 XXXX 1788132289574, Thread 484: XXXX 1788132289574, Exiting Thread 484: Commands::runScriptWithUpload  
484 1788132289574 GEN4_TO_CONTROLLER_LOG:GEN4_PROGRAM_INT_LOG_dsPIC33CK512MP710 Post:SendOperation
484 1788132289574 GEN4_TO_CONTROLLER_LOG:GEN4_PROGRAM_INT_LOG_dsPIC33CK512MP710 Return Value
484 1788132289574 GEN4_TO_CONTROLLER_LOG:GEN4_PROGRAM_INT_LOG_dsPIC33CK512MP710 None
484 1788132289574 GEN4_TO_CONTROLLER_LOG:GEN4_PROGRAM_INT_LOG_dsPIC33CK512MP710 Return End

484 1788132289577 GEN4_TO_CONTROLLER_LOG:GEN4_PROGRAM_INT_LOG_dsPIC33CK512MP710 Pre:SendOperation
484 1788132289577 GEN4_TO_CONTROLLER_LOG:GEN4_PROGRAM_INT_LOG_dsPIC33CK512MP710 Payload
484 1788132289577 GEN4_TO_CONTROLLER_LOG:GEN4_PROGRAM_INT_LOG_dsPIC33CK512MP710 OperationInfo: Values:
484 1788132289577 GEN4_TO_CONTROLLER_LOG:GEN4_PROGRAM_INT_LOG_dsPIC33CK512MP710 OperationInfo: Type = erase, Mask = 00000000, Erase = false, Production Mode = false
484 1788132289577 GEN4_TO_CONTROLLER_LOG:GEN4_PROGRAM_INT_LOG_dsPIC33CK512MP710 TransferInfo: Start = 0, End = 57eff, Buffer Length = 0, Type = Pgm, Mask = 00000000
484 1788132289577 GEN4_TO_CONTROLLER_LOG:GEN4_PROGRAM_INT_LOG_dsPIC33CK512MP710 TransferInfo: Start = 57f00, End = 57fff, Buffer Length = 0, Type = Cfg, Mask = 00000000
484 1788132289577 GEN4_TO_CONTROLLER_LOG:GEN4_PROGRAM_INT_LOG_dsPIC33CK512MP710 TransferInfo: Start = 801800, End = 801801, Buffer Length = 0, Type = FBoot, Mask = 00000000
484 1788132289577 GEN4_TO_CONTROLLER_LOG:GEN4_PROGRAM_INT_LOG_dsPIC33CK512MP710 Payload End
484 1788132289577 XXXX 1788132289577, Thread 484: XXXX 1788132289577, Entering Thread 484: Commands::runScriptBasic, script name = EraseChip, timeOut = 30000 ms  
484 1788132289830 XXXX 1788132289830, Thread 484: XXXX 1788132289830, Exiting Thread 484: Commands::runScriptBasic  
484 1788132289830 XXXX 1788132289830, Thread 484: XXXX 1788132289830, Entering Thread 484: Commands::runScriptBasic, script name = ExitTMOD, timeOut = -1 ms  
484 1788132289832 XXXX 1788132289832, Thread 484: XXXX 1788132289832, Exiting Thread 484: Commands::runScriptBasic  
484 1788132289832 GEN4_TO_CONTROLLER_LOG:GEN4_PROGRAM_INT_LOG_dsPIC33CK512MP710 Post:SendOperation
484 1788132289832 GEN4_TO_CONTROLLER_LOG:GEN4_PROGRAM_INT_LOG_dsPIC33CK512MP710 Return Value
484 1788132289832 GEN4_TO_CONTROLLER_LOG:GEN4_PROGRAM_INT_LOG_dsPIC33CK512MP710 None
484 1788132289832 GEN4_TO_CONTROLLER_LOG:GEN4_PROGRAM_INT_LOG_dsPIC33CK512MP710 Return End

484 1788132289838 GEN4_TO_CONTROLLER_LOG:GEN4_PROGRAM_INT_LOG_dsPIC33CK512MP710 Pre:SendOperation
484 1788132289838 GEN4_TO_CONTROLLER_LOG:GEN4_PROGRAM_INT_LOG_dsPIC33CK512MP710 Payload
484 1788132289838 GEN4_TO_CONTROLLER_LOG:GEN4_PROGRAM_INT_LOG_dsPIC33CK512MP710 OperationInfo: Values:
484 1788132289838 GEN4_TO_CONTROLLER_LOG:GEN4_PROGRAM_INT_LOG_dsPIC33CK512MP710 OperationInfo: Type = read, Mask = 00000000, Erase = false, Production Mode = false
484 1788132289838 GEN4_TO_CONTROLLER_LOG:GEN4_PROGRAM_INT_LOG_dsPIC33CK512MP710 TransferInfo: Start = 57800, End = 57fff, Buffer Length = 4096, Type = Pgm, Mask = 00000001
484 1788132289838 GEN4_TO_CONTROLLER_LOG:GEN4_PROGRAM_INT_LOG_dsPIC33CK512MP710 Payload End
484 1788132289838 XXXX 1788132289838, Thread 484: XXXX 1788132289838, Entering Thread 484: Commands::runScriptBasic, script name = SetSpeedFromDevice, timeOut = -1 ms  
484 1788132289839 XXXX 1788132289839, Thread 484: XXXX 1788132289839, Exiting Thread 484: Commands::runScriptBasic  
484 1788132289839 XXXX 1788132289839, Thread 484: XXXX 1788132289839, Entering Thread 484: Commands::runScriptBasic with script contents. contents[0] = 0xed, ...  
484 1788132289840 XXXX 1788132289840, Thread 484: XXXX 1788132289840, Exiting Thread 484: Commands::runScriptBasic  
484 1788132289840 XXXX 1788132289840, Thread 484: XXXX 1788132289840, Entering Thread 484: Commands::runScriptBasic with script contents. contents[0] = 0xec, ...  
484 1788132289841 XXXX 1788132289841, Thread 484: XXXX 1788132289841, Exiting Thread 484: Commands::runScriptBasic  
484 1788132289841 XXXX 1788132289841, Thread 484: XXXX 1788132289841, Entering Thread 484: Commands::runScriptBasic, script name = EnterTMOD_LV, timeOut = -1 ms  
484 1788132289869 XXXX 1788132289869, Thread 484: XXXX 1788132289869, Exiting Thread 484: Commands::runScriptBasic  
484 1788132289869 XXXX 1788132289869, Thread 484: XXXX 1788132289869, Entering Thread 484: Commands::runScriptWithUpload, script name = ReadProgmem  
484 1788132289869 XXXX 1788132289869, Thread 484: XXXX 1788132289869, Entering Thread 484: ToolCommUsb::readTransfer, sideData is 0xb1 bytes long, transferDataLength is 0xc00 bytes long  
484 1788132290814 XXXX 1788132290814, Thread 484: XXXX 1788132290814, Exiting Thread 484: ToolCommUsb::readTransfer,  cr.status = 0x0  
484 1788132290814 XXXX 1788132290814, Thread 484: XXXX 1788132290814, Exiting Thread 484: Commands::runScriptWithUpload  
484 1788132290814 GEN4_TO_CONTROLLER_LOG:GEN4_PROGRAM_INT_LOG_dsPIC33CK512MP710 Post:SendOperation
484 1788132290814 GEN4_TO_CONTROLLER_LOG:GEN4_PROGRAM_INT_LOG_dsPIC33CK512MP710 Return Value
484 1788132290814 GEN4_TO_CONTROLLER_LOG:GEN4_PROGRAM_INT_LOG_dsPIC33CK512MP710 None
484 1788132290814 GEN4_TO_CONTROLLER_LOG:GEN4_PROGRAM_INT_LOG_dsPIC33CK512MP710 Return End

484 1788132290815 GEN4_TO_CONTROLLER_LOG:GEN4_PROGRAM_INT_LOG_dsPIC33CK512MP710 Pre:SendOperation
484 1788132290815 GEN4_TO_CONTROLLER_LOG:GEN4_PROGRAM_INT_LOG_dsPIC33CK512MP710 Payload
484 1788132290815 GEN4_TO_CONTROLLER_LOG:GEN4_PROGRAM_INT_LOG_dsPIC33CK512MP710 OperationInfo: Values:
484 1788132290815 GEN4_TO_CONTROLLER_LOG:GEN4_PROGRAM_INT_LOG_dsPIC33CK512MP710 OperationInfo: Type = write, Mask = 00000000, Erase = false, Production Mode = true
484 1788132290815 GEN4_TO_CONTROLLER_LOG:GEN4_PROGRAM_INT_LOG_dsPIC33CK512MP710 TransferInfo: Start = 0, End = 27ff, Buffer Length = 20480, Type = Pgm, Mask = 00000000
484 1788132290815 GEN4_TO_CONTROLLER_LOG:GEN4_PROGRAM_INT_LOG_dsPIC33CK512MP710 TransferInfo: Start = 57800, End = 57fff, Buffer Length = 4096, Type = Pgm, Mask = 00000001
484 1788132290815 GEN4_TO_CONTROLLER_LOG:GEN4_PROGRAM_INT_LOG_dsPIC33CK512MP710 Payload End
484 1788132290815 XXXX 1788132290815, Thread 484: XXXX 1788132290815, Entering Thread 484: Commands::runScriptBasic, script name = EraseTestmemRange, timeOut = 30000 ms  
484 1788132290869 XXXX 1788132290869, Thread 484: XXXX 1788132290869, Exiting Thread 484: Commands::runScriptBasic  
484 1788132290869 XXXX 1788132290869, Thread 484: XXXX 1788132290869, Entering Thread 484: Commands::runScriptWithDownload, script name = WriteProgmem  
484 1788132293238 XXXX 1788132293238, Thread 484: XXXX 1788132293238, Exiting Thread 484: Commands::runScriptWithDownload(WriteProgmem)  
484 1788132293238 XXXX 1788132293238, Thread 484: XXXX 1788132293238, Entering Thread 484: Commands::runScriptWithUpload, script name = ReadProgmem  
484 1788132293238 XXXX 1788132293238, Thread 484: XXXX 1788132293238, Entering Thread 484: ToolCommUsb::readTransfer, sideData is 0xb1 bytes long, transferDataLength is 0x1800 bytes long  
484 1788132295125 XXXX 1788132295125, Thread 484: XXXX 1788132295125, Exiting Thread 484: ToolCommUsb::readTransfer,  cr.status = 0x0  
484 1788132295125 XXXX 1788132295125, Thread 484: XXXX 1788132295125, Exiting Thread 484: Commands::runScriptWithUpload  
484 1788132295125 XXXX 1788132295125, Thread 484: XXXX 1788132295125, Entering Thread 484: Commands::runScriptBasic, script name = ExitTMOD, timeOut = -1 ms  
484 1788132295127 XXXX 1788132295127, Thread 484: XXXX 1788132295127, Exiting Thread 484: Commands::runScriptBasic  
484 1788132295127 XXXX 1788132295127, Thread 484: XXXX 1788132295127, Entering Thread 484: Commands::runScriptBasic, script name = ExitTMOD, timeOut = -1 ms  
484 1788132295129 XXXX 1788132295129, Thread 484: XXXX 1788132295129, Exiting Thread 484: Commands::runScriptBasic  
484 1788132295129 XXXX 1788132295129, Thread 484: XXXX 1788132295129, Entering Thread 484: Commands::runScriptBasic, script name = SetSpeedFromDevice, timeOut = -1 ms  
484 1788132295130 XXXX 1788132295130, Thread 484: XXXX 1788132295130, Exiting Thread 484: Commands::runScriptBasic  
484 1788132295130 XXXX 1788132295130, Thread 484: XXXX 1788132295130, Entering Thread 484: Commands::runScriptBasic with script contents. contents[0] = 0xed, ...  
484 1788132295131 XXXX 1788132295131, Thread 484: XXXX 1788132295131, Exiting Thread 484: Commands::runScriptBasic  
484 1788132295131 XXXX 1788132295131, Thread 484: XXXX 1788132295131, Entering Thread 484: Commands::runScriptBasic with script contents. contents[0] = 0xec, ...  
484 1788132295132 XXXX 1788132295132, Thread 484: XXXX 1788132295132, Exiting Thread 484: Commands::runScriptBasic  
484 1788132295132 XXXX 1788132295132, Thread 484: XXXX 1788132295132, Entering Thread 484: Commands::runScriptBasic, script name = EnterTMOD_LV, timeOut = -1 ms  
484 1788132295160 XXXX 1788132295160, Thread 484: XXXX 1788132295160, Exiting Thread 484: Commands::runScriptBasic  
484 1788132295160 XXXX 1788132295160, Thread 484: XXXX 1788132295160, Entering Thread 484: Commands::runScriptWithDownload, script name = WriteProgmem  
484 1788132301078 XXXX 1788132301078, Thread 484: XXXX 1788132301078, Exiting Thread 484: Commands::runScriptWithDownload(WriteProgmem)  
484 1788132301078 XXXX 1788132301078, Thread 484: XXXX 1788132301078, Entering Thread 484: Commands::runScriptBasic, script name = EraseTestmemRange, timeOut = 30000 ms  
484 1788132301133 XXXX 1788132301133, Thread 484: XXXX 1788132301133, Exiting Thread 484: Commands::runScriptBasic  
484 1788132301133 XXXX 1788132301133, Thread 484: XXXX 1788132301133, Entering Thread 484: Commands::runScriptWithDownload, script name = WriteProgmem  
484 1788132303501 XXXX 1788132303501, Thread 484: XXXX 1788132303501, Exiting Thread 484: Commands::runScriptWithDownload(WriteProgmem)  
484 1788132303501 XXXX 1788132303501, Thread 484: XXXX 1788132303501, Entering Thread 484: Commands::runScriptWithUpload, script name = ReadProgmem  
484 1788132303501 XXXX 1788132303501, Thread 484: XXXX 1788132303501, Entering Thread 484: ToolCommUsb::readTransfer, sideData is 0xb1 bytes long, transferDataLength is 0x1800 bytes long  
484 1788132305388 XXXX 1788132305388, Thread 484: XXXX 1788132305388, Exiting Thread 484: ToolCommUsb::readTransfer,  cr.status = 0x0  
484 1788132305388 XXXX 1788132305388, Thread 484: XXXX 1788132305388, Exiting Thread 484: Commands::runScriptWithUpload  
484 1788132305388 XXXX 1788132305388, Thread 484: XXXX 1788132305388, Entering Thread 484: Commands::runScriptBasic, script name = ExitTMOD, timeOut = -1 ms  
484 1788132305390 XXXX 1788132305390, Thread 484: XXXX 1788132305390, Exiting Thread 484: Commands::runScriptBasic  
484 1788132305390 XXXX 1788132305390, Thread 484: XXXX 1788132305390, Entering Thread 484: Commands::runScriptBasic, script name = ExitTMOD, timeOut = -1 ms  
484 1788132305391 XXXX 1788132305391, Thread 484: XXXX 1788132305391, Exiting Thread 484: Commands::runScriptBasic  
484 1788132305392 XXXX 1788132305392, Thread 484: XXXX 1788132305392, Entering Thread 484: Commands::runScriptBasic, script name = SetSpeedFromDevice, timeOut = -1 ms  
484 1788132305392 XXXX 1788132305392, Thread 484: XXXX 1788132305392, Exiting Thread 484: Commands::runScriptBasic  
484 1788132305392 XXXX 1788132305392, Thread 484: XXXX 1788132305392, Entering Thread 484: Commands::runScriptBasic with script contents. contents[0] = 0xed, ...  
484 1788132305393 XXXX 1788132305393, Thread 484: XXXX 1788132305393, Exiting Thread 484: Commands::runScriptBasic  
484 1788132305394 XXXX 1788132305394, Thread 484: XXXX 1788132305394, Entering Thread 484: Commands::runScriptBasic with script contents. contents[0] = 0xec, ...  
484 1788132305394 XXXX 1788132305394, Thread 484: XXXX 1788132305394, Exiting Thread 484: Commands::runScriptBasic  
484 1788132305394 XXXX 1788132305394, Thread 484: XXXX 1788132305394, Entering Thread 484: Commands::runScriptBasic, script name = EnterTMOD_LV, timeOut = -1 ms  
484 1788132305422 XXXX 1788132305422, Thread 484: XXXX 1788132305422, Exiting Thread 484: Commands::runScriptBasic  
484 1788132305422 XXXX 1788132305422, Thread 484: XXXX 1788132305422, Entering Thread 484: Commands::runScriptBasic, script name = EraseTestmemRange, timeOut = 30000 ms  
484 1788132305476 XXXX 1788132305476, Thread 484: XXXX 1788132305476, Exiting Thread 484: Commands::runScriptBasic  
484 1788132305476 XXXX 1788132305476, Thread 484: XXXX 1788132305476, Entering Thread 484: Commands::runScriptWithDownload, script name = WriteProgmem  
484 1788132307843 XXXX 1788132307843, Thread 484: XXXX 1788132307843, Exiting Thread 484: Commands::runScriptWithDownload(WriteProgmem)  
484 1788132307843 XXXX 1788132307843, Thread 484: XXXX 1788132307843, Entering Thread 484: Commands::runScriptWithUpload, script name = ReadProgmem  
484 1788132307843 XXXX 1788132307843, Thread 484: XXXX 1788132307843, Entering Thread 484: ToolCommUsb::readTransfer, sideData is 0xb1 bytes long, transferDataLength is 0x1800 bytes long  
484 1788132309732 XXXX 1788132309732, Thread 484: XXXX 1788132309732, Exiting Thread 484: ToolCommUsb::readTransfer,  cr.status = 0x0  
484 1788132309732 XXXX 1788132309732, Thread 484: XXXX 1788132309732, Exiting Thread 484: Commands::runScriptWithUpload  
484 1788132309732 XXXX 1788132309732, Thread 484: XXXX 1788132309732, Entering Thread 484: Commands::runScriptBasic, script name = ExitTMOD, timeOut = -1 ms  
484 1788132309734 XXXX 1788132309734, Thread 484: XXXX 1788132309734, Exiting Thread 484: Commands::runScriptBasic  
484 1788132309734 XXXX 1788132309734, Thread 484: XXXX 1788132309734, Entering Thread 484: Commands::runScriptBasic, script name = ExitTMOD, timeOut = -1 ms  
484 1788132309736 XXXX 1788132309736, Thread 484: XXXX 1788132309736, Exiting Thread 484: Commands::runScriptBasic  
484 1788132309736 XXXX 1788132309736, Thread 484: XXXX 1788132309736, Entering Thread 484: Commands::runScriptBasic, script name = SetSpeedFromDevice, timeOut = -1 ms  
484 1788132309737 XXXX 1788132309737, Thread 484: XXXX 1788132309737, Exiting Thread 484: Commands::runScriptBasic  
484 1788132309737 XXXX 1788132309737, Thread 484: XXXX 1788132309737, Entering Thread 484: Commands::runScriptBasic with script contents. contents[0] = 0xed, ...  
484 1788132309738 XXXX 1788132309738, Thread 484: XXXX 1788132309738, Exiting Thread 484: Commands::runScriptBasic  
484 1788132309738 XXXX 1788132309738, Thread 484: XXXX 1788132309738, Entering Thread 484: Commands::runScriptBasic with script contents. contents[0] = 0xec, ...  
484 1788132309739 XXXX 1788132309739, Thread 484: XXXX 1788132309739, Exiting Thread 484: Commands::runScriptBasic  
484 1788132309739 XXXX 1788132309739, Thread 484: XXXX 1788132309739, Entering Thread 484: Commands::runScriptBasic, script name = EnterTMOD_LV, timeOut = -1 ms  
484 1788132309766 XXXX 1788132309766, Thread 484: XXXX 1788132309766, Exiting Thread 484: Commands::runScriptBasic  
484 1788132309766 XXXX 1788132309766, Thread 484: XXXX 1788132309766, Entering Thread 484: Commands::runScriptWithUpload, script name = ReadProgmem  
484 1788132309766 XXXX 1788132309766, Thread 484: XXXX 1788132309766, Entering Thread 484: ToolCommUsb::readTransfer, sideData is 0xb1 bytes long, transferDataLength is 0x3c00 bytes long  
484 1788132314482 XXXX 1788132314482, Thread 484: XXXX 1788132314482, Exiting Thread 484: ToolCommUsb::readTransfer,  cr.status = 0x0  
484 1788132314482 XXXX 1788132314482, Thread 484: XXXX 1788132314482, Exiting Thread 484: Commands::runScriptWithUpload  

484 1788132314484 GEN4_TO_CONTROLLER_LOG:GEN4_PROGRAM_INT_LOG_dsPIC33CK512MP710 Pre:endOfOperations
484 1788132314484 GEN4_TO_CONTROLLER_LOG:GEN4_PROGRAM_INT_LOG_dsPIC33CK512MP710 Payload
484 1788132314484 GEN4_TO_CONTROLLER_LOG:GEN4_PROGRAM_INT_LOG_dsPIC33CK512MP710 null
484 1788132314484 GEN4_TO_CONTROLLER_LOG:GEN4_PROGRAM_INT_LOG_dsPIC33CK512MP710 Payload End
484 1788132314484 GEN4_TO_CONTROLLER_LOG:GEN4_PROGRAM_INT_LOG_dsPIC33CK512MP710 Post:endOfOperations
484 1788132314484 GEN4_TO_CONTROLLER_LOG:GEN4_PROGRAM_INT_LOG_dsPIC33CK512MP710 Return Value
484 1788132314484 GEN4_TO_CONTROLLER_LOG:GEN4_PROGRAM_INT_LOG_dsPIC33CK512MP710 None
484 1788132314484 GEN4_TO_CONTROLLER_LOG:GEN4_PROGRAM_INT_LOG_dsPIC33CK512MP710 Return End
464 1788132315488 GEN4_CONNECT_DIAGNOSTICS:MPLABCommTool is null

464 1788132315488 GEN4_TO_CONTROLLER_LOG:GEN4_CONNECT_INT_LOG_dsPIC33CK512MP710 Pre:GetFirmwareInfo
464 1788132315488 GEN4_TO_CONTROLLER_LOG:GEN4_CONNECT_INT_LOG_dsPIC33CK512MP710 Payload
464 1788132315488 GEN4_TO_CONTROLLER_LOG:GEN4_CONNECT_INT_LOG_dsPIC33CK512MP710 null
464 1788132315488 GEN4_TO_CONTROLLER_LOG:GEN4_CONNECT_INT_LOG_dsPIC33CK512MP710 Payload End
464 1788132315496 GEN4_TO_CONTROLLER_LOG:GEN4_CONNECT_INT_LOG_dsPIC33CK512MP710 Post:GetFirmwareInfo
464 1788132315496 GEN4_TO_CONTROLLER_LOG:GEN4_CONNECT_INT_LOG_dsPIC33CK512MP710 Return Value
464 1788132315496 GEN4_TO_CONTROLLER_LOG:GEN4_CONNECT_INT_LOG_dsPIC33CK512MP710 FirmwareInfo: Values:
464 1788132315496 GEN4_TO_CONTROLLER_LOG:GEN4_CONNECT_INT_LOG_dsPIC33CK512MP710 FirmwareInfo: boot = false, bootVer = 01.00.00, apVer = 02.05.15, fpgaVer = ff.ff.ff, scriptVer = 00.10.08, macAddress = 0495583578349554857485057485452, devID = a1020e01, devID1 = 2, devSN0 = ffffffff, devSN1 = ffffffff, serialNumber = BUR211672921, appCommitID = null, scriptCommitID = f91823efd7, PCB_ID = 4
464 1788132315496 GEN4_TO_CONTROLLER_LOG:GEN4_CONNECT_INT_LOG_dsPIC33CK512MP710 Return End

464 1788132315496 GEN4_TO_CONTROLLER_LOG:GEN4_CONNECT_INT_LOG_dsPIC33CK512MP710 Pre:SetPowerInfo
464 1788132315496 GEN4_TO_CONTROLLER_LOG:GEN4_CONNECT_INT_LOG_dsPIC33CK512MP710 Payload
464 1788132315496 GEN4_TO_CONTROLLER_LOG:GEN4_CONNECT_INT_LOG_dsPIC33CK512MP710 PowerInfo: Values:
464 1788132315496 GEN4_TO_CONTROLLER_LOG:GEN4_CONNECT_INT_LOG_dsPIC33CK512MP710 PowerInfo: shotDownSystem = true, isToolPower = false, voltage = 0.000000, useVppFirst = false, useLowVoltageProgramming = true, useMaintainActivePower = false
464 1788132315496 GEN4_TO_CONTROLLER_LOG:GEN4_CONNECT_INT_LOG_dsPIC33CK512MP710 Payload End
464 1788132315496 XXXX 1788132315496, Thread 464: XXXX 1788132315496, Entering Thread 464: Commands::runScriptBasic with script contents. contents[0] = 0x39, ...  
464 1788132315497 XXXX 1788132315497, Thread 464: XXXX 1788132315497, Exiting Thread 464: Commands::runScriptBasic  
464 1788132315497 XXXX 1788132315497, Thread 464: XXXX 1788132315497, Entering Thread 464: Commands::runScriptBasic with script contents. contents[0] = 0x44, ...  
464 1788132315509 XXXX 1788132315509, Thread 464: XXXX 1788132315509, Exiting Thread 464: Commands::runScriptBasic  
464 1788132315509 GEN4_TO_CONTROLLER_LOG:GEN4_CONNECT_INT_LOG_dsPIC33CK512MP710 Post:SetPowerInfo
464 1788132315509 GEN4_TO_CONTROLLER_LOG:GEN4_CONNECT_INT_LOG_dsPIC33CK512MP710 Return Value
464 1788132315509 GEN4_TO_CONTROLLER_LOG:GEN4_CONNECT_INT_LOG_dsPIC33CK512MP710 none
464 1788132315509 GEN4_TO_CONTROLLER_LOG:GEN4_CONNECT_INT_LOG_dsPIC33CK512MP710 Return End
464 1788132315510 GEN4_CONNECT_DIAGNOSTICS:Removing plug and play observer com.microchip.mplab.mdbcore.RI4Tool.RI4ToolBase$RI4PlugNPlayObserver@493b75ae
464 1788132315510 GEN4_CONNECT_DIAGNOSTICS:Begin PlugNPlayObservers list dump:
464 1788132315510 GEN4_CONNECT_DIAGNOSTICS:End PlugNPlayObservers list dump:
464 1788132315560 GEN4_CONNECT_DIAGNOSTICS:Calling RIDbgToolCom.Disconnect
464 1788132315560 GEN4_CONNECT_DIAGNOSTICS:Calling MPLABCommTool.Detach to remove tool from plug and play list
464 1788132315560 GEN4_CONNECT_DIAGNOSTICS:Calling RIDbgToolCom.DisconnectFromMPlabComm
464 1788132315560 GEN4_CONNECT_DIAGNOSTICS:Calling MPLABCommTool.Disconnect
512 1788132383494 GEN4_CONNECT_DIAGNOSTICS:MPLABCommTool is NOT null
512 1788132383494 GEN4_CONNECT_DIAGNOSTICS:AttachedToolPID = 9012, AttachedToolVID = 4d8
512 1788132383494 GEN4_CONNECT_DIAGNOSTICS:transport type = USB
512 1788132383494 GEN4_CONNECT_DIAGNOSTICS:AttachedToolPID = 9012, AttachedToolVID = 4d8
512 1788132383497 com.microchip.mplab.mdbcore.RealICETool.RIDbgToolCom
512 1788132383497 GEN4_CONNECT_DIAGNOSTICS:Before MPLABCommTool.Connect()
512 1788132383497 GEN4_CONNECT_DIAGNOSTICS:After MPLABCommTool.Connect()
512 1788132383497 GEN4_CONNECT_DIAGNOSTICS:MPLABCommTool.Connect() returned MPLABCOMM_NO_ERROR
512 1788132383497 GEN4_CONNECT_DIAGNOSTICS:Attaching to MPLABCommTool plugnplay
512 1788132383497 GEN4_CONNECT_DIAGNOSTICS:Adding new plug and play observer com.microchip.mplab.mdbcore.RI4Tool.RI4ToolBase$RI4PlugNPlayObserver@3496615e
512 1788132383497 GEN4_CONNECT_DIAGNOSTICS:Begin PlugNPlayObservers list dump:
512 1788132383497 GEN4_CONNECT_DIAGNOSTICS:com.microchip.mplab.mdbcore.RI4Tool.RI4ToolBase$RI4PlugNPlayObserver@3496615e
512 1788132383497 GEN4_CONNECT_DIAGNOSTICS:End PlugNPlayObservers list dump:
512 1788132383497 GEN4_CONNECT_DIAGNOSTICS:Registering for alternate PNP notifications. CommPnPCriteria.cPIDList = [2177, 2179, 217a, 2141, 9017, 901b, 9036, 9035], CommPnPCriteria.cSerialNumber = bur211672921

512 1788132383519 GEN4_TO_CONTROLLER_LOG:GEN4_INIT_INT_LOG_dsPIC33CK512MP710 Pre:init
512 1788132383519 GEN4_TO_CONTROLLER_LOG:GEN4_INIT_INT_LOG_dsPIC33CK512MP710 Payload
512 1788132383519 GEN4_TO_CONTROLLER_LOG:GEN4_INIT_INT_LOG_dsPIC33CK512MP710 DeviceInfo: Values:
512 1788132383519 GEN4_TO_CONTROLLER_LOG:GEN4_INIT_INT_LOG_dsPIC33CK512MP710 DeviceInfo: pcAddress = 0000002e, Vpp = 3.25, useRowEraseIfVoltageIsLow = false, voltageBelowWhichUseRowErase = 0.00, deviceName = dsPIC33CK512MP710, programmerType = DSPIC33EP
512 1788132383519 GEN4_TO_CONTROLLER_LOG:GEN4_INIT_INT_LOG_dsPIC33CK512MP710 DeviceInfo: MemInfo values:
512 1788132383519 GEN4_TO_CONTROLLER_LOG:GEN4_INIT_INT_LOG_dsPIC33CK512MP710 DeviceInfo: mask = ffffff, exists = true, startAddr = 00000000, endAddr = 00057eff, rowSize = 0800, rowEraseSize = 0800, addrInc = 0002, widthProgram = 0004
512 1788132383519 GEN4_TO_CONTROLLER_LOG:GEN4_INIT_INT_LOG_dsPIC33CK512MP710 DeviceInfo: mask = ffff, exists = true, startAddr = 00057f00, endAddr = 00057fff, rowSize = 0001, rowEraseSize = 0000, addrInc = 0002, widthProgram = 0004
512 1788132383519 GEN4_TO_CONTROLLER_LOG:GEN4_INIT_INT_LOG_dsPIC33CK512MP710 DeviceInfo: mask = 0000, exists = false, startAddr = 00000000, endAddr = 00000000, rowSize = 0000, rowEraseSize = 0800, addrInc = 0000, widthProgram = 0000
512 1788132383519 GEN4_TO_CONTROLLER_LOG:GEN4_INIT_INT_LOG_dsPIC33CK512MP710 DeviceInfo: mask = 0000, exists = false, startAddr = 00000000, endAddr = 00000000, rowSize = 0000, rowEraseSize = 0000, addrInc = 0000, widthProgram = 0000
512 1788132383519 GEN4_TO_CONTROLLER_LOG:GEN4_INIT_INT_LOG_dsPIC33CK512MP710 DeviceInfo: mask = 0000, exists = false, startAddr = 00000000, endAddr = 00000000, rowSize = 0000, rowEraseSize = 0000, addrInc = 0000, widthProgram = 0000
512 1788132383519 GEN4_TO_CONTROLLER_LOG:GEN4_INIT_INT_LOG_dsPIC33CK512MP710 DeviceInfo: mask = ffffff, exists = true, startAddr = 00800000, endAddr = 008016ff, rowSize = 0800, rowEraseSize = 0800, addrInc = 0002, widthProgram = 0004
512 1788132383519 GEN4_TO_CONTROLLER_LOG:GEN4_INIT_INT_LOG_dsPIC33CK512MP710 DeviceInfo: mask = 0000, exists = false, startAddr = 00000000, endAddr = 00000000, rowSize = 0000, rowEraseSize = 0000, addrInc = 0002, widthProgram = 0002
512 1788132383519 GEN4_TO_CONTROLLER_LOG:GEN4_INIT_INT_LOG_dsPIC33CK512MP710 DeviceInfo: mask = 0000, exists = false, startAddr = 00000000, endAddr = 00000000, rowSize = 0000, rowEraseSize = 0000, addrInc = 0000, widthProgram = 0000
512 1788132383519 GEN4_TO_CONTROLLER_LOG:GEN4_INIT_INT_LOG_dsPIC33CK512MP710 DeviceInfo: mask = 0000, exists = false, startAddr = 00000000, endAddr = 00000000, rowSize = 0000, rowEraseSize = 0000, addrInc = 0000, widthProgram = 0000
512 1788132383519 GEN4_TO_CONTROLLER_LOG:GEN4_INIT_INT_LOG_dsPIC33CK512MP710 DeviceInfo: mask = 0000, exists = false, startAddr = 00000000, endAddr = 00000000, rowSize = 0000, rowEraseSize = 0000, addrInc = 0000, widthProgram = 0000
512 1788132383519 GEN4_TO_CONTROLLER_LOG:GEN4_INIT_INT_LOG_dsPIC33CK512MP710 DeviceInfo: mask = 0000, exists = false, startAddr = 00000000, endAddr = 00000000, rowSize = 0000, rowEraseSize = 0000, addrInc = 0002, widthProgram = 0002
512 1788132383519 GEN4_TO_CONTROLLER_LOG:GEN4_INIT_INT_LOG_dsPIC33CK512MP710 DeviceInfo: mask = 0000, exists = false, startAddr = 00000000, endAddr = 00000000, rowSize = 0000, rowEraseSize = 0000, addrInc = 0000, widthProgram = 0000
512 1788132383519 GEN4_TO_CONTROLLER_LOG:GEN4_INIT_INT_LOG_dsPIC33CK512MP710 DeviceInfo: mask = 0000, exists = false, startAddr = 00000000, endAddr = 00000000, rowSize = 0000, rowEraseSize = 0000, addrInc = 0000, widthProgram = 0000
512 1788132383519 GEN4_TO_CONTROLLER_LOG:GEN4_INIT_INT_LOG_dsPIC33CK512MP710 DeviceInfo: mask = ffffff, exists = true, startAddr = 00801700, endAddr = 008017ff, rowSize = 0001, rowEraseSize = 0000, addrInc = 0002, widthProgram = 0004
512 1788132383519 GEN4_TO_CONTROLLER_LOG:GEN4_INIT_INT_LOG_dsPIC33CK512MP710 DeviceInfo: mask = ffffffff, exists = true, startAddr = 00801800, endAddr = 00801801, rowSize = 0000, rowEraseSize = 0000, addrInc = 0002, widthProgram = 0003
512 1788132383519 GEN4_TO_CONTROLLER_LOG:GEN4_INIT_INT_LOG_dsPIC33CK512MP710 DeviceInfo: mask = 0000, exists = false, startAddr = 00000000, endAddr = 00000000, rowSize = 0000, rowEraseSize = 0000, addrInc = 0000, widthProgram = 0000
512 1788132383519 GEN4_TO_CONTROLLER_LOG:GEN4_INIT_INT_LOG_dsPIC33CK512MP710 DeviceInfo: mask = 7fffffff, exists = true, startAddr = 00ff0000, endAddr = 00ff0003, rowSize = 0001, rowEraseSize = 0000, addrInc = 0001, widthProgram = 0001
512 1788132383519 GEN4_TO_CONTROLLER_LOG:GEN4_INIT_INT_LOG_dsPIC33CK512MP710 DeviceInfo: mask = 0000, exists = false, startAddr = 00000000, endAddr = 00000000, rowSize = 0000, rowEraseSize = 0000, addrInc = 0000, widthProgram = 0000
512 1788132383519 GEN4_TO_CONTROLLER_LOG:GEN4_INIT_INT_LOG_dsPIC33CK512MP710 DeviceInfo: mask = 0000, exists = false, startAddr = 00000000, endAddr = 00000000, rowSize = 0000, rowEraseSize = 0000, addrInc = 0000, widthProgram = 0000
512 1788132383519 GEN4_TO_CONTROLLER_LOG:GEN4_INIT_INT_LOG_dsPIC33CK512MP710 DeviceInfo: mask = 0000, exists = false, startAddr = 00000000, endAddr = 00000000, rowSize = 0000, rowEraseSize = 0000, addrInc = 0000, widthProgram = 0000
512 1788132383519 GEN4_TO_CONTROLLER_LOG:GEN4_INIT_INT_LOG_dsPIC33CK512MP710 DeviceInfo: mask = 0000, exists = false, startAddr = 00000000, endAddr = 00000000, rowSize = 0000, rowEraseSize = 0000, addrInc = 0000, widthProgram = 0000
512 1788132383519 GEN4_TO_CONTROLLER_LOG:GEN4_INIT_INT_LOG_dsPIC33CK512MP710 DeviceInfo: mask = 0000, exists = false, startAddr = 00000000, endAddr = 00000000, rowSize = 0000, rowEraseSize = 0000, addrInc = 0000, widthProgram = 0000
512 1788132383519 GEN4_TO_CONTROLLER_LOG:GEN4_INIT_INT_LOG_dsPIC33CK512MP710 DeviceInfo: mask = 0000, exists = true, startAddr = 00801200, endAddr = 00801209, rowSize = 0000, rowEraseSize = 0000, addrInc = 0002, widthProgram = 0004
512 1788132383519 GEN4_TO_CONTROLLER_LOG:GEN4_INIT_INT_LOG_dsPIC33CK512MP710 DeviceInfo: mask = 0000, exists = false, startAddr = 00000000, endAddr = 00000000, rowSize = 0000, rowEraseSize = 0000, addrInc = 0000, widthProgram = 0000
512 1788132383519 GEN4_TO_CONTROLLER_LOG:GEN4_INIT_INT_LOG_dsPIC33CK512MP710 DeviceInfo: CfgRequiredBitsMask Values:
512 1788132383519 GEN4_TO_CONTROLLER_LOG:GEN4_INIT_INT_LOG_dsPIC33CK512MP710 Address = 00057f00, Mask = 00008fef
512 1788132383519 GEN4_TO_CONTROLLER_LOG:GEN4_INIT_INT_LOG_dsPIC33CK512MP710 Address = 00057f10, Mask = 00001fff
512 1788132383519 GEN4_TO_CONTROLLER_LOG:GEN4_INIT_INT_LOG_dsPIC33CK512MP710 Address = 00057f14, Mask = 00ff7fff
512 1788132383519 GEN4_TO_CONTROLLER_LOG:GEN4_INIT_INT_LOG_dsPIC33CK512MP710 Address = 00057f18, Mask = 00000087
512 1788132383519 GEN4_TO_CONTROLLER_LOG:GEN4_INIT_INT_LOG_dsPIC33CK512MP710 Address = 00057f1c, Mask = 00001dc7
512 1788132383519 GEN4_TO_CONTROLLER_LOG:GEN4_INIT_INT_LOG_dsPIC33CK512MP710 Address = 00057f20, Mask = 0000ffff
512 1788132383519 GEN4_TO_CONTROLLER_LOG:GEN4_INIT_INT_LOG_dsPIC33CK512MP710 Address = 00057f24, Mask = 00000040
512 1788132383519 GEN4_TO_CONTROLLER_LOG:GEN4_INIT_INT_LOG_dsPIC33CK512MP710 Address = 00057f28, Mask = 00008003
512 1788132383519 GEN4_TO_CONTROLLER_LOG:GEN4_INIT_INT_LOG_dsPIC33CK512MP710 Address = 00057f2c, Mask = 0000ffff
512 1788132383519 GEN4_TO_CONTROLLER_LOG:GEN4_INIT_INT_LOG_dsPIC33CK512MP710 Address = 00057f30, Mask = 0000ffff
512 1788132383519 GEN4_TO_CONTROLLER_LOG:GEN4_INIT_INT_LOG_dsPIC33CK512MP710 Address = 00057f34, Mask = 0000ffff
512 1788132383519 GEN4_TO_CONTROLLER_LOG:GEN4_INIT_INT_LOG_dsPIC33CK512MP710 Address = 00057f38, Mask = 0000ffff
512 1788132383519 GEN4_TO_CONTROLLER_LOG:GEN4_INIT_INT_LOG_dsPIC33CK512MP710 Address = 00057f3c, Mask = 00000001
512 1788132383519 GEN4_TO_CONTROLLER_LOG:GEN4_INIT_INT_LOG_dsPIC33CK512MP710 Address = 00057f40, Mask = 00003438
512 1788132383519 GEN4_TO_CONTROLLER_LOG:GEN4_INIT_INT_LOG_dsPIC33CK512MP710 Address = 00057f44, Mask = 00007777
512 1788132383519 GEN4_TO_CONTROLLER_LOG:GEN4_INIT_INT_LOG_dsPIC33CK512MP710 Address = 00057ffc, Mask = 00ffffff
512 1788132383519 GEN4_TO_CONTROLLER_LOG:GEN4_INIT_INT_LOG_dsPIC33CK512MP710 BasicInfo: Values:
512 1788132383519 GEN4_TO_CONTROLLER_LOG:GEN4_INIT_INT_LOG_dsPIC33CK512MP710 BasicInfo: InputStream = java.util.zip.ZipInputStream@22cf1cf5, ToolFlavor = PICKit4
512 1788132383519 GEN4_TO_CONTROLLER_LOG:GEN4_INIT_INT_LOG_dsPIC33CK512MP710 Payload End
512 1788132383519 GEN4_TO_CONTROLLER_LOG:GEN4_INIT_INT_LOG_dsPIC33CK512MP710 Post:init
512 1788132383519 GEN4_TO_CONTROLLER_LOG:GEN4_INIT_INT_LOG_dsPIC33CK512MP710 Return Value
512 1788132383519 GEN4_TO_CONTROLLER_LOG:GEN4_INIT_INT_LOG_dsPIC33CK512MP710 none
512 1788132383519 GEN4_TO_CONTROLLER_LOG:GEN4_INIT_INT_LOG_dsPIC33CK512MP710 Return End

512 1788132383519 GEN4_TO_CONTROLLER_LOG:GEN4_INIT_INT_LOG_dsPIC33CK512MP710 Pre:GetInterfaceProvider
512 1788132383519 GEN4_TO_CONTROLLER_LOG:GEN4_INIT_INT_LOG_dsPIC33CK512MP710 Payload
512 1788132383519 GEN4_TO_CONTROLLER_LOG:GEN4_INIT_INT_LOG_dsPIC33CK512MP710 RI4DebugInterface
512 1788132383519 GEN4_TO_CONTROLLER_LOG:GEN4_INIT_INT_LOG_dsPIC33CK512MP710 Payload End
512 1788132383519 GEN4_TO_CONTROLLER_LOG:GEN4_INIT_INT_LOG_dsPIC33CK512MP710 Post:GetInterfaceProvider
512 1788132383519 GEN4_TO_CONTROLLER_LOG:GEN4_INIT_INT_LOG_dsPIC33CK512MP710 Return Value
512 1788132383519 GEN4_TO_CONTROLLER_LOG:GEN4_INIT_INT_LOG_dsPIC33CK512MP710 com.microchip.mplab.libs.RI4ToolsController.implementations.RI4DebugInterfaceImpl@37c3325e
512 1788132383519 GEN4_TO_CONTROLLER_LOG:GEN4_INIT_INT_LOG_dsPIC33CK512MP710 Return End

512 1788132383519 GEN4_TO_CONTROLLER_LOG:GEN4_INIT_INT_LOG_dsPIC33CK512MP710 Pre:GetInterfaceProvider
512 1788132383519 GEN4_TO_CONTROLLER_LOG:GEN4_INIT_INT_LOG_dsPIC33CK512MP710 Payload
512 1788132383519 GEN4_TO_CONTROLLER_LOG:GEN4_INIT_INT_LOG_dsPIC33CK512MP710 RI4ProgramInterface
512 1788132383519 GEN4_TO_CONTROLLER_LOG:GEN4_INIT_INT_LOG_dsPIC33CK512MP710 Payload End
512 1788132383519 GEN4_TO_CONTROLLER_LOG:GEN4_INIT_INT_LOG_dsPIC33CK512MP710 Post:GetInterfaceProvider
512 1788132383519 GEN4_TO_CONTROLLER_LOG:GEN4_INIT_INT_LOG_dsPIC33CK512MP710 Return Value
512 1788132383519 GEN4_TO_CONTROLLER_LOG:GEN4_INIT_INT_LOG_dsPIC33CK512MP710 com.microchip.mplab.libs.RI4ToolsController.implementations.RI4ProgramInterfaceImpl@30d83969
512 1788132383519 GEN4_TO_CONTROLLER_LOG:GEN4_INIT_INT_LOG_dsPIC33CK512MP710 Return End

512 1788132383520 GEN4_TO_CONTROLLER_LOG:GEN4_INIT_INT_LOG_dsPIC33CK512MP710 Pre:GetInterfaceProvider
512 1788132383520 GEN4_TO_CONTROLLER_LOG:GEN4_INIT_INT_LOG_dsPIC33CK512MP710 Payload
512 1788132383520 GEN4_TO_CONTROLLER_LOG:GEN4_INIT_INT_LOG_dsPIC33CK512MP710 RI4ConnectInterface
512 1788132383520 GEN4_TO_CONTROLLER_LOG:GEN4_INIT_INT_LOG_dsPIC33CK512MP710 Payload End
512 1788132383520 GEN4_TO_CONTROLLER_LOG:GEN4_INIT_INT_LOG_dsPIC33CK512MP710 Post:GetInterfaceProvider
512 1788132383520 GEN4_TO_CONTROLLER_LOG:GEN4_INIT_INT_LOG_dsPIC33CK512MP710 Return Value
512 1788132383520 GEN4_TO_CONTROLLER_LOG:GEN4_INIT_INT_LOG_dsPIC33CK512MP710 com.microchip.mplab.libs.PK4ToolsController.PK4ConnectInterfaceImpl@487cf26d
512 1788132383520 GEN4_TO_CONTROLLER_LOG:GEN4_INIT_INT_LOG_dsPIC33CK512MP710 Return End
512 1788132383520 GEN4_CONNECT_DIAGNOSTICS:acceptablePIDs = [9012, 9017, 901b, 9036, 9035]
512 1788132383520 GEN4_CONNECT_DIAGNOSTICS:otherPIDs = [2177, 2179, 217a, 2141]
512 1788132383520 GEN4_CONNECT_DIAGNOSTICS:Setting selected tool type to pk4
512 1788132383520 GEN4_CONNECT_DIAGNOSTICS:otherPIDs = [2177, 2179, 217a, 2141]
512 1788132383520 GEN4_CONNECT_DIAGNOSTICS:acceptablePIDs = [9012, 9017, 901b, 9036, 9035]

512 1788132383520 GEN4_TO_CONTROLLER_LOG:GEN4_INIT_INT_LOG_dsPIC33CK512MP710 Pre:GetInterfaceProvider
512 1788132383520 GEN4_TO_CONTROLLER_LOG:GEN4_INIT_INT_LOG_dsPIC33CK512MP710 Payload
512 1788132383520 GEN4_TO_CONTROLLER_LOG:GEN4_INIT_INT_LOG_dsPIC33CK512MP710 RI4ControllerDiagnosticsInterface
512 1788132383520 GEN4_TO_CONTROLLER_LOG:GEN4_INIT_INT_LOG_dsPIC33CK512MP710 Payload End
512 1788132383520 GEN4_TO_CONTROLLER_LOG:GEN4_INIT_INT_LOG_dsPIC33CK512MP710 Post:GetInterfaceProvider
512 1788132383520 GEN4_TO_CONTROLLER_LOG:GEN4_INIT_INT_LOG_dsPIC33CK512MP710 Return Value
512 1788132383520 GEN4_TO_CONTROLLER_LOG:GEN4_INIT_INT_LOG_dsPIC33CK512MP710 com.microchip.mplab.libs.RI4ToolsController.implementations.RI4ControllerDiagnosticsInterfaceImpl@120e6723
512 1788132383520 GEN4_TO_CONTROLLER_LOG:GEN4_INIT_INT_LOG_dsPIC33CK512MP710 Return End

512 1788132383520 GEN4_TO_CONTROLLER_LOG:GEN4_INIT_INT_LOG_dsPIC33CK512MP710 Pre:GetInterfaceProvider
512 1788132383520 GEN4_TO_CONTROLLER_LOG:GEN4_INIT_INT_LOG_dsPIC33CK512MP710 Payload
512 1788132383520 GEN4_TO_CONTROLLER_LOG:GEN4_INIT_INT_LOG_dsPIC33CK512MP710 ProgrammerToGo
512 1788132383520 GEN4_TO_CONTROLLER_LOG:GEN4_INIT_INT_LOG_dsPIC33CK512MP710 Payload End
512 1788132383520 GEN4_TO_CONTROLLER_LOG:GEN4_INIT_INT_LOG_dsPIC33CK512MP710 Post:GetInterfaceProvider
512 1788132383520 GEN4_TO_CONTROLLER_LOG:GEN4_INIT_INT_LOG_dsPIC33CK512MP710 Return Value
512 1788132383520 GEN4_TO_CONTROLLER_LOG:GEN4_INIT_INT_LOG_dsPIC33CK512MP710 com.microchip.mplab.libs.RI4ToolsController.implementations.ProgrammerToGoImpl@3c71f6fe
512 1788132383520 GEN4_TO_CONTROLLER_LOG:GEN4_INIT_INT_LOG_dsPIC33CK512MP710 Return End

512 1788132383520 GEN4_TO_CONTROLLER_LOG:GEN4_INIT_INT_LOG_dsPIC33CK512MP710 Pre:GetInterfaceProvider
512 1788132383520 GEN4_TO_CONTROLLER_LOG:GEN4_INIT_INT_LOG_dsPIC33CK512MP710 Payload
512 1788132383520 GEN4_TO_CONTROLLER_LOG:GEN4_INIT_INT_LOG_dsPIC33CK512MP710 Status
512 1788132383520 GEN4_TO_CONTROLLER_LOG:GEN4_INIT_INT_LOG_dsPIC33CK512MP710 Payload End
512 1788132383520 GEN4_TO_CONTROLLER_LOG:GEN4_INIT_INT_LOG_dsPIC33CK512MP710 Post:GetInterfaceProvider
512 1788132383520 GEN4_TO_CONTROLLER_LOG:GEN4_INIT_INT_LOG_dsPIC33CK512MP710 Return Value
512 1788132383520 GEN4_TO_CONTROLLER_LOG:GEN4_INIT_INT_LOG_dsPIC33CK512MP710 null
512 1788132383520 GEN4_TO_CONTROLLER_LOG:GEN4_INIT_INT_LOG_dsPIC33CK512MP710 Return End

512 1788132383525 GEN4_TO_CONTROLLER_LOG:GEN4_PROGRAM_INT_LOG_dsPIC33CK512MP710 Pre:SetProgramExec
512 1788132383525 GEN4_TO_CONTROLLER_LOG:GEN4_PROGRAM_INT_LOG_dsPIC33CK512MP710 Payload
512 1788132383525 GEN4_TO_CONTROLLER_LOG:GEN4_PROGRAM_INT_LOG_dsPIC33CK512MP710 Test
512 1788132383525 GEN4_TO_CONTROLLER_LOG:GEN4_PROGRAM_INT_LOG_dsPIC33CK512MP710 800000
512 1788132383525 GEN4_TO_CONTROLLER_LOG:GEN4_PROGRAM_INT_LOG_dsPIC33CK512MP710 Length = 4608
512 1788132383525 GEN4_TO_CONTROLLER_LOG:GEN4_PROGRAM_INT_LOG_dsPIC33CK512MP710 Payload End
512 1788132383525 GEN4_TO_CONTROLLER_LOG:GEN4_PROGRAM_INT_LOG_dsPIC33CK512MP710 Post:SetProgramExec
512 1788132383525 GEN4_TO_CONTROLLER_LOG:GEN4_PROGRAM_INT_LOG_dsPIC33CK512MP710 Return Value
512 1788132383525 GEN4_TO_CONTROLLER_LOG:GEN4_PROGRAM_INT_LOG_dsPIC33CK512MP710 true
512 1788132383525 GEN4_TO_CONTROLLER_LOG:GEN4_PROGRAM_INT_LOG_dsPIC33CK512MP710 Return End
512 1788132383525 GEN4_CONNECT_DIAGNOSTICS:ENTERING: com.microchip.mplab.mdbcore.RI4Tool.ConnectionHandler.CheckForFWUpdates()
512 1788132383525 GEN4_CONNECT_DIAGNOSTICS:Created FirmwareUpdateHandler com.microchip.mplab.mdbcore.pk4hybrid.pk4hybridFirmwareUpdateHandler@4d139368
512 1788132383525 GEN4_CONNECT_DIAGNOSTICS:ENTERING: com.microchip.mplab.mdbcore.pk4hybrid.pk4hybridFirmwareUpdateHandler.UpdateFirmware(FirmwareInfo, UpdateMessage)
512 1788132383525 GEN4_CONNECT_DIAGNOSTICS:areWeInBoot returned false
512 1788132383525 GEN4_CONNECT_DIAGNOSTICS:inBoot = false
512 1788132383525 GEN4_CONNECT_DIAGNOSTICS:uMode = checkingVersions
512 1788132383525 GEN4_CONNECT_DIAGNOSTICS:selectedTool = pk4
512 1788132383525 GEN4_CONNECT_DIAGNOSTICS:current toolType = pk4
512 1788132383525 GEN4_CONNECT_DIAGNOSTICS:current tool mode = pk4
512 1788132383525 GEN4_CONNECT_DIAGNOSTICS:ENTERING: com.microchip.mplab.mdbcore.pk4hybrid.pk4hybridFirmwareUpdateHandler.GetUpdateInfo()
512 1788132383526 GEN4_CONNECT_DIAGNOSTICS:Parsing file  for firmware updates
512 1788132383526 GEN4_CONNECT_DIAGNOSTICS:ENTERING: com.microchip.mplab.mdbcore.pk4hybrid.pk4hybridFirmwareUpdateHandler.ParseSelectedVersionsFromJamFile()
512 1788132383526 GEN4_CONNECT_DIAGNOSTICS:Jame file line = boot.hex,010000
512 1788132383526 GEN4_CONNECT_DIAGNOSTICS:Jame file line = scripts.xml,001008
512 1788132383526 GEN4_CONNECT_DIAGNOSTICS:Jame file line = app1 020515, 0040C000
512 1788132383526 GEN4_CONNECT_DIAGNOSTICS:Jame file line = app2 1.15.20, 00500000
512 1788132383526 GEN4_CONNECT_DIAGNOSTICS:Jame file line = app3 000000, FFFFFFFF
512 1788132383526 GEN4_CONNECT_DIAGNOSTICS:Jame file line = app4 000000, FFFFFFFF
512 1788132383526 GEN4_CONNECT_DIAGNOSTICS:Jame file line = app5 000000, FFFFFFFF
512 1788132383526 GEN4_CONNECT_DIAGNOSTICS:Jame file line = app6 000000, FFFFFFFF
512 1788132383526 GEN4_CONNECT_DIAGNOSTICS:Jame file line = app7 000000, FFFFFFFF
512 1788132383526 GEN4_CONNECT_DIAGNOSTICS:Jame file line = app8 000000, FFFFFFFF
512 1788132383526 GEN4_CONNECT_DIAGNOSTICS:EXITING: com.microchip.mplab.mdbcore.pk4hybrid.pk4hybridFirmwareUpdateHandler.ri4ParseSelectedVersionsFromJamFile()
512 1788132383526 GEN4_CONNECT_DIAGNOSTICS:EXITING: com.microchip.mplab.mdbcore.pk4hybrid.pk4hybridFirmwareUpdateHandler.GetUpdateInfo()
512 1788132383526 GEN4_CONNECT_DIAGNOSTICS:current toolType = pk4

512 1788132383526 GEN4_TO_CONTROLLER_LOG:GEN4_CONNECT_INT_LOG_dsPIC33CK512MP710 Pre:EstablishCommunincations
512 1788132383526 GEN4_TO_CONTROLLER_LOG:GEN4_CONNECT_INT_LOG_dsPIC33CK512MP710 Payload
512 1788132383526 GEN4_TO_CONTROLLER_LOG:GEN4_CONNECT_INT_LOG_dsPIC33CK512MP710 com.microchip.mplab.mdbcore.PK4Tool.PK4Com@65278c35
512 1788132383526 GEN4_TO_CONTROLLER_LOG:GEN4_CONNECT_INT_LOG_dsPIC33CK512MP710 Payload End
512 1788132383526 GEN4_TO_CONTROLLER_LOG:GEN4_CONNECT_INT_LOG_dsPIC33CK512MP710 Post:EstablishCommunincations
512 1788132383526 GEN4_TO_CONTROLLER_LOG:GEN4_CONNECT_INT_LOG_dsPIC33CK512MP710 Return Value
512 1788132383526 GEN4_TO_CONTROLLER_LOG:GEN4_CONNECT_INT_LOG_dsPIC33CK512MP710 true
512 1788132383526 GEN4_TO_CONTROLLER_LOG:GEN4_CONNECT_INT_LOG_dsPIC33CK512MP710 Return End

512 1788132383526 GEN4_TO_CONTROLLER_LOG:GEN4_CONNECT_INT_LOG_dsPIC33CK512MP710 Pre:GetFirmwareInfo
512 1788132383526 GEN4_TO_CONTROLLER_LOG:GEN4_CONNECT_INT_LOG_dsPIC33CK512MP710 Payload
512 1788132383526 GEN4_TO_CONTROLLER_LOG:GEN4_CONNECT_INT_LOG_dsPIC33CK512MP710 null
512 1788132383526 GEN4_TO_CONTROLLER_LOG:GEN4_CONNECT_INT_LOG_dsPIC33CK512MP710 Payload End
512 1788132383533 GEN4_TO_CONTROLLER_LOG:GEN4_CONNECT_INT_LOG_dsPIC33CK512MP710 Post:GetFirmwareInfo
512 1788132383533 GEN4_TO_CONTROLLER_LOG:GEN4_CONNECT_INT_LOG_dsPIC33CK512MP710 Return Value
512 1788132383533 GEN4_TO_CONTROLLER_LOG:GEN4_CONNECT_INT_LOG_dsPIC33CK512MP710 FirmwareInfo: Values:
512 1788132383534 GEN4_TO_CONTROLLER_LOG:GEN4_CONNECT_INT_LOG_dsPIC33CK512MP710 FirmwareInfo: boot = false, bootVer = 01.00.00, apVer = 02.05.15, fpgaVer = ff.ff.ff, scriptVer = 00.10.08, macAddress = 0495583578349554857485057485452, devID = a1020e01, devID1 = 2, devSN0 = ffffffff, devSN1 = ffffffff, serialNumber = BUR211672921, appCommitID = null, scriptCommitID = f91823efd7, PCB_ID = 4
512 1788132383534 GEN4_TO_CONTROLLER_LOG:GEN4_CONNECT_INT_LOG_dsPIC33CK512MP710 Return End
512 1788132383538 GEN4_CONNECT_DIAGNOSTICS:appNeedsUpdate returned false
512 1788132383538 GEN4_CONNECT_DIAGNOSTICS:EXITING: com.microchip.mplab.mdbcore.RI4Tool.ConnectionHandler.CheckForFWUpdates()

512 1788132383538 GEN4_TO_CONTROLLER_LOG:GEN4_CONNECT_INT_LOG_dsPIC33CK512MP710 Pre:EstablishCommunincations
512 1788132383538 GEN4_TO_CONTROLLER_LOG:GEN4_CONNECT_INT_LOG_dsPIC33CK512MP710 Payload
512 1788132383538 GEN4_TO_CONTROLLER_LOG:GEN4_CONNECT_INT_LOG_dsPIC33CK512MP710 com.microchip.mplab.mdbcore.PK4Tool.PK4Com@65278c35
512 1788132383538 GEN4_TO_CONTROLLER_LOG:GEN4_CONNECT_INT_LOG_dsPIC33CK512MP710 Payload End
512 1788132383538 GEN4_TO_CONTROLLER_LOG:GEN4_CONNECT_INT_LOG_dsPIC33CK512MP710 Post:EstablishCommunincations
512 1788132383538 GEN4_TO_CONTROLLER_LOG:GEN4_CONNECT_INT_LOG_dsPIC33CK512MP710 Return Value
512 1788132383538 GEN4_TO_CONTROLLER_LOG:GEN4_CONNECT_INT_LOG_dsPIC33CK512MP710 true
512 1788132383538 GEN4_TO_CONTROLLER_LOG:GEN4_CONNECT_INT_LOG_dsPIC33CK512MP710 Return End

512 1788132383538 GEN4_TO_CONTROLLER_LOG:GEN4_CONNECT_INT_LOG_dsPIC33CK512MP710 Pre:GetFirmwareInfo
512 1788132383538 GEN4_TO_CONTROLLER_LOG:GEN4_CONNECT_INT_LOG_dsPIC33CK512MP710 Payload
512 1788132383538 GEN4_TO_CONTROLLER_LOG:GEN4_CONNECT_INT_LOG_dsPIC33CK512MP710 null
512 1788132383538 GEN4_TO_CONTROLLER_LOG:GEN4_CONNECT_INT_LOG_dsPIC33CK512MP710 Payload End
512 1788132383545 GEN4_TO_CONTROLLER_LOG:GEN4_CONNECT_INT_LOG_dsPIC33CK512MP710 Post:GetFirmwareInfo
512 1788132383545 GEN4_TO_CONTROLLER_LOG:GEN4_CONNECT_INT_LOG_dsPIC33CK512MP710 Return Value
512 1788132383546 GEN4_TO_CONTROLLER_LOG:GEN4_CONNECT_INT_LOG_dsPIC33CK512MP710 FirmwareInfo: Values:
512 1788132383546 GEN4_TO_CONTROLLER_LOG:GEN4_CONNECT_INT_LOG_dsPIC33CK512MP710 FirmwareInfo: boot = false, bootVer = 01.00.00, apVer = 02.05.15, fpgaVer = ff.ff.ff, scriptVer = 00.10.08, macAddress = 0495583578349554857485057485452, devID = a1020e01, devID1 = 2, devSN0 = ffffffff, devSN1 = ffffffff, serialNumber = BUR211672921, appCommitID = null, scriptCommitID = f91823efd7, PCB_ID = 4
512 1788132383546 GEN4_TO_CONTROLLER_LOG:GEN4_CONNECT_INT_LOG_dsPIC33CK512MP710 Return End

512 1788132383546 GEN4_TO_CONTROLLER_LOG:GEN4_CONNECT_INT_LOG_dsPIC33CK512MP710 Pre:GetFirmwareInfo
512 1788132383546 GEN4_TO_CONTROLLER_LOG:GEN4_CONNECT_INT_LOG_dsPIC33CK512MP710 Payload
512 1788132383546 GEN4_TO_CONTROLLER_LOG:GEN4_CONNECT_INT_LOG_dsPIC33CK512MP710 null
512 1788132383546 GEN4_TO_CONTROLLER_LOG:GEN4_CONNECT_INT_LOG_dsPIC33CK512MP710 Payload End
512 1788132383553 GEN4_TO_CONTROLLER_LOG:GEN4_CONNECT_INT_LOG_dsPIC33CK512MP710 Post:GetFirmwareInfo
512 1788132383553 GEN4_TO_CONTROLLER_LOG:GEN4_CONNECT_INT_LOG_dsPIC33CK512MP710 Return Value
512 1788132383553 GEN4_TO_CONTROLLER_LOG:GEN4_CONNECT_INT_LOG_dsPIC33CK512MP710 FirmwareInfo: Values:
512 1788132383553 GEN4_TO_CONTROLLER_LOG:GEN4_CONNECT_INT_LOG_dsPIC33CK512MP710 FirmwareInfo: boot = false, bootVer = 01.00.00, apVer = 02.05.15, fpgaVer = ff.ff.ff, scriptVer = 00.10.08, macAddress = 0495583578349554857485057485452, devID = a1020e01, devID1 = 2, devSN0 = ffffffff, devSN1 = ffffffff, serialNumber = BUR211672921, appCommitID = null, scriptCommitID = f91823efd7, PCB_ID = 4
512 1788132383553 GEN4_TO_CONTROLLER_LOG:GEN4_CONNECT_INT_LOG_dsPIC33CK512MP710 Return End
512 1788132383554 XXXX 1788132383554, Thread 512: XXXX 1788132383554, Entering Thread 512: Commands::runScriptWithUpload with script contents. contents[0] = 0x5e, ...  
512 1788132383554 XXXX 1788132383554, Thread 512: XXXX 1788132383554, Entering Thread 512: ToolCommUsb::readTransfer, sideData is 0xd bytes long, transferDataLength is 0x4 bytes long  
512 1788132383556 XXXX 1788132383556, Thread 512: XXXX 1788132383556, Exiting Thread 512: ToolCommUsb::readTransfer,  cr.status = 0x0  
512 1788132383556 XXXX 1788132383556, Thread 512: XXXX 1788132383556, Exiting Thread 512: Commands::runScriptWithUpload  
512 1788132383556 GEN4_CONNECT_DIAGNOSTICS:ENTERING: com.microchip.mplab.mdbcore.RI4Tool.ConnectionHandler.CheckForFWUpdates()
512 1788132383556 GEN4_CONNECT_DIAGNOSTICS:Created FirmwareUpdateHandler com.microchip.mplab.mdbcore.pk4hybrid.pk4hybridFirmwareUpdateHandler@4d139368
512 1788132383556 GEN4_CONNECT_DIAGNOSTICS:ENTERING: com.microchip.mplab.mdbcore.pk4hybrid.pk4hybridFirmwareUpdateHandler.UpdateFirmware(FirmwareInfo, UpdateMessage)
512 1788132383556 GEN4_CONNECT_DIAGNOSTICS:areWeInBoot returned false
512 1788132383556 GEN4_CONNECT_DIAGNOSTICS:inBoot = false
512 1788132383556 GEN4_CONNECT_DIAGNOSTICS:uMode = done
512 1788132383556 GEN4_CONNECT_DIAGNOSTICS:selectedTool = pk4
512 1788132383556 GEN4_CONNECT_DIAGNOSTICS:current toolType = pk4
512 1788132383556 GEN4_CONNECT_DIAGNOSTICS:current tool mode = pk4
512 1788132383556 GEN4_CONNECT_DIAGNOSTICS:ENTERING: com.microchip.mplab.mdbcore.pk4hybrid.pk4hybridFirmwareUpdateHandler.updatePk4HybridFirmware()
512 1788132383556 GEN4_CONNECT_DIAGNOSTICS:Don't upgrade fimware = false
512 1788132383556 GEN4_CONNECT_DIAGNOSTICS:ENTERING: com.microchip.mplab.mdbcore.pk4hybrid.pk4hybridFirmwareUpdateHandler.updatePk4HybridFirmware()
512 1788132383556 GEN4_CONNECT_DIAGNOSTICS:EXITING: com.microchip.mplab.mdbcore.pk4hybrid.pk4hybridFirmwareUpdateHandler.UpdateFirmware(FirmwareInfo, UpdateMessage)
512 1788132383556 GEN4_CONNECT_DIAGNOSTICS:EXITING: com.microchip.mplab.mdbcore.RI4Tool.ConnectionHandler.CheckForFWUpdates()

512 1788132383556 GEN4_TO_CONTROLLER_LOG:GEN4_CONNECT_INT_LOG_dsPIC33CK512MP710 Pre:SetPowerInfo
512 1788132383556 GEN4_TO_CONTROLLER_LOG:GEN4_CONNECT_INT_LOG_dsPIC33CK512MP710 Payload
512 1788132383556 GEN4_TO_CONTROLLER_LOG:GEN4_CONNECT_INT_LOG_dsPIC33CK512MP710 PowerInfo: Values:
512 1788132383556 GEN4_TO_CONTROLLER_LOG:GEN4_CONNECT_INT_LOG_dsPIC33CK512MP710 PowerInfo: shotDownSystem = false, isToolPower = false, voltage = 3.250000, useVppFirst = false, useLowVoltageProgramming = true, useMaintainActivePower = false
512 1788132383556 GEN4_TO_CONTROLLER_LOG:GEN4_CONNECT_INT_LOG_dsPIC33CK512MP710 Payload End
512 1788132383556 XXXX 1788132383556, Thread 512: XXXX 1788132383556, Entering Thread 512: Commands::runScriptBasic with script contents. contents[0] = 0x39, ...  
512 1788132383558 XXXX 1788132383558, Thread 512: XXXX 1788132383558, Exiting Thread 512: Commands::runScriptBasic  
512 1788132383558 XXXX 1788132383558, Thread 512: XXXX 1788132383558, Entering Thread 512: Commands::runScriptBasic with script contents. contents[0] = 0x46, ...  
512 1788132383563 XXXX 1788132383563, Thread 512: XXXX 1788132383563, Exiting Thread 512: Commands::runScriptBasic  
512 1788132383563 XXXX 1788132383563, Thread 512: XXXX 1788132383563, Entering Thread 512: Commands::runScriptBasic with script contents. contents[0] = 0x44, ...  
512 1788132383575 XXXX 1788132383575, Thread 512: XXXX 1788132383575, Exiting Thread 512: Commands::runScriptBasic  
512 1788132383575 XXXX 1788132383575, Thread 512: XXXX 1788132383575, Entering Thread 512: Commands::runScriptBasic with script contents. contents[0] = 0xef, ...  
512 1788132383586 XXXX 1788132383586, Thread 512: XXXX 1788132383586, Exiting Thread 512: Commands::runScriptBasic  
512 1788132383586 XXXX 1788132383586, Thread 512: XXXX 1788132383586, Entering Thread 512: Commands::runScriptBasic with script contents. contents[0] = 0x40, ...  
512 1788132383984 XXXX 1788132383984, Thread 512: XXXX 1788132383984, Exiting Thread 512: Commands::runScriptBasic  
512 1788132383984 XXXX 1788132383984, Thread 512: XXXX 1788132383984, Entering Thread 512: Commands::runScriptBasic with script contents. contents[0] = 0x47, ...  
512 1788132383989 XXXX 1788132383989, Thread 512: XXXX 1788132383989, Exiting Thread 512: Commands::runScriptBasic  
512 1788132383989 GEN4_TO_CONTROLLER_LOG:GEN4_CONNECT_INT_LOG_dsPIC33CK512MP710 Post:SetPowerInfo
512 1788132383989 GEN4_TO_CONTROLLER_LOG:GEN4_CONNECT_INT_LOG_dsPIC33CK512MP710 Return Value
512 1788132383989 GEN4_TO_CONTROLLER_LOG:GEN4_CONNECT_INT_LOG_dsPIC33CK512MP710 none
512 1788132383989 GEN4_TO_CONTROLLER_LOG:GEN4_CONNECT_INT_LOG_dsPIC33CK512MP710 Return End

512 1788132383989 GEN4_TO_CONTROLLER_LOG:GEN4_CONNECT_INT_LOG_dsPIC33CK512MP710 Pre:GetVoltageInfo
512 1788132383989 GEN4_TO_CONTROLLER_LOG:GEN4_CONNECT_INT_LOG_dsPIC33CK512MP710 Payload
512 1788132383989 GEN4_TO_CONTROLLER_LOG:GEN4_CONNECT_INT_LOG_dsPIC33CK512MP710 null
512 1788132383989 GEN4_TO_CONTROLLER_LOG:GEN4_CONNECT_INT_LOG_dsPIC33CK512MP710 Payload End
512 1788132383989 XXXX 1788132383989, Thread 512: XXXX 1788132383989, Entering Thread 512: Commands::runScriptBasic with script contents. contents[0] = 0x47, ...  
512 1788132383994 XXXX 1788132383994, Thread 512: XXXX 1788132383994, Exiting Thread 512: Commands::runScriptBasic  
512 1788132383994 GEN4_TO_CONTROLLER_LOG:GEN4_CONNECT_INT_LOG_dsPIC33CK512MP710 Post:GetVoltageInfo
512 1788132383994 GEN4_TO_CONTROLLER_LOG:GEN4_CONNECT_INT_LOG_dsPIC33CK512MP710 Return Value
512 1788132383994 GEN4_TO_CONTROLLER_LOG:GEN4_CONNECT_INT_LOG_dsPIC33CK512MP710 VoltagesInfo: Values:
512 1788132383994 GEN4_TO_CONTROLLER_LOG:GEN4_CONNECT_INT_LOG_dsPIC33CK512MP710 VoltagesInfo: internalVdd = 3280, internalVpp = 3092, targetVdd = 3328, targetVpp = 398, vddSense = 0, temp = 25000, vddCurrentSense = 1, vddVoltageSense = 3125
512 1788132383994 GEN4_TO_CONTROLLER_LOG:GEN4_CONNECT_INT_LOG_dsPIC33CK512MP710 Return End

512 1788132383994 GEN4_TO_CONTROLLER_LOG:GEN4_CONNECT_INT_LOG_dsPIC33CK512MP710 Pre:GetFirmwareInfo
512 1788132383994 GEN4_TO_CONTROLLER_LOG:GEN4_CONNECT_INT_LOG_dsPIC33CK512MP710 Payload
512 1788132383994 GEN4_TO_CONTROLLER_LOG:GEN4_CONNECT_INT_LOG_dsPIC33CK512MP710 null
512 1788132383994 GEN4_TO_CONTROLLER_LOG:GEN4_CONNECT_INT_LOG_dsPIC33CK512MP710 Payload End
512 1788132384001 GEN4_TO_CONTROLLER_LOG:GEN4_CONNECT_INT_LOG_dsPIC33CK512MP710 Post:GetFirmwareInfo
512 1788132384001 GEN4_TO_CONTROLLER_LOG:GEN4_CONNECT_INT_LOG_dsPIC33CK512MP710 Return Value
512 1788132384001 GEN4_TO_CONTROLLER_LOG:GEN4_CONNECT_INT_LOG_dsPIC33CK512MP710 FirmwareInfo: Values:
512 1788132384001 GEN4_TO_CONTROLLER_LOG:GEN4_CONNECT_INT_LOG_dsPIC33CK512MP710 FirmwareInfo: boot = false, bootVer = 01.00.00, apVer = 02.05.15, fpgaVer = ff.ff.ff, scriptVer = 00.10.08, macAddress = 0495583578349554857485057485452, devID = a1020e01, devID1 = 2, devSN0 = ffffffff, devSN1 = ffffffff, serialNumber = BUR211672921, appCommitID = null, scriptCommitID = f91823efd7, PCB_ID = 4
512 1788132384001 GEN4_TO_CONTROLLER_LOG:GEN4_CONNECT_INT_LOG_dsPIC33CK512MP710 Return End

512 1788132384001 GEN4_TO_CONTROLLER_LOG:GEN4_CONNECT_INT_LOG_dsPIC33CK512MP710 Pre:SetLEDBrightness
512 1788132384001 GEN4_TO_CONTROLLER_LOG:GEN4_CONNECT_INT_LOG_dsPIC33CK512MP710 Payload
512 1788132384001 GEN4_TO_CONTROLLER_LOG:GEN4_CONNECT_INT_LOG_dsPIC33CK512MP710 5
512 1788132384001 GEN4_TO_CONTROLLER_LOG:GEN4_CONNECT_INT_LOG_dsPIC33CK512MP710 Payload End
512 1788132384001 XXXX 1788132384001, Thread 512: XXXX 1788132384001, Entering Thread 512: Commands::runScriptBasic with script contents. contents[0] = 0xcf, ...  
512 1788132384003 XXXX 1788132384003, Thread 512: XXXX 1788132384003, Exiting Thread 512: Commands::runScriptBasic  
512 1788132384003 GEN4_TO_CONTROLLER_LOG:GEN4_CONNECT_INT_LOG_dsPIC33CK512MP710 Post:SetLEDBrightness
512 1788132384003 GEN4_TO_CONTROLLER_LOG:GEN4_CONNECT_INT_LOG_dsPIC33CK512MP710 Return Value
512 1788132384003 GEN4_TO_CONTROLLER_LOG:GEN4_CONNECT_INT_LOG_dsPIC33CK512MP710 none
512 1788132384003 GEN4_TO_CONTROLLER_LOG:GEN4_CONNECT_INT_LOG_dsPIC33CK512MP710 Return End

512 1788132384003 GEN4_TO_CONTROLLER_LOG:GEN4_CONNECT_INT_LOG_dsPIC33CK512MP710 Pre:SetToolInfo
512 1788132384003 GEN4_TO_CONTROLLER_LOG:GEN4_CONNECT_INT_LOG_dsPIC33CK512MP710 Payload
512 1788132384003 GEN4_TO_CONTROLLER_LOG:GEN4_CONNECT_INT_LOG_dsPIC33CK512MP710 ToolInfo: Values:
512 1788132384003 GEN4_TO_CONTROLLER_LOG:GEN4_CONNECT_INT_LOG_dsPIC33CK512MP710 ToolInfo: speedLevel = 0, PGCResistance = 4700, PGDResistance = 4700, PGCPullDir = None, PGDPullDir = None, ICSPSelected = Wire2
512 1788132384003 GEN4_TO_CONTROLLER_LOG:GEN4_CONNECT_INT_LOG_dsPIC33CK512MP710 Payload End
512 1788132384003 XXXX 1788132384003, Thread 512: XXXX 1788132384003, Entering Thread 512: Commands::runScriptBasic with script contents. contents[0] = 0x27, ...  
512 1788132384004 XXXX 1788132384004, Thread 512: XXXX 1788132384004, Exiting Thread 512: Commands::runScriptBasic  
512 1788132384004 XXXX 1788132384004, Thread 512: XXXX 1788132384004, Entering Thread 512: Commands::runScriptBasic, script name = SetSpeedFromDevice, timeOut = -1 ms  
512 1788132384005 XXXX 1788132384005, Thread 512: XXXX 1788132384005, Exiting Thread 512: Commands::runScriptBasic  
512 1788132384005 XXXX 1788132384005, Thread 512: XXXX 1788132384005, Entering Thread 512: Commands::runScriptBasic with script contents. contents[0] = 0xed, ...  
512 1788132384006 XXXX 1788132384006, Thread 512: XXXX 1788132384006, Exiting Thread 512: Commands::runScriptBasic  
512 1788132384006 XXXX 1788132384006, Thread 512: XXXX 1788132384006, Entering Thread 512: Commands::runScriptBasic with script contents. contents[0] = 0xec, ...  
512 1788132384007 XXXX 1788132384007, Thread 512: XXXX 1788132384007, Exiting Thread 512: Commands::runScriptBasic  
512 1788132384007 XXXX 1788132384007, Thread 512: XXXX 1788132384007, Entering Thread 512: Commands::runScriptBasic with script contents. contents[0] = 0xd4, ...  
512 1788132384008 XXXX 1788132384008, Thread 512: XXXX 1788132384008, Exiting Thread 512: Commands::runScriptBasic  
512 1788132384008 GEN4_TO_CONTROLLER_LOG:GEN4_CONNECT_INT_LOG_dsPIC33CK512MP710 Post:SetToolInfo
512 1788132384008 GEN4_TO_CONTROLLER_LOG:GEN4_CONNECT_INT_LOG_dsPIC33CK512MP710 Return Value
512 1788132384008 GEN4_TO_CONTROLLER_LOG:GEN4_CONNECT_INT_LOG_dsPIC33CK512MP710 none
512 1788132384008 GEN4_TO_CONTROLLER_LOG:GEN4_CONNECT_INT_LOG_dsPIC33CK512MP710 Return End

512 1788132384008 GEN4_TO_CONTROLLER_LOG:GEN4_CONNECT_INT_LOG_dsPIC33CK512MP710 Pre:GetTargetIDInfo
512 1788132384008 GEN4_TO_CONTROLLER_LOG:GEN4_CONNECT_INT_LOG_dsPIC33CK512MP710 Payload
512 1788132384008 GEN4_TO_CONTROLLER_LOG:GEN4_CONNECT_INT_LOG_dsPIC33CK512MP710 null
512 1788132384008 GEN4_TO_CONTROLLER_LOG:GEN4_CONNECT_INT_LOG_dsPIC33CK512MP710 Payload End
512 1788132384011 XXXX 1788132384011, Thread 512: XXXX 1788132384011, Entering Thread 512: Commands::runScriptBasic, script name = SetSpeedFromDevice, timeOut = -1 ms  
512 1788132384012 XXXX 1788132384012, Thread 512: XXXX 1788132384012, Exiting Thread 512: Commands::runScriptBasic  
512 1788132384012 XXXX 1788132384012, Thread 512: XXXX 1788132384012, Entering Thread 512: Commands::runScriptBasic with script contents. contents[0] = 0xed, ...  
512 1788132384013 XXXX 1788132384013, Thread 512: XXXX 1788132384013, Exiting Thread 512: Commands::runScriptBasic  
512 1788132384013 XXXX 1788132384013, Thread 512: XXXX 1788132384013, Entering Thread 512: Commands::runScriptBasic with script contents. contents[0] = 0xec, ...  
512 1788132384014 XXXX 1788132384014, Thread 512: XXXX 1788132384014, Exiting Thread 512: Commands::runScriptBasic  
512 1788132384014 XXXX 1788132384014, Thread 512: XXXX 1788132384014, Entering Thread 512: Commands::runScriptBasic, script name = EnterTMOD_LV, timeOut = -1 ms  
512 1788132384042 XXXX 1788132384042, Thread 512: XXXX 1788132384042, Exiting Thread 512: Commands::runScriptBasic  
512 1788132384042 XXXX 1788132384042, Thread 512: XXXX 1788132384042, Entering Thread 512: Commands::runScriptBasic, script name = GetDeviceID, timeOut = -1 ms  
512 1788132384043 XXXX 1788132384043, Thread 512: XXXX 1788132384043, Exiting Thread 512: Commands::runScriptBasic  
512 1788132384043 GEN4_TO_CONTROLLER_LOG:GEN4_CONNECT_INT_LOG_dsPIC33CK512MP710 Post:GetTargetIDInfo
512 1788132384043 GEN4_TO_CONTROLLER_LOG:GEN4_CONNECT_INT_LOG_dsPIC33CK512MP710 Return Value
512 1788132384043 GEN4_TO_CONTROLLER_LOG:GEN4_CONNECT_INT_LOG_dsPIC33CK512MP710 TargetIDInfo: Values:
512 1788132384043 GEN4_TO_CONTROLLER_LOG:GEN4_CONNECT_INT_LOG_dsPIC33CK512MP710 TargetIDInfo: DeviceID = 00000000
512 1788132384043 GEN4_TO_CONTROLLER_LOG:GEN4_CONNECT_INT_LOG_dsPIC33CK512MP710 Return End

512 1788132546307 GEN4_TO_CONTROLLER_LOG:GEN4_PROGRAM_INT_LOG_dsPIC33CK512MP710 Pre:SendOperation
512 1788132546307 GEN4_TO_CONTROLLER_LOG:GEN4_PROGRAM_INT_LOG_dsPIC33CK512MP710 Payload
512 1788132546307 GEN4_TO_CONTROLLER_LOG:GEN4_PROGRAM_INT_LOG_dsPIC33CK512MP710 OperationInfo: Values:
512 1788132546307 GEN4_TO_CONTROLLER_LOG:GEN4_PROGRAM_INT_LOG_dsPIC33CK512MP710 OperationInfo: Type = read, Mask = 00000000, Erase = false, Production Mode = true
512 1788132546307 GEN4_TO_CONTROLLER_LOG:GEN4_PROGRAM_INT_LOG_dsPIC33CK512MP710 TransferInfo: Start = 801000, End = 8017ff, Buffer Length = 4096, Type = Test, Mask = 00000000
512 1788132546307 GEN4_TO_CONTROLLER_LOG:GEN4_PROGRAM_INT_LOG_dsPIC33CK512MP710 Payload End
512 1788132546307 XXXX 1788132546307, Thread 512: XXXX 1788132546307, Entering Thread 512: Commands::runScriptBasic, script name = EraseTestmemRange, timeOut = 30000 ms  
512 1788132546362 XXXX 1788132546362, Thread 512: XXXX 1788132546362, Exiting Thread 512: Commands::runScriptBasic  
512 1788132546362 XXXX 1788132546362, Thread 512: XXXX 1788132546362, Entering Thread 512: Commands::runScriptWithDownload, script name = WriteProgmem  
512 1788132548729 XXXX 1788132548729, Thread 512: XXXX 1788132548729, Exiting Thread 512: Commands::runScriptWithDownload(WriteProgmem)  
512 1788132548729 XXXX 1788132548729, Thread 512: XXXX 1788132548729, Entering Thread 512: Commands::runScriptWithUpload, script name = ReadProgmem  
512 1788132548729 XXXX 1788132548729, Thread 512: XXXX 1788132548729, Entering Thread 512: ToolCommUsb::readTransfer, sideData is 0xb1 bytes long, transferDataLength is 0x1800 bytes long  
512 1788132550617 XXXX 1788132550617, Thread 512: XXXX 1788132550617, Exiting Thread 512: ToolCommUsb::readTransfer,  cr.status = 0x0  
512 1788132550617 XXXX 1788132550617, Thread 512: XXXX 1788132550617, Exiting Thread 512: Commands::runScriptWithUpload  
512 1788132550617 XXXX 1788132550617, Thread 512: XXXX 1788132550617, Entering Thread 512: Commands::runScriptBasic, script name = ExitTMOD, timeOut = -1 ms  
512 1788132550619 XXXX 1788132550619, Thread 512: XXXX 1788132550619, Exiting Thread 512: Commands::runScriptBasic  
512 1788132550619 XXXX 1788132550619, Thread 512: XXXX 1788132550619, Entering Thread 512: Commands::runScriptBasic, script name = ExitTMOD, timeOut = -1 ms  
512 1788132550621 XXXX 1788132550621, Thread 512: XXXX 1788132550621, Exiting Thread 512: Commands::runScriptBasic  
512 1788132550621 XXXX 1788132550621, Thread 512: XXXX 1788132550621, Entering Thread 512: Commands::runScriptBasic, script name = SetSpeedFromDevice, timeOut = -1 ms  
512 1788132550622 XXXX 1788132550622, Thread 512: XXXX 1788132550622, Exiting Thread 512: Commands::runScriptBasic  
512 1788132550622 XXXX 1788132550622, Thread 512: XXXX 1788132550622, Entering Thread 512: Commands::runScriptBasic with script contents. contents[0] = 0xed, ...  
512 1788132550623 XXXX 1788132550623, Thread 512: XXXX 1788132550623, Exiting Thread 512: Commands::runScriptBasic  
512 1788132550623 XXXX 1788132550623, Thread 512: XXXX 1788132550623, Entering Thread 512: Commands::runScriptBasic with script contents. contents[0] = 0xec, ...  
512 1788132550624 XXXX 1788132550624, Thread 512: XXXX 1788132550624, Exiting Thread 512: Commands::runScriptBasic  
512 1788132550624 XXXX 1788132550624, Thread 512: XXXX 1788132550624, Entering Thread 512: Commands::runScriptBasic, script name = EnterTMOD_LV, timeOut = -1 ms  
512 1788132550652 XXXX 1788132550651, Thread 512: XXXX 1788132550651, Exiting Thread 512: Commands::runScriptBasic  
512 1788132550652 XXXX 1788132550652, Thread 512: XXXX 1788132550652, Entering Thread 512: Commands::runScriptWithUpload, script name = ReadProgmem  
512 1788132550652 XXXX 1788132550652, Thread 512: XXXX 1788132550652, Entering Thread 512: ToolCommUsb::readTransfer, sideData is 0xb1 bytes long, transferDataLength is 0xc00 bytes long  
512 1788132551598 XXXX 1788132551598, Thread 512: XXXX 1788132551598, Exiting Thread 512: ToolCommUsb::readTransfer,  cr.status = 0x0  
512 1788132551598 XXXX 1788132551598, Thread 512: XXXX 1788132551598, Exiting Thread 512: Commands::runScriptWithUpload  
512 1788132551598 GEN4_TO_CONTROLLER_LOG:GEN4_PROGRAM_INT_LOG_dsPIC33CK512MP710 Post:SendOperation
512 1788132551598 GEN4_TO_CONTROLLER_LOG:GEN4_PROGRAM_INT_LOG_dsPIC33CK512MP710 Return Value
512 1788132551598 GEN4_TO_CONTROLLER_LOG:GEN4_PROGRAM_INT_LOG_dsPIC33CK512MP710 None
512 1788132551598 GEN4_TO_CONTROLLER_LOG:GEN4_PROGRAM_INT_LOG_dsPIC33CK512MP710 Return End

512 1788132551598 GEN4_TO_CONTROLLER_LOG:GEN4_PROGRAM_INT_LOG_dsPIC33CK512MP710 Pre:SendOperation
512 1788132551598 GEN4_TO_CONTROLLER_LOG:GEN4_PROGRAM_INT_LOG_dsPIC33CK512MP710 Payload
512 1788132551598 GEN4_TO_CONTROLLER_LOG:GEN4_PROGRAM_INT_LOG_dsPIC33CK512MP710 OperationInfo: Values:
512 1788132551598 GEN4_TO_CONTROLLER_LOG:GEN4_PROGRAM_INT_LOG_dsPIC33CK512MP710 OperationInfo: Type = read, Mask = 00000000, Erase = false, Production Mode = true
512 1788132551598 GEN4_TO_CONTROLLER_LOG:GEN4_PROGRAM_INT_LOG_dsPIC33CK512MP710 TransferInfo: Start = 801200, End = 801209, Buffer Length = 20, Type = UDID, Mask = 00000000
512 1788132551598 GEN4_TO_CONTROLLER_LOG:GEN4_PROGRAM_INT_LOG_dsPIC33CK512MP710 Payload End
512 1788132551598 XXXX 1788132551598, Thread 512: XXXX 1788132551598, Entering Thread 512: Commands::runScriptWithUpload, script name = ReadProgmem  
512 1788132551598 XXXX 1788132551598, Thread 512: XXXX 1788132551598, Entering Thread 512: ToolCommUsb::readTransfer, sideData is 0xb1 bytes long, transferDataLength is 0x18 bytes long  
512 1788132551607 XXXX 1788132551607, Thread 512: XXXX 1788132551607, Exiting Thread 512: ToolCommUsb::readTransfer,  cr.status = 0x0  
512 1788132551607 XXXX 1788132551607, Thread 512: XXXX 1788132551607, Exiting Thread 512: Commands::runScriptWithUpload  
512 1788132551608 GEN4_TO_CONTROLLER_LOG:GEN4_PROGRAM_INT_LOG_dsPIC33CK512MP710 Post:SendOperation
512 1788132551608 GEN4_TO_CONTROLLER_LOG:GEN4_PROGRAM_INT_LOG_dsPIC33CK512MP710 Return Value
512 1788132551608 GEN4_TO_CONTROLLER_LOG:GEN4_PROGRAM_INT_LOG_dsPIC33CK512MP710 None
512 1788132551608 GEN4_TO_CONTROLLER_LOG:GEN4_PROGRAM_INT_LOG_dsPIC33CK512MP710 Return End

512 1788132551615 GEN4_TO_CONTROLLER_LOG:GEN4_PROGRAM_INT_LOG_dsPIC33CK512MP710 Pre:SendOperation
512 1788132551615 GEN4_TO_CONTROLLER_LOG:GEN4_PROGRAM_INT_LOG_dsPIC33CK512MP710 Payload
512 1788132551615 GEN4_TO_CONTROLLER_LOG:GEN4_PROGRAM_INT_LOG_dsPIC33CK512MP710 OperationInfo: Values:
512 1788132551615 GEN4_TO_CONTROLLER_LOG:GEN4_PROGRAM_INT_LOG_dsPIC33CK512MP710 OperationInfo: Type = read, Mask = 00000000, Erase = false, Production Mode = true
512 1788132551615 GEN4_TO_CONTROLLER_LOG:GEN4_PROGRAM_INT_LOG_dsPIC33CK512MP710 TransferInfo: Start = 57800, End = 57fff, Buffer Length = 4096, Type = Pgm, Mask = 00000001
512 1788132551615 GEN4_TO_CONTROLLER_LOG:GEN4_PROGRAM_INT_LOG_dsPIC33CK512MP710 Payload End
512 1788132551615 XXXX 1788132551615, Thread 512: XXXX 1788132551615, Entering Thread 512: Commands::runScriptWithUpload, script name = ReadProgmem  
512 1788132551615 XXXX 1788132551615, Thread 512: XXXX 1788132551615, Entering Thread 512: ToolCommUsb::readTransfer, sideData is 0xb1 bytes long, transferDataLength is 0xc00 bytes long  
512 1788132552559 XXXX 1788132552559, Thread 512: XXXX 1788132552559, Exiting Thread 512: ToolCommUsb::readTransfer,  cr.status = 0x0  
512 1788132552559 XXXX 1788132552559, Thread 512: XXXX 1788132552559, Exiting Thread 512: Commands::runScriptWithUpload  
512 1788132552559 GEN4_TO_CONTROLLER_LOG:GEN4_PROGRAM_INT_LOG_dsPIC33CK512MP710 Post:SendOperation
512 1788132552559 GEN4_TO_CONTROLLER_LOG:GEN4_PROGRAM_INT_LOG_dsPIC33CK512MP710 Return Value
512 1788132552559 GEN4_TO_CONTROLLER_LOG:GEN4_PROGRAM_INT_LOG_dsPIC33CK512MP710 None
512 1788132552559 GEN4_TO_CONTROLLER_LOG:GEN4_PROGRAM_INT_LOG_dsPIC33CK512MP710 Return End

512 1788132552559 GEN4_TO_CONTROLLER_LOG:GEN4_PROGRAM_INT_LOG_dsPIC33CK512MP710 Pre:SendOperation
512 1788132552559 GEN4_TO_CONTROLLER_LOG:GEN4_PROGRAM_INT_LOG_dsPIC33CK512MP710 Payload
512 1788132552559 GEN4_TO_CONTROLLER_LOG:GEN4_PROGRAM_INT_LOG_dsPIC33CK512MP710 OperationInfo: Values:
512 1788132552559 GEN4_TO_CONTROLLER_LOG:GEN4_PROGRAM_INT_LOG_dsPIC33CK512MP710 OperationInfo: Type = read, Mask = 00000000, Erase = false, Production Mode = true
512 1788132552559 GEN4_TO_CONTROLLER_LOG:GEN4_PROGRAM_INT_LOG_dsPIC33CK512MP710 TransferInfo: Start = 57800, End = 57fff, Buffer Length = 4096, Type = Pgm, Mask = 00000001
512 1788132552559 GEN4_TO_CONTROLLER_LOG:GEN4_PROGRAM_INT_LOG_dsPIC33CK512MP710 Payload End
512 1788132552559 XXXX 1788132552559, Thread 512: XXXX 1788132552559, Entering Thread 512: Commands::runScriptWithUpload, script name = ReadProgmem  
512 1788132552559 XXXX 1788132552559, Thread 512: XXXX 1788132552559, Entering Thread 512: ToolCommUsb::readTransfer, sideData is 0xb1 bytes long, transferDataLength is 0xc00 bytes long  
512 1788132553504 XXXX 1788132553504, Thread 512: XXXX 1788132553504, Exiting Thread 512: ToolCommUsb::readTransfer,  cr.status = 0x0  
512 1788132553504 XXXX 1788132553504, Thread 512: XXXX 1788132553504, Exiting Thread 512: Commands::runScriptWithUpload  
512 1788132553504 GEN4_TO_CONTROLLER_LOG:GEN4_PROGRAM_INT_LOG_dsPIC33CK512MP710 Post:SendOperation
512 1788132553504 GEN4_TO_CONTROLLER_LOG:GEN4_PROGRAM_INT_LOG_dsPIC33CK512MP710 Return Value
512 1788132553504 GEN4_TO_CONTROLLER_LOG:GEN4_PROGRAM_INT_LOG_dsPIC33CK512MP710 None
512 1788132553504 GEN4_TO_CONTROLLER_LOG:GEN4_PROGRAM_INT_LOG_dsPIC33CK512MP710 Return End

512 1788132553505 GEN4_TO_CONTROLLER_LOG:GEN4_PROGRAM_INT_LOG_dsPIC33CK512MP710 Pre:SendOperation
512 1788132553505 GEN4_TO_CONTROLLER_LOG:GEN4_PROGRAM_INT_LOG_dsPIC33CK512MP710 Payload
512 1788132553505 GEN4_TO_CONTROLLER_LOG:GEN4_PROGRAM_INT_LOG_dsPIC33CK512MP710 OperationInfo: Values:
512 1788132553505 GEN4_TO_CONTROLLER_LOG:GEN4_PROGRAM_INT_LOG_dsPIC33CK512MP710 OperationInfo: Type = erase, Mask = 00000000, Erase = false, Production Mode = true
512 1788132553505 GEN4_TO_CONTROLLER_LOG:GEN4_PROGRAM_INT_LOG_dsPIC33CK512MP710 TransferInfo: Start = 0, End = 57eff, Buffer Length = 0, Type = Pgm, Mask = 00000000
512 1788132553505 GEN4_TO_CONTROLLER_LOG:GEN4_PROGRAM_INT_LOG_dsPIC33CK512MP710 TransferInfo: Start = 57f00, End = 57fff, Buffer Length = 0, Type = Cfg, Mask = 00000000
512 1788132553505 GEN4_TO_CONTROLLER_LOG:GEN4_PROGRAM_INT_LOG_dsPIC33CK512MP710 TransferInfo: Start = 801800, End = 801801, Buffer Length = 0, Type = FBoot, Mask = 00000000
512 1788132553505 GEN4_TO_CONTROLLER_LOG:GEN4_PROGRAM_INT_LOG_dsPIC33CK512MP710 Payload End
512 1788132553505 XXXX 1788132553505, Thread 512: XXXX 1788132553505, Entering Thread 512: Commands::runScriptBasic, script name = EraseChip, timeOut = 30000 ms  
512 1788132553757 XXXX 1788132553757, Thread 512: XXXX 1788132553757, Exiting Thread 512: Commands::runScriptBasic  
512 1788132553757 XXXX 1788132553757, Thread 512: XXXX 1788132553757, Entering Thread 512: Commands::runScriptBasic, script name = ExitTMOD, timeOut = -1 ms  
512 1788132553759 XXXX 1788132553759, Thread 512: XXXX 1788132553759, Exiting Thread 512: Commands::runScriptBasic  
512 1788132553759 GEN4_TO_CONTROLLER_LOG:GEN4_PROGRAM_INT_LOG_dsPIC33CK512MP710 Post:SendOperation
512 1788132553759 GEN4_TO_CONTROLLER_LOG:GEN4_PROGRAM_INT_LOG_dsPIC33CK512MP710 Return Value
512 1788132553759 GEN4_TO_CONTROLLER_LOG:GEN4_PROGRAM_INT_LOG_dsPIC33CK512MP710 None
512 1788132553759 GEN4_TO_CONTROLLER_LOG:GEN4_PROGRAM_INT_LOG_dsPIC33CK512MP710 Return End

512 1788132553761 GEN4_TO_CONTROLLER_LOG:GEN4_PROGRAM_INT_LOG_dsPIC33CK512MP710 Pre:SendOperation
512 1788132553761 GEN4_TO_CONTROLLER_LOG:GEN4_PROGRAM_INT_LOG_dsPIC33CK512MP710 Payload
512 1788132553761 GEN4_TO_CONTROLLER_LOG:GEN4_PROGRAM_INT_LOG_dsPIC33CK512MP710 OperationInfo: Values:
512 1788132553761 GEN4_TO_CONTROLLER_LOG:GEN4_PROGRAM_INT_LOG_dsPIC33CK512MP710 OperationInfo: Type = read, Mask = 00000000, Erase = false, Production Mode = true
512 1788132553761 GEN4_TO_CONTROLLER_LOG:GEN4_PROGRAM_INT_LOG_dsPIC33CK512MP710 TransferInfo: Start = 57800, End = 57fff, Buffer Length = 4096, Type = Pgm, Mask = 00000001
512 1788132553761 GEN4_TO_CONTROLLER_LOG:GEN4_PROGRAM_INT_LOG_dsPIC33CK512MP710 Payload End
512 1788132553761 XXXX 1788132553761, Thread 512: XXXX 1788132553761, Entering Thread 512: Commands::runScriptBasic, script name = SetSpeedFromDevice, timeOut = -1 ms  
512 1788132553762 XXXX 1788132553762, Thread 512: XXXX 1788132553762, Exiting Thread 512: Commands::runScriptBasic  
512 1788132553762 XXXX 1788132553762, Thread 512: XXXX 1788132553762, Entering Thread 512: Commands::runScriptBasic with script contents. contents[0] = 0xed, ...  
512 1788132553763 XXXX 1788132553763, Thread 512: XXXX 1788132553763, Exiting Thread 512: Commands::runScriptBasic  
512 1788132553763 XXXX 1788132553763, Thread 512: XXXX 1788132553763, Entering Thread 512: Commands::runScriptBasic with script contents. contents[0] = 0xec, ...  
512 1788132553764 XXXX 1788132553764, Thread 512: XXXX 1788132553764, Exiting Thread 512: Commands::runScriptBasic  
512 1788132553764 XXXX 1788132553764, Thread 512: XXXX 1788132553764, Entering Thread 512: Commands::runScriptBasic, script name = EnterTMOD_LV, timeOut = -1 ms  
512 1788132553792 XXXX 1788132553792, Thread 512: XXXX 1788132553792, Exiting Thread 512: Commands::runScriptBasic  
512 1788132553792 XXXX 1788132553792, Thread 512: XXXX 1788132553792, Entering Thread 512: Commands::runScriptWithUpload, script name = ReadProgmem  
512 1788132553792 XXXX 1788132553792, Thread 512: XXXX 1788132553792, Entering Thread 512: ToolCommUsb::readTransfer, sideData is 0xb1 bytes long, transferDataLength is 0xc00 bytes long  
512 1788132554737 XXXX 1788132554737, Thread 512: XXXX 1788132554737, Exiting Thread 512: ToolCommUsb::readTransfer,  cr.status = 0x0  
512 1788132554738 XXXX 1788132554738, Thread 512: XXXX 1788132554738, Exiting Thread 512: Commands::runScriptWithUpload  
512 1788132554738 GEN4_TO_CONTROLLER_LOG:GEN4_PROGRAM_INT_LOG_dsPIC33CK512MP710 Post:SendOperation
512 1788132554738 GEN4_TO_CONTROLLER_LOG:GEN4_PROGRAM_INT_LOG_dsPIC33CK512MP710 Return Value
512 1788132554738 GEN4_TO_CONTROLLER_LOG:GEN4_PROGRAM_INT_LOG_dsPIC33CK512MP710 None
512 1788132554738 GEN4_TO_CONTROLLER_LOG:GEN4_PROGRAM_INT_LOG_dsPIC33CK512MP710 Return End

512 1788132554738 GEN4_TO_CONTROLLER_LOG:GEN4_PROGRAM_INT_LOG_dsPIC33CK512MP710 Pre:SendOperation
512 1788132554738 GEN4_TO_CONTROLLER_LOG:GEN4_PROGRAM_INT_LOG_dsPIC33CK512MP710 Payload
512 1788132554738 GEN4_TO_CONTROLLER_LOG:GEN4_PROGRAM_INT_LOG_dsPIC33CK512MP710 OperationInfo: Values:
512 1788132554738 GEN4_TO_CONTROLLER_LOG:GEN4_PROGRAM_INT_LOG_dsPIC33CK512MP710 OperationInfo: Type = write, Mask = 00000000, Erase = false, Production Mode = true
512 1788132554738 GEN4_TO_CONTROLLER_LOG:GEN4_PROGRAM_INT_LOG_dsPIC33CK512MP710 TransferInfo: Start = 0, End = 27ff, Buffer Length = 20480, Type = Pgm, Mask = 00000000
512 1788132554738 GEN4_TO_CONTROLLER_LOG:GEN4_PROGRAM_INT_LOG_dsPIC33CK512MP710 TransferInfo: Start = 57800, End = 57fff, Buffer Length = 4096, Type = Pgm, Mask = 00000001
512 1788132554738 GEN4_TO_CONTROLLER_LOG:GEN4_PROGRAM_INT_LOG_dsPIC33CK512MP710 Payload End
512 1788132554738 XXXX 1788132554738, Thread 512: XXXX 1788132554738, Entering Thread 512: Commands::runScriptBasic, script name = EraseTestmemRange, timeOut = 30000 ms  
512 1788132554792 XXXX 1788132554792, Thread 512: XXXX 1788132554792, Exiting Thread 512: Commands::runScriptBasic  
512 1788132554792 XXXX 1788132554792, Thread 512: XXXX 1788132554792, Entering Thread 512: Commands::runScriptWithDownload, script name = WriteProgmem  
512 1788132557159 XXXX 1788132557159, Thread 512: XXXX 1788132557159, Exiting Thread 512: Commands::runScriptWithDownload(WriteProgmem)  
512 1788132557159 XXXX 1788132557159, Thread 512: XXXX 1788132557159, Entering Thread 512: Commands::runScriptWithUpload, script name = ReadProgmem  
512 1788132557159 XXXX 1788132557159, Thread 512: XXXX 1788132557159, Entering Thread 512: ToolCommUsb::readTransfer, sideData is 0xb1 bytes long, transferDataLength is 0x1800 bytes long  
512 1788132559047 XXXX 1788132559047, Thread 512: XXXX 1788132559047, Exiting Thread 512: ToolCommUsb::readTransfer,  cr.status = 0x0  
512 1788132559047 XXXX 1788132559047, Thread 512: XXXX 1788132559047, Exiting Thread 512: Commands::runScriptWithUpload  
512 1788132559047 XXXX 1788132559047, Thread 512: XXXX 1788132559047, Entering Thread 512: Commands::runScriptBasic, script name = ExitTMOD, timeOut = -1 ms  
512 1788132559056 XXXX 1788132559056, Thread 512: XXXX 1788132559056, Exiting Thread 512: Commands::runScriptBasic  
512 1788132559056 XXXX 1788132559056, Thread 512: XXXX 1788132559056, Entering Thread 512: Commands::runScriptBasic, script name = ExitTMOD, timeOut = -1 ms  
512 1788132559058 XXXX 1788132559058, Thread 512: XXXX 1788132559058, Exiting Thread 512: Commands::runScriptBasic  
512 1788132559058 XXXX 1788132559058, Thread 512: XXXX 1788132559058, Entering Thread 512: Commands::runScriptBasic, script name = SetSpeedFromDevice, timeOut = -1 ms  
512 1788132559059 XXXX 1788132559059, Thread 512: XXXX 1788132559059, Exiting Thread 512: Commands::runScriptBasic  
512 1788132559059 XXXX 1788132559059, Thread 512: XXXX 1788132559059, Entering Thread 512: Commands::runScriptBasic with script contents. contents[0] = 0xed, ...  
512 1788132559060 XXXX 1788132559060, Thread 512: XXXX 1788132559060, Exiting Thread 512: Commands::runScriptBasic  
512 1788132559060 XXXX 1788132559060, Thread 512: XXXX 1788132559060, Entering Thread 512: Commands::runScriptBasic with script contents. contents[0] = 0xec, ...  
512 1788132559061 XXXX 1788132559061, Thread 512: XXXX 1788132559061, Exiting Thread 512: Commands::runScriptBasic  
512 1788132559061 XXXX 1788132559061, Thread 512: XXXX 1788132559061, Entering Thread 512: Commands::runScriptBasic, script name = EnterTMOD_LV, timeOut = -1 ms  
512 1788132559088 XXXX 1788132559088, Thread 512: XXXX 1788132559088, Exiting Thread 512: Commands::runScriptBasic  
512 1788132559088 XXXX 1788132559088, Thread 512: XXXX 1788132559088, Entering Thread 512: Commands::runScriptWithDownload, script name = WriteProgmem  
512 1788132565007 XXXX 1788132565007, Thread 512: XXXX 1788132565007, Exiting Thread 512: Commands::runScriptWithDownload(WriteProgmem)  
512 1788132565007 XXXX 1788132565007, Thread 512: XXXX 1788132565007, Entering Thread 512: Commands::runScriptBasic, script name = EraseTestmemRange, timeOut = 30000 ms  
512 1788132565061 XXXX 1788132565061, Thread 512: XXXX 1788132565061, Exiting Thread 512: Commands::runScriptBasic  
512 1788132565061 XXXX 1788132565061, Thread 512: XXXX 1788132565061, Entering Thread 512: Commands::runScriptWithDownload, script name = WriteProgmem  
512 1788132567076 XXXX 1788132567076, Thread 512: ToolCommUsb::read, com.Received returned -1 
512 1788132567076 XXXX 1788132567076, Thread 512: writeTransfer: exception after sendScriptDone null 
512 1788132567076 XXXX 1788132567076, Thread 512: XXXX 1788132567076, Entering Thread 512: ToolCommUsb::recoverFromProtocolError, type = NO_SCRIPT  
512 1788132567076 XXXX 1788132567076, Thread 512: Send Abort Script Engine Command 
512 1788132567076 XXXX 1788132567076, Thread 512: XXXX 1788132567076, Entering Thread 512: ToolCommUsb::killScriptEngine  
512 1788132567077 XXXX 1788132567077, Thread 512: com.Send returned false 
512 1788132567077 XXXX 1788132567077, Thread 512: Failed sending Abort Script Engine Command. Set nuclear option = true 
512 1788132567077 XXXX 1788132567077, Thread 512: About to nuke 
512 1788132567077 XXXX 1788132567077, Thread 512: XXXX 1788132567077, Entering Thread 512: ToolCommUsb::nuclearOption  
512 1788132567079 XXXX 1788132567079, Thread 512: com.Send returned false
