seokipo/H2_Control_Board/(list of files, drawings)

Other design files:
01_Hardware/1990083.PcbLib
01_Hardware/Copy of Output_Section.SchDoc
01_Hardware/Docs/PCB부품/1818025/Altium/1818025.PcbLib
01_Hardware/Docs/PCB부품/1818025/Altium/1818025.SchLib
01_Hardware/Docs/PCB부품/1818216/1818216.SchLib
01_Hardware/Docs/PCB부품/1818216/PHOENIX_1818216.PcbLib
01_Hardware/Docs/PCB부품/185464862-122-1751581/1751581/Altium/1751581.PcbLib
01_Hardware/Docs/PCB부품/185464862-122-1751581/1751581/Altium/1751581.SchLib
01_Hardware/Ethernet.SchDoc
01_Hardware/FuelCell.PrjPcb
01_Hardware/Input_Section.SchDoc
01_Hardware/KipoAlt.SchLib
01_Hardware/Mcu.SchDoc
01_Hardware/Modbus.SchDoc
01_Hardware/Output_Section.SchDoc
01_Hardware/Power.SchDoc
01_Hardware/TempController.SchDoc
06_Docs/장비n부품/1818339/Altium/1818339.PcbLib
06_Docs/장비n부품/1818339/Altium/1818339.SchLib
AioJig/AiJig.SchDoc
AioJig/AioJig.PcbDoc
AioJig/AioJig.PrjPcb
H2_Sensor/H2_Sensor.PrjPcb
H2Sensor/H2Sensor.PcbDoc
H2Sensor/H2Sensor.PrjPcb
H2Sensor/PCB1.PcbDoc
