seokipo/H2_Control_Board/(commit log)

2026-08-14 feat: initial commit with pure Altium SCH, PCB, dsPIC firmware and SCADA engine
    [0812 견적및 발주.xlsx, 1751581.PcbLib, 1751581.SchLib, 1751581.psm, 1818025.PcbLib, 1818025.SchLib, 1818025.psm, 1818216.SchLib]
2026-08-22 feat: Electron 데스크톱 관제 앱 환경 구축, 20ch DO 제어 스택 및 의존성 지도/용어사전 갱신
    [AiJig.SchDoc, AioJig.PrjPcb, Ethernet.SchDoc, FuelCell.PrjPcb, H2Sensor.PcbDoc, H2Sensor.PrjPcb, H2_Sensor.sch, Input_Section.SchDoc]
2026-08-22 feat(hardware): Altium 통합 심볼 라이브러리(KipoAlt.SchLib) 및 PCB 풋프린트 라이브러리(KipoAlt.PcbLib) 백업 추가
    [KipoAlt.SchLib]
2026-09-04 feat: RS-422 물리 통신 개통 및 제어 반응성 극대화, 열전대 1-Shot 동기화 완결
    - RS-422 19200bps 양방향 통신 완전 개통 (71번 RF13 언롤 송신 & 70번 RE10 정밀 수신)
    - 다중 웹소켓 포트 경합 해소: 싱글톤 1:1 핑퐁 브릿지(serial_bridge.py) 및 브로드캐스트 도입
    - 릴레이/밸브(DO) 제어 반응성 극대화: 60ms 중복 재전송 및 이중 카운트 버그 박멸
    - 열전대(MAX31856) TC_IsConversionDone(143ms) 하드웨어 완료 동기화 계측으로 이상치 박멸
    - 칩 내부 상온(CJC) 기반 미결선 빈 채널 스마트 가로바(--) 필터링 및 상단 배지 구현
    - 개발일지(DEVELOPMENT_LOG.md) 243~246번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
    [1818339.PcbLib, 1818339.SchLib, 260727_10kW IO 넘버링 Ver 1.1 이규원_ 모델명 포함(수정).xlsx, 260727_6kW IO 넘버링 Ver 1.1_이규원_모델명포함(수정).xlsx, AiJig.SchDoc, AioJig.PcbDoc, AioJig.PrjPcb, Ethernet.SchDoc]
2026-09-04 Feature(SCADA): Implement Target-State Guaranteed Smart Retry Engine for DO relays
2026-09-05 feat: DAC60516 아날로그 출력 복원, ADS1115 16ch 제로 블로킹 I2C 드라이버 구축 및 RS-422 연쇄 타임아웃 방지 위상 재동기화 최적화 (2026-09-05)
2026-09-21 fix(firmware,ui): MUX3 핀맵(RD12) 및 CH18/19 주소 정정, CH32 복원 및 CJC 레지스터 분리
    - [Firmware] TC_EN3 핀 정의를 RC3에서 RD12(dsPIC33CK 35번 핀)로 정정하여 MUX 3 상시 ON에 의한 CH23/CH17 버스 쇼트 해소
    - [Firmware] CH18(S7->주소 6), CH19(S5->주소 4) MUX 주소 오기재 정정
    - [Firmware] thermocouple 스캔 루프 % 32 확장으로 CH32 복원 및 CJC 레지스터 48번으로 이관
    - [UI] 03_Control_UI/index.html 32채널 전체 수신 및 CJC 48번 분리 수신 반영
    - [UI] 백그라운드 Python 브릿지 무창 구동(VBScript) 및 관제 창 종료 시 자동 종료(Auto-Shutdown) 연동
    - [Docs] DEVELOPMENT_LOG 및 PROGRAMMING_TERMS (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
    [dac60516.c, dac60516.h, main.c, modbus.c, modbus.h, pid.h, pin_map.h]
2026-09-21 docs: 용어사전에 626번 GitLens Inspect 및 Commit Graph 등재
2026-09-21 docs: 용어사전에 627번 써모커플 주요 타입별 물리적 특성 및 계측 규격 등재
2026-09-21 feat(ethernet): W5500 Modbus TCP 통신 스택 탑재 및 PC 관제 시스템 이더넷 전환 완료
    - [Firmware] W5500 SPI2 고속 2.0MHz 통신 및 Socket 0 Modbus TCP (Port 502, IP 192.168.0.100) FSM 구현
    - [Firmware] Modbus TCP MBAP 7바이트 헤더 파싱 및 0x01/0x03/0x04/0x05/0x06/0x10 PDU 응답 처리기 탑재
    - [Firmware] main.c 메인 루프에 ETH_ModbusTCP_Task() 등록하여 RS-422 Modbus RTU와 하이브리드 병렬 서빙
    - [Firmware] XC16 v2.10 클린 빌드 완료 및 최신 H2_Control_Board.hex 생성
    - [UI] serial_bridge.py W5500 TCP 소켓 클라이언트 모드 탑재 및 실시간 프레임 투명 중계
    - [UI] index.html 상단 통신 상태바에 '이더넷(TC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
2026-09-21 fix(bridge): UI OPEN_TCP 요청 핸들러 및 Modbus TCP 연결/해제 루틴 추가
    [serial_bridge.py]
